jbanks2/rvi_v2x_board/Hardware/Make Files/V1.2 Ordered/Build Learnings.txt

f-4.7uf 25 are 2012 not 0805 as on board
f-PDI header is SMT not TH
f-USB/SER header is SMT not TH
f-25v 100uf in 12B filter is al elct not Tant as built
f-wrong led resistor values.
f-r65 replaced by diode-D4
f-R70, R73 replaced by 24k
f-R71 replaced by 10k
f-SW2 mouser part wrong
f-board to board connector needs updating, replace with FPC/FFC
f-NVM_RST needs a pullup res-R8
f-R37 in canbus power needs a smaller R value-circuit updated,r37 removed
f-ALL 2n7002 transistors are footprinted upsidedown
