jbanks2/rvi_v2x_board/Hardware/Research/XRP6124 Calculator.xlsx

xrp6124 Calculator
 | 5V nom |  | high |  | low
Vin | 12 | V | 14.5 | V | 9 | V
Vout | 5 | V | 5 | V | 5 | V
D | 0.4166666667 | % | 0.3448275862 | % | 0.5555555556 | %
Iout | 1.25 | A | 1.25 | A | 1.25 | A
ΔIL | 0.375 | A | 0.375 | A | 0.375 | A
Vfb | 0.8 | V | 0.8 | V | 0.8 | V
Ton | 5e-07 | S | 5e-07 | S | 5e-07 | S
fs | 833333.3333 | Hz | 689655.1724 | Hz | 1111111.111 | Hz
Vout Ripple | 0.00783 | V | 0.006971447368 | V | 0.010276875 | V
Icin | 0.6162583107 | A | 0.5941400324 | A | 0.6211299937 | A
Cin | 3.038194444e-06 | F | 2.824019025e-06 | F | 3.086419753e-06 | F | 3.086419753e-06 | F | 3.3uF
R2 | 2000 | Ω | 2000 | Ω | 2000 | Ω | 2000 | Ω | 2kΩ
R1 | 10500 | Ω | 10500 | Ω | 10500 | Ω | 10500 | Ω | 10.5kΩ
CFF | 1.818913635e-10 | F | 2.197853976e-10 | F | 1.364185227e-10 | F | 2.197853976e-10 | F | 220pf
L | 9.333333333e-06 | H | 1.266666667e-05 | H | 5.333333333e-06 | H | 5.333333333e-06 | H | 5.4uH
Cout | 7.183908046e-06 | F | 9.749589491e-06 | F | 4.105090312e-06 | F | 9.749589491e-06 | F | 10uF
 | 4.1V nom |  | high |  | low
Vin | 12 | V | 14.5 | V | 9 | V
Vout | 4.1 | V | 4.1 | V | 4.1 | V
D | 0.3416666667 | % | 0.3416666667 | % | 0.3416666667 | %
Iout | 1.5 | A | 1.5 | A | 1.5 | A
ΔIL | 0.45 | A | 0.45 | A | 0.45 | A
Vfb | 0.8 | V | 0.8 | V | 0.8 | V
Ton | 5e-07 | S | 5e-07 | S | 5e-07 | S
fs | 683333.3333 | Hz | 565517.2414 | Hz | 911111.1111 | Hz
Vout Ripple | 0.005689139241 | V | 0.005221882212 | V | 0.006879214286 | V
Icin | 0.7114026638 | A | 0.7114026638 | A | 0.7114026638 | A
Cin | 4.114583333e-06 | F | 3.709869203e-06 | F | 4.537037037e-06 | F | 4.537037037e-06 | F | 4.7uF
R2 | 2000 | Ω | 2000 | Ω | 2000 | Ω | 2000 | Ω | 2kΩ
R1 | 8250 | Ω | 8250 | Ω | 8250 | Ω | 8250 | Ω | 8.25kΩ
CFF | 2.823147549e-10 | F | 3.411303289e-10 | F | 2.117360662e-10 | F | 3.411303289e-10 | F | 330pF
L | 8.777777778e-06 | H | 1.155555556e-05 | H | 5.444444444e-06 | H | 5.444444444e-06 | H | 5.4uH
Cout | 1.446916127e-05 | F | 1.904800978e-05 | F | 8.974543068e-06 | F | 1.904800978e-05 | F | 2x10uF
 | 3.3V nom |  | high |  | low
Vin | 12 | V | 14.5 | V | 9 | V
Vout | 3.3 | V | 3.3 | V | 3.3 | V
D | 0.275 | % | 0.275 | % | 0.275 | %
Iout | 1 | A | 1 | A | 1 | A
ΔIL | 0.3 | A | 0.3 | A | 0.3 | A
Vfb | 0.8 | V | 0.8 | V | 0.8 | V
Ton | 5e-07 | S | 5e-07 | S | 5e-07 | S
fs | 550000 | Hz | 455172.4138 | Hz | 733333.3333 | Hz
Vout Ripple | 0.004158 | V | 0.003902765625 | V | 0.004759815789 | V
Icin | 0.4465142775 | A | 0.4465142775 | A | 0.4465142775 | A
Cin | 3.020833333e-06 | F | 2.663495838e-06 | F | 3.518518519e-06 | F | 3.518518519e-06 | F | 2uF
R2 | 2000 | Ω | 2000 | Ω | 2000 | Ω | 2000 | Ω | 2kΩ
R1 | 6250 | Ω | 6250 | Ω | 6250 | Ω | 6250 | Ω | 6.25kΩ
CFF | 4.629961981e-10 | F | 5.594537394e-10 | F | 3.472471486e-10 | F | 5.594537394e-10 | F | 560pf
L | 1.45e-05 | H | 1.866666667e-05 | H | 9.5e-06 | H | 9.5e-06 | H | 19uH
Cout | 1.639774367e-05 | F | 2.110973898e-05 | F | 1.07433493e-05 | F | 2.110973898e-05 | F | 10uF
