jbanks2/rvi_v2x_board/Hardware/Research/Cable, J1962M to DB9F, Type D, 6ft - J1962M to ... - Cables - OBD2Cables.com_files/143301_pinout.gif

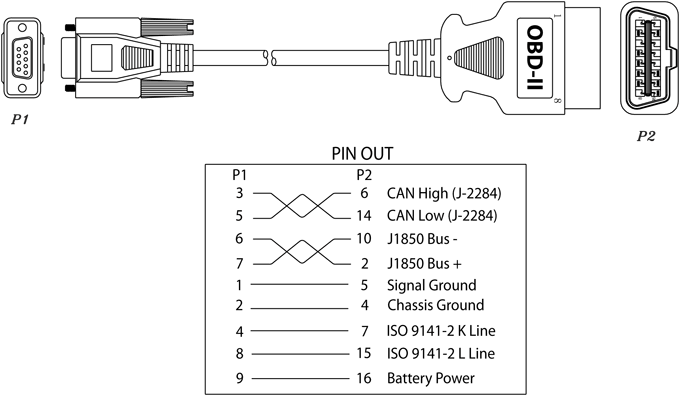
Hardware/Research/Cable, J1962M to DB9F, Type D, 6ft - J1962M to ... - Cables - OBD2Cables.com_files/143301_pinout.gif
