jbanks2/rvi_v2x_board/Hardware/Research/ModemCrossdb9.gif

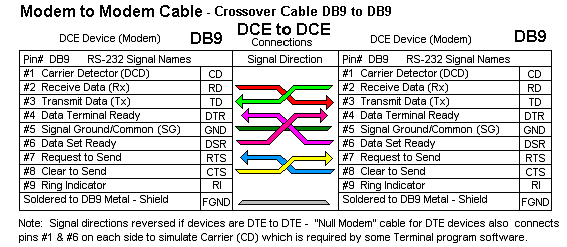
Hardware/Research/ModemCrossdb9.gif
