jbanks2/rvi_v2x_board/Hardware/Project Shares/V1/V1 BOM.xlsx

Name | Value | Description | Mouser PN | Alt PN | Source | C48 | 0
R1 | 0 | 0 ohm resistor | CRCW06030000Z0EA |  | CRCW06030000Z0EA (https://www2.mouser.com/Search/ProductDetail.aspx) | C50 | 0
C48 | 0 | 0 ohm resistor | CRCW06030000Z0EA |  | CRCW06030000Z0EA (https://www2.mouser.com/Search/ProductDetail.aspx) | R1 | 0
C50 | 0 | 0 ohm resistor | CRCW06030000Z0EA |  | CRCW06030000Z0EA (https://www2.mouser.com/Search/ProductDetail.aspx) | C42 | 0.1F
C42 | 0.1F | 0.1F Supercap | FG0H104ZF |  | FG0H104ZF (https://www2.mouser.com/Search/ProductDetail.aspx) | R45 | 100
R45 | 100 | 100 ohm | CRCW0603100RFKEA |  | CRCW0603100RFKEA (https://www2.mouser.com/Search/ProductDetail.aspx) | R46 | 100
R46 | 100 | 100 ohm | CRCW0603100RFKEA |  | CRCW0603100RFKEA (https://www2.mouser.com/Search/ProductDetail.aspx) | R29 | 100K
R29 | 100K | 100k 0603 | 667-ERJ-3EKF1003V |  | ERJ-3EKF1003V (https://www2.mouser.com/Search/ProductDetail.aspx) | C28 | 100N
C1 | 100n | 100N x7r 0603 | VJ0603Y104KXXCW1BC | 1 | VJ0603Y104KXXCW1BC (http://www2.mouser.com/ProductDetail/Vishay-Vitramon/VJ0603Y104KXXCW1BC/) | C32 | 100N
C17 | 100N | 100N x7r 0603 | VJ0603Y104KXXCW1BC | 2 | VJ0603Y104KXXCW1BC (http://www2.mouser.com/ProductDetail/Vishay-Vitramon/VJ0603Y104KXXCW1BC/) | C30 | 100N
C19 | 100N | 100N x7r 0603 | VJ0603Y104KXXCW1BC | 3 | VJ0603Y104KXXCW1BC | C36 | 100N
C20 | 100N | 100N x7r 0603 | VJ0603Y104KXXCW1BC | 4 | VJ0603Y104KXXCW1BC | C33 | 100N
C21 | 100N | 100N x7r 0603 | VJ0603Y104KXXCW1BC | 5 | VJ0603Y104KXXCW1BC | C37 | 100N
C24 | 100N | 100N x7r 0603 | VJ0603Y104KXXCW1BC | 6 | VJ0603Y104KXXCW1BC | C34 | 100N
C28 | 100n | 100N x7r 0603 | VJ0603Y104KXXCW1BC | 7 | VJ0603Y104KXXCW1BC | C38 | 100N
C30 | 100n | 100N x7r 0603 | VJ0603Y104KXXCW1BC | 8 | VJ0603Y104KXXCW1BC | C39 | 100N
C32 | 100n | 100N x7r 0603 | VJ0603Y104KXXCW1BC | 9 | VJ0603Y104KXXCW1BC | C35 | 100N
C33 | 100n | 100N x7r 0603 | VJ0603Y104KXXCW1BC | 10 | VJ0603Y104KXXCW1BC | C40 | 100N
C34 | 100n | 100N x7r 0603 | VJ0603Y104KXXCW1BC | 11 | VJ0603Y104KXXCW1BC | C51 | 100N
C35 | 100n | 100N x7r 0603 | VJ0603Y104KXXCW1BC | 12 | VJ0603Y104KXXCW1BC | C19 | 100N
C36 | 100n | 100N x7r 0603 | VJ0603Y104KXXCW1BC | 13 | VJ0603Y104KXXCW1BC | C21 | 100N
C37 | 100n | 100N x7r 0603 | VJ0603Y104KXXCW1BC | 14 | VJ0603Y104KXXCW1BC | C24 | 100N
C38 | 100n | 100N x7r 0603 | VJ0603Y104KXXCW1BC | 15 | VJ0603Y104KXXCW1BC | C20 | 100N
C39 | 100n | 100N x7r 0603 | VJ0603Y104KXXCW1BC | 16 | VJ0603Y104KXXCW1BC | C17 | 100N
C40 | 100n | 100N x7r 0603 | VJ0603Y104KXXCW1BC | 17 | VJ0603Y104KXXCW1BC | C1 | 100N
C51 | 100N | 100N x7r 0603 | VJ0603Y104KXXCW1BC | 18 | VJ0603Y104KXXCW1BC | C4 | 100U
C4 | 100U | 25V tantilum | 80-T491X107K025AT |  | 80-T491X107K025AT (https://www2.mouser.com/Search/ProductDetail.aspx) | R60 | 10K
R12 | 10k | 10k 0603 | CRCW060310K0FKEA | 1 | CRCW060310K0FKEA (https://www2.mouser.com/Search/ProductDetail.aspx) | R61 | 10K
R13 | 10K | 10k 0603 | CRCW060310K0FKEA | 2 | CRCW060310K0FKEA (https://www2.mouser.com/Search/ProductDetail.aspx) | R59 | 10K
R14 | 10K | 10k 0603 | CRCW060310K0FKEA | 3 | CRCW060310K0FKEA (https://www2.mouser.com/Search/ProductDetail.aspx) | R57 | 10K
R15 | 10K | 10k 0603 | CRCW060310K0FKEA | 4 | CRCW060310K0FKEA (https://www2.mouser.com/Search/ProductDetail.aspx) | R70 | 10K
R16 | 10K | 10k 0603 | CRCW060310K0FKEA | 5 | CRCW060310K0FKEA (https://www2.mouser.com/Search/ProductDetail.aspx) | R71 | 10K
R19 | 10K | 10k 0603 | CRCW060310K0FKEA | 6 | CRCW060310K0FKEA (https://www2.mouser.com/Search/ProductDetail.aspx) | R16 | 10K
R21 | 10K | 10k 0603 | CRCW060310K0FKEA | 7 | CRCW060310K0FKEA (https://www2.mouser.com/Search/ProductDetail.aspx) | R43 | 10K
R23 | 10K | 10k 0603 | CRCW060310K0FKEA | 8 | CRCW060310K0FKEA (https://www2.mouser.com/Search/ProductDetail.aspx) | R49 | 10K
R25 | 10K | 10k 0603 | CRCW060310K0FKEA | 9 | CRCW060310K0FKEA (https://www2.mouser.com/Search/ProductDetail.aspx) | R50 | 10K
R27 | 10K | 10k 0603 | CRCW060310K0FKEA | 10 | CRCW060310K0FKEA (https://www2.mouser.com/Search/ProductDetail.aspx) | R44 | 10K
R30 | 10K | 10k 0603 | CRCW060310K0FKEA | 11 | CRCW060310K0FKEA (https://www2.mouser.com/Search/ProductDetail.aspx) | R14 | 10K
R31 | 10K | 10k 0603 | CRCW060310K0FKEA | 12 | CRCW060310K0FKEA (https://www2.mouser.com/Search/ProductDetail.aspx) | R15 | 10K
R32 | 10K | 10k 0603 | CRCW060310K0FKEA | 13 | CRCW060310K0FKEA (https://www2.mouser.com/Search/ProductDetail.aspx) | R13 | 10K
R33 | 10K | 10k 0603 | CRCW060310K0FKEA | 14 | CRCW060310K0FKEA (https://www2.mouser.com/Search/ProductDetail.aspx) | R25 | 10K
R34 | 10K | 10k 0603 | CRCW060310K0FKEA | 15 | CRCW060310K0FKEA (https://www2.mouser.com/Search/ProductDetail.aspx) | R21 | 10K
R40 | 10K | 10k 0603 | CRCW060310K0FKEA | 16 | CRCW060310K0FKEA (https://www2.mouser.com/Search/ProductDetail.aspx) | R34 | 10K
R43 | 10K | 10k 0603 | CRCW060310K0FKEA | 17 | CRCW060310K0FKEA (https://www2.mouser.com/Search/ProductDetail.aspx) | R23 | 10K
R44 | 10k | 10k 0603 | CRCW060310K0FKEA | 18 | CRCW060310K0FKEA (https://www2.mouser.com/Search/ProductDetail.aspx) | R27 | 10K
R49 | 10K | 10k 0603 | CRCW060310K0FKEA | 19 | CRCW060310K0FKEA (https://www2.mouser.com/Search/ProductDetail.aspx) | R33 | 10K
R50 | 10K | 10k 0603 | CRCW060310K0FKEA | 20 | CRCW060310K0FKEA (https://www2.mouser.com/Search/ProductDetail.aspx) | R32 | 10K
R57 | 10K | 10k 0603 | CRCW060310K0FKEA | 21 | CRCW060310K0FKEA (https://www2.mouser.com/Search/ProductDetail.aspx) | R31 | 10K
R59 | 10k | 10k 0603 | CRCW060310K0FKEA | 22 | CRCW060310K0FKEA (https://www2.mouser.com/Search/ProductDetail.aspx) | R40 | 10K
R60 | 10K | 10k 0603 | CRCW060310K0FKEA | 23 | CRCW060310K0FKEA (https://www2.mouser.com/Search/ProductDetail.aspx) | R30 | 10K
R61 | 10K | 10k 0603 | CRCW060310K0FKEA | 24 | CRCW060310K0FKEA (https://www2.mouser.com/Search/ProductDetail.aspx) | R12 | 10K
R70 | 10K | 10k 0603 | CRCW060310K0FKEA | 25 | CRCW060310K0FKEA (https://www2.mouser.com/Search/ProductDetail.aspx) | R19 | 10K
R71 | 10K | 10k 0603 | CRCW060310K0FKEA | 26 | CRCW060310K0FKEA (https://www2.mouser.com/Search/ProductDetail.aspx) | C44 | 10N
C3 | 10N | 10n 0603 | VJ0603Y103KXACW1BC |  | VJ0603Y103KXACW1BC (https://www2.mouser.com/Search/ProductDetail.aspx) | C12 | 10N
C44 | 10n | 10n 0603 | VJ0603Y103KXACW1BC |  | VJ0603Y103KXACW1BC (https://www2.mouser.com/Search/ProductDetail.aspx) | C3 | 10N
C12 | 10n | 10n 0603 | VJ0603Y103KXACW1BC |  | VJ0603Y103KXACW1BC (https://www2.mouser.com/Search/ProductDetail.aspx)
R54 | 12K | 12k 0603 | CRCW060312K0FKEA |  | CRCW060312K0FKEA (https://www2.mouser.com/Search/ProductDetail.aspx) | R54 | 12K
X1 | 12M | 12MHz Xtal | ABLS7M2-12.000MHZ-D-2Y-T |  | ABLS7M2-12.000MHZ-D-2Y-T (https://www2.mouser.com/Search/ProductDetail.aspx) | X1 | 12M
X2 | 12M | 12MHz Xtal | ABLS7M2-12.000MHZ-D-2Y-T |  | ABLS7M2-12.000MHZ-D-2Y-T (https://www2.mouser.com/Search/ProductDetail.aspx) | X2 | 12M
C41 | 18p | 18pF 0603 | VJ0603A180JXACW1BC |  | VJ0603A180JXACW1BC (https://www2.mouser.com/Search/ProductDetail.aspx) | C54 | 18P
C53 | 18p | 18pF 0603 | VJ0603A180JXACW1BC |  | VJ0603A180JXACW1BC (https://www2.mouser.com/Search/ProductDetail.aspx) | C55 | 18P
C54 | 18p | 18pF 0603 | VJ0603A180JXACW1BC |  | VJ0603A180JXACW1BC | C41 | 18P
C55 | 18p | 18pF 0603 | VJ0603A180JXACW1BC |  | VJ0603A180JXACW1BC | C53 | 18P
F2 | 1A | 750mA Poly Fuse | 0ZCH0075FF2G |  | 0ZCH0075FF2G (https://www2.mouser.com/Search/ProductDetail.aspx) | F2 | 1A
R28 | 1K | 1K 0603 | CRCW06031K00FKEA | 1 | CRCW06031K00FKEA (https://www2.mouser.com/Search/ProductDetail.aspx) | R56 | 1K
R39 | 1k | 1K 0603 | CRCW06031K00FKEA | 2 | CRCW06031K00FKEA (https://www2.mouser.com/Search/ProductDetail.aspx) | R28 | 1K
R41 | 1k | 1K 0603 | CRCW06031K00FKEA | 3 | CRCW06031K00FKEA (https://www2.mouser.com/Search/ProductDetail.aspx) | R41 | 1K
R51 | 1K | 1K 0603 | CRCW06031K00FKEA | 4 | CRCW06031K00FKEA (https://www2.mouser.com/Search/ProductDetail.aspx) | R51 | 1K
R56 | 1K | 1K 0603 | CRCW06031K00FKEA | 5 | CRCW06031K00FKEA (https://www2.mouser.com/Search/ProductDetail.aspx) | R39 | 1K
R6 | 1K | 1K 0603 | CRCW06031K00FKEA | 6 | CRCW06031K00FKEA (https://www2.mouser.com/Search/ProductDetail.aspx) | R6 | 1K
R5 | 1k7 | 1.69K 0603 | CRCW06031K69FKEA |  | CRCW06031K69FKEA (https://www2.mouser.com/Search/ProductDetail.aspx) | R5 | 1K7
C15 | 1u | 1uf 0603 x5r | GRM188R61E105KA12D | 1 | GRM188R61E105KA12D (https://www2.mouser.com/Search/ProductDetail.aspx) | C23 | 1U
C16 | 1u | 1uf 0603 x5r | GRM188R61E105KA12D | 2 | GRM188R61E105KA12D (https://www2.mouser.com/Search/ProductDetail.aspx) | C22 | 1U
C22 | 1u | 1uf 0603 x5r | GRM188R61E105KA12D | 3 | GRM188R61E105KA12D (https://www2.mouser.com/Search/ProductDetail.aspx) | C25 | 1U
C23 | 1u | 1uf 0603 x5r | GRM188R61E105KA12D | 4 | GRM188R61E105KA12D (https://www2.mouser.com/Search/ProductDetail.aspx) | C9 | 1U
C25 | 1U | 1uf 0603 x5r | GRM188R61E105KA12D | 5 | GRM188R61E105KA12D (https://www2.mouser.com/Search/ProductDetail.aspx) | C15 | 1U
C6 | 1U | 1uf 0603 x5r | GRM188R61E105KA12D | 6 | GRM188R61E105KA12D (https://www2.mouser.com/Search/ProductDetail.aspx) | C6 | 1U
C8 | 1U | 1uf 0603 x5r | GRM188R61E105KA12D | 7 | GRM188R61E105KA12D (https://www2.mouser.com/Search/ProductDetail.aspx) | C8 | 1U
C9 | 1U | 1uf 0603 x5r | GRM188R61E105KA12D | 8 | GRM188R61E105KA12D (https://www2.mouser.com/Search/ProductDetail.aspx) | R69 | 2.2K
R63 | 22 | 22.1 ohm, 0603 | 71-CRCW0603-22.1-E3 |  | 71-CRCW0603-22.1-E3 (http://www2.mouser.com/ProductDetail/Vishay-Dale/CRCW060322R1FKEA/) | R64 | 22
R64 | 22 | 22.1 ohm, 0603 | 71-CRCW0603-22.1-E3 |  | 71-CRCW0603-22.1-E3 (http://www2.mouser.com/ProductDetail/Vishay-Dale/CRCW060322R1FKEA/) | R65 | 22
R65 | 22 | 22.1 ohm, 0603 | 71-CRCW0603-22.1-E3 |  | 71-CRCW0603-22.1-E3 (http://www2.mouser.com/ProductDetail/Vishay-Dale/CRCW060322R1FKEA/) | FB5 | 220
FB1 | 220 | FB 220 ohm, 0805 | 81-BLM21P221SG | 1 | 81-BLM21P221SG (https://www2.mouser.com/Search/ProductDetail.aspx) | FB6 | 220
FB2 | 220 | FB 220 ohm, 0805 | 81-BLM21P221SG | 2 | 81-BLM21P221SG (https://www2.mouser.com/Search/ProductDetail.aspx) | FB4 | 220
FB3 | 220 | FB 220 ohm, 0805 | 81-BLM21P221SG | 3 | 81-BLM21P221SG (https://www2.mouser.com/Search/ProductDetail.aspx) | FB2 | 220
FB4 | 220 | FB 220 ohm, 0804 | 81-BLM21P221SG | 4 | 81-BLM21P221SG (https://www2.mouser.com/Search/ProductDetail.aspx) | FB3 | 220
FB5 | 220 | FB 220 ohm, 0805 | 81-BLM21P221SG | 5 | 81-BLM21P221SG (https://www2.mouser.com/Search/ProductDetail.aspx) | R4 | 220
FB6 | 220 | FB 220 ohm, 0805 | 81-BLM21P221SG | 6 | 81-BLM21P221SG (https://www2.mouser.com/Search/ProductDetail.aspx) | FB1 | 220
R4 | 220 | 220 0603 | CRCW0603220RFKEA |  | CRCW0603220RFKEA (https://www2.mouser.com/Search/ProductDetail.aspx) | C5 | 220U
C5 | 220u | 16V SMT Elect | 647-UCD1C221MCL1GS |  | 647-UCD1C221MCL1GS (https://www2.mouser.com/Search/ProductDetail.aspx) | C11 | 220U
C11 | 220u | 16V SMT Elect | 647-UCD1C221MCL1GS |  | 647-UCD1C221MCL1GS (https://www2.mouser.com/Search/ProductDetail.aspx) | C10 | 220U
C10 | 220u | 16V SMT Elect | 647-UCD1C221MCL1GS |  | 647-UCD1C221MCL1GS (https://www2.mouser.com/Search/ProductDetail.aspx) | C14 | 220U
C14 | 220u | 16V SMT Elect | 647-UCD1C221MCL1GS |  | 647-UCD1C221MCL1GS (https://www2.mouser.com/Search/ProductDetail.aspx) | R62 | 22K
R62 | 22K | 22k 0603 | CRCW060322K0FKEA |  | CRCW060322K0FKEA (https://www2.mouser.com/Search/ProductDetail.aspx) | R18 | 240
R18 | 240 | 240 0603 | CRCW0603240RFKEB |  | CRCW0603240RFKEB (https://www2.mouser.com/Search/ProductDetail.aspx) | F1 | 2A
F1 | 2A | 2A poly fuse | 0ZCG0260FF2C |  | 0ZCG0260FF2C (https://www2.mouser.com/Search/ProductDetail.aspx) | R20 | 2K
R20 | 2K | 2k 0603 | CRCW06032K00FKEA |  | CRCW06032K00FKEA (https://www2.mouser.com/Search/ProductDetail.aspx) | R68 | 2K2
R69 | 2K2 | 2.2k 0603 | CRCW06032K20FKEA | 1 | CRCW06032K20FKEA (https://www2.mouser.com/Search/ProductDetail.aspx)
R26 | 2K2 | 2.2k 0603 | CRCW06032K20FKEA | 2 | CRCW06032K20FKEA (https://www2.mouser.com/Search/ProductDetail.aspx) | R26 | 2K2
R35 | 2K2 | 2.2k 0603 | CRCW06032K20FKEA | 3 | CRCW06032K20FKEA (https://www2.mouser.com/Search/ProductDetail.aspx) | R37 | 2K2
R36 | 2K2 | 2.2k 0603 | CRCW06032K20FKEA | 4 | CRCW06032K20FKEA (https://www2.mouser.com/Search/ProductDetail.aspx) | R36 | 2K2
R37 | 2K2 | 2.2k 0603 | CRCW06032K20FKEA | 5 | CRCW06032K20FKEA (https://www2.mouser.com/Search/ProductDetail.aspx) | R35 | 2K2
R68 | 2K2 | 2.2k 0603 | CRCW06032K20FKEA | 6 | CRCW06032K20FKEA (https://www2.mouser.com/Search/ProductDetail.aspx) | Q12 | 2N3904
Q10 | 2N3904 | NPN | MMBT3904 | 1 | 512-MMBT3904 (https://www2.mouser.com/Search/ProductDetail.aspx?R=MMBT3904virtualkey51210000virtualkey512-MMBT3904) | Q13 | 2N3904
Q11 | 2N3904 | NPN | MMBT3904 | 2 | 512-MMBT3904 (https://www2.mouser.com/Search/ProductDetail.aspx?R=MMBT3904virtualkey51210000virtualkey512-MMBT3904) | Q10 | 2N3904
Q12 | 2N3904 | NPN | MMBT3904 | 3 | 512-MMBT3904 | Q11 | 2N3904
Q13 | 2N3904 | NPN | MMBT3904 | 4 | 512-MMBT3904 | Q8 | 2N3904
Q4 | 2N3904 | NPN | MMBT3904 | 5 | 512-MMBT3904 | Q4 | 2N3904
Q8 | 2N3904 | NPN | MMBT3904 | 6 | 512-MMBT3904 | C13 | 2N7
C13 | 2n7 | 2.7N 0603 | 06033C272JAT2A |  | 06033C272JAT2A (https://www2.mouser.com/Search/ProductDetail.aspx) | Q2 | 2N7002
Q2 | 2N7002 | N-MOS | 2N7002 |  | 2N7002ET1G (https://www2.mouser.com/Search/ProductDetail.aspx) | Q9 | 2N7002
Q9 | 2N7002 | N-MOS | 2N7002 |  | 2N7002ET1G (https://www2.mouser.com/Search/ProductDetail.aspx) | R66 | 330
C49 | 47p | 47p 0603 | VJ0603A470JXXPW1BC |  | VJ0603A470JXXPW1BC (https://www2.mouser.com/Search/ProductDetail.aspx) | R67 | 330
C47 | 47P | 47p 0603 | VJ0603A470JXXPW1BC |  | VJ0603A470JXXPW1BC (https://www2.mouser.com/Search/ProductDetail.aspx)
R10 | 330 | 330 0603 | CRCW0603330RFKEA | 1 | CRCW0603330RFKEA (https://www2.mouser.com/Search/ProductDetail.aspx) | R10 | 330
R11 | 330 | 330 0603 | CRCW0603330RFKEA | 2 | CRCW0603330RFKEA (https://www2.mouser.com/Search/ProductDetail.aspx) | R8 | 330
R66 | 330 | 330 0603 | CRCW0603330RFKEA | 3 | CRCW0603330RFKEA (https://www2.mouser.com/Search/ProductDetail.aspx) | R11 | 330
R67 | 330 | 330 0603 | CRCW0603330RFKEA | 4 | CRCW0603330RFKEA (https://www2.mouser.com/Search/ProductDetail.aspx) | R9 | 330
R8 | 330 | 330 0603 | CRCW0603330RFKEA | 5 | CRCW0603330RFKEA (https://www2.mouser.com/Search/ProductDetail.aspx) | C52 | 330P
R9 | 330 | 330 0603 | CRCW0603330RFKEA | 6 | CRCW0603330RFKEA (https://www2.mouser.com/Search/ProductDetail.aspx) | C43 | 330P
C52 | 330P | 330p 0603 | VJ0603A331FXXCW1BC |  | VJ0603A331FXXCW1BC (https://www2.mouser.com/Search/ProductDetail.aspx) | C7 | 33U
C43 | 330P | 330p 0603 | VJ0603A331FXXCW1BC |  | VJ0603A331FXXCW1BC (https://www2.mouser.com/Search/ProductDetail.aspx) | R22 | 374
C7 | 33u | 33uF MLCC 6.3v | 810-C3225X5R0J336M11 |  | 810-C3225X5R0J336M11 (https://www2.mouser.com/Search/ProductDetail.aspx) | Q3 | 3906
R22 | 374 | 374 0603 | CRCW0603374RFKEA |  | CRCW0603374RFKEA (https://www2.mouser.com/Search/ProductDetail.aspx) | D8 | 4148
D8 | 4148 | 2N4148 | TS4148RY | 1 | TS4148RY (https://www2.mouser.com/Search/ProductDetail.aspx) | D9 | 4148
D7 | 4148 | 2N4148 | TS4148RY | 2 | TS4148RY (https://www2.mouser.com/Search/ProductDetail.aspx) | D13 | 4148
D9 | 4148 | 2N4148 | TS4148RY | 3 | TS4148RY (https://www2.mouser.com/Search/ProductDetail.aspx) | D12 | 4148
D13 | 4148 | 2N4148 | TS4148RY | 4 | TS4148RY (https://www2.mouser.com/Search/ProductDetail.aspx) | P8 | 47553-1001
D12 | 4148 | 2N4148 | TS4148RY | 5 | TS4148RY (https://www2.mouser.com/Search/ProductDetail.aspx) | L3 | 47N
L3 | 47N | 47n 0603 | VJ0603Y473JXXCW1BC |  | VJ0603Y473JXXCW1BC (https://www2.mouser.com/Search/ProductDetail.aspx) | R55 | 4K7
L1 | 47N | 47n 0603 | VJ0603Y473JXXCW1BC |  | VJ0603Y473JXXCW1BC (https://www2.mouser.com/Search/ProductDetail.aspx) | R72 | 4K7
R47 | 4K7 | 4.7k 0603 | CRCW06034K70FKEA | 1 | CRCW06034K70FKEA (https://www2.mouser.com/Search/ProductDetail.aspx) | R47 | 4K7
R55 | 4K7 | 4.7k 0604 | CRCW06034K70FKEA | 2 | CRCW06034K70FKEA (https://www2.mouser.com/Search/ProductDetail.aspx) | C29 | 4U7
R72 | 4K7 | 4.7k 0605 | CRCW06034K70FKEA | 3 | CRCW06034K70FKEA (https://www2.mouser.com/Search/ProductDetail.aspx) | C31 | 4U7
C2 | 4U7 | 4.7uf 0805 | 08053D475KAT2A | 1 | 08053D475KAT2A (http://www2.mouser.com/ProductDetail/AVX/08053D475KAT2A/?qs=sGAEpiMZZMs0AnBnWHyRQPVeiAejnQnjfhIZ0wFCHlY%3d) | C18 | 4U7
C18 | 4U7 | 4.7uf 0805 | 08053D475KAT2A | 2 | 08053D475KAT2A (http://www2.mouser.com/ProductDetail/AVX/08053D475KAT2A/?qs=sGAEpiMZZMs0AnBnWHyRQPVeiAejnQnjfhIZ0wFCHlY%3d) | C56 | 4U7
C29 | 4u7 | 4.7uf 0805 | 08053D475KAT2A | 3 | 08053D475KAT2A (http://www2.mouser.com/ProductDetail/AVX/08053D475KAT2A/?qs=sGAEpiMZZMs0AnBnWHyRQPVeiAejnQnjfhIZ0wFCHlY%3d) | C2 | 4U7
C31 | 4u7 | 4.7uf 0805 | 08053D475KAT2A | 4 | 08053D475KAT2A (http://www2.mouser.com/ProductDetail/AVX/08053D475KAT2A/?qs=sGAEpiMZZMs0AnBnWHyRQPVeiAejnQnjfhIZ0wFCHlY%3d) | C47 | 50P
 |  |  |  |  |  | C49 | 50P
R42 | 510 | 510ohm 1210 | 603-RC1210FR-07510RL |  | 603-RC1210FR-07510RL (https://www2.mouser.com/Search/ProductDetail.aspx) | R48 | 510
R48 | 510 | 510ohm 1210 | 603-RC1210FR-07510RL |  | 603-RC1210FR-07510RL (https://www2.mouser.com/Search/ProductDetail.aspx) | C26 | 560P
C26 | 560P | 560p 0603 | VJ0603Y561KXACW1BC |  | VJ0603Y561KXACW1BC (https://www2.mouser.com/Search/ProductDetail.aspx) | C27 | 560P
C27 | 560P | 560p 0603 | VJ0603Y561KXACW1BC |  | VJ0603Y561KXACW1BC (https://www2.mouser.com/Search/ProductDetail.aspx) | R7 | 62K
R7 | 62k | 62k 0603 | CRCW060362K0FKEA |  | CRCW060362K0FKEA (https://www2.mouser.com/Search/ProductDetail.aspx) | R17 | 866
R17 | 866 | 866 0603 | ERJ-3EKF8660V |  | ERJ-3EKF8660V (https://www2.mouser.com/Search/ProductDetail.aspx) | R24 | 8K
R24 | 8K | 8.06k 06036 | ERJ-3EKF8061V |  | ERJ-3EKF8061V (https://www2.mouser.com/Search/ProductDetail.aspx) | U14 | 93C46
U14 | 93C46 | 64x16 EEPROM | 93C46BT |  | 93C46BT/SN (https://www2.mouser.com/Search/ProductDetail.aspx) | U1 | ADXL345
U1 | ADXL345 | 16g Accel | ADXL345BCCZ-RL7 |  | ADXL345BCCZ-RL7 (https://www2.mouser.com/Search/ProductDetail.aspx) | D10 | BLUE
D4 | BLUE | 0805 Bl LED | 150080BS75000 | 1 | 150080BS75000 (https://www2.mouser.com/Search/ProductDetail.aspx) | D4 | BLUE
D6 | BLUE | 0805 Bl LED | 150080BS75000 | 2 | 150080BS75000 (https://www2.mouser.com/Search/ProductDetail.aspx) | D6 | BLUE
D10 | BLUE | 0805 Bl LED | 150080BS75000 | 3 | 150080BS75000 (https://www2.mouser.com/Search/ProductDetail.aspx) | P9 | Board Mount 1
P9 | Board Mount 1 | --- |  |  |  | P11 | Board Mount 2
P11 | Board Mount 2 | --- |  |  |  | P13 | Board Mount 3
P13 | Board Mount 3 | --- |  |  |  | P15 | Board Mount 4
P15 | Board Mount 4 | --- |  |  |  | Q6 | BSS84
Q1 | BSS84 | P-MOS | BSS84 | 1 | BSS84,215 (https://www2.mouser.com/Search/ProductDetail.aspx) | Q1 | BSS84
Q5 | BSS84 | P-MOS | BSS85 | 2 | BSS84,216 (https://www2.mouser.com/Search/ProductDetail.aspx) | JP1 | CAN_EN_SRC
Q6 | BSS84 | P-MOS | BSS86 | 3 | BSS84,217 (https://www2.mouser.com/Search/ProductDetail.aspx) | D1 | DB2441700L
Q7 | BSS84 | P-MOS | BSS87 | 4 | BSS84,218 (https://www2.mouser.com/Search/ProductDetail.aspx) | J1 | DB9
JP1 | CAN_EN_SRC | 3-p jumper header | 778757 |  | 22-28-4032 (https://www2.mouser.com/Search/ProductDetail.aspx) | P20 | DB-9 to OBD2
J1 | DB9 | DB-9-M | D09P33E4GV00LF |  | D09P33E4GV00LF (https://www2.mouser.com/Search/ProductDetail.aspx) | R3 | DNS
R2 | DNS | --- |  |  |  | L5 | dns
R3 | DNS | --- |  |  |  | L6 | dns
R52 | DNS | --- |  |  |  | L7 | dns
R53 | DNS | --- |  |  |  | L8 | dns
L5 | dns | --- |  |  |  | L4 | dns
L6 | dns | --- |  |  |  | C45 | dns
L7 | dns | --- |  |  |  | L2 | dns
L8 | dns | --- |  |  |  | C46 | dns
L4 | dns | --- |  |  |  | R73 | dns
C45 | dns | --- |  |  |  | R2 | DNS
L2 | dns | --- |  |  |  | U5 | ESDAxxSC6
C46 | dns | --- |  |  |  | U6 | ESDAxxSC6
R73 | dns | --- |  |  |  | P12 | Ficudial1
U5 | ESDAxxSC6 | 4-ch ESD Array | 511-ESDA19SC6 |  | 511-ESDA19SC6 (https://www2.mouser.com/Search/ProductDetail.aspx) | P14 | Ficudial2
U6 | ESDAxxSC6 | 4-ch ESD Array | 511-ESDA19SC6 |  | 511-ESDA19SC6 (https://www2.mouser.com/Search/ProductDetail.aspx) | P16 | Ficudial3
P12 | Ficudial1 | PCB alignment Mark |  |  |  | P18 | Ficudial4
P14 | Ficudial2 | PCB alignment Mark |  |  |  | W1 | FME<->SMA
P16 | Ficudial3 | PCB alignment Mark |  |  |  | U12 | FT4232H
P18 | Ficudial4 | PCB alignment Mark |  |  |  | W2 | GPS+GSM Antenna
P8 | 47553-1001 | SIM Slot | 47553-1001 |  | 47553-1001 (https://www2.mouser.com/Search/ProductDetail.aspx) | U9 | LM317
U12 | FT4232H | USB Uart | FT4232HL-REEL |  | FT4232HL-REEL (https://www2.mouser.com/Search/ProductDetail.aspx) | U8 | LM339
U9 | LM317 | Linnear Reg Adj | LM317MSTT3G |  | LM317MSTT3G (https://www2.mouser.com/Search/ProductDetail.aspx) | P4 | NVM_RST
U8 | LM339 | OpenC Comparator | LM339DT |  | LM339DT (https://www2.mouser.com/Search/ProductDetail.aspx?R=LM339DTvirtualkey51120000virtualkey511-LM339DT) | U2 | OKI-78SR-5
U11 | MCP2551 | Canbus TCVR | 579-MCP2551-I/SN |  | 579-MCP2551-I/SN (https://www2.mouser.com/Search/ProductDetail.aspx) | P3 | Open Source
Q3 | 3906 | PNP | MMBT3906-7-F |  | MMBT3906-7-F (https://www2.mouser.com/Search/ProductDetail.aspx) | P2 | PG_TP
P4 | NVM_RST | 2-pin jumper | 22-28-5023 |  | 22-28-5023 (https://www2.mouser.com/Search/ProductDetail.aspx) | U3 | PNVX002
U2 | OKI-78SR-5 | 5V 1.5A | OKI-78SR-5/1.5-W36H-C |  | OKI-78SR-5/1.5-W36H-C (https://www2.mouser.com/Search/ProductDetail.aspx) | SW1 | PWR_SW
P3 | Open Source | --- |  |  |  | D11 | RED
P2 | PG_TP | --- |  |  |  | D3 | RED
U3 | PNVX002 | Adj V @ 2A | PNVX002A0X3-SRZ |  | PNVX002A0X3-SRZ (https://www2.mouser.com/Search/ProductDetail.aspx) | D5 | RED
SW1 | PWR_SW | 10A rocker SW | 1552.4606 |  | 1552.4606 (https://www2.mouser.com/Search/ProductDetail.aspx) | D2 | SD15C
D11 | RED | 0805 RED LED | LS R976-NR-1 |  | LS R976-NR-1 (https://www2.mouser.com/Search/ProductDetail.aspx) | U16 | SIM5320
D3 | RED | 0805 RED LED | LS R976-NR-1 |  | LS R976-NR-1 (https://www2.mouser.com/Search/ProductDetail.aspx) | P6 | SMA
D5 | RED | 0805 RED LED | LS R976-NR-1 |  | LS R976-NR-1 (https://www2.mouser.com/Search/ProductDetail.aspx) | P7 | SMA
D1 | DB2441700L | 40V 5A | DB2441700L |  | DB2441700L (https://www2.mouser.com/Search/ProductDetail.aspx) | U15 | SMF05
U16 | SIM5320 | GSM+GPS | SIM5230E | Not Mouser | Aliexpress (http://www.aliexpress.com/item/SIMCOM-SIM5320-SIM5320A-3G-GSM-HSDPA-WCDM-GSM-GPRS-EDGE-module/987537423.html) | U17 | SMF05
P6 | SMA | SMA-RA | 142-0701-801 |  | 142-0701-801 (https://www2.mouser.com/Search/ProductDetail.aspx) | U7 | STN1110
P7 | SMA | SMA-RA | 142-0701-801 |  | 142-0701-801 (https://www2.mouser.com/Search/ProductDetail.aspx) | SW2 | SW_PUSH_SMALL
U15 | SMF05 | 5ch TVS array | 863-SMF05CT1G |  | 863-SMF05CT1G (https://www2.mouser.com/Search/ProductDetail.aspx) | SW3 | SW_PUSH_SMALL
U17 | SMF05 | 5ch TVS array | 863-SMF05CT1G |  | 863-SMF05CT1G (https://www2.mouser.com/Search/ProductDetail.aspx) | SW4 | SW_PUSH_SMALL
D2 | SD15C | 15V TVS | SD15C-01FTG |  | SD15C-01FTG (https://www2.mouser.com/Search/ProductDetail.aspx) | SW5 | SW_PUSH_SMALL
U7 | STN1110 |  |  | Not Mouser | STN1110 Multiprotocol OBD II to UART Interpreter (https://www.scantool.net/stn1110.html) | U4 | TLV70033DDC
SW2 | SW_PUSH_SMALL | Tact SW Small | 506-FSMSM |  | 506-FSMSM (https://www2.mouser.com/Search/ProductDetail.aspx?R=FSMSMvirtualkey50660000virtualkey506-FSMSM) | P1 | USB_A
SW3 | SW_PUSH_SMALL | Tact SW Small | 506-FSMSM |  | 506-FSMSM (https://www2.mouser.com/Search/ProductDetail.aspx?R=FSMSMvirtualkey50660000virtualkey506-FSMSM) | P5 | USB_u
SW4 | SW_PUSH_SMALL | Tact SW Small | 506-FSMSM |  | 506-FSMSM (https://www2.mouser.com/Search/ProductDetail.aspx?R=FSMSMvirtualkey50660000virtualkey506-FSMSM)
SW5 | SW_PUSH_SMALL | Tact SW Small | 506-FSMSM |  | 506-FSMSM (https://www2.mouser.com/Search/ProductDetail.aspx?R=FSMSMvirtualkey50660000virtualkey506-FSMSM)
U4 | TLV70033DDC | 3.3V LDO | TLV73333PDBVT |  | TLV73333PDBVT (https://www2.mouser.com/Search/ProductDetail.aspx)
P1 | USB_A | USB-A | 6364372-2 |  | 6364372-2 (https://www2.mouser.com/Search/ProductDetail.aspx)
P5 | USB_u | USB-micro B | 649-10118193-0001LF |  | 649-10118193-0001LF (https://www2.mouser.com/Search/ProductDetail.aspx)
W1 | FME<->SMA | RF adapter | 523-192113 |  | 523-192113 (https://www2.mouser.com/Search/ProductDetail.aspx?R=192113virtualkey52310000virtualkey523-192113)
W2 | GSM+GPS | Antennas | APAMPS-105 |  | APAMPS-105 (https://www2.mouser.com/Search/ProductDetail.aspx)
P20 | DB9toOBD2 |  |  | Not Mouser | OBD2 16Pin to DB9 Serial Port Adapter Cable--Connecting Your Diagnostic Interface… (http://www.amazon.com/Adapter-Cable-Connecting-Diagnostic-Interface-Compliant/dp/B007UKTW8E)
