jbanks2/rvi_v2x_board/Hardware/Make Files/Active/Amazon Order.JPG

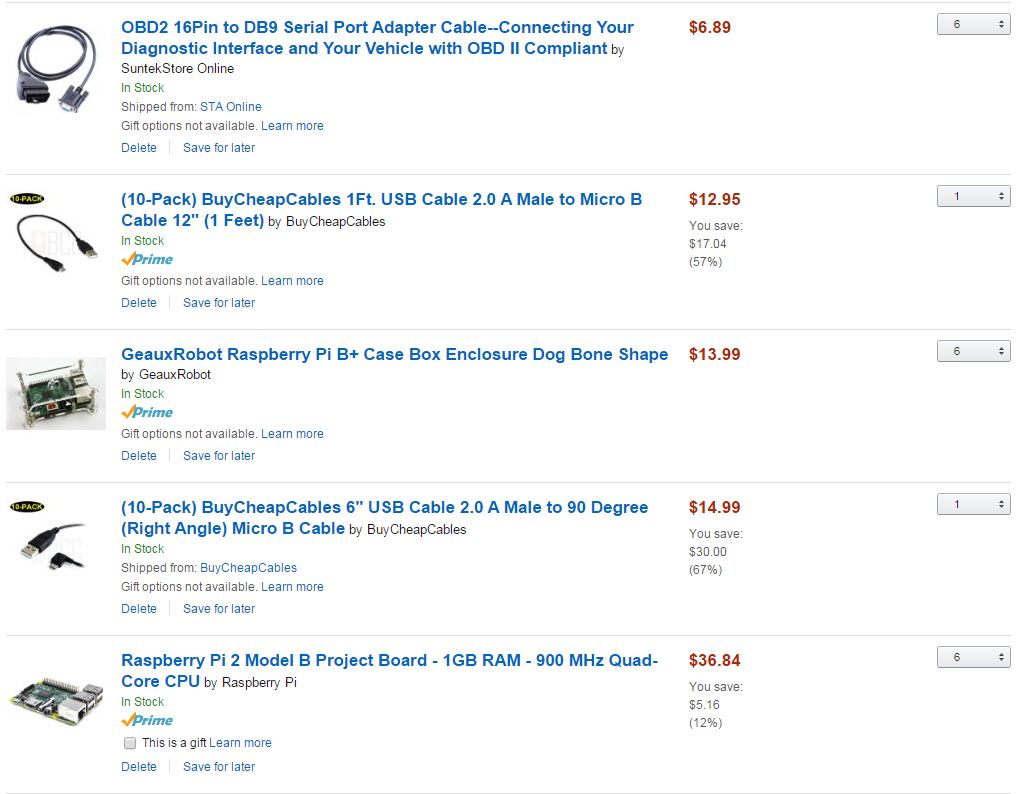
Hardware/Make Files/Active/Amazon Order.JPG
