jbanks2/rvi_v2x_board/Hardware/Make Files/Active/V2X_ISO1.jpg

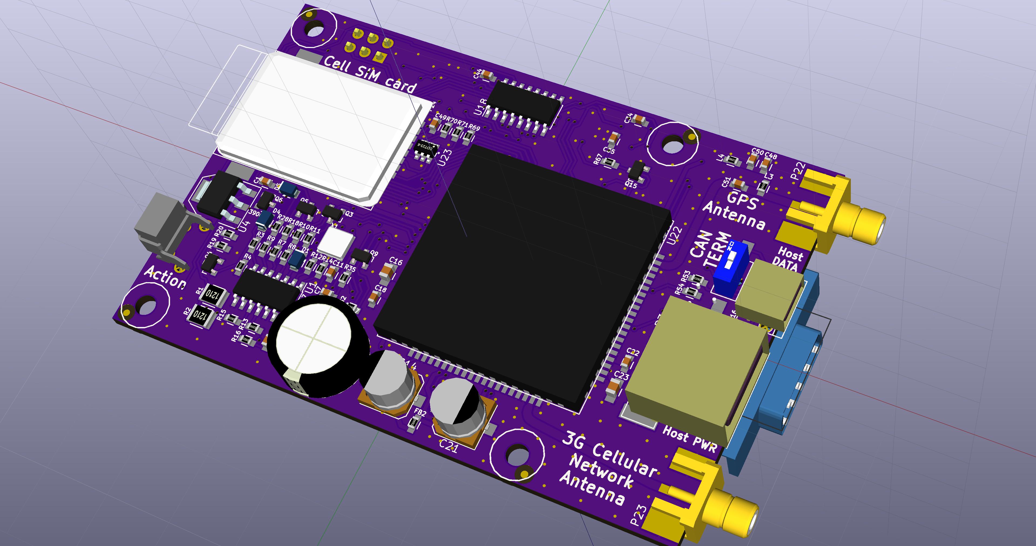
Hardware/Make Files/Active/V2X_ISO1.jpg
