jbanks2/rvi_v2x_board/Hardware/Project Shares/V1.2/V2X V1.2 Archetecture.pdf

## Cloud server

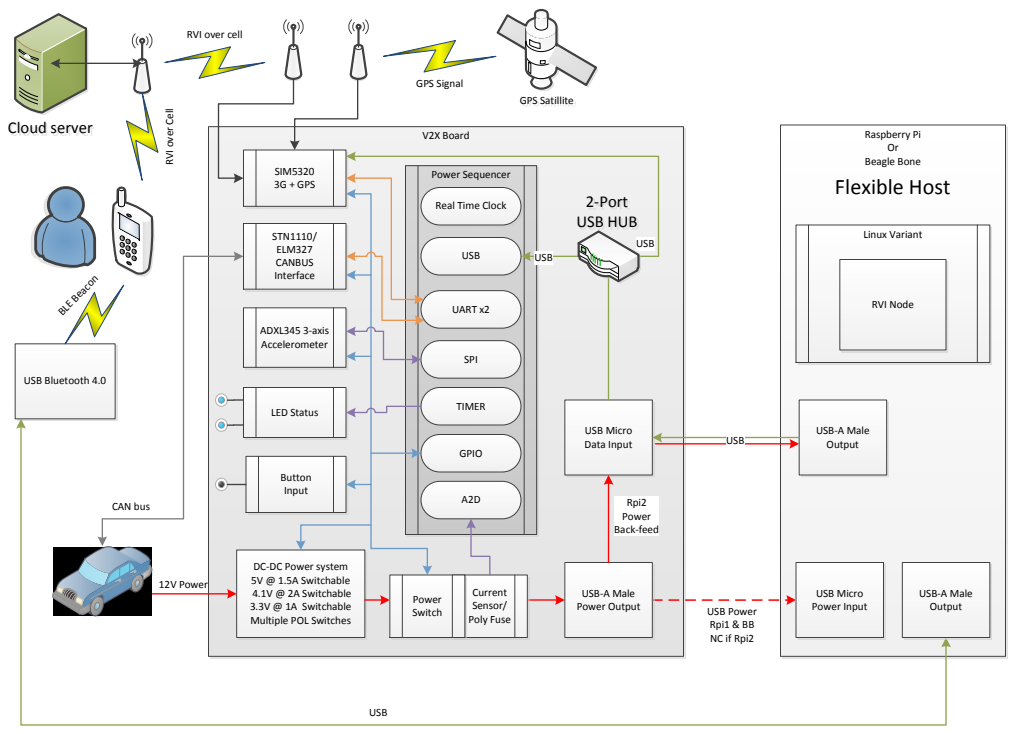
[picture p16: page 1]
V2X Board; Power Sequencer SIM5320 3G + GPS; GPS Signal; GPS Satillite; Raspberry Pi Or Beagle Bone; ADXL345 3-axis Accelerometer; USB Bluetooth 4.0; BLE Beacon; Linux Variant; RVI Node; Flexible Host; USB; 12V Power; CAN bus; USB Power Rpi1 & BB NC if Rpi2; USB Micro Power Input; USB-A Male Output; USB-A Male Power Output; USB Micro Data Input; 2-Port USB HUB; STN1110/ ELM327 CANBUS Interface; Current Sensor/ Poly Fuse; Rpi2 Power Back-feed; UART x2; SPI; Button Input; GPIO; Power Switch

RVI over cell

RVI over Cell

Real Time Clock

TIMER LED Status

DC-DC Power system
5V @ 1.5A Switchable
4.1V @ 2A Switchable
3.3V @ 1A Switchable
Multiple POL Switches
