jbanks2/rvi_v2x_board/Hardware/Project Shares/V1/V2X Archetecture.pdf

## Cloud server

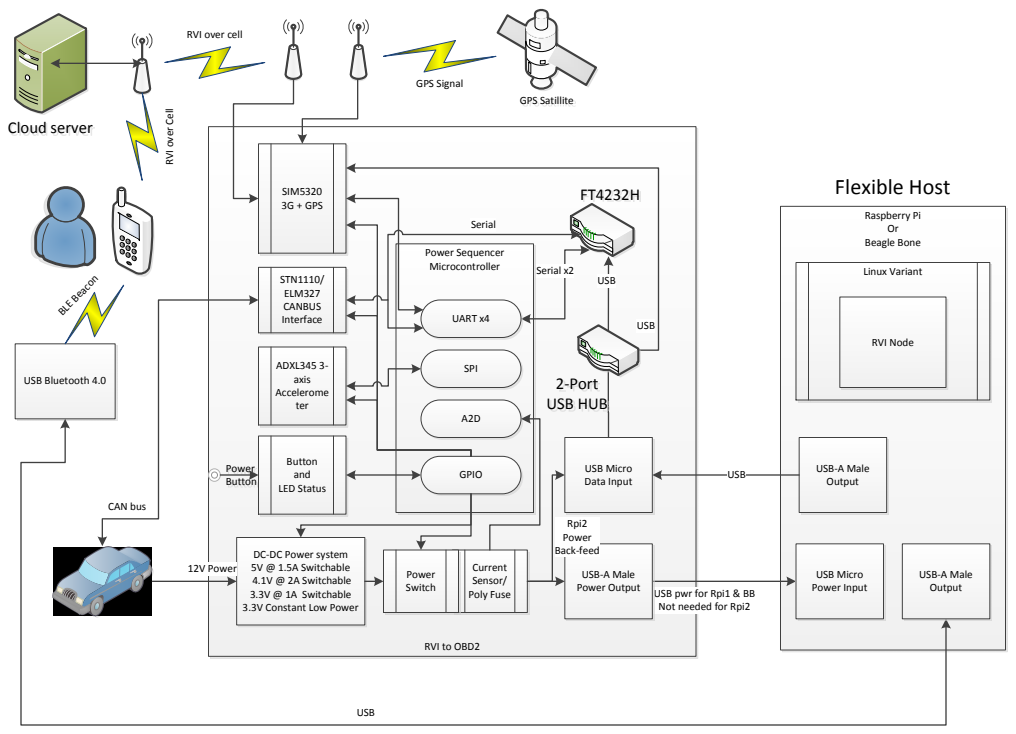
[picture p17: page 1]
RVI to OBD2; SIM5320 3G + GPS; GPS Signal; GPS Satillite; Raspberry Pi Or Beagle Bone; ADXL345 3- axis Accelerome ter; USB Bluetooth 4.0; BLE Beacon; Linux Variant; RVI Node; Flexible Host; Power Sequencer Microcontroller; USB; 12V Power; CAN bus; USB Micro Power Input; USB-A Male Output; USB-A Male Power Output; USB Micro Data Input; 2-Port USB HUB; STN1110/ ELM327 CANBUS Interface; Serial; Serial x2; Current Sensor/ Poly Fuse; Rpi2 Power Back-feed; UART x4; SPI; Button and LED Status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

RVI over cell

RVI over Cell

DC-DC Power system
5V @ 1.5A Switchable
4.1V @ 2A Switchable
3.3V @ 1A Switchable
3.3V Constant Low Power

USB pwr for Rpi1 & BB
Not needed for Rpi2
