jbanks2/rvi_v2x_board/Hardware/Project Shares/V1.2/V2X V1.2 Schematic 110315.pdf

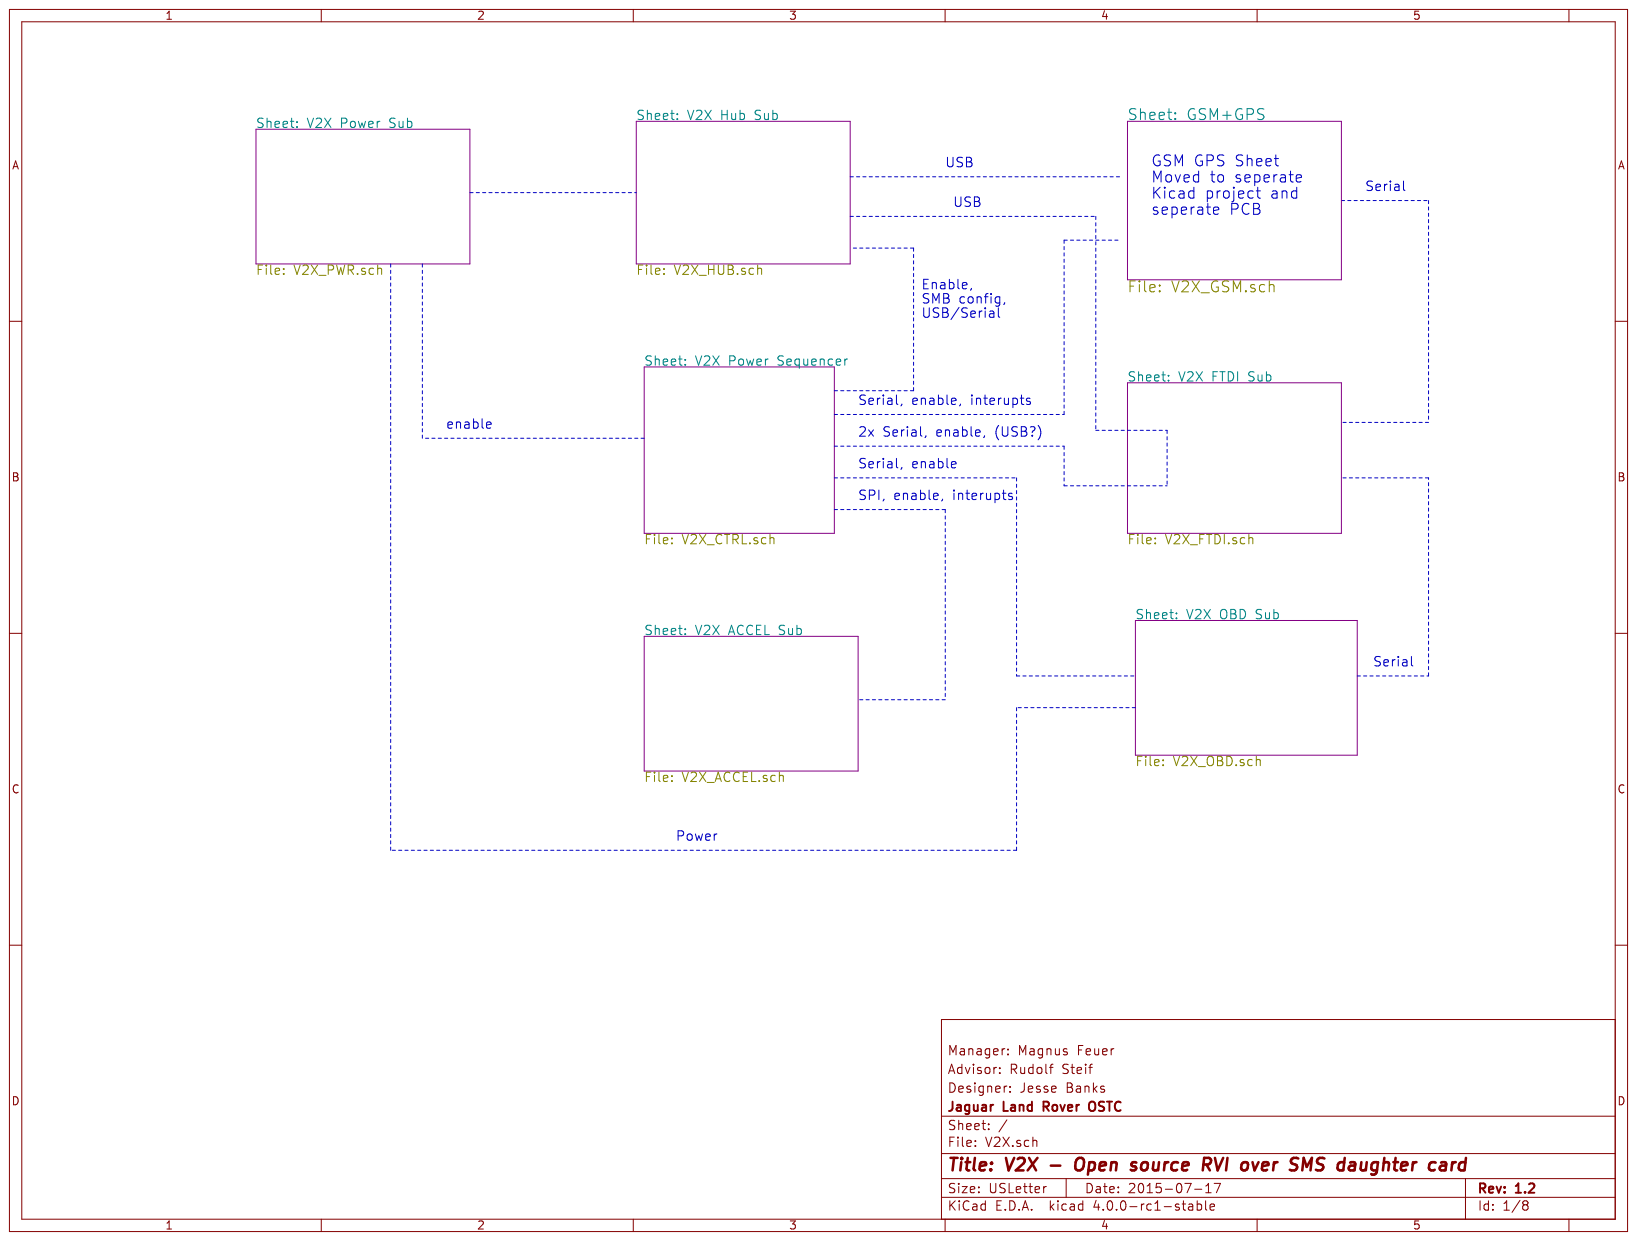
[picture p18: page 1]

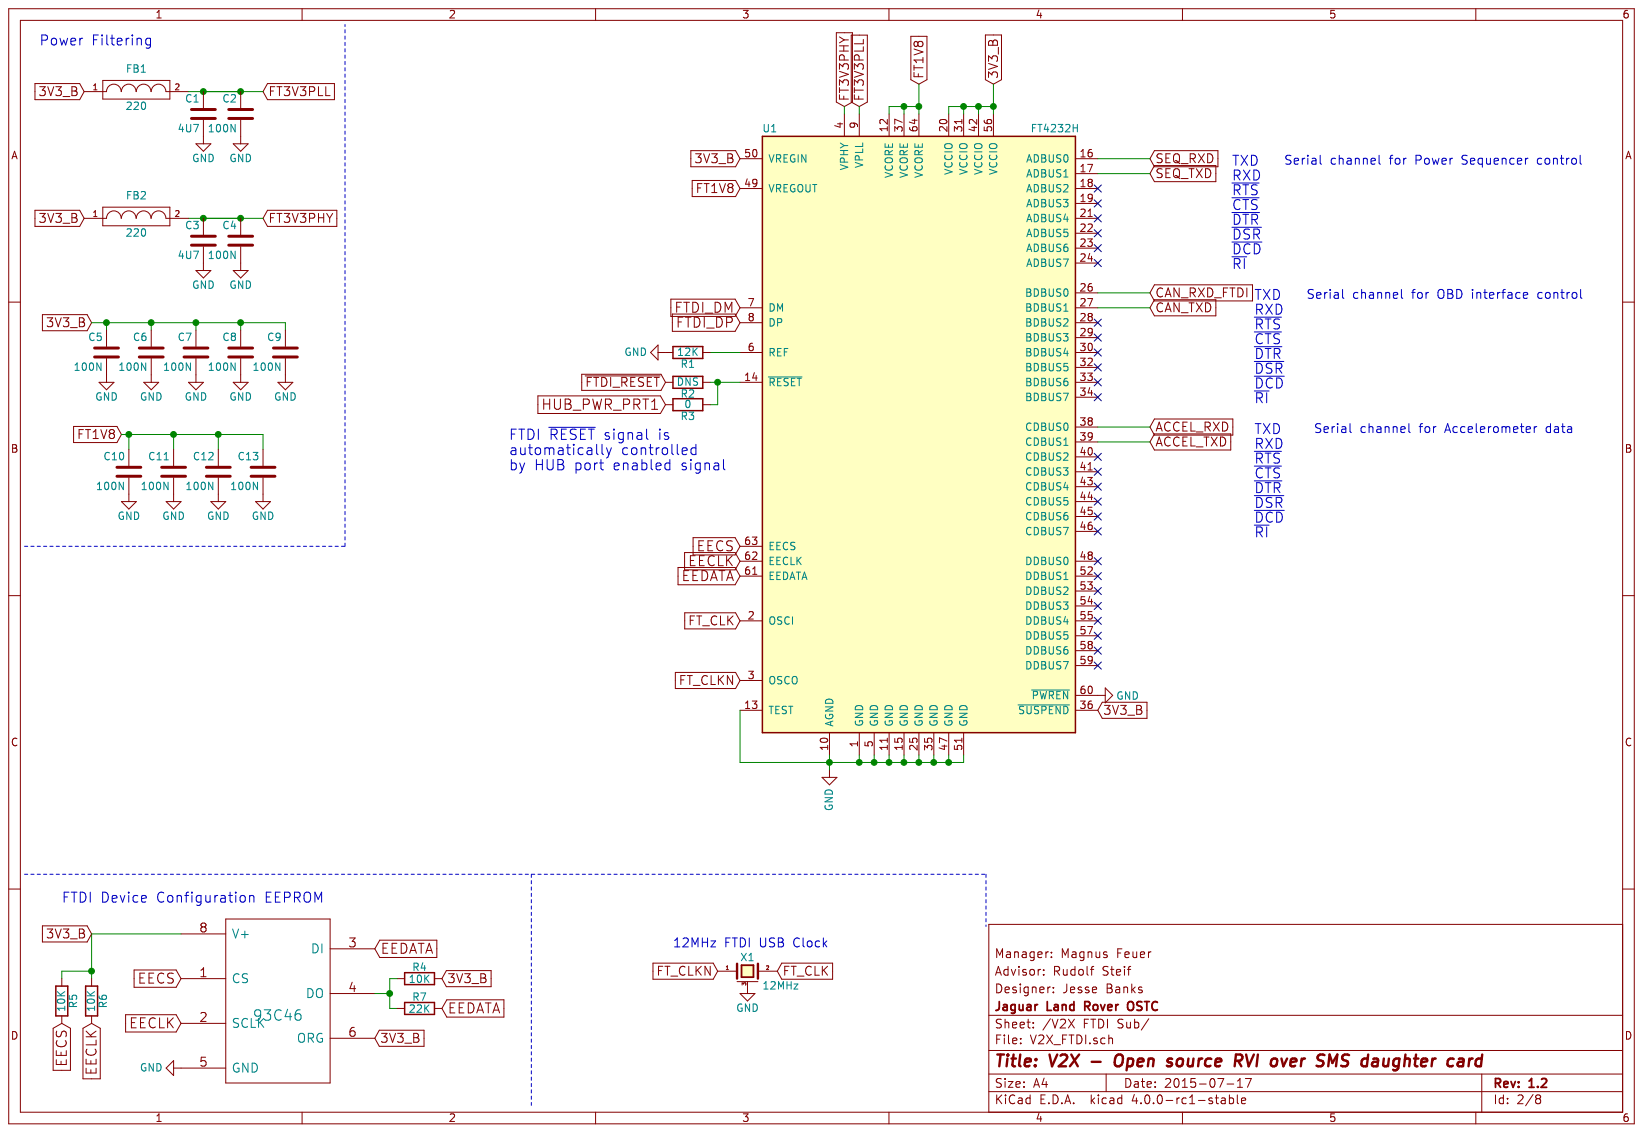
[picture p19: page 2]

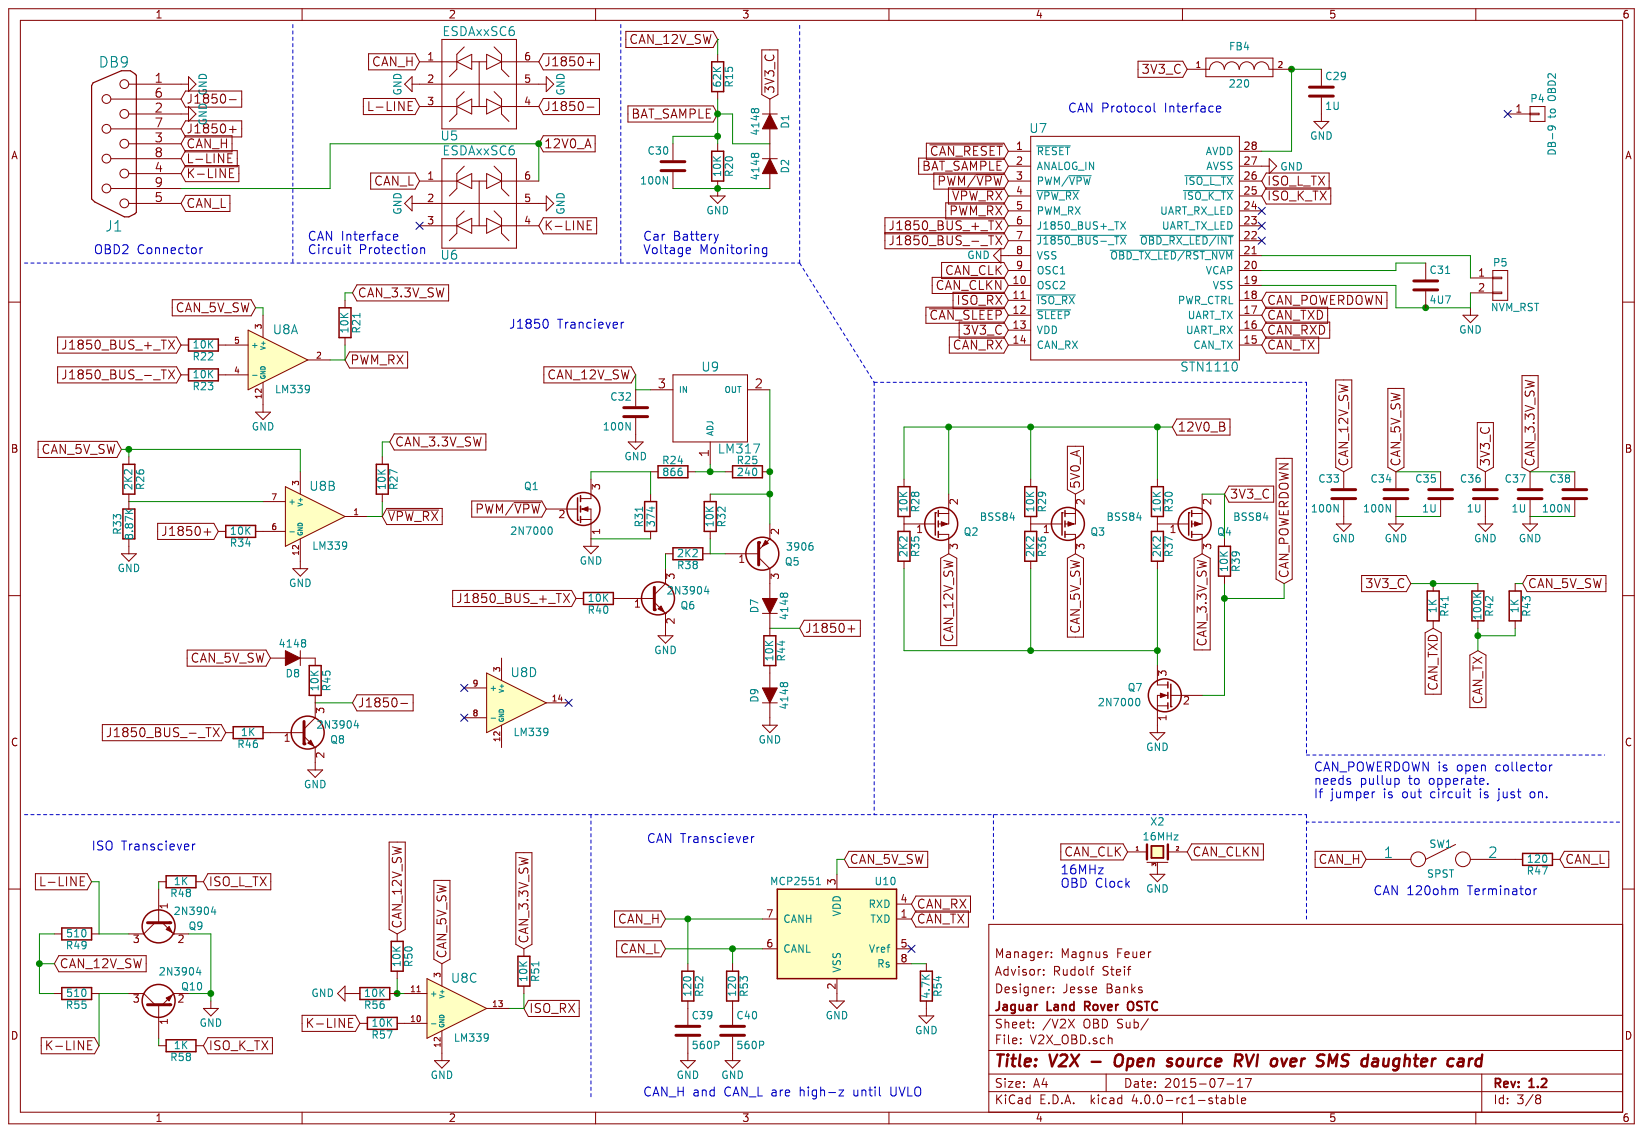
[picture p20: page 3]

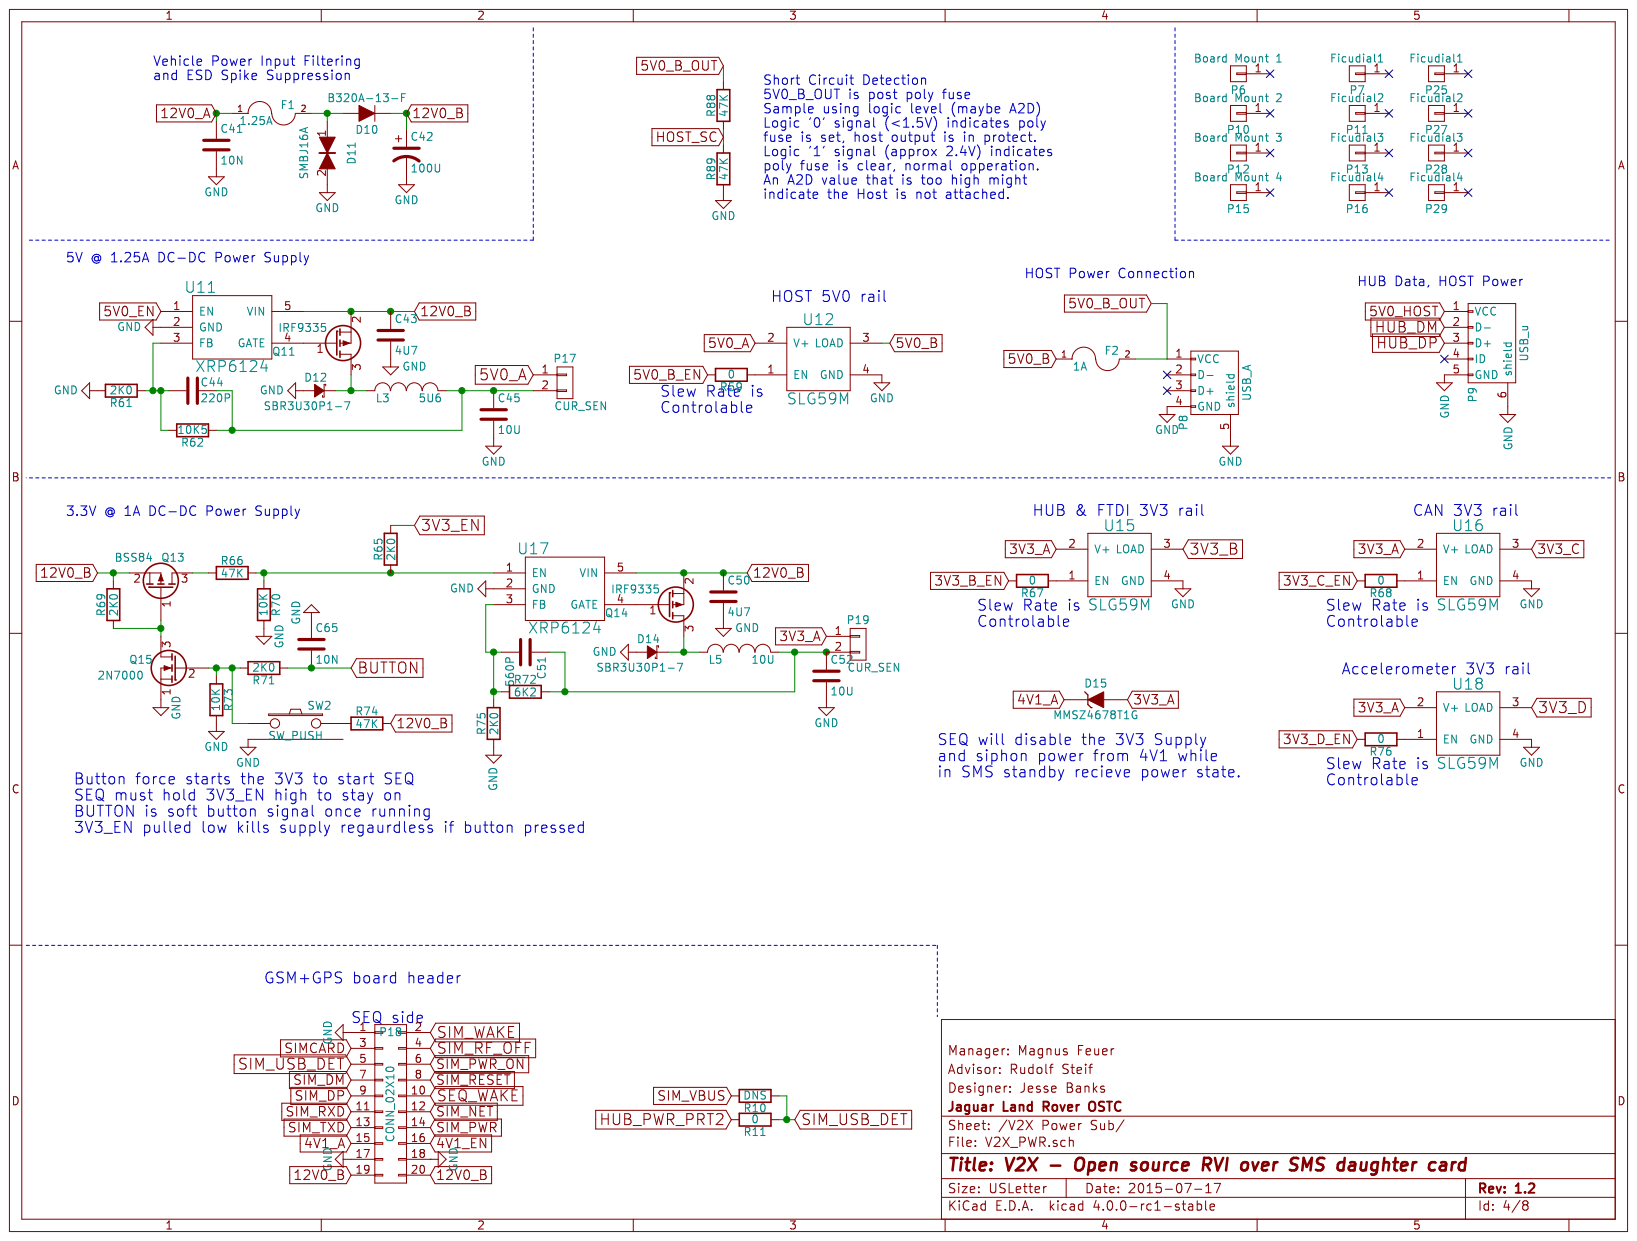
[picture p21: page 4]

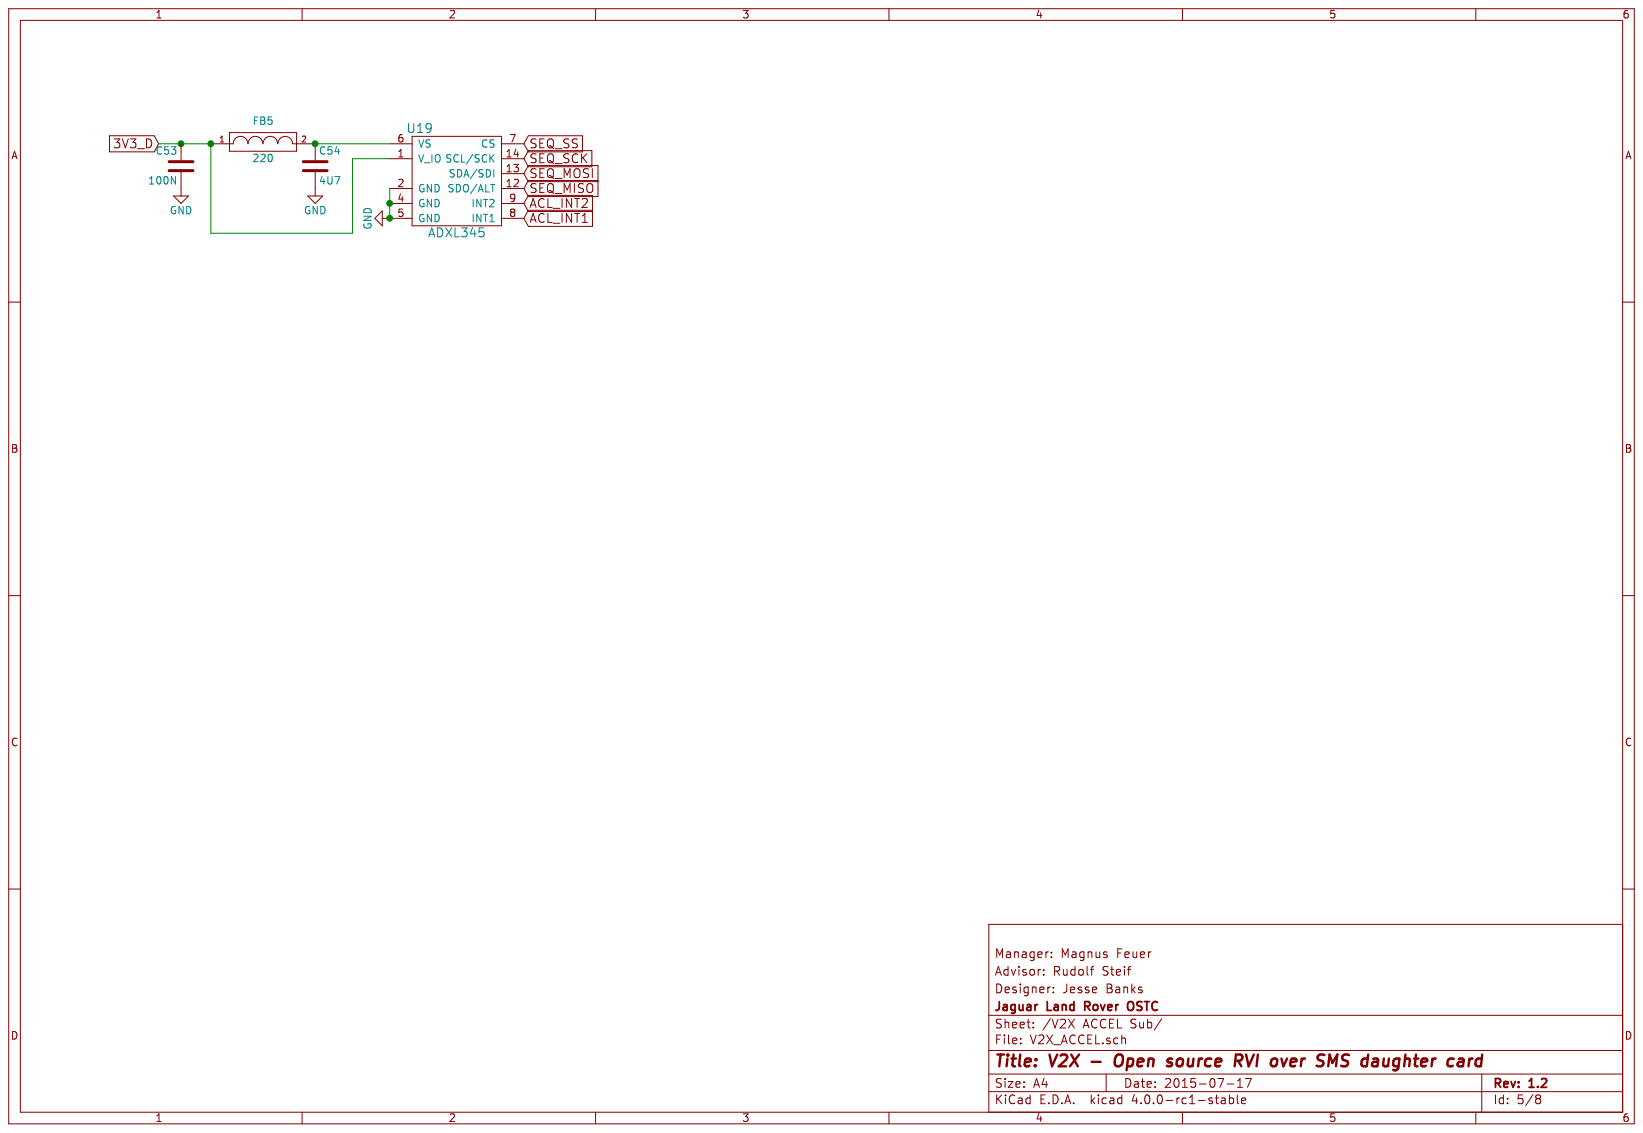
[picture p22: page 5]

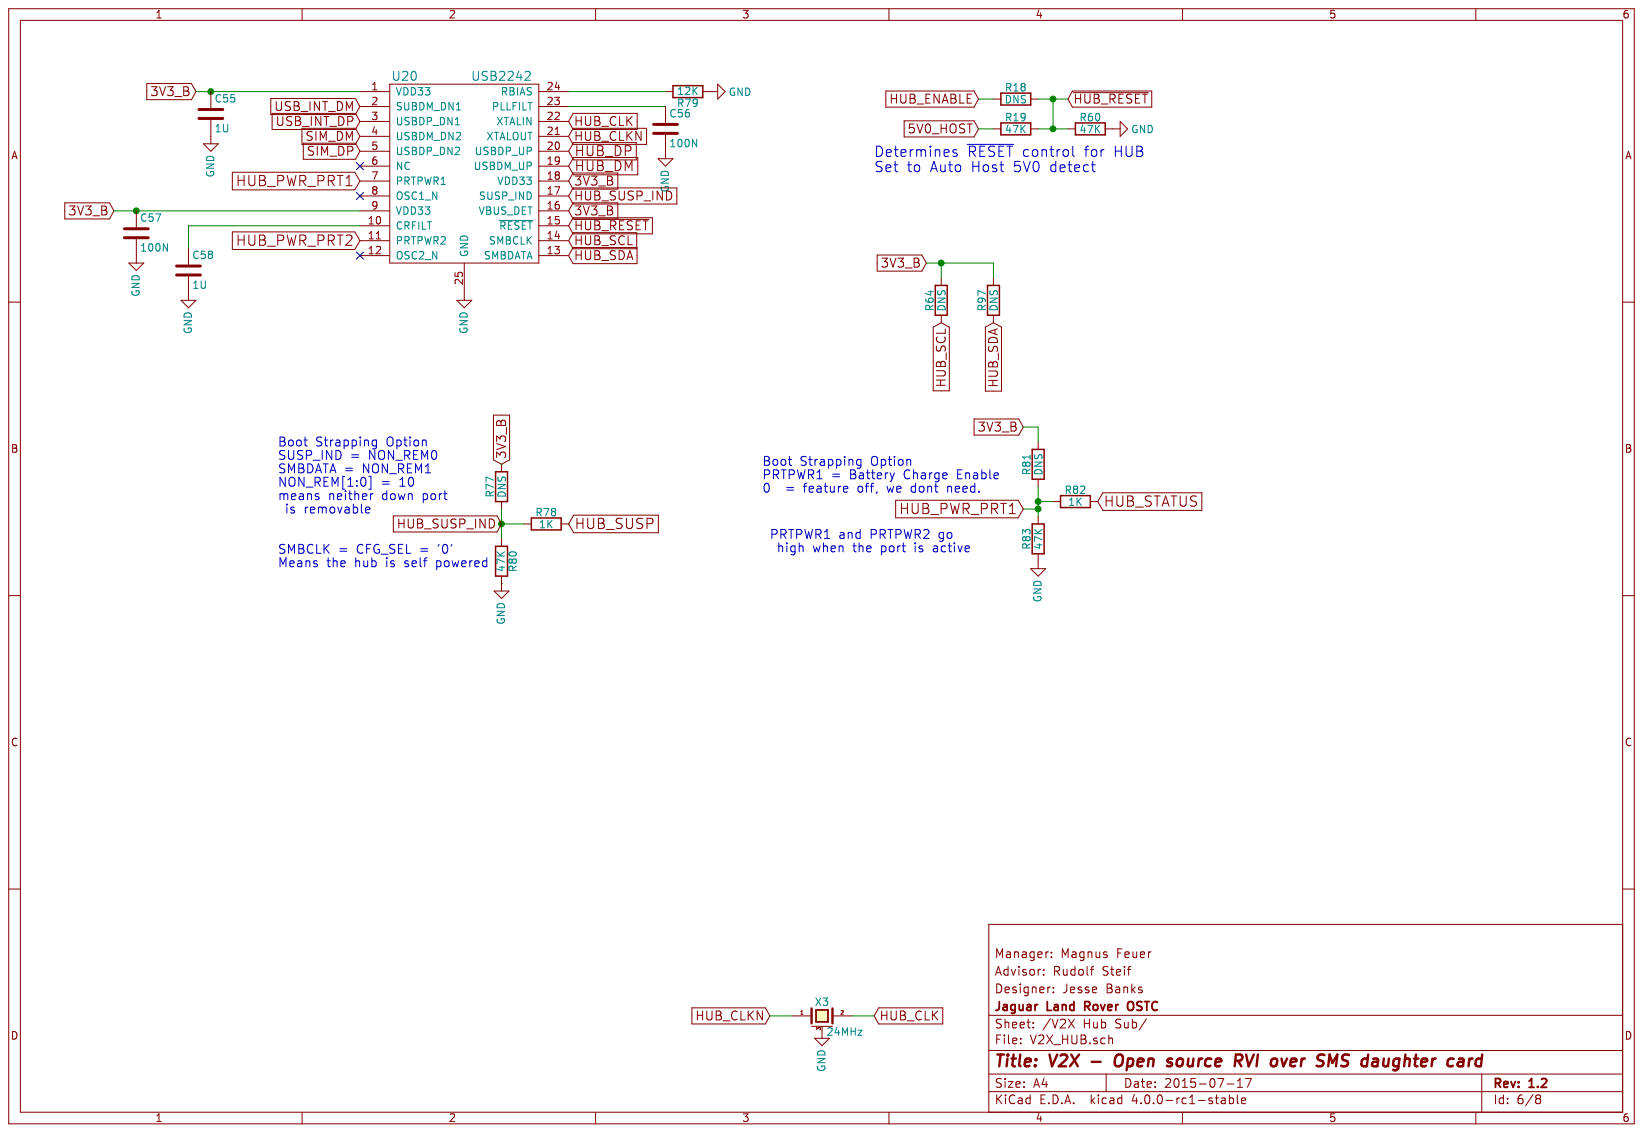
[picture p23: page 6]

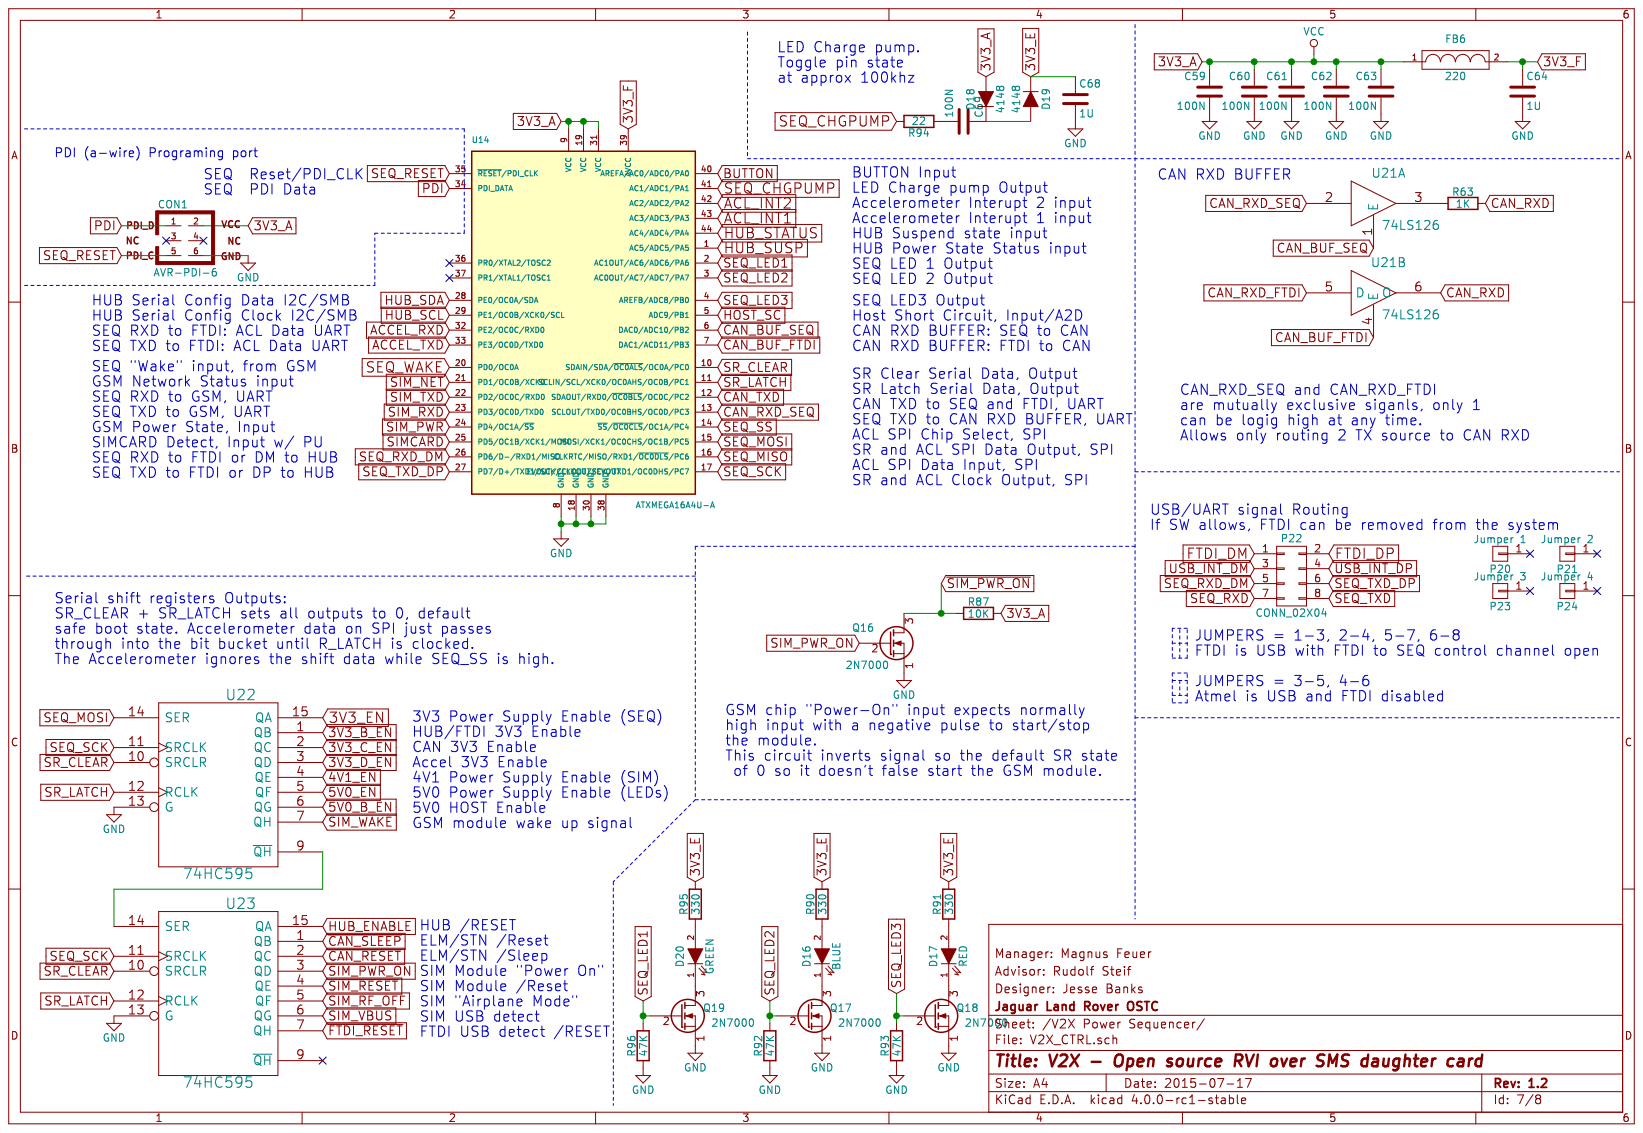
[picture p24: page 7]

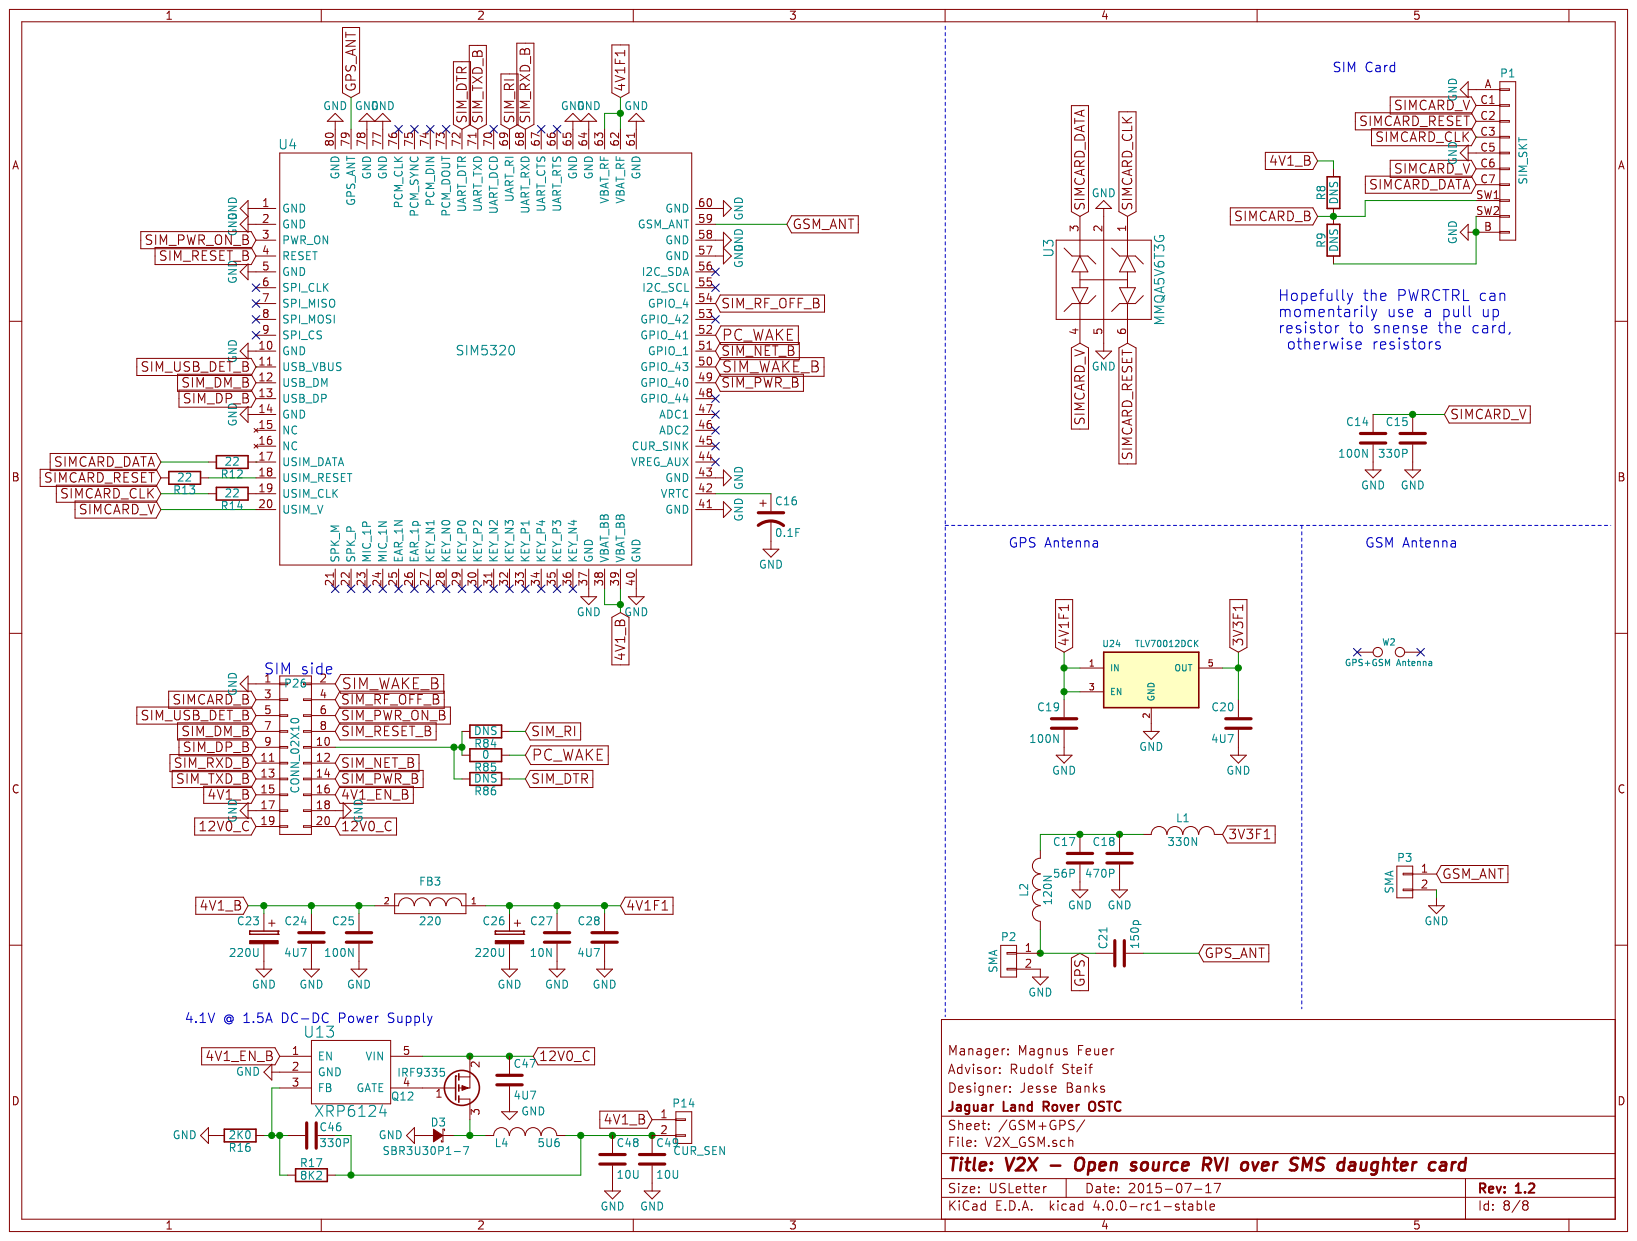
[picture p25: page 8]
