jbanks2/rvi_v2x_board/Hardware/Project Shares/V1.2/V2X V1.2 Shcematic 102115.pdf

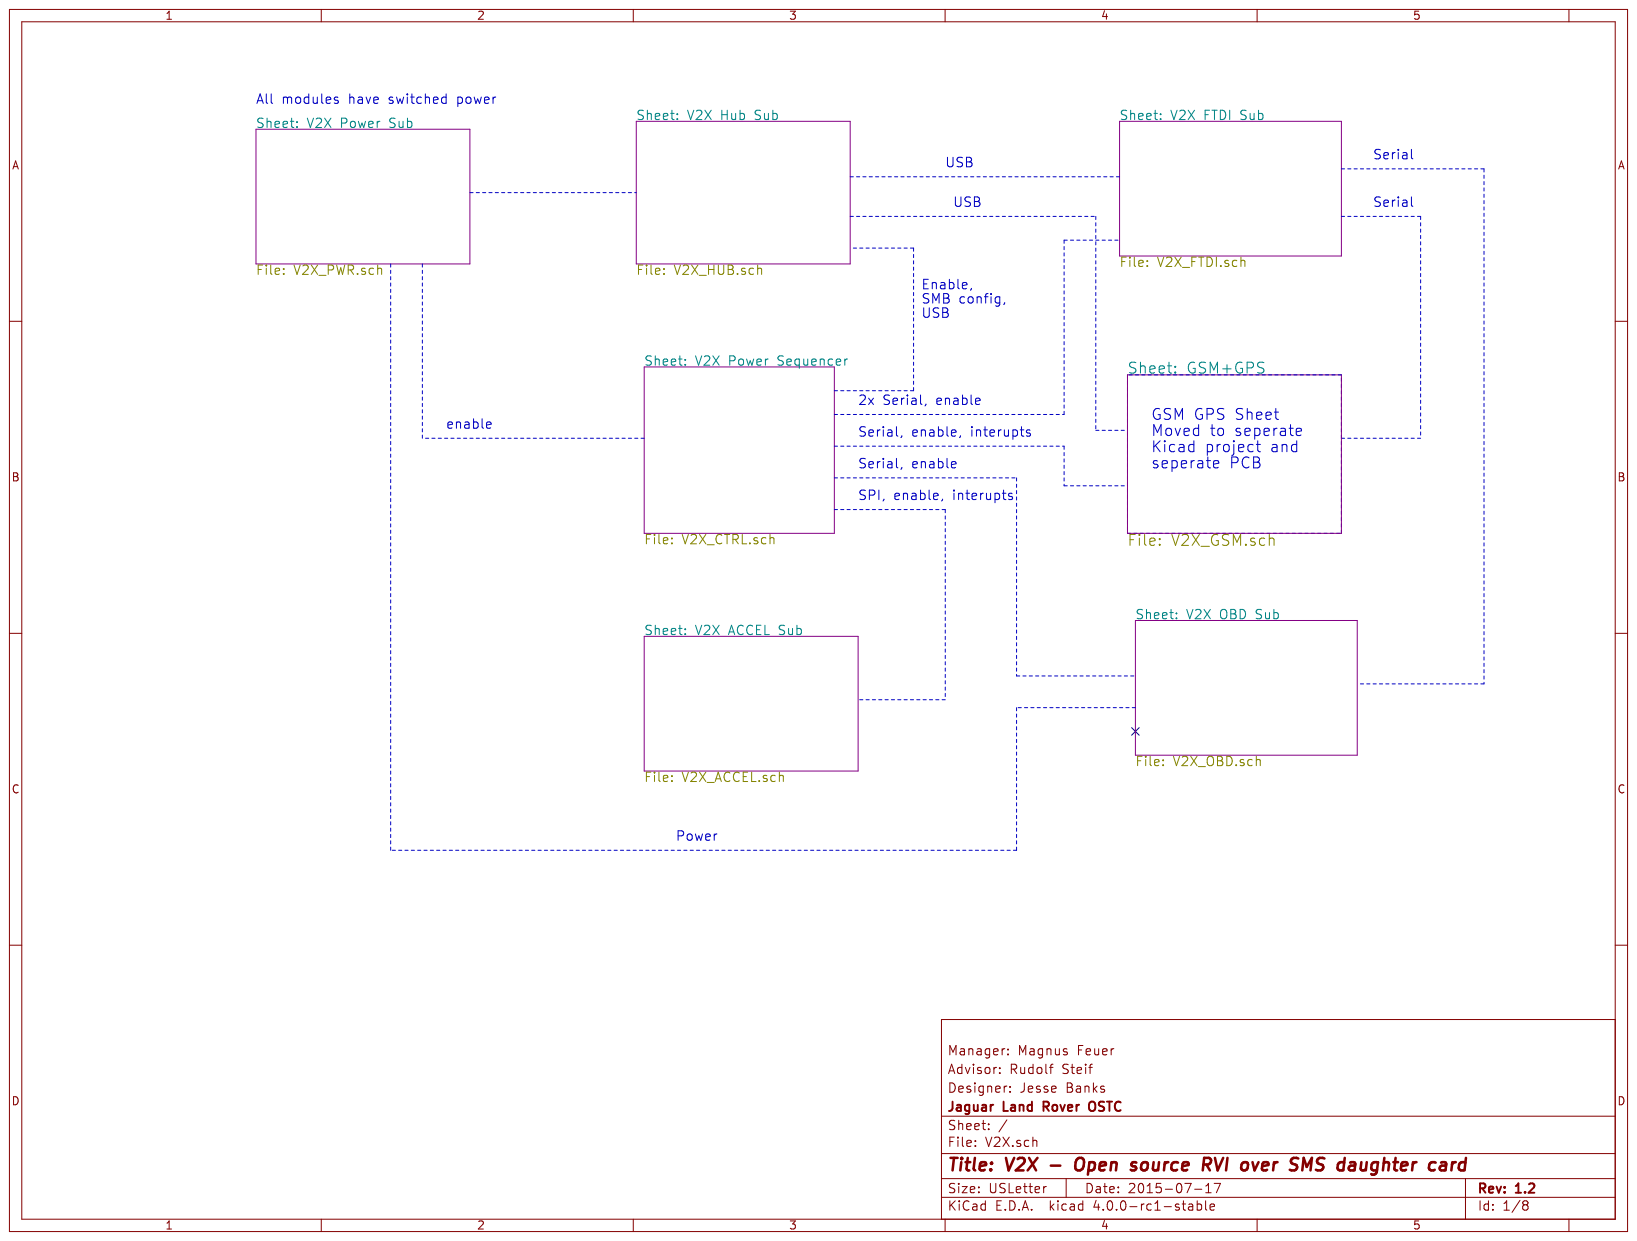
[picture p26: page 1]

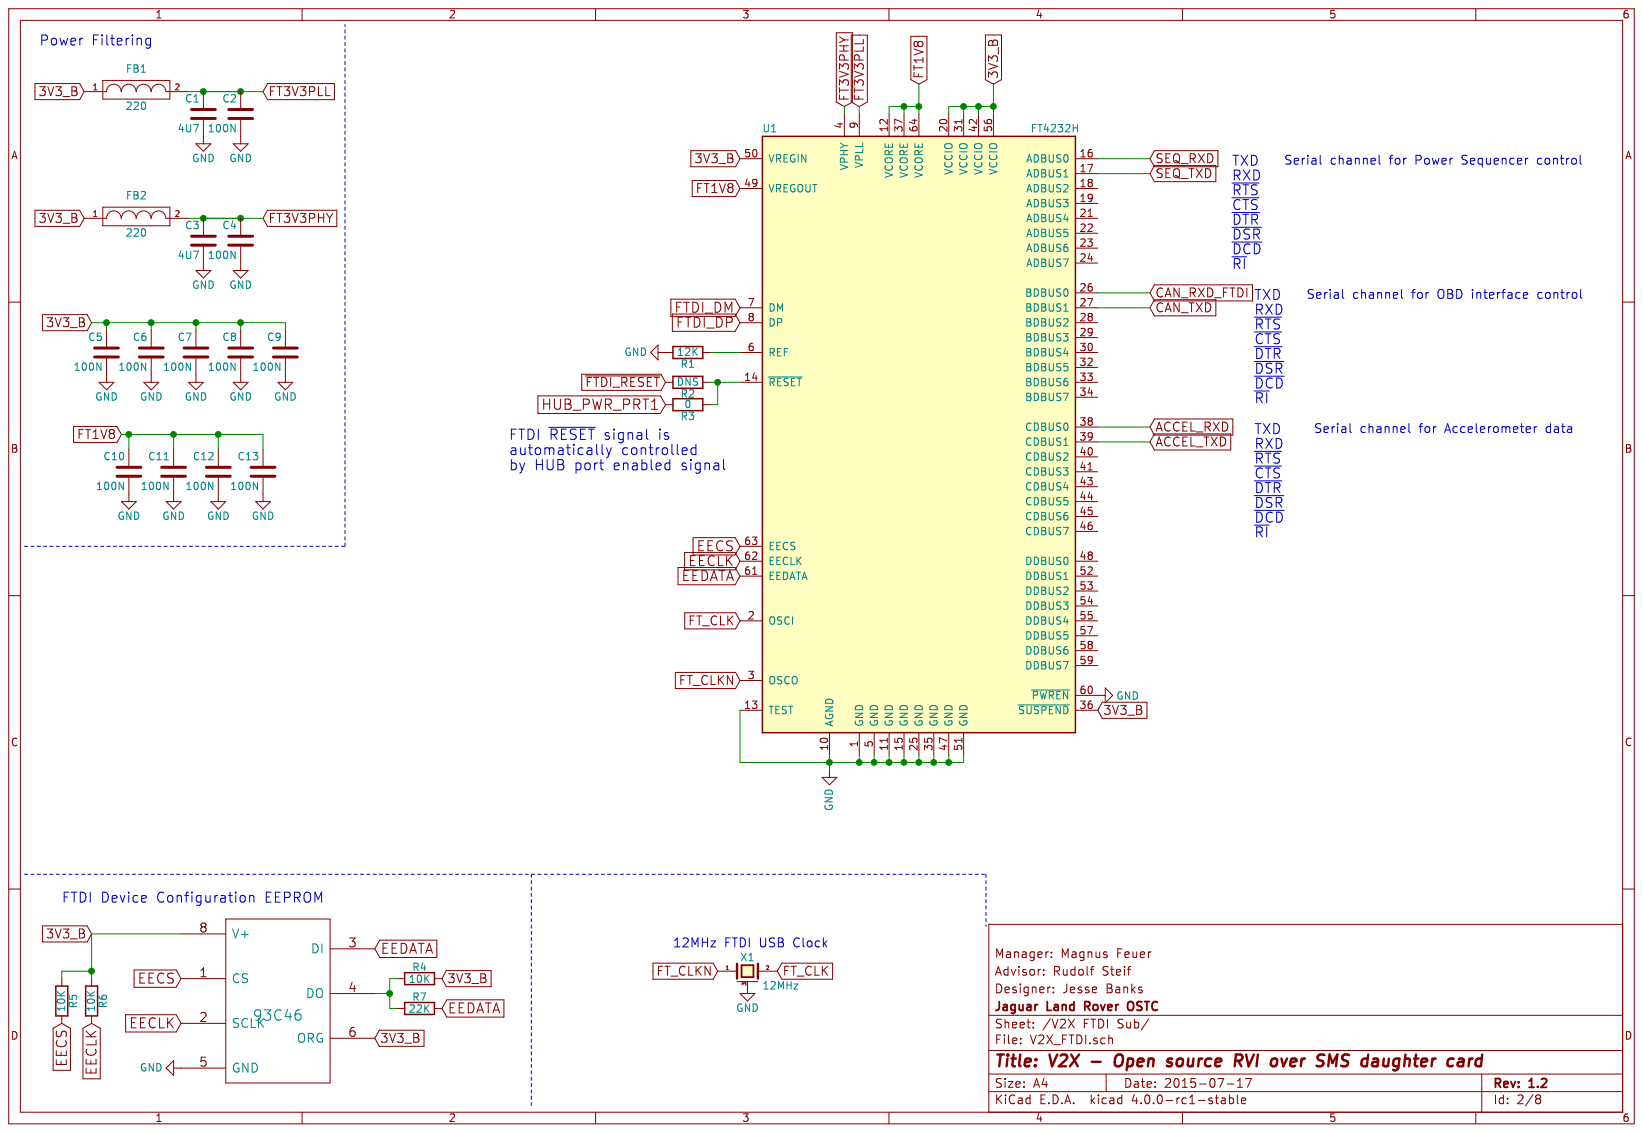
[picture p27: page 2]

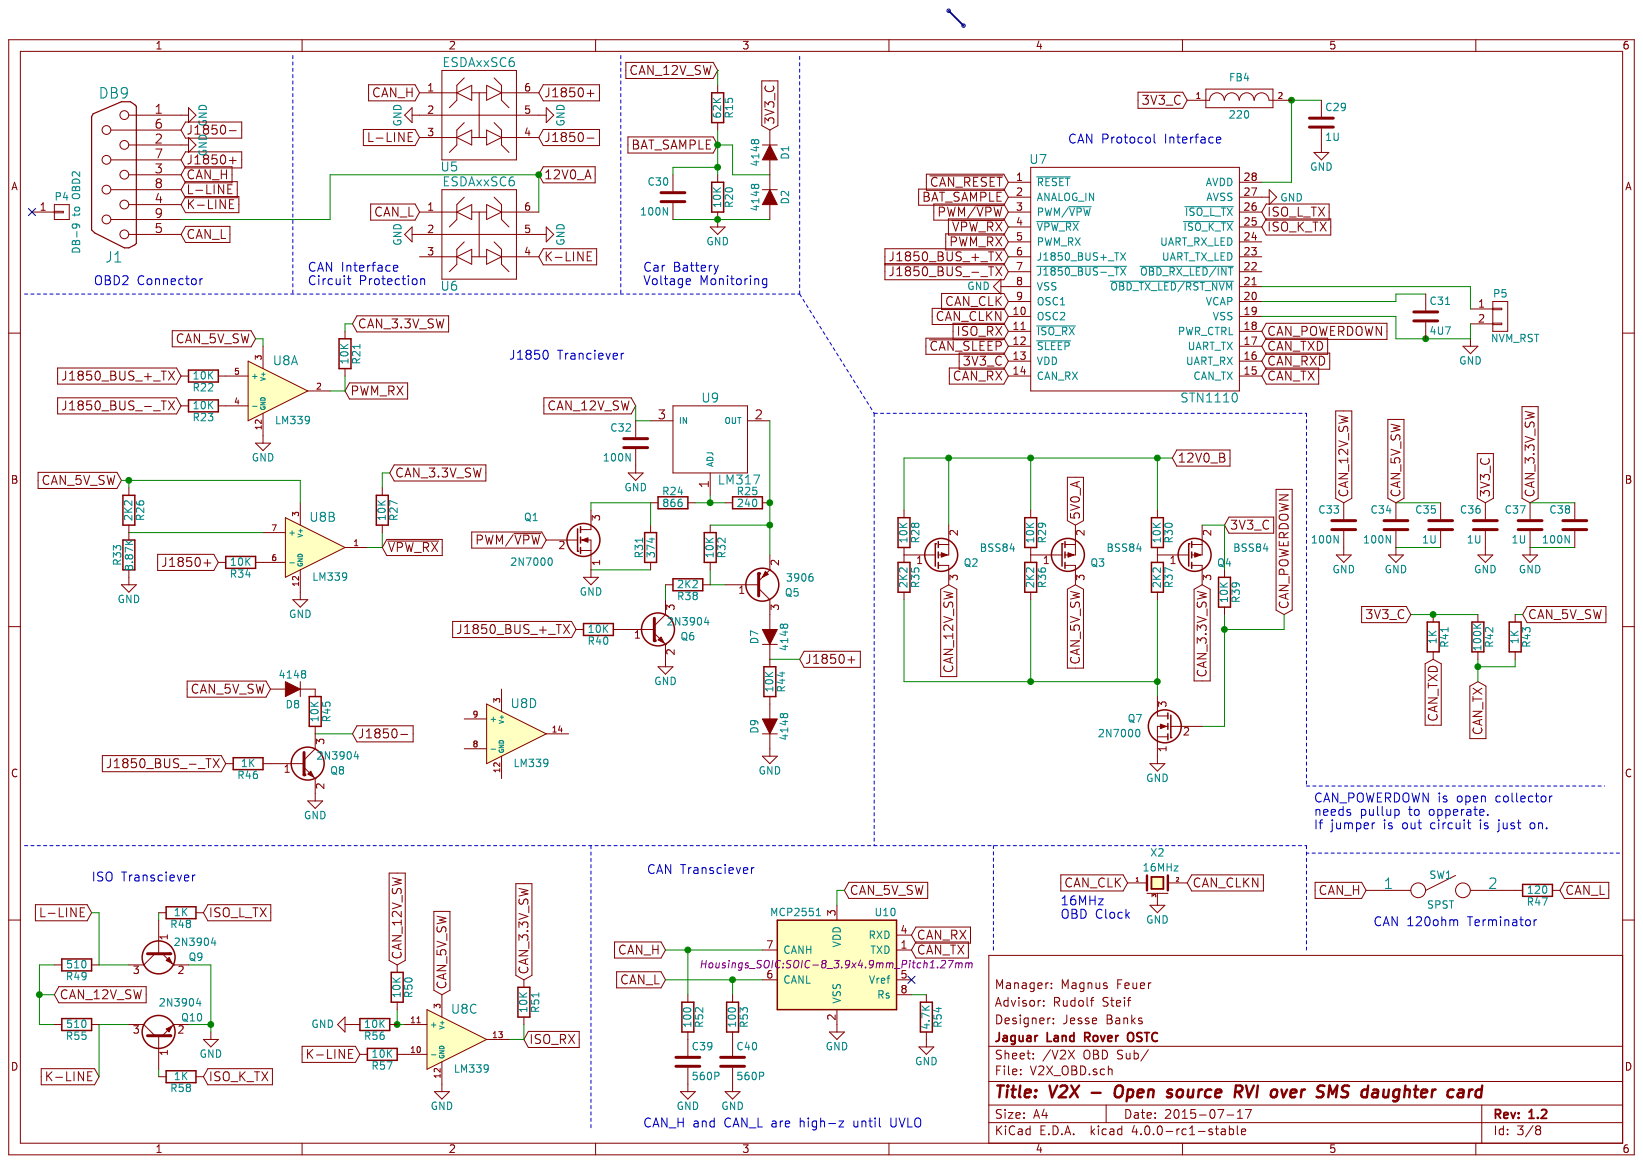
[picture p28: page 3]

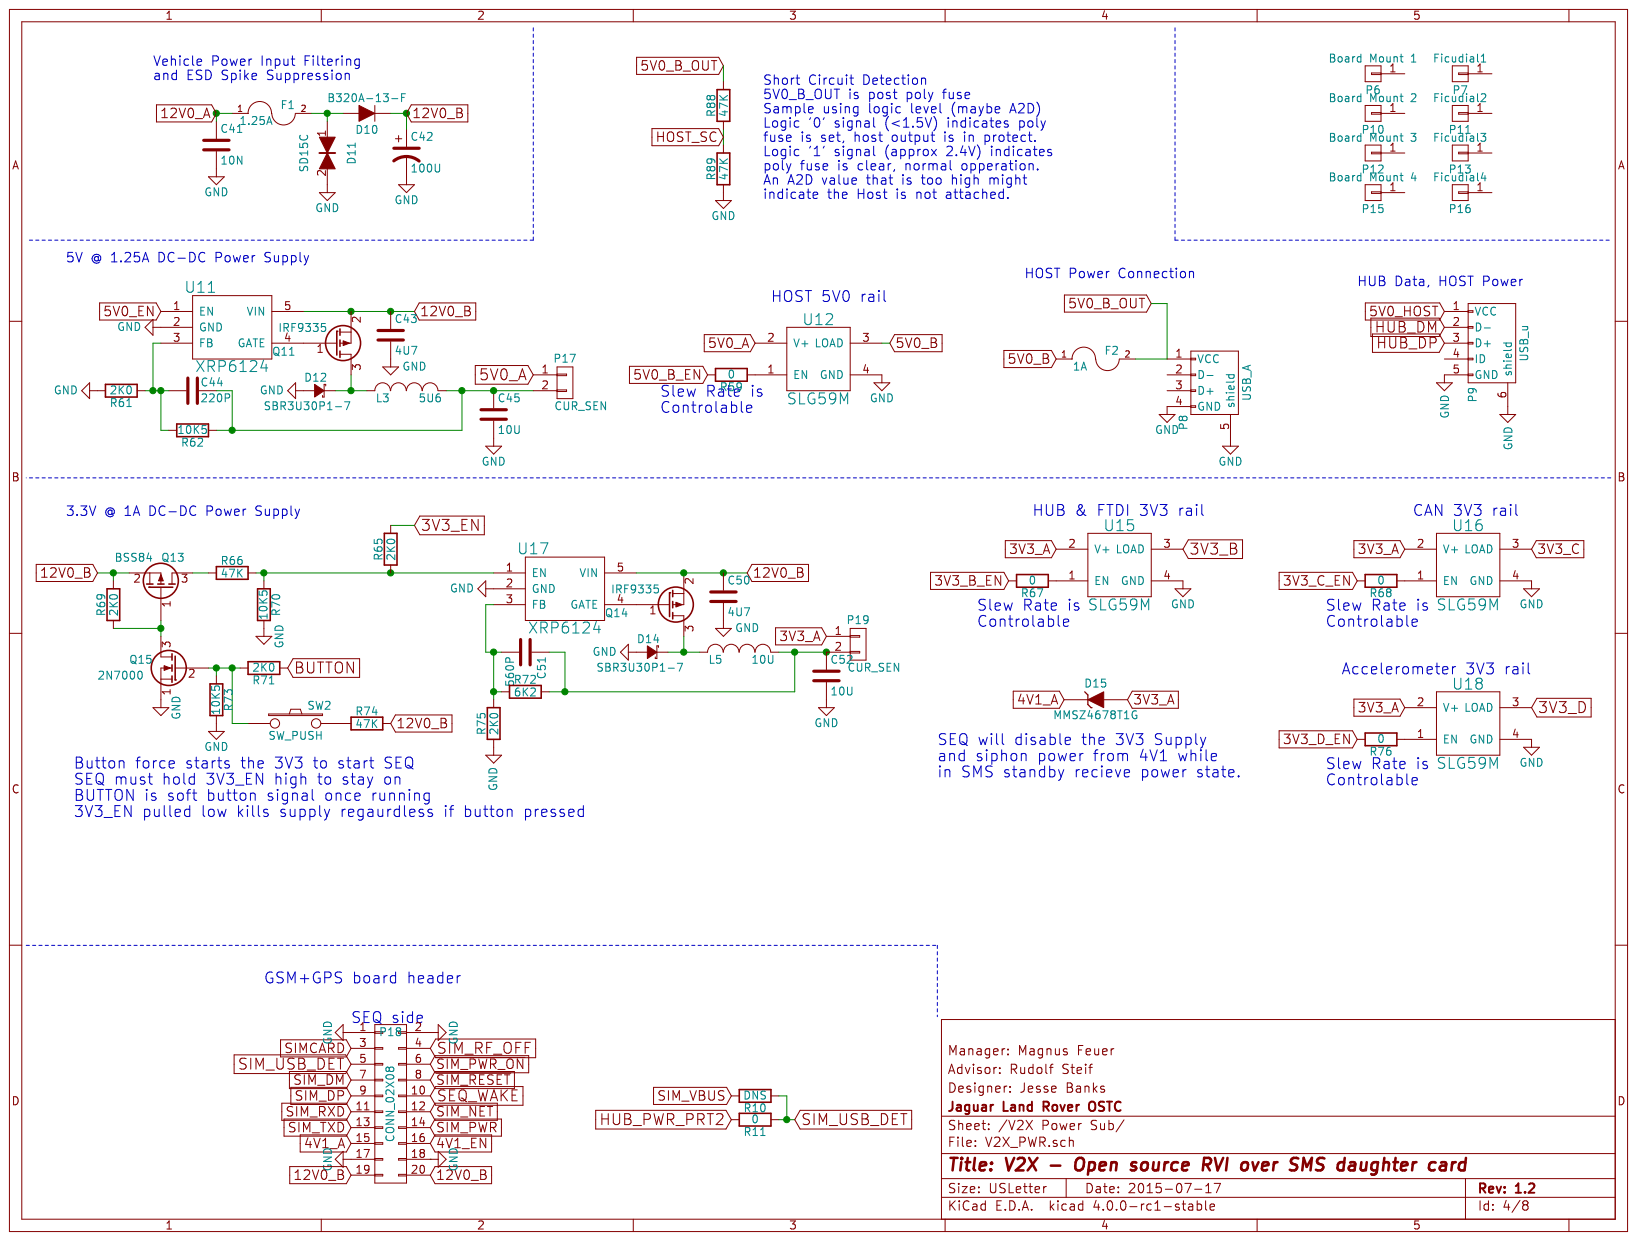
[picture p29: page 4]


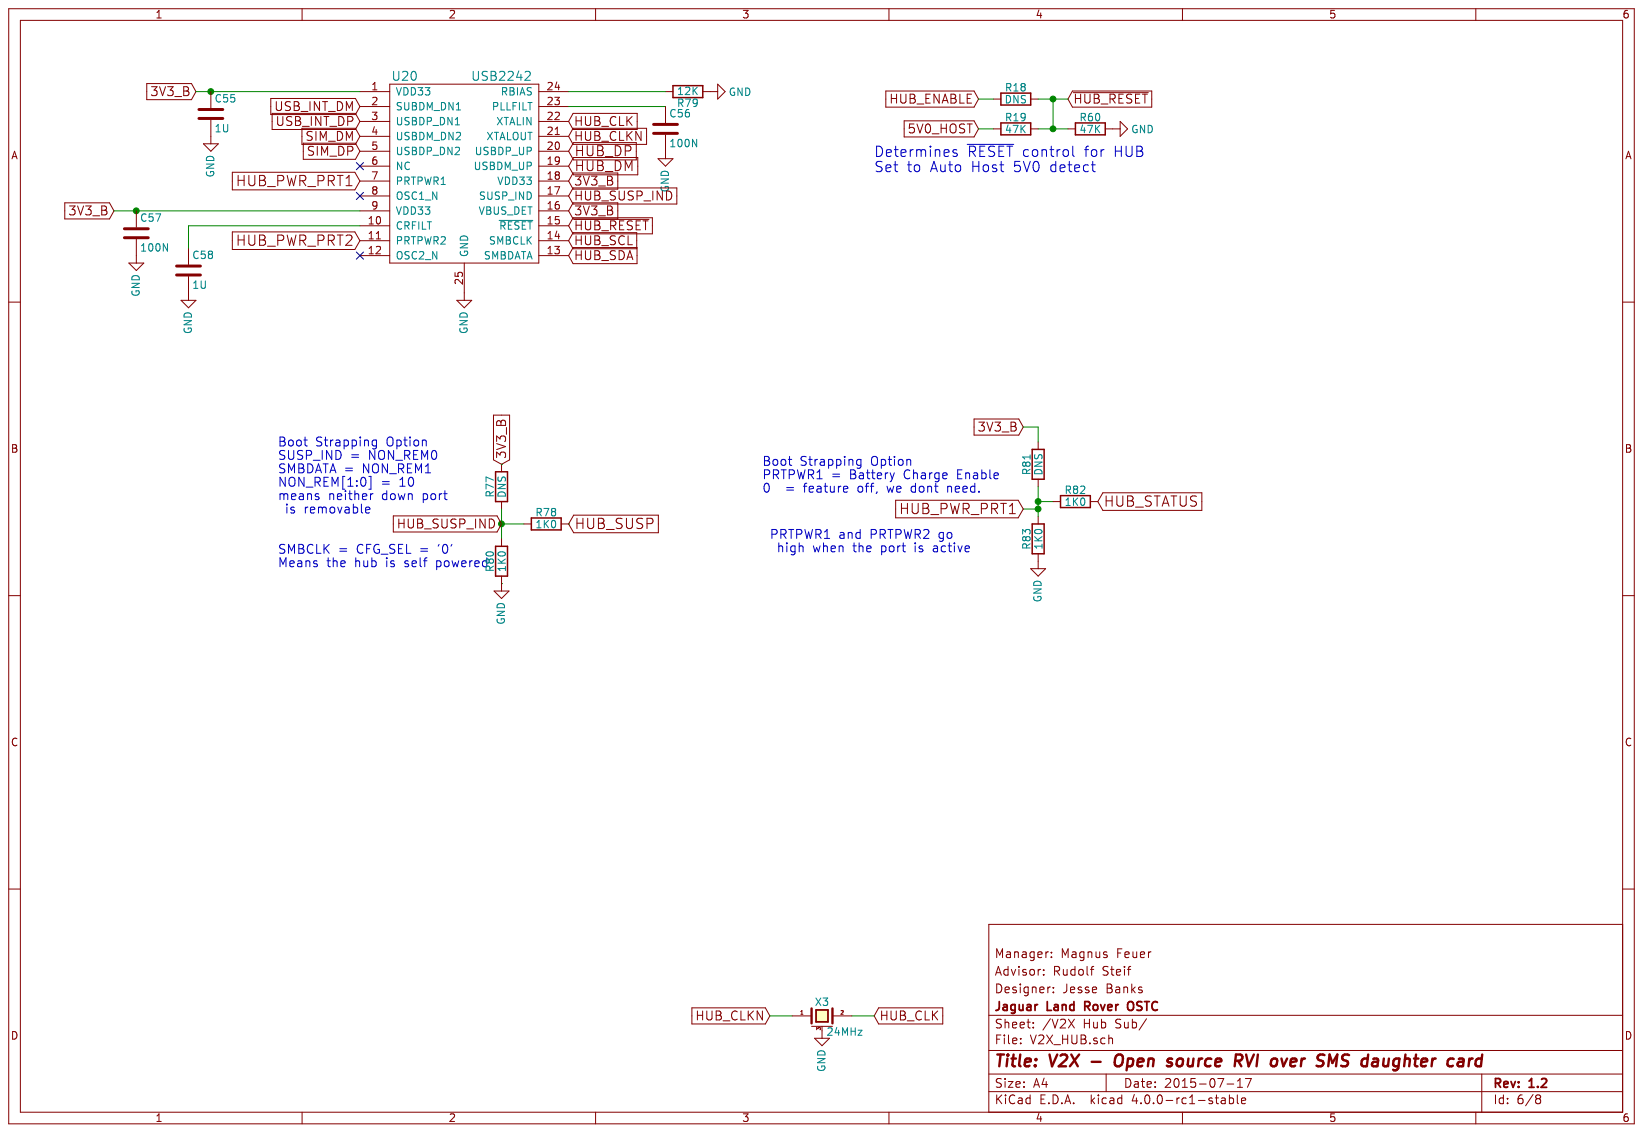
[picture p30: page 6]

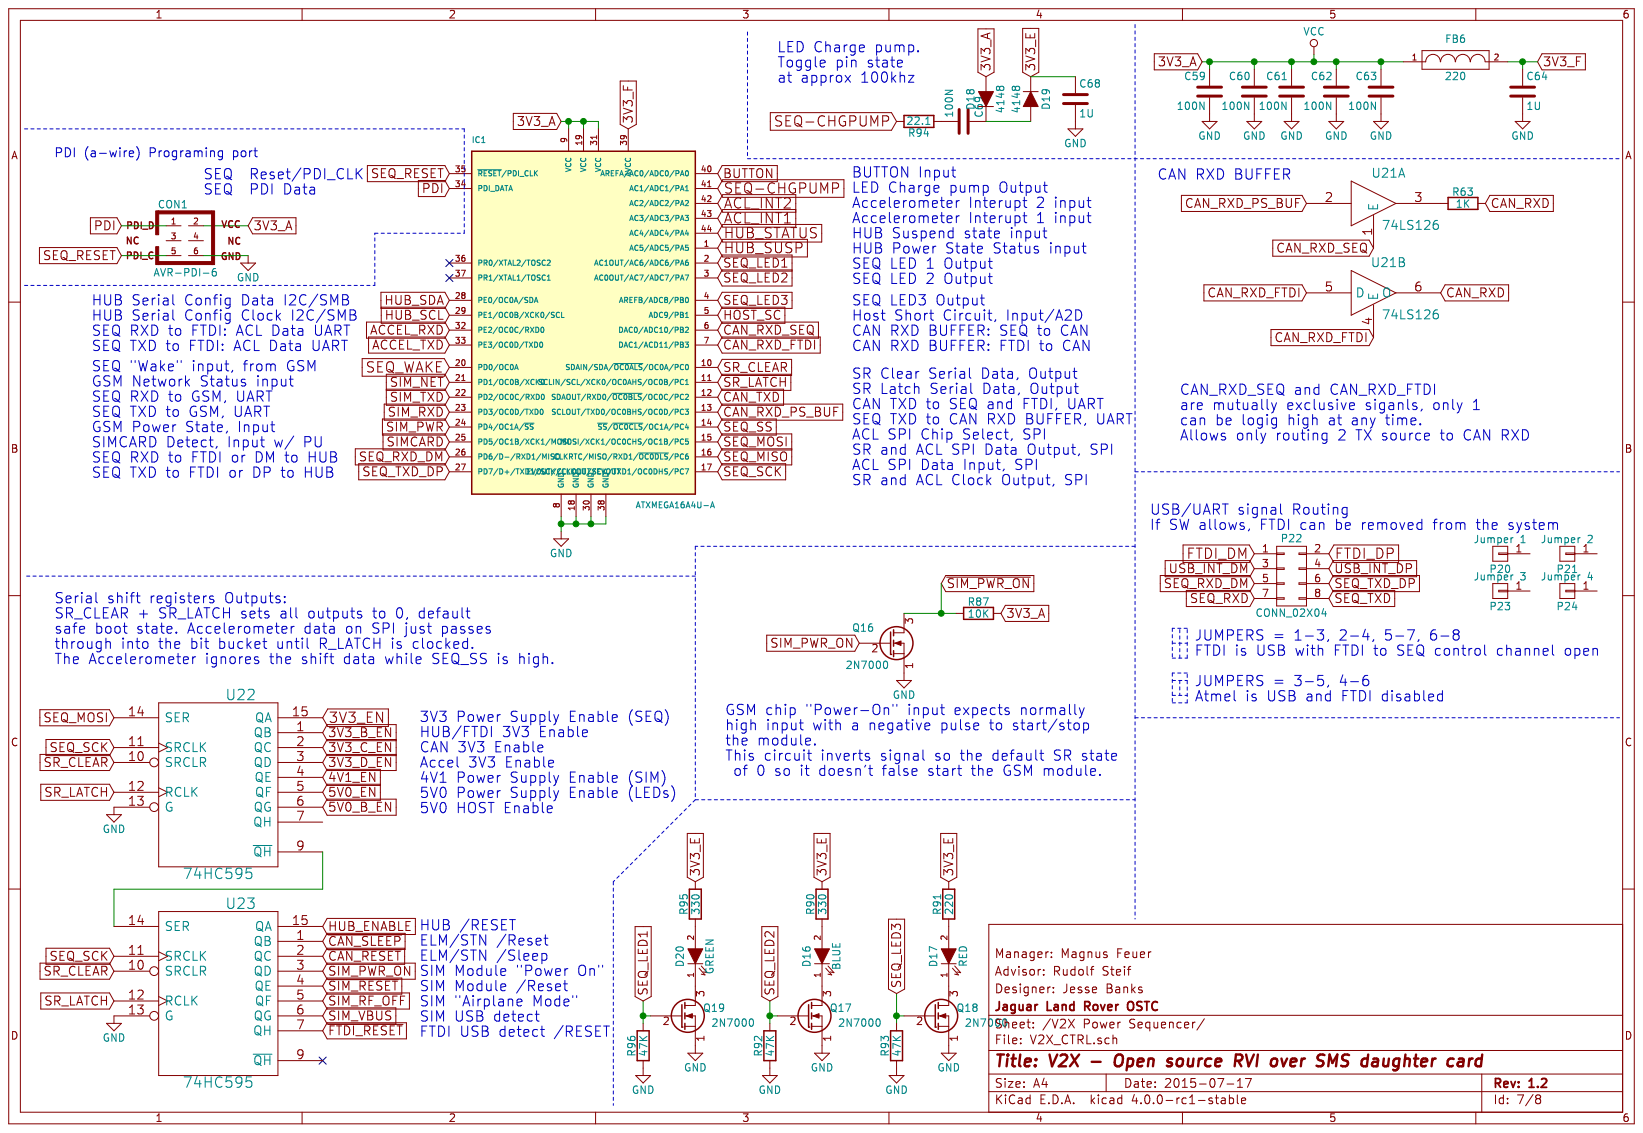
[picture p31: page 7]

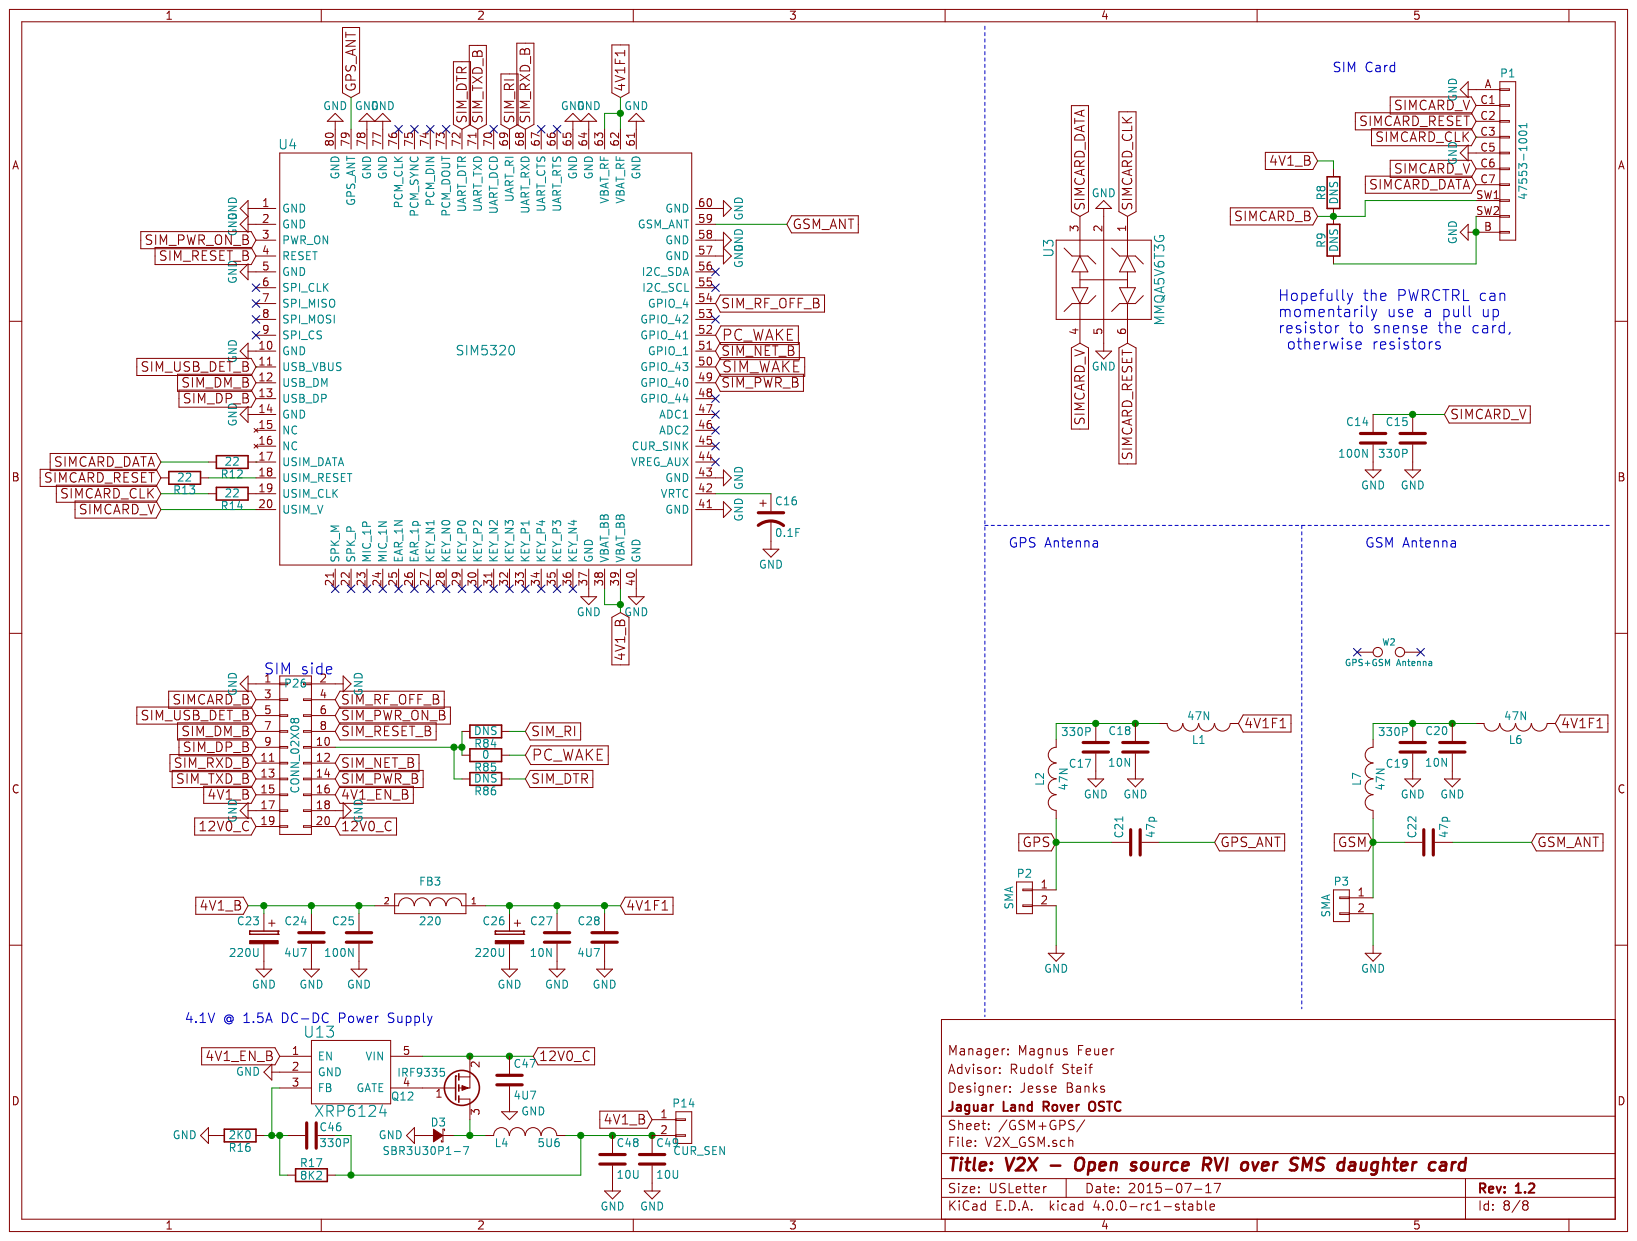
[picture p32: page 8]
