jbanks2/rvi_v2x_board/Hardware/Project Shares/V1.2/V2X V1.2 Shcematic 100815.pdf

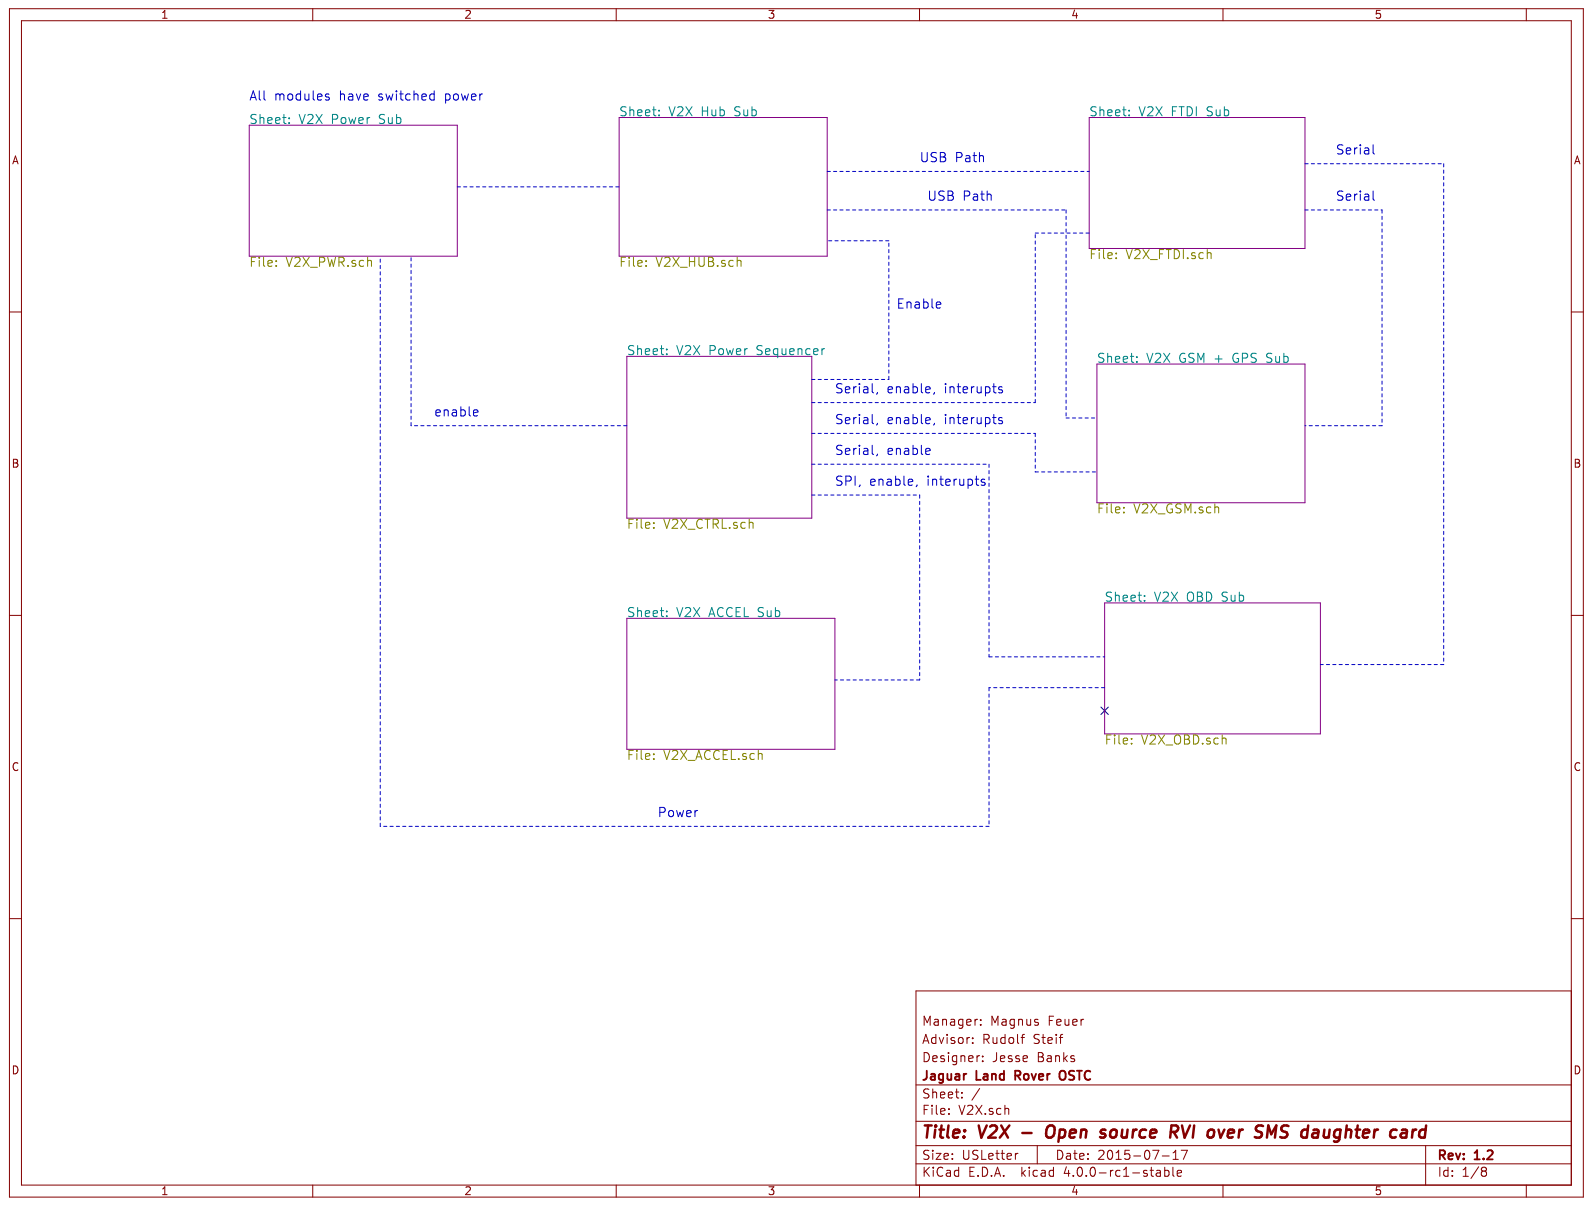
[picture p41: page 1]

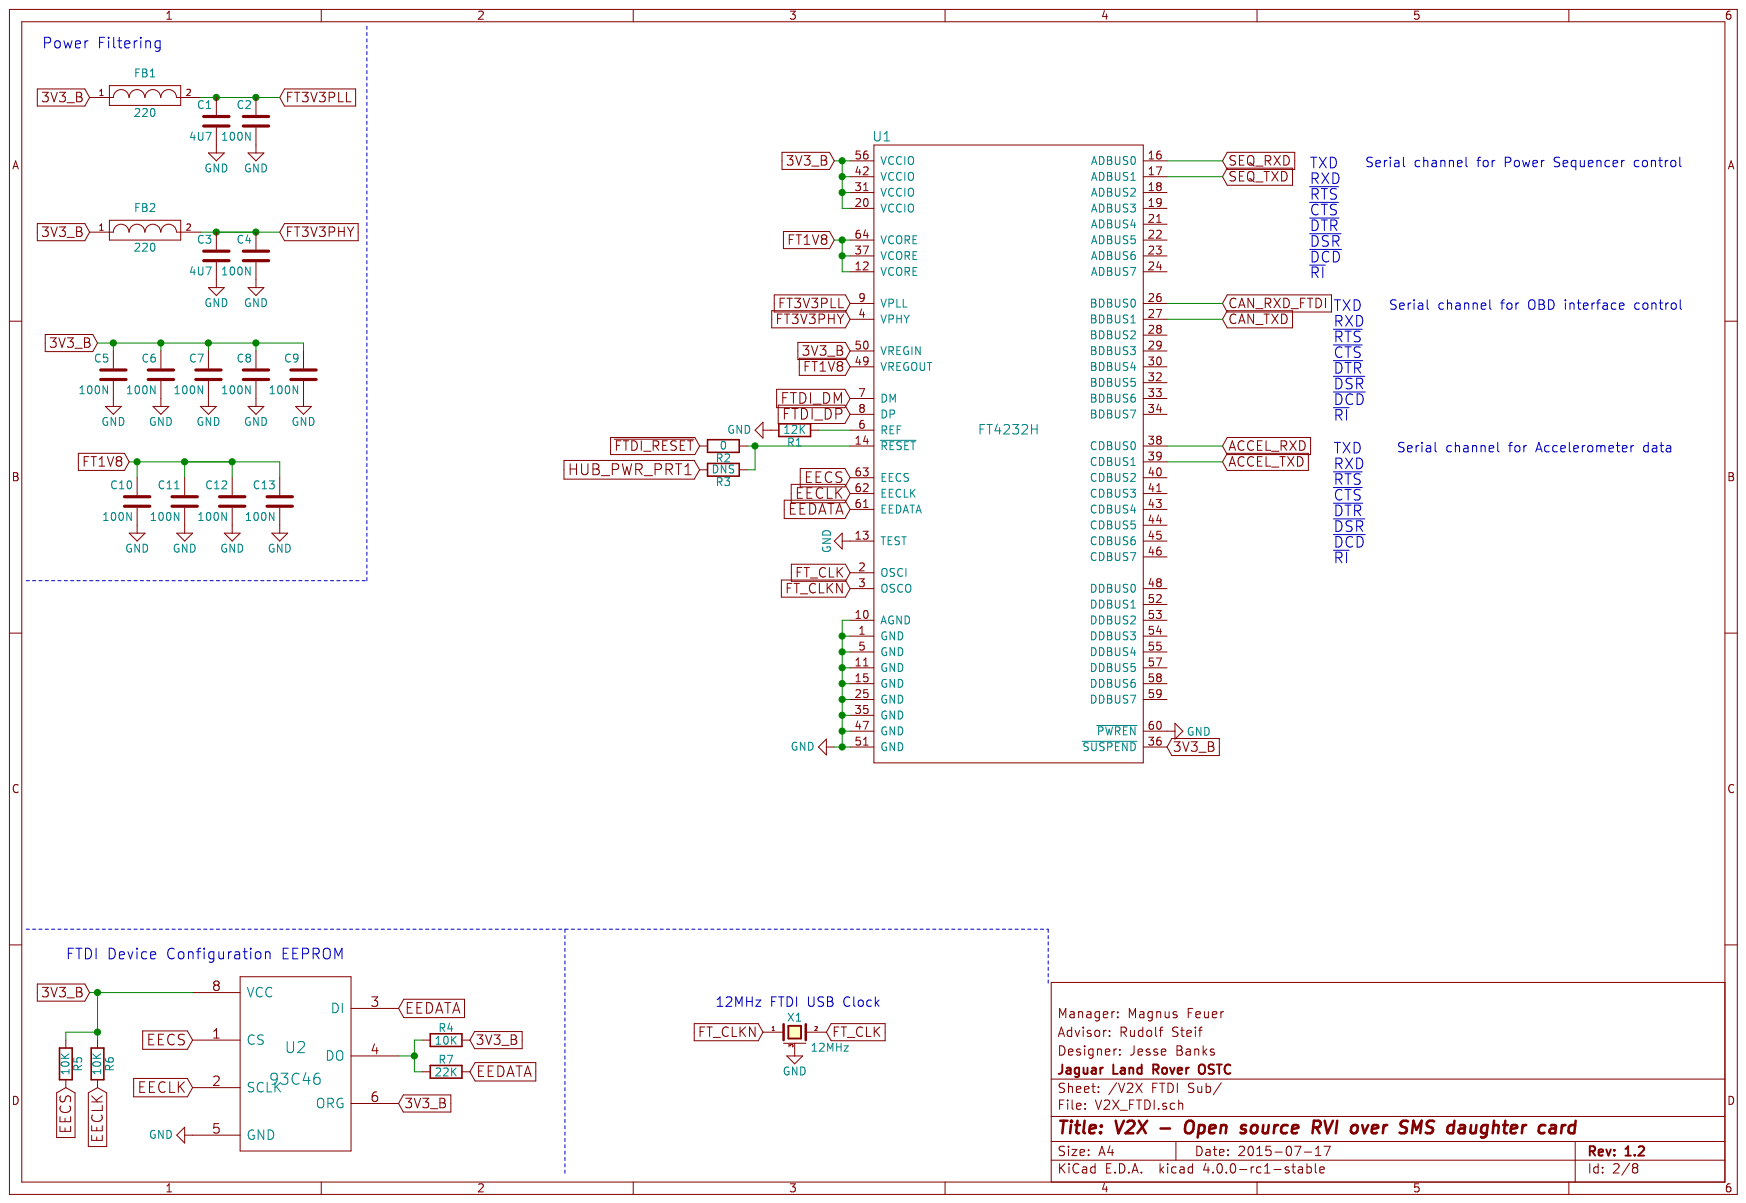
[picture p42: page 2]

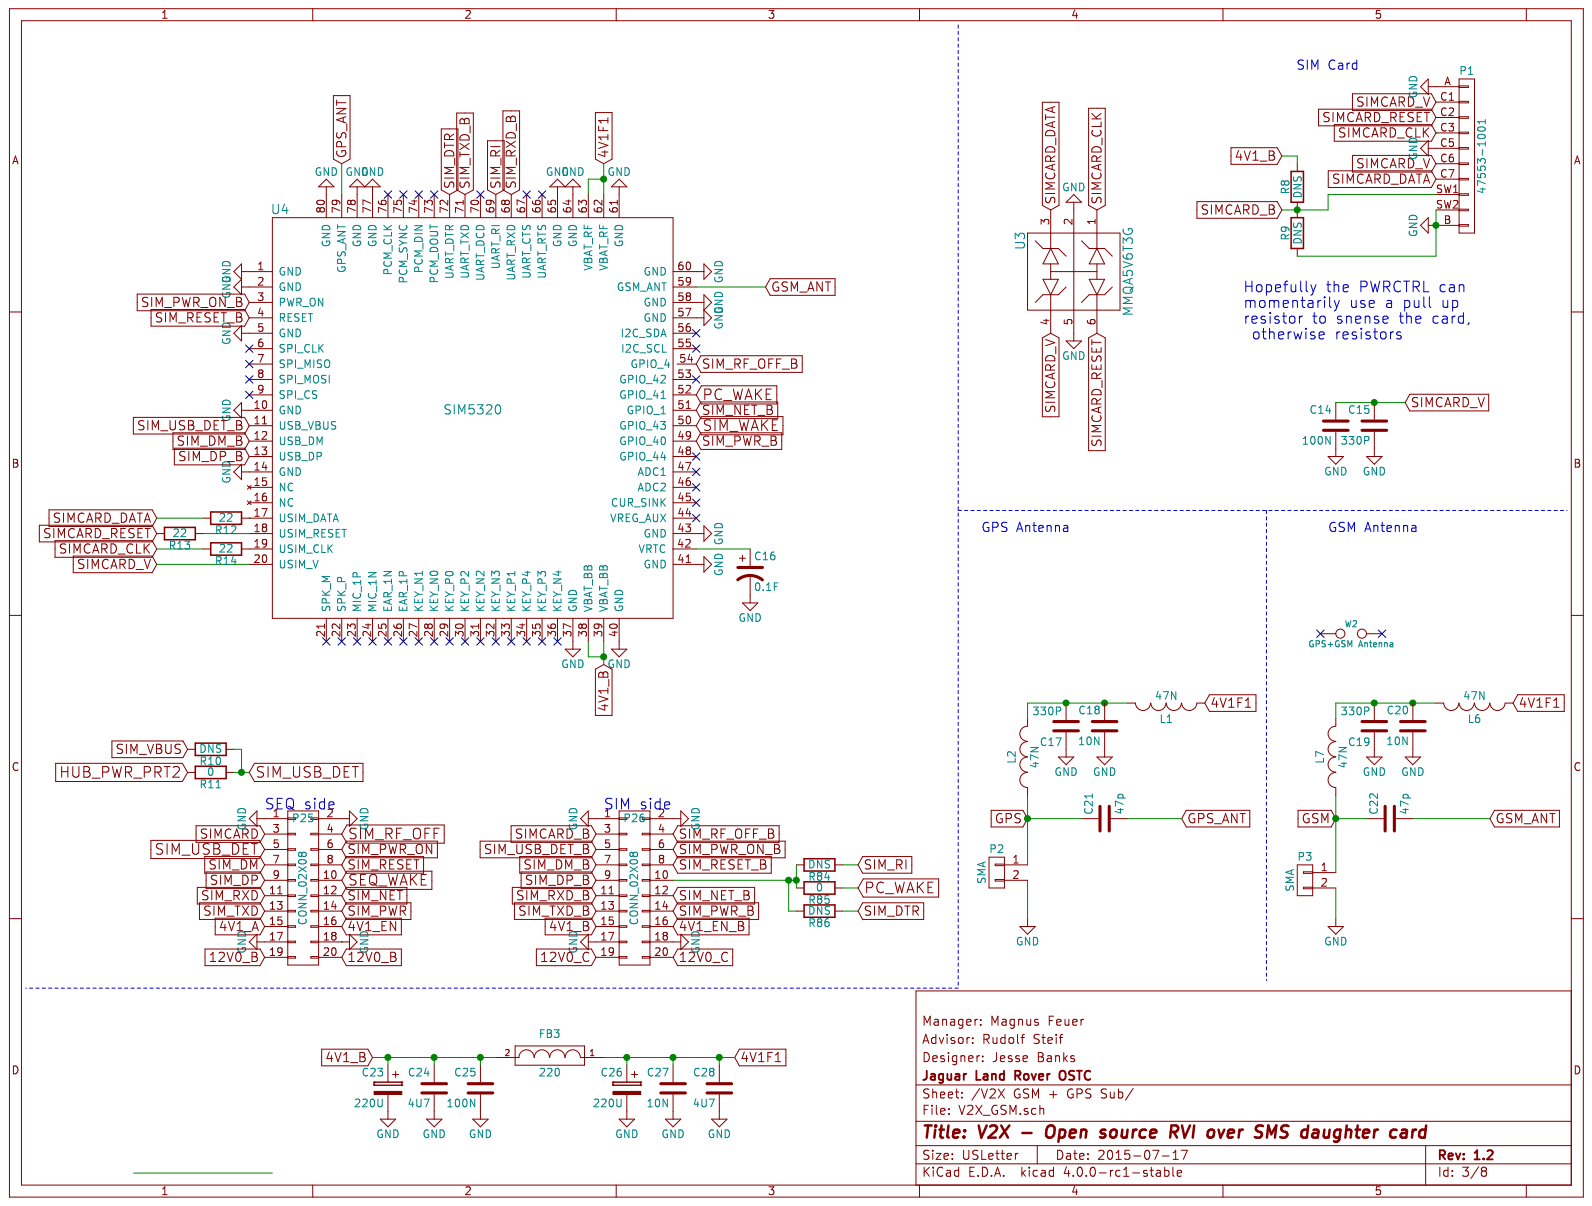
[picture p43: page 3]

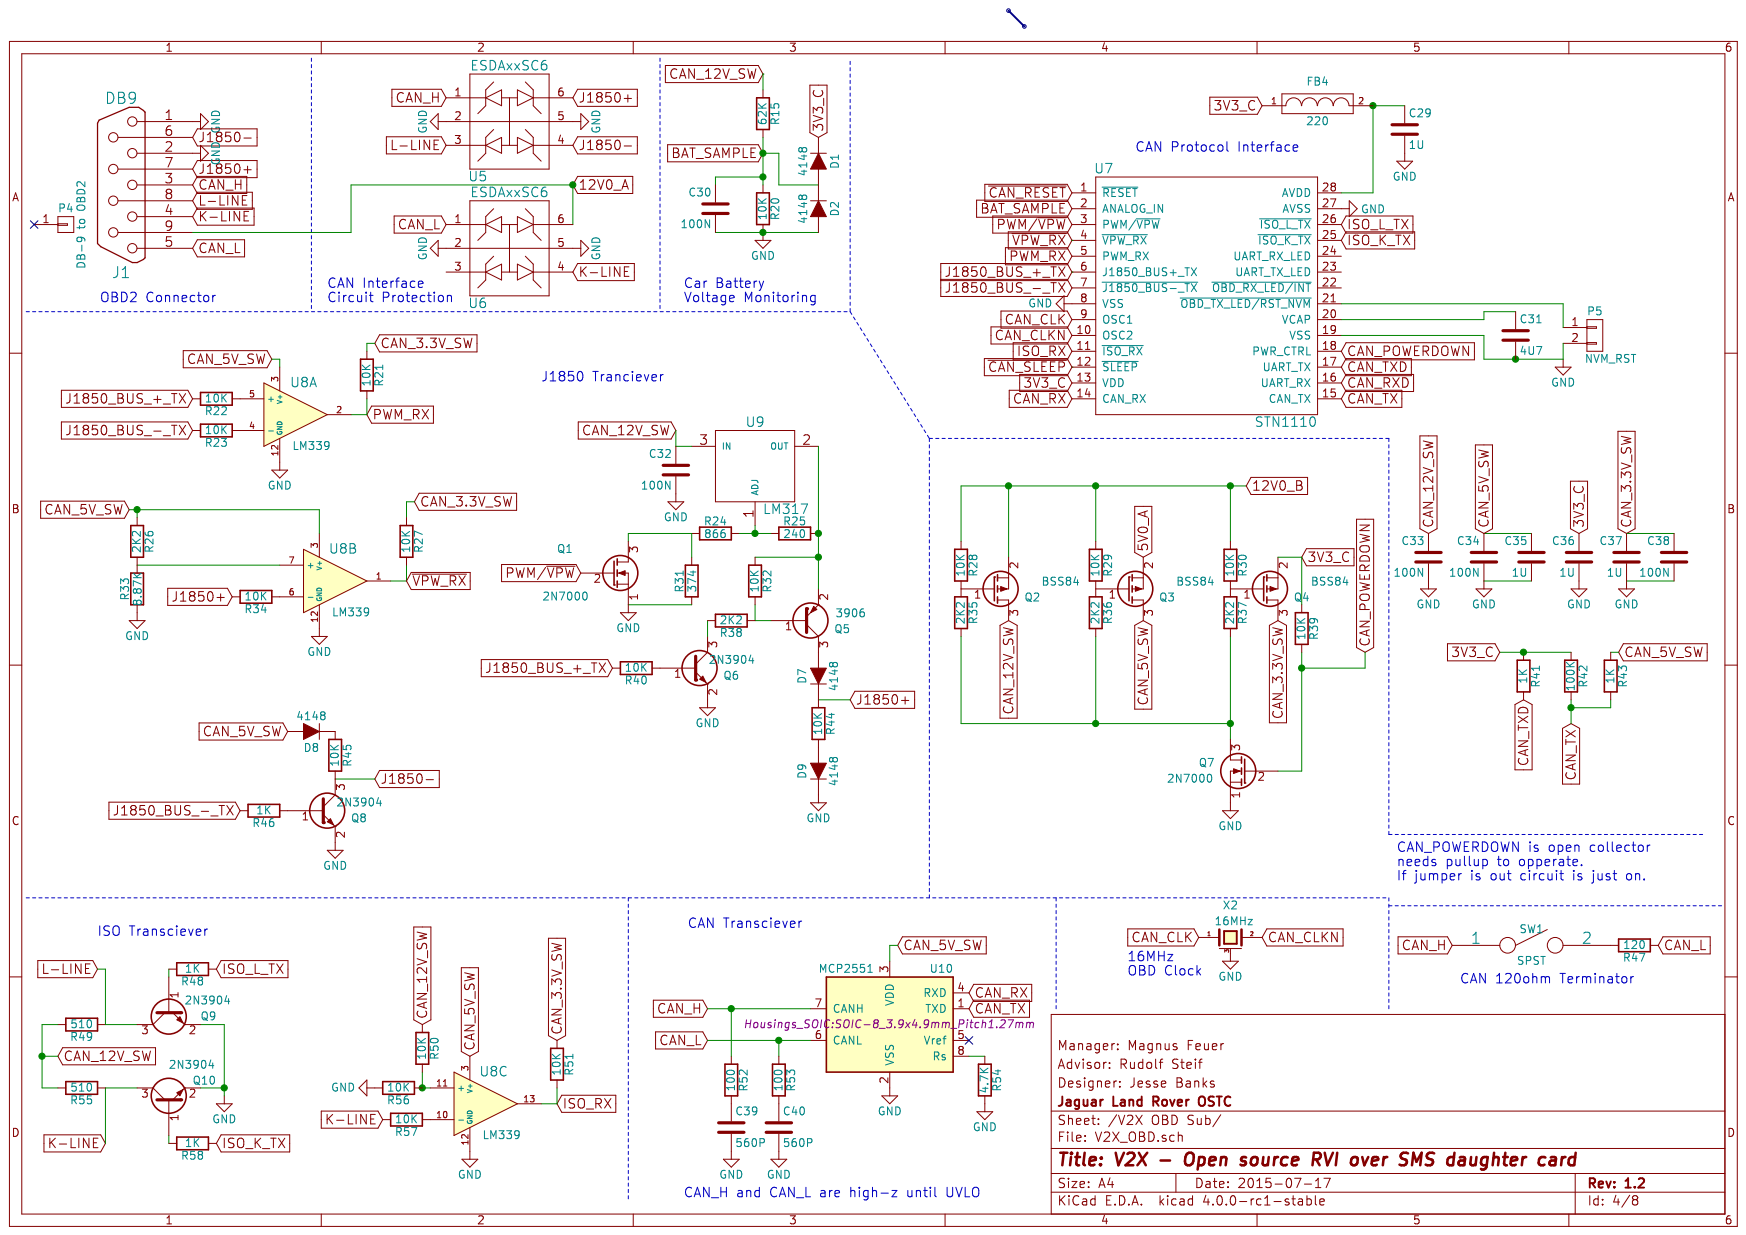
[picture p44: page 4]

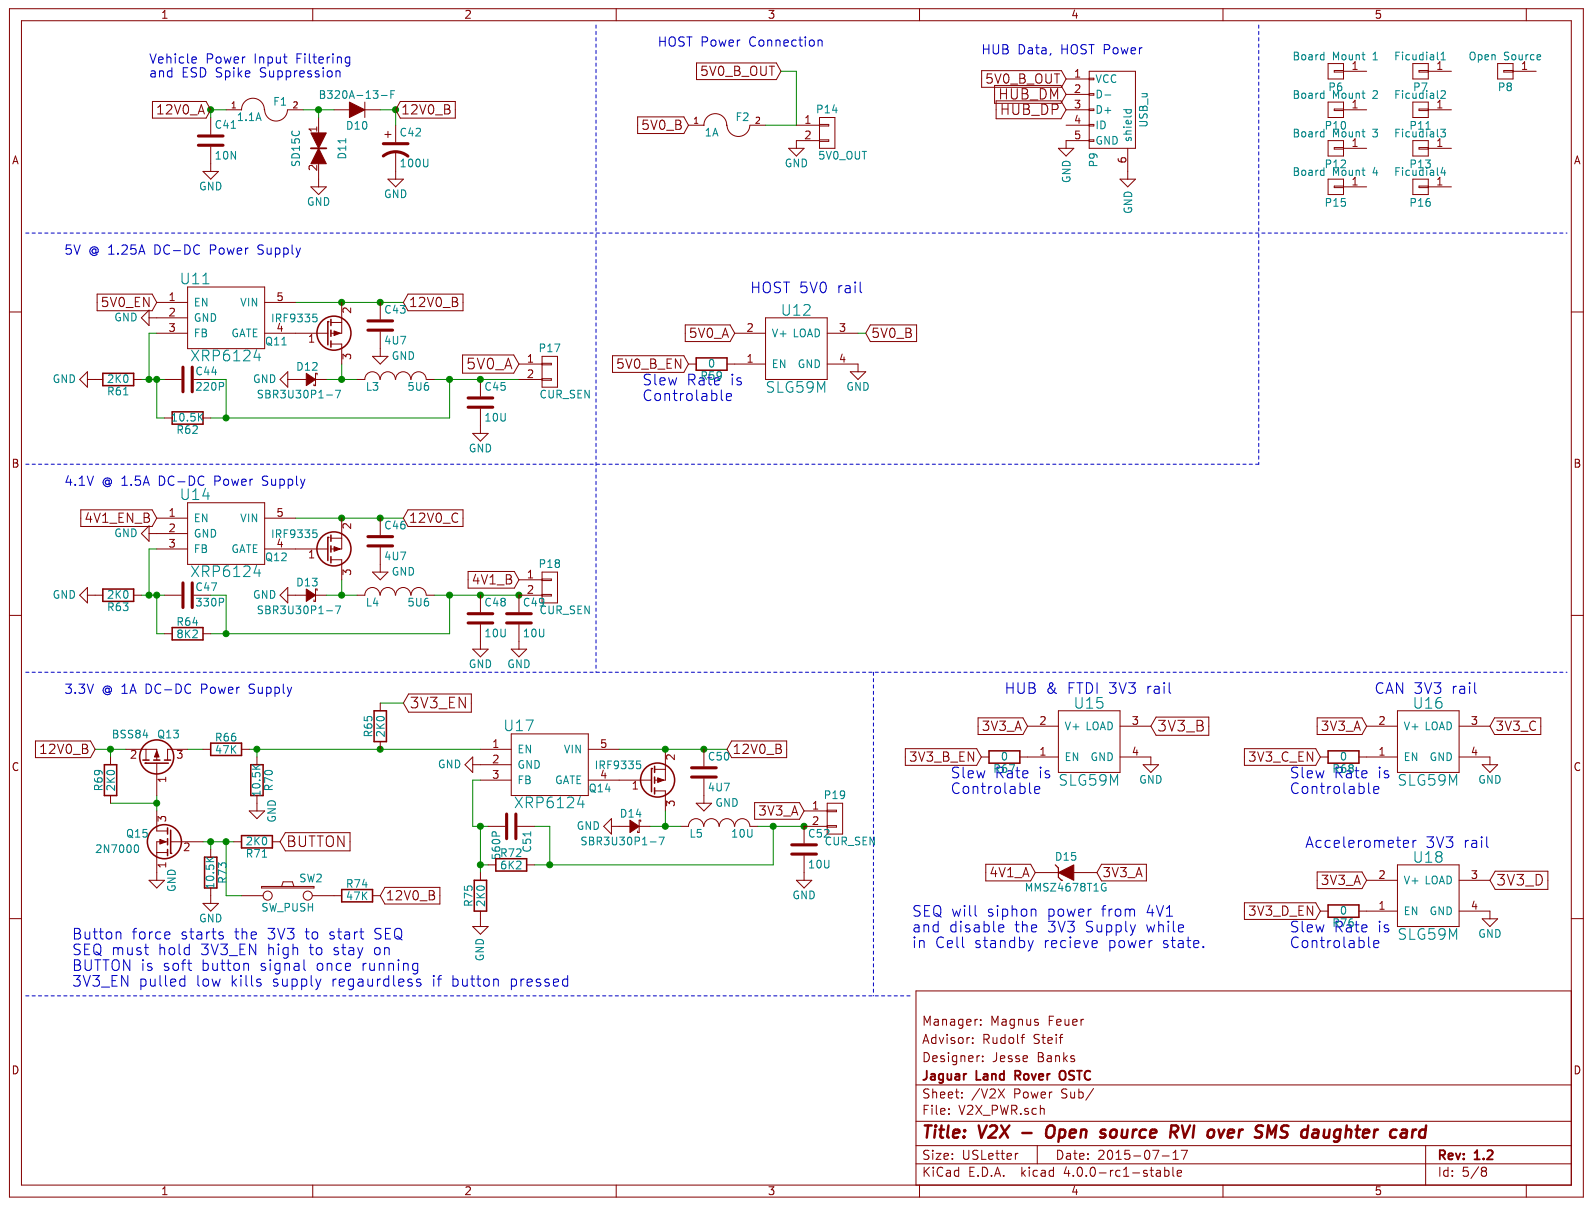
[picture p45: page 5]

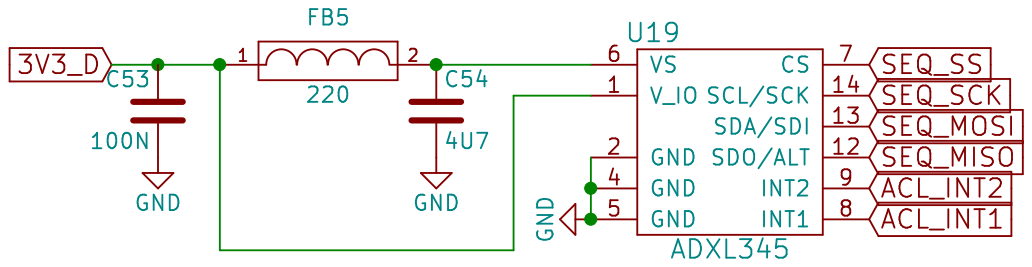
[picture p46: page 6]

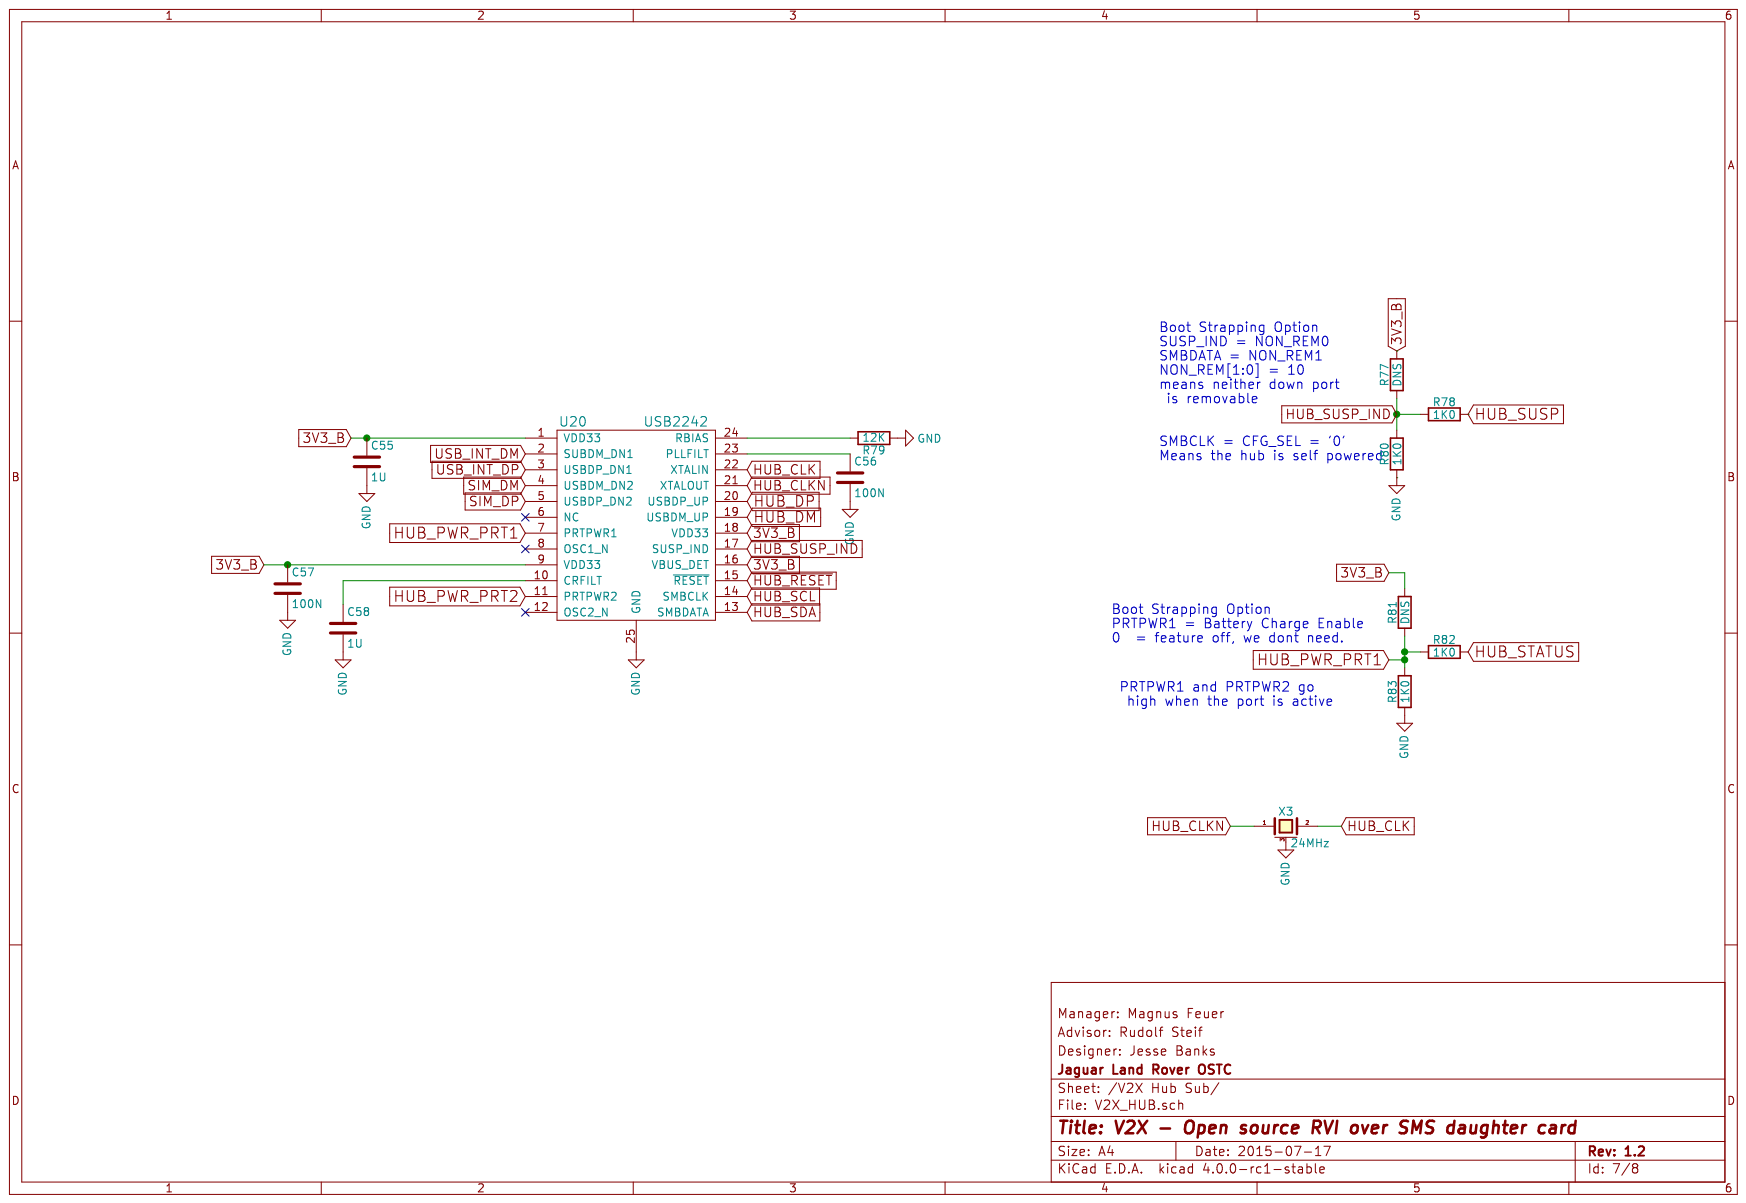
[picture p47: page 7]

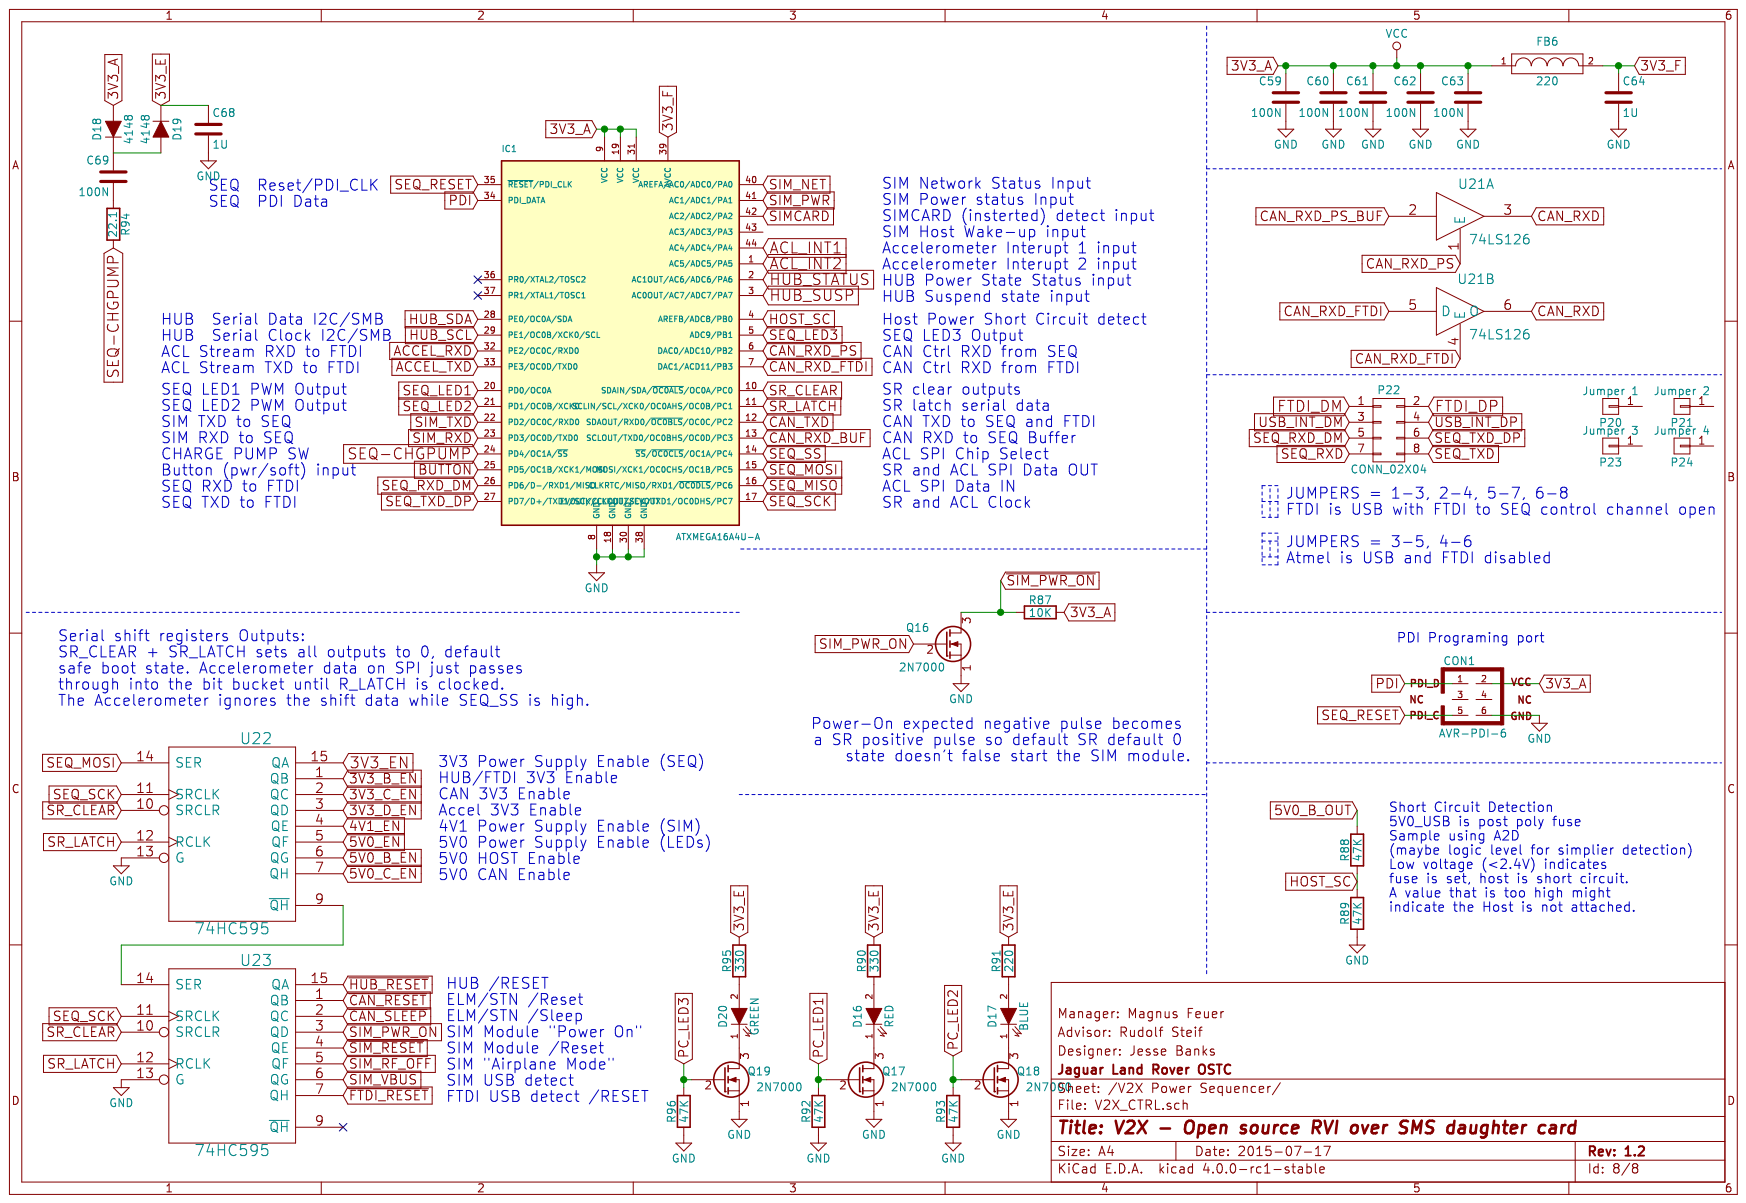
[picture p48: page 8]
