jbanks2/rvi_v2x_board/Hardware/Project Shares/V1.2/V2X V1.2 Schematic 092915.pdf

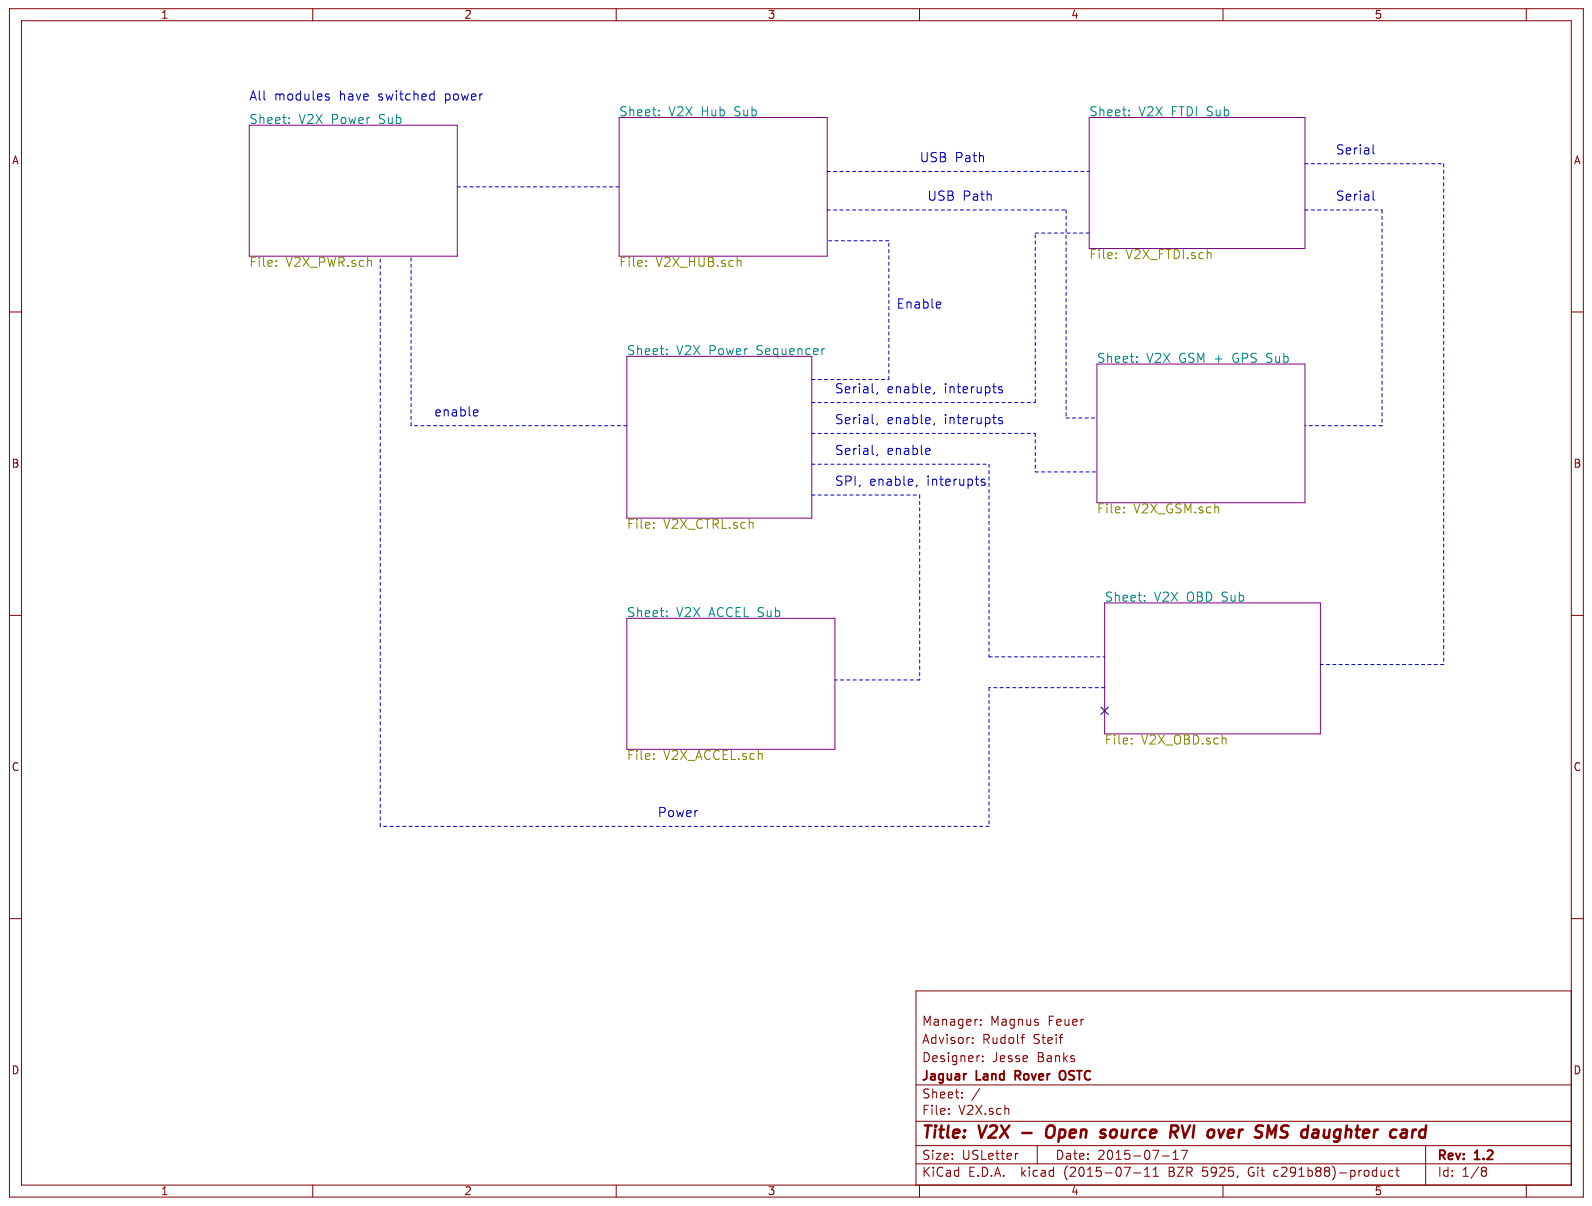
[picture p49: page 1]

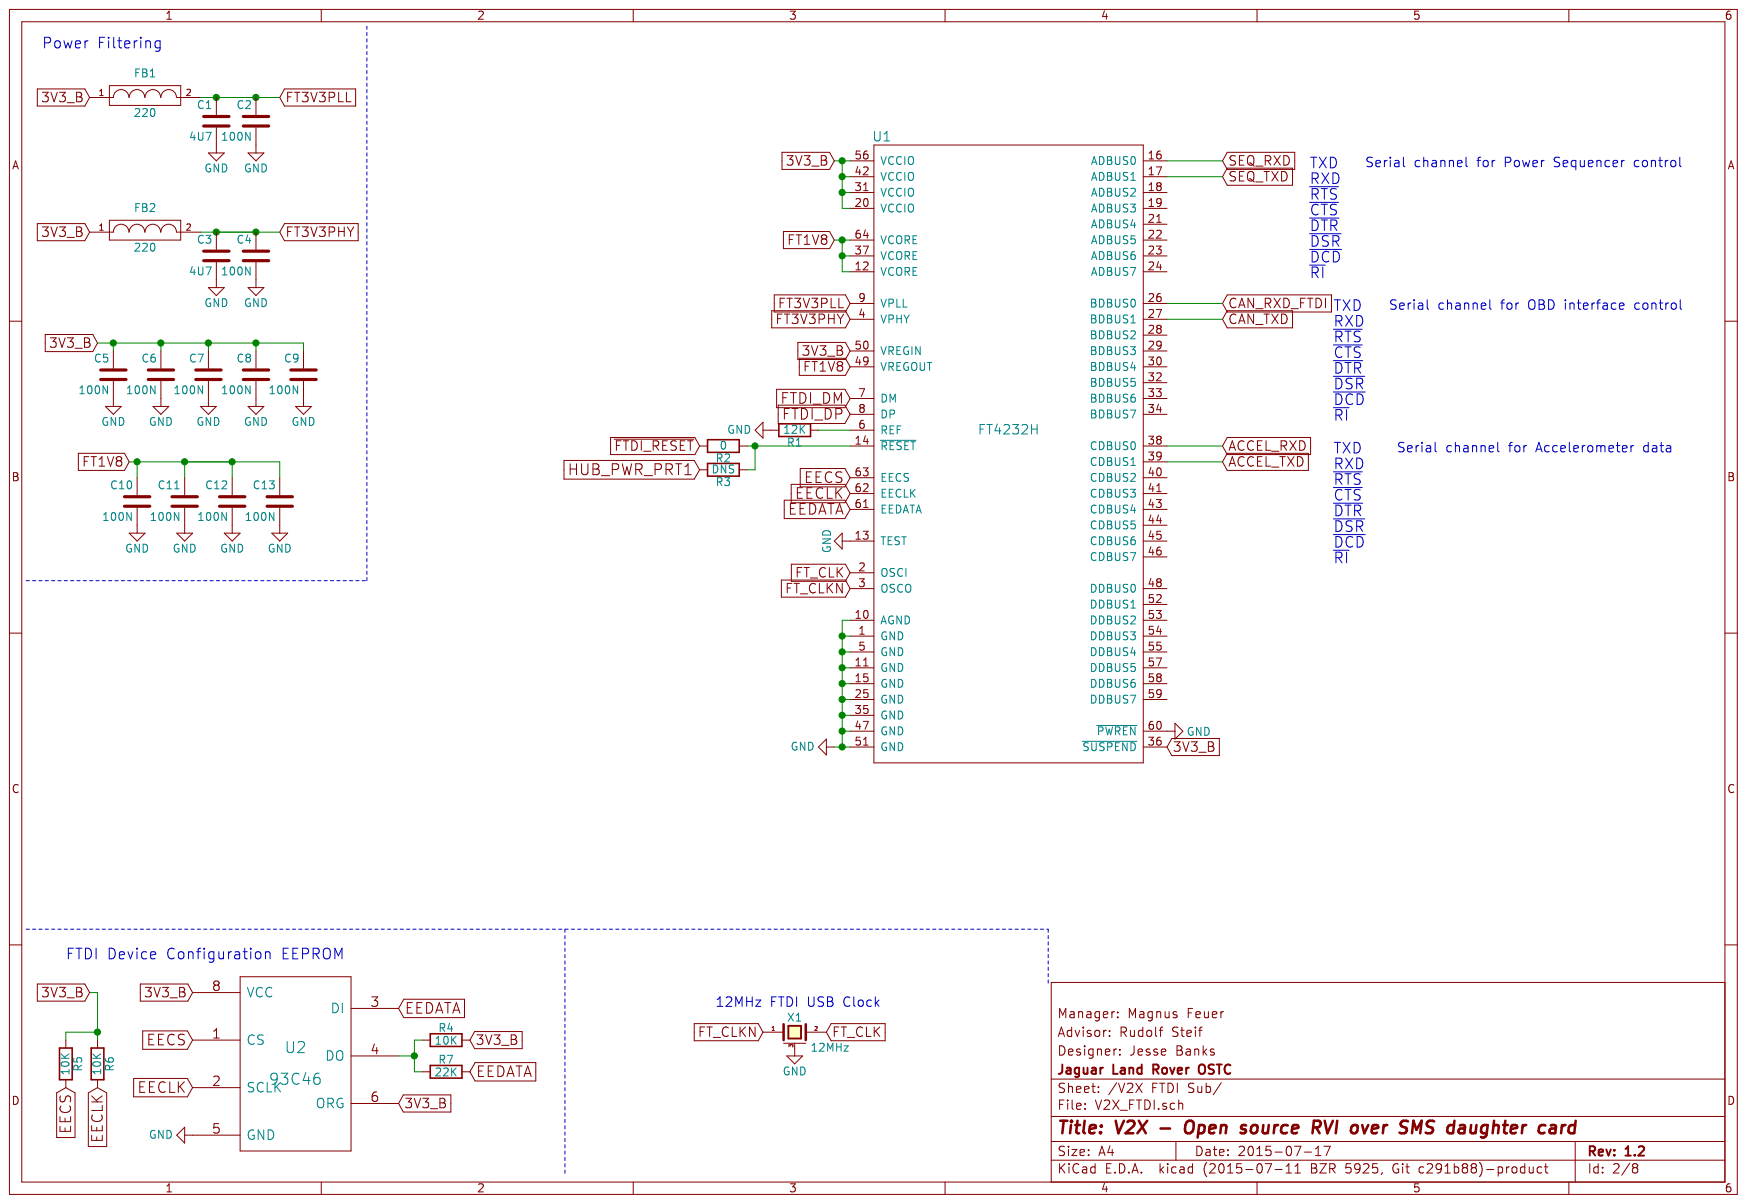
[picture p50: page 2]

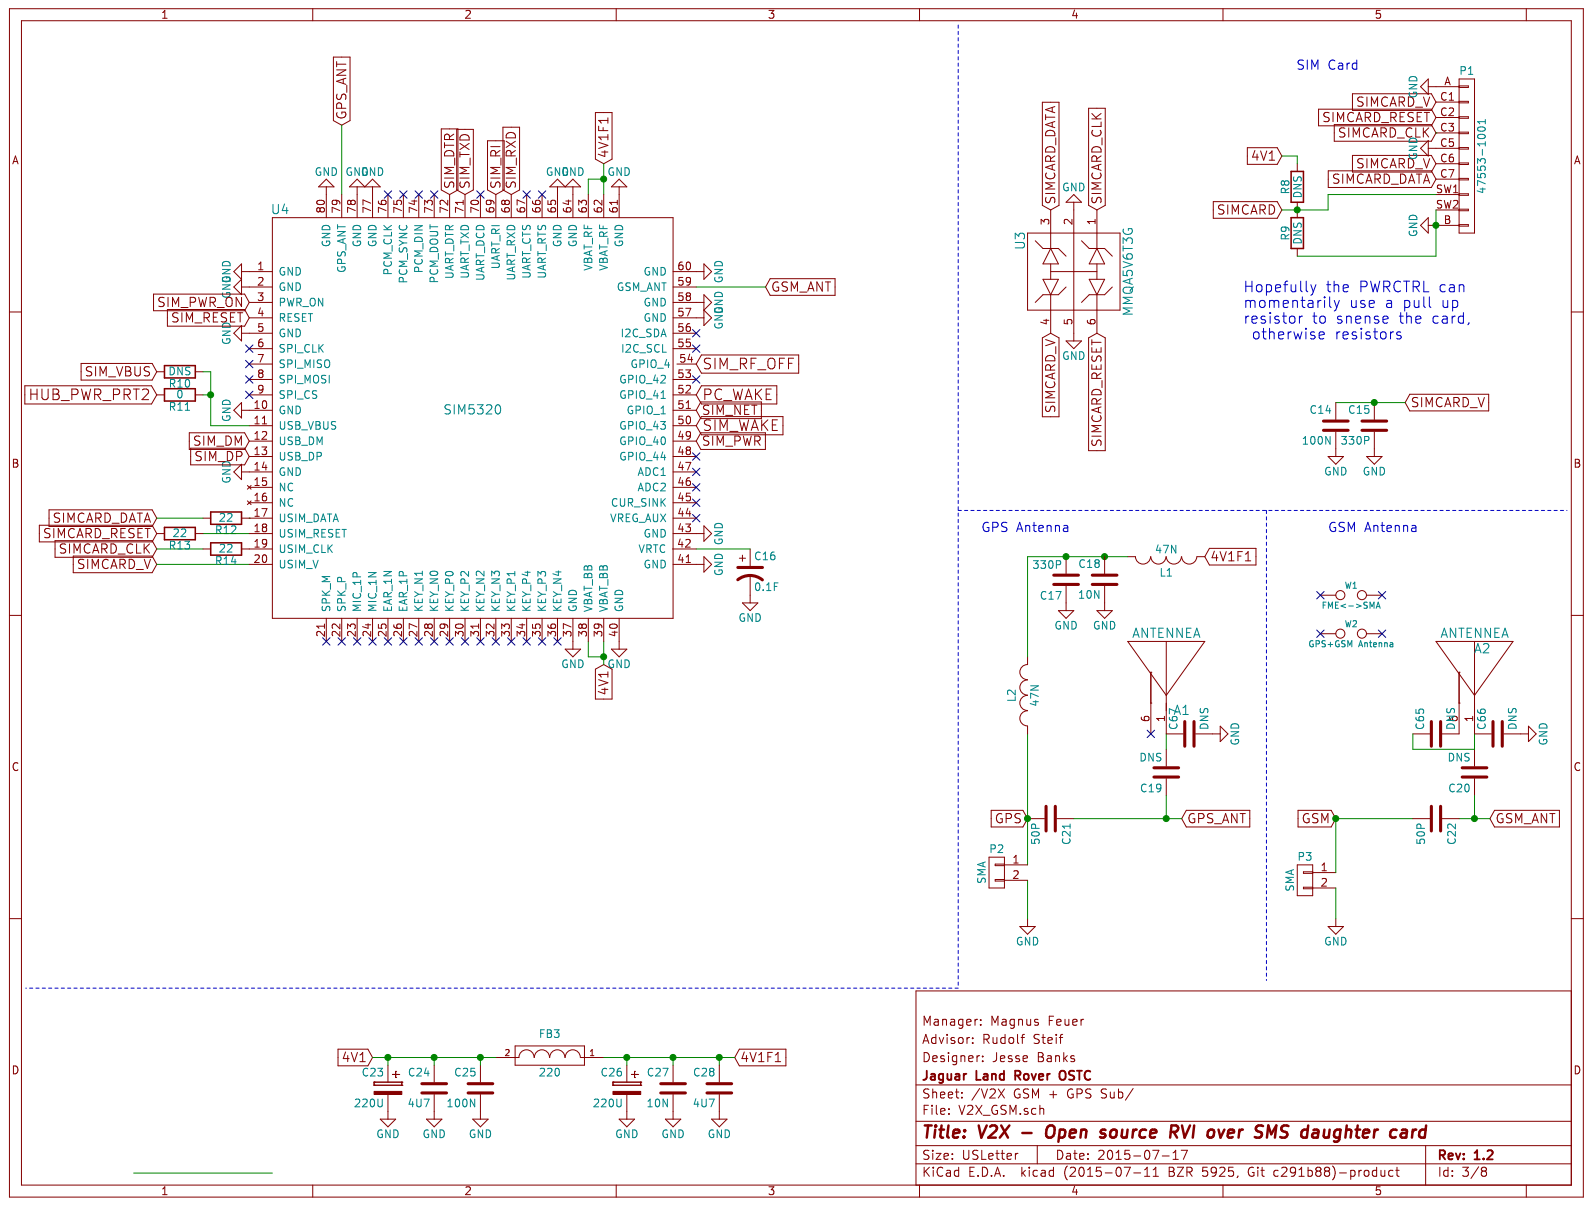
[picture p51: page 3]

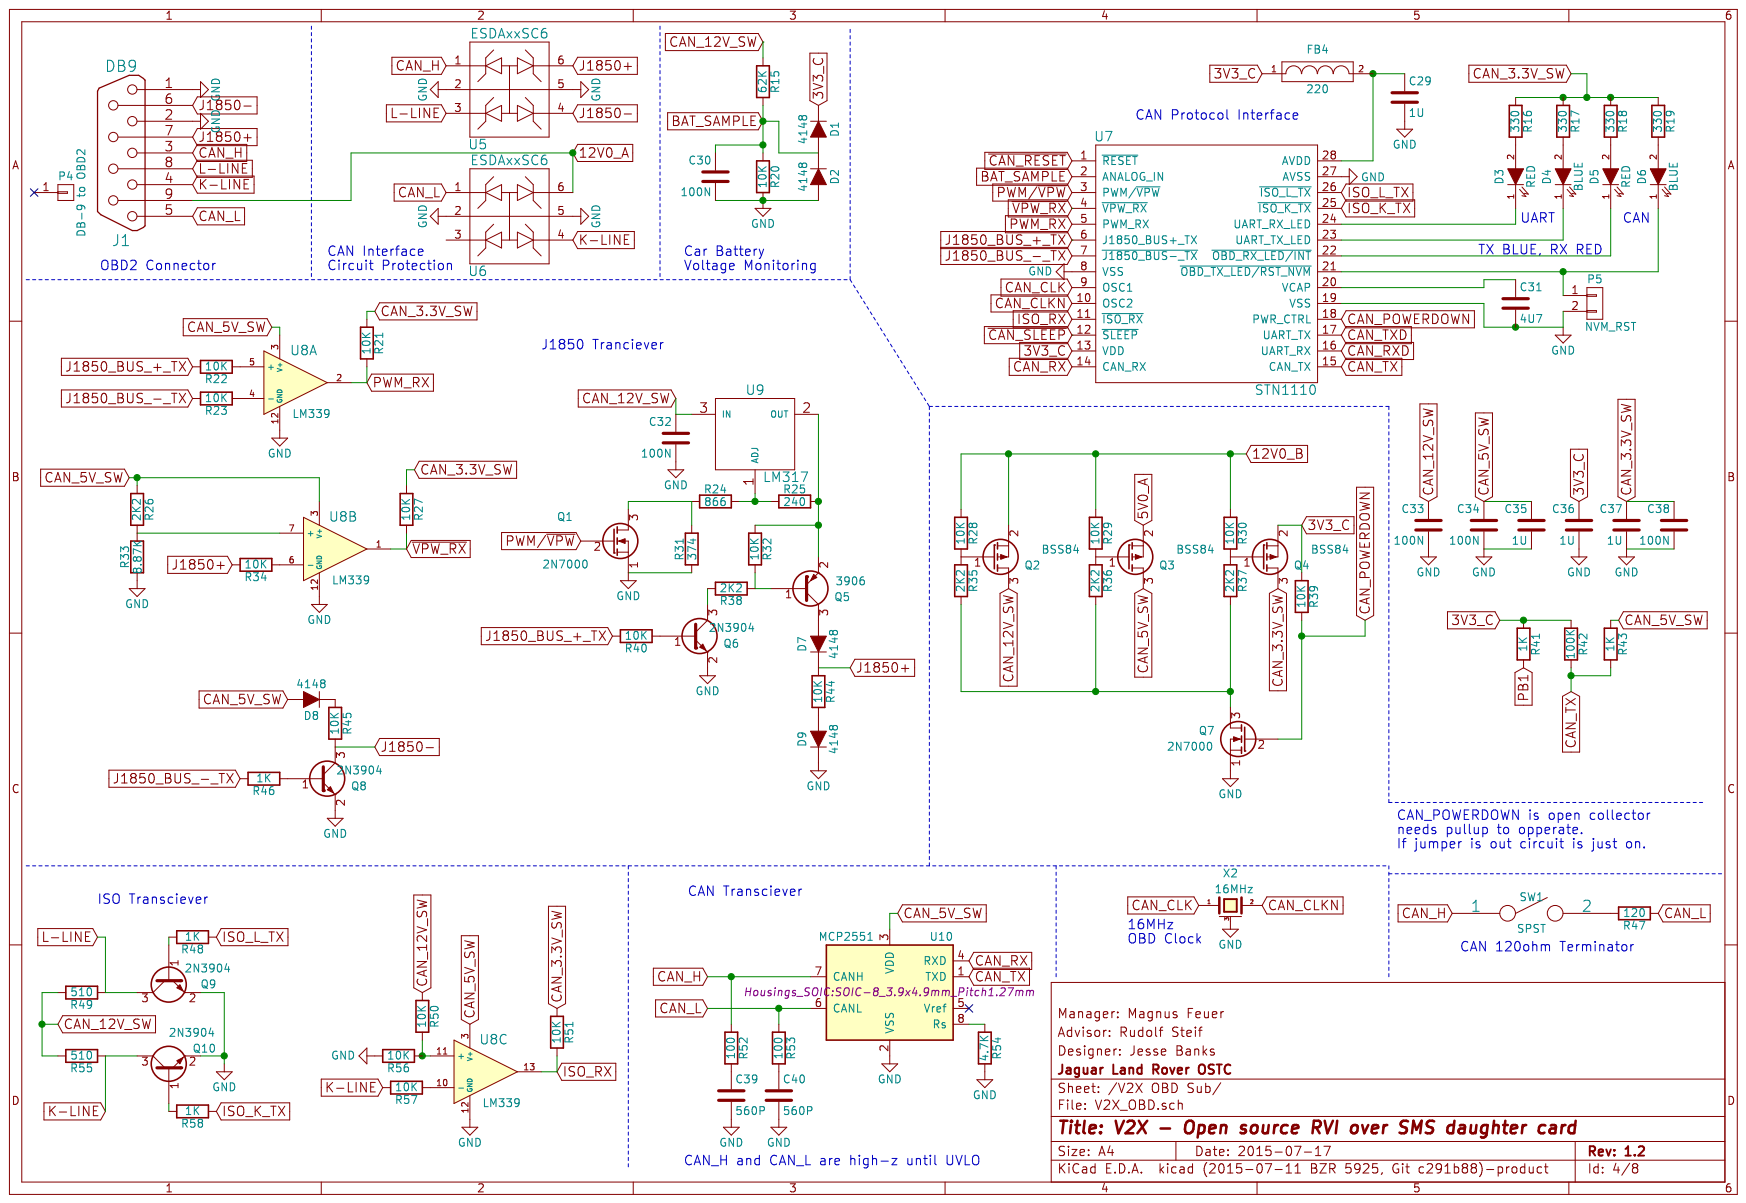
[picture p52: page 4]

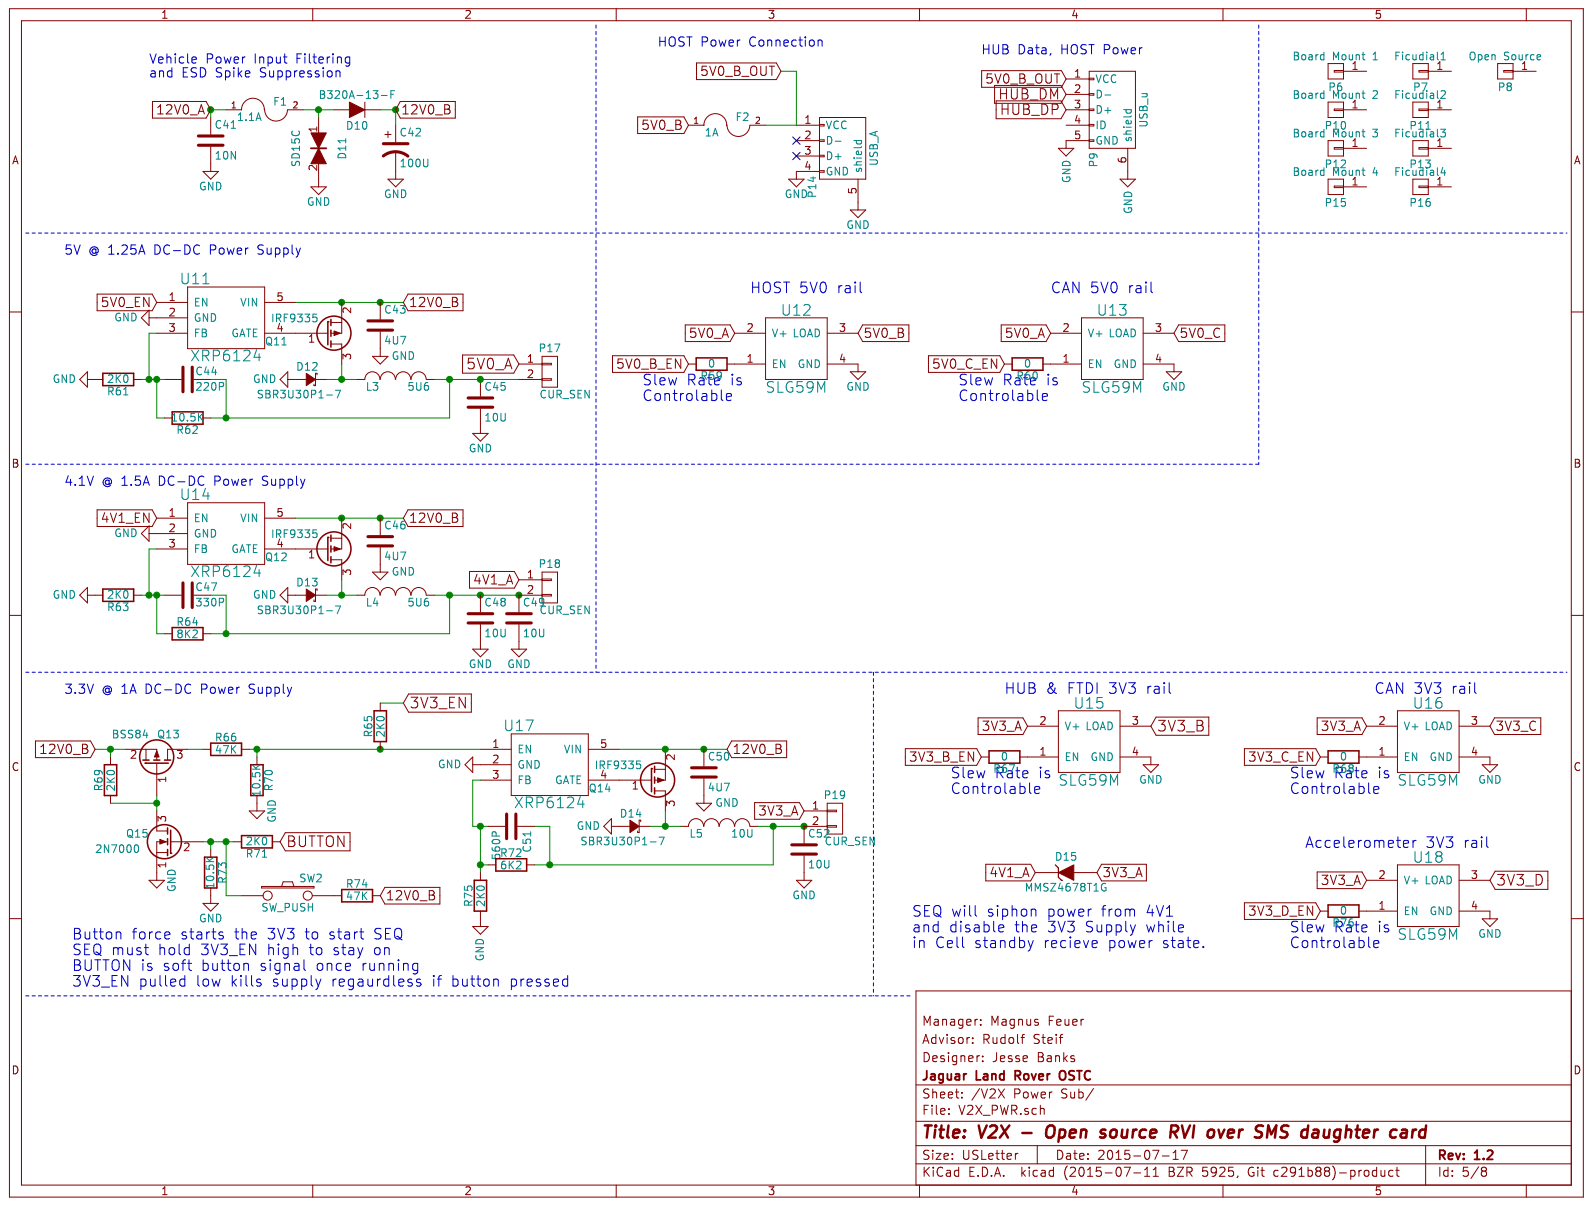
[picture p53: page 5]


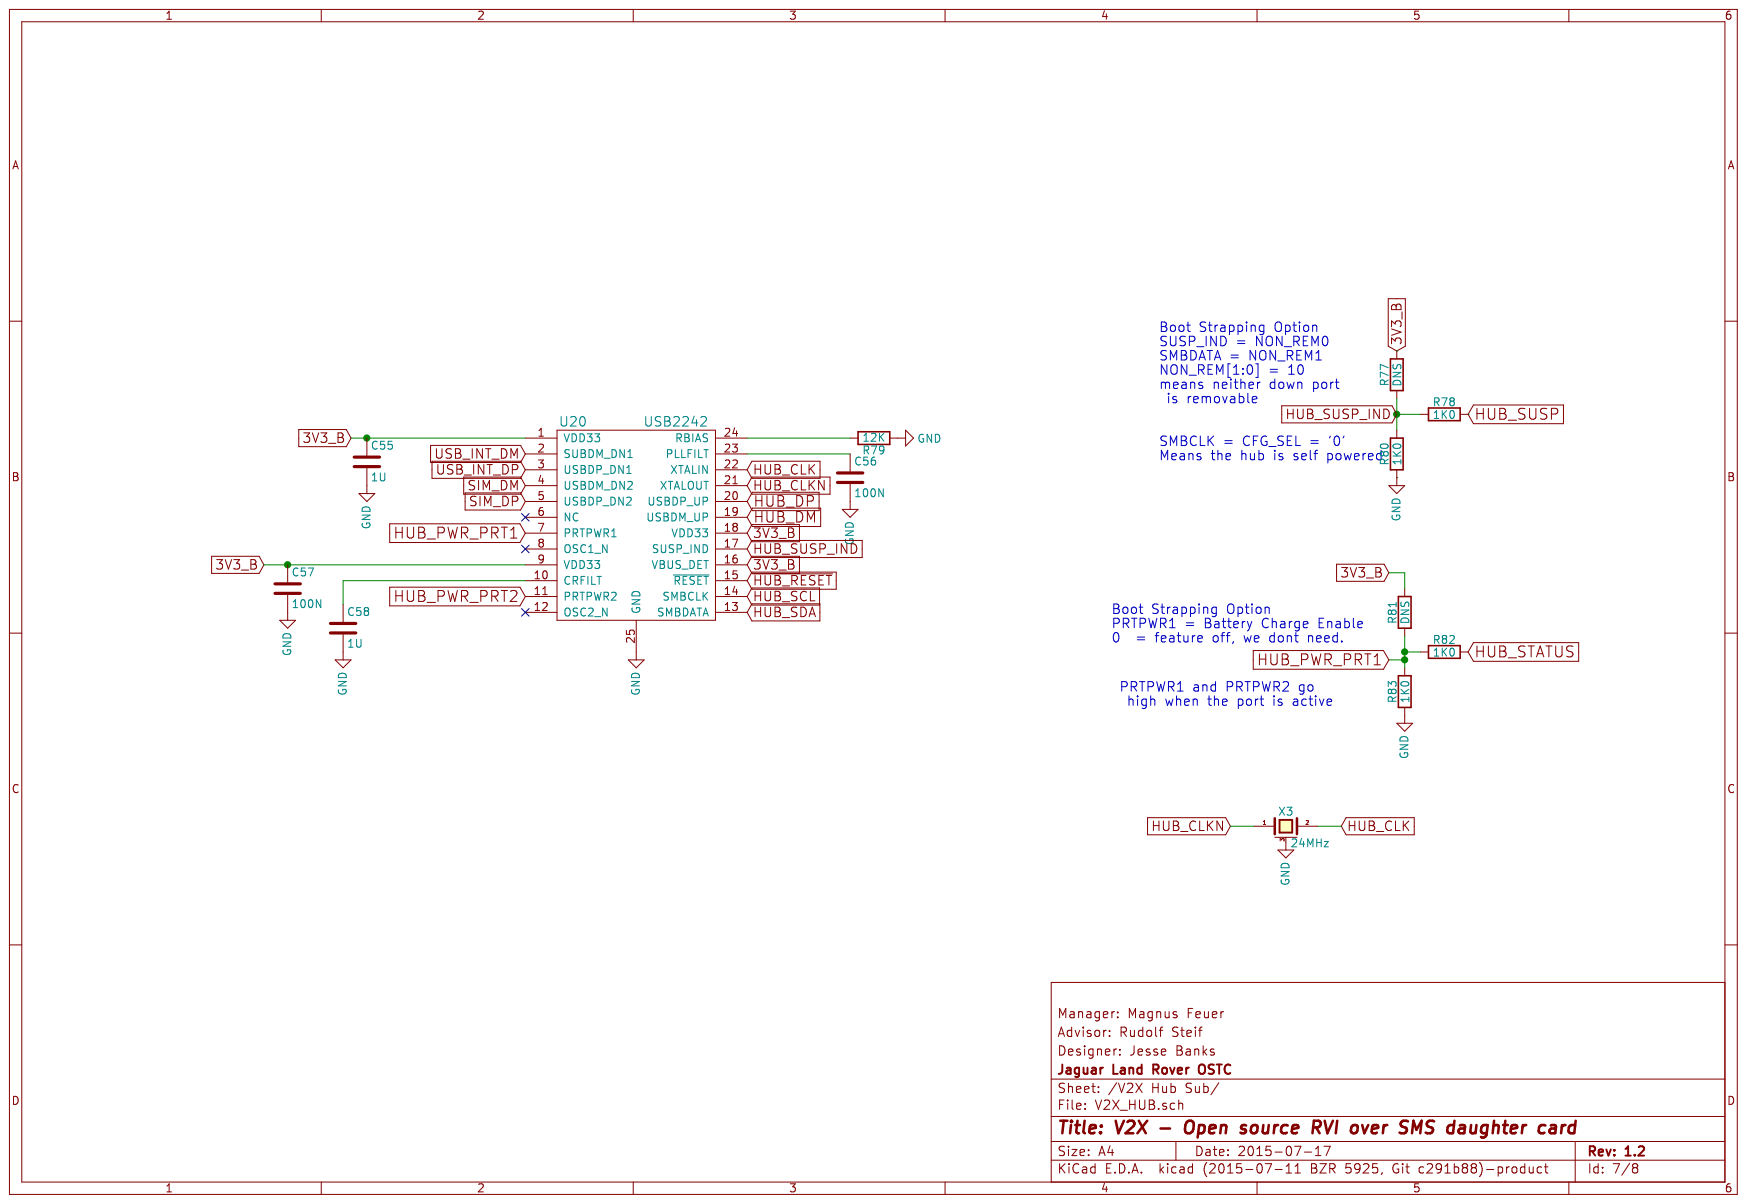
[picture p54: page 7]

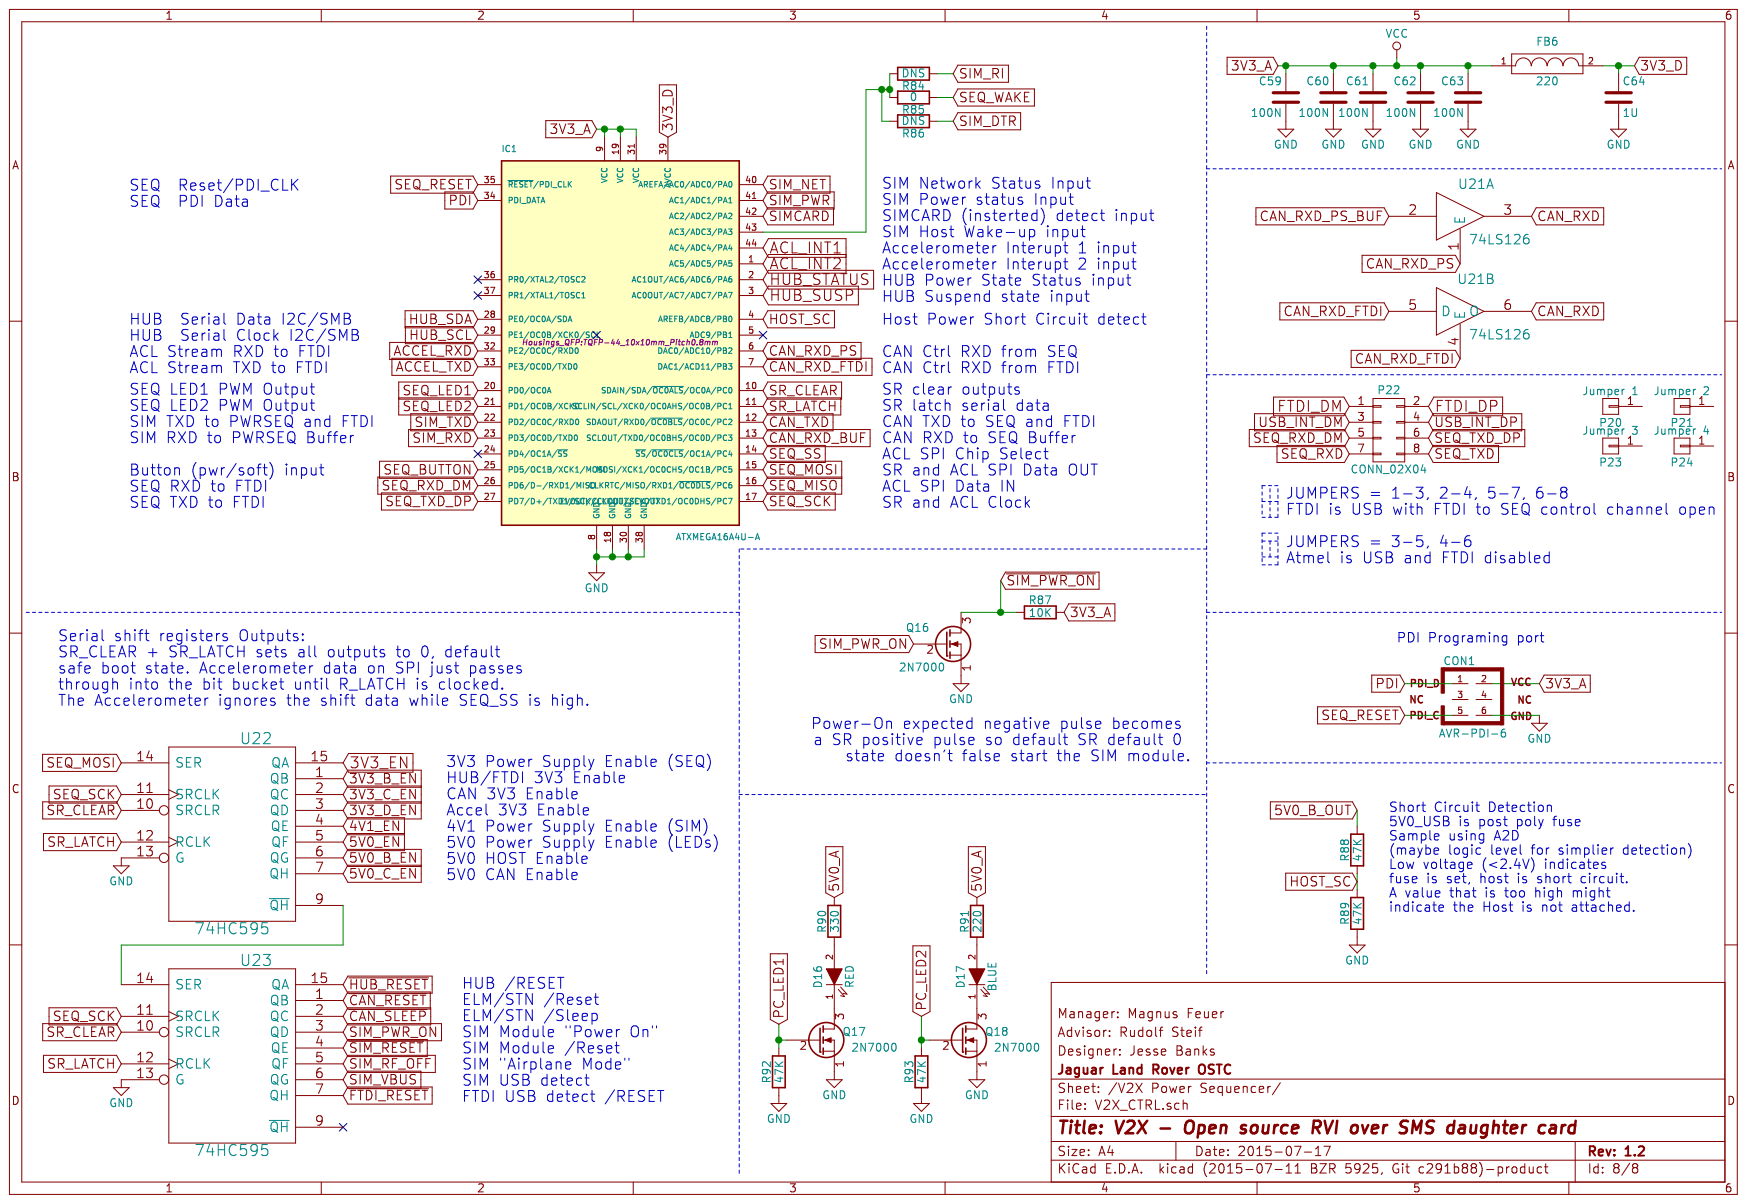
[picture p55: page 8]
