jbanks2/rvi_v2x_board/Hardware/Make Files/V1.3 Unfinished/GSM/V2X_GSM.kicad_pcb

## KiCad design Hardware/Make Files/V1.3 Unfinished/GSM/V2X_GSM.kicad_pcb (2015-12-23)

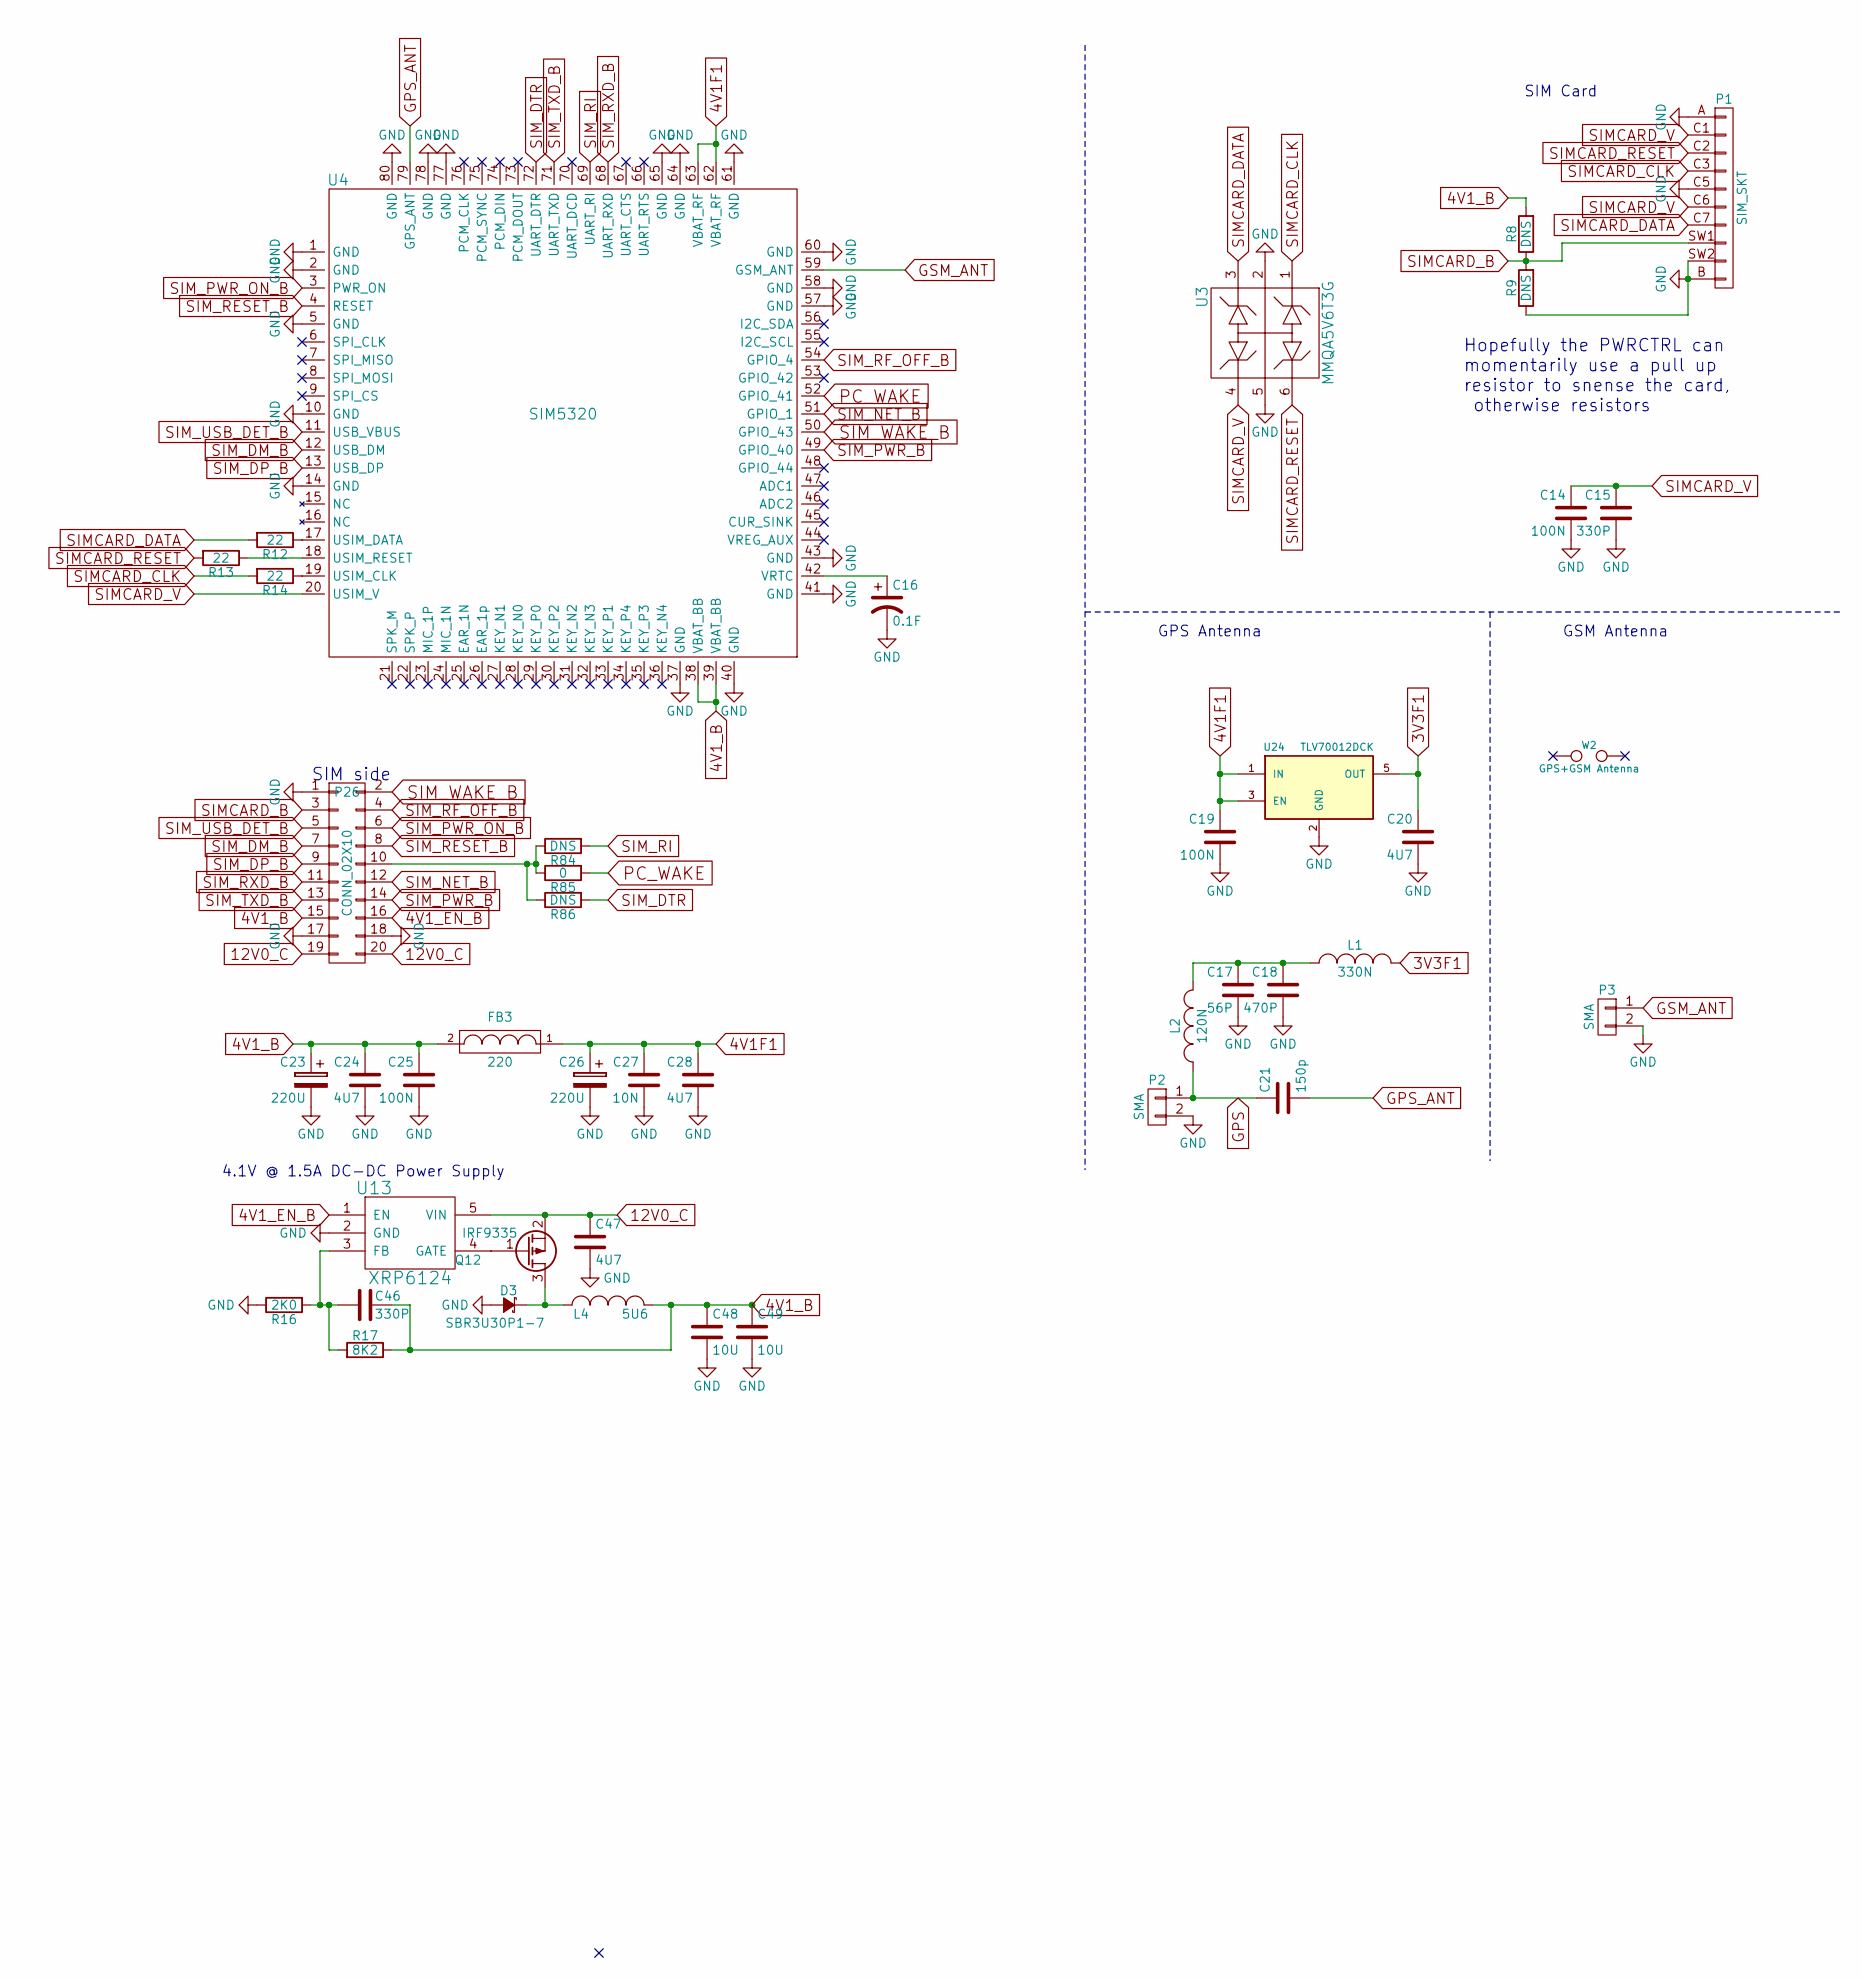
[picture p64: schematic V2X_GSM.sch, V2X - Open source RVI over SMS daughter card]

Parts:
C14, C19, C25: 100N; C_0603_SM
C15, C46: 330P; C_0603_SM
C16: 0.1F; C_Radial_D12.5_L25_P5; Mouser PN 504-KR-5R5C104-R
C17: 56P; C_0603_SM
C18: 470P; C_0603_SM
C20, C24, C28, C47: 4U7; C_0805_SM
C21: 150p; C_0603_SM
C23, C26: 220U; c_elec_6.3x5.8
C27: 10N; C_0603_SM
C48, C49: 10U; C_1206_SM
D3: SBR3U30P1-7; SOD-123
FB3: 220; R_0603_sm
L1: 330N; C_0603_SM
L2: 120N; C_0603_SM
L4: 5U6; 4.5x4.5mm_Ind
P1: SIM_SKT; 47553-1001
P2, P3: SMA; SMA-RA_142-0701-801
P26: CONN_02X10; FFC-1MMx20
Q12: IRF9335; SOIC-8_MOS
R8, R9, R84, R86: DNS; R_0603_sm
R12, R13, R14: 22; R_0603_sm
R16: 2K0; R_0603_sm
R17: 8K2; R_0603_sm
R85: 0; R_0603_sm
U3: MMQA5V6T3G; SOT-23-6
U4: SIM5320
U13: XRP6124; SOT-23-5
U24: TLV70012DCK; SOT-23-5
W2: GPS+GSM Antenna

Connections:
3V3F1: C20.1, L1.1, U24.5 (OUT)
4V1F1: C19.1, C26.1, C27.1, C28.1, FB3.1, U4.62 (VBAT_RF), U4.63 (VBAT_RF), U24.1 (IN), U24.3 (EN)
4V1_B: C23.1, C24.1, C25.1, C46.1, C48.1, C49.1, FB3.2, L4.2, P26.15, R8.2, R17.1, U4.38 (VBAT_BB), U4.39 (VBAT_BB)
4V1_EN_B: P26.16, U13.1 (EN)
12V0_C: C47.1, P26.19, P26.20, Q12.2 (S), U13.5 (VIN)
GND: C14.2, C15.2, C16.2, C17.2, C18.2, C19.2, C20.2, C23.2, C24.2, C25.2, C26.2, C27.2, C28.2, C47.2, C48.2, C49.2, D3.2 (A), P1.A, P1.B, P1.C5, P1.SW2, P2.2, P3.2, P26.1, P26.17, P26.18, R9.1, R16.1, U3.2 (K), U3.5 (K2), U4.1 (GND), U4.2 (GND), U4.5 (GND), U4.10 (GND), U4.14 (GND), U4.37 (GND), U4.40 (GND), U4.41 (GND), U4.43 (GND), U4.57 (GND), U4.58 (GND), U4.60 (GND), U4.61 (GND), U4.64 (GND), U4.65 (GND), U4.77 (GND), U4.78 (GND), U4.80 (GND), U13.2 (GND), U24.2 (GND)
GPS: C21.1, L2.1, P2.1
GPS_ANT: C21.2, U4.79 (GPS_ANT)
GSM_ANT: P3.1, U4.59 (GSM_ANT)
unnamed: C16.1, U4.42 (VRTC)
unnamed: C17.1, C18.1, L1.2, L2.2
unnamed: C46.2, R16.2, R17.2, U13.3 (FB)
unnamed: D3.1 (K), L4.1, Q12.3 (D)
unnamed: P26.10, R84.1, R85.1, R86.1
unnamed: Q12.1 (G), U13.4 (GATE)
unnamed: R12.1, U4.17 (USIM_DATA)
unnamed: R13.1, U4.18 (USIM_RESET)
unnamed: R14.1, U4.19 (USIM_CLK)
PC_WAKE: R85.2, U4.52 (GPIO_41)
SIMCARD_B: P1.SW1, P26.3, R8.1, R9.2
SIMCARD_CLK: P1.C3, R14.2, U3.1 (A1)
SIMCARD_DATA: P1.C7, R12.2, U3.3 (A2)
SIMCARD_RESET: P1.C2, R13.2, U3.6 (A4)
SIMCARD_V: C14.1, C15.1, P1.C1, P1.C6, U3.4 (A4), U4.20 (USIM_V)
SIM_DM_B: P26.7, U4.12 (USB_DM)
SIM_DP_B: P26.9, U4.13 (USB_DP)
SIM_DTR: R86.2, U4.72 (UART_DTR)
SIM_NET_B: P26.12, U4.51 (GPIO_1)
SIM_PWR_B: P26.14, U4.49 (GPIO_40)
SIM_PWR_ON_B: P26.6, U4.3 (PWR_ON)
SIM_RESET_B: P26.8, U4.4 (RESET)
SIM_RF_OFF_B: P26.4, U4.54 (GPIO_4)
SIM_RI: R84.2, U4.69 (UART_RI)
SIM_RXD_B: P26.11, U4.68 (UART_RXD)
SIM_TXD_B: P26.13, U4.71 (UART_TXD)
SIM_USB_DET_B: P26.5, U4.11 (USB_VBUS)
SIM_WAKE_B: P26.2, U4.50 (GPIO_43)

Notes on the sheet:
SIM Card
GPS Antenna
GSM Antenna
Hopefully the PWRCTRL can momentarily use a pull up resistor to snense the card, otherwise resistors
SIM side
4.1V @ 1.5A DC-DC Power Supply

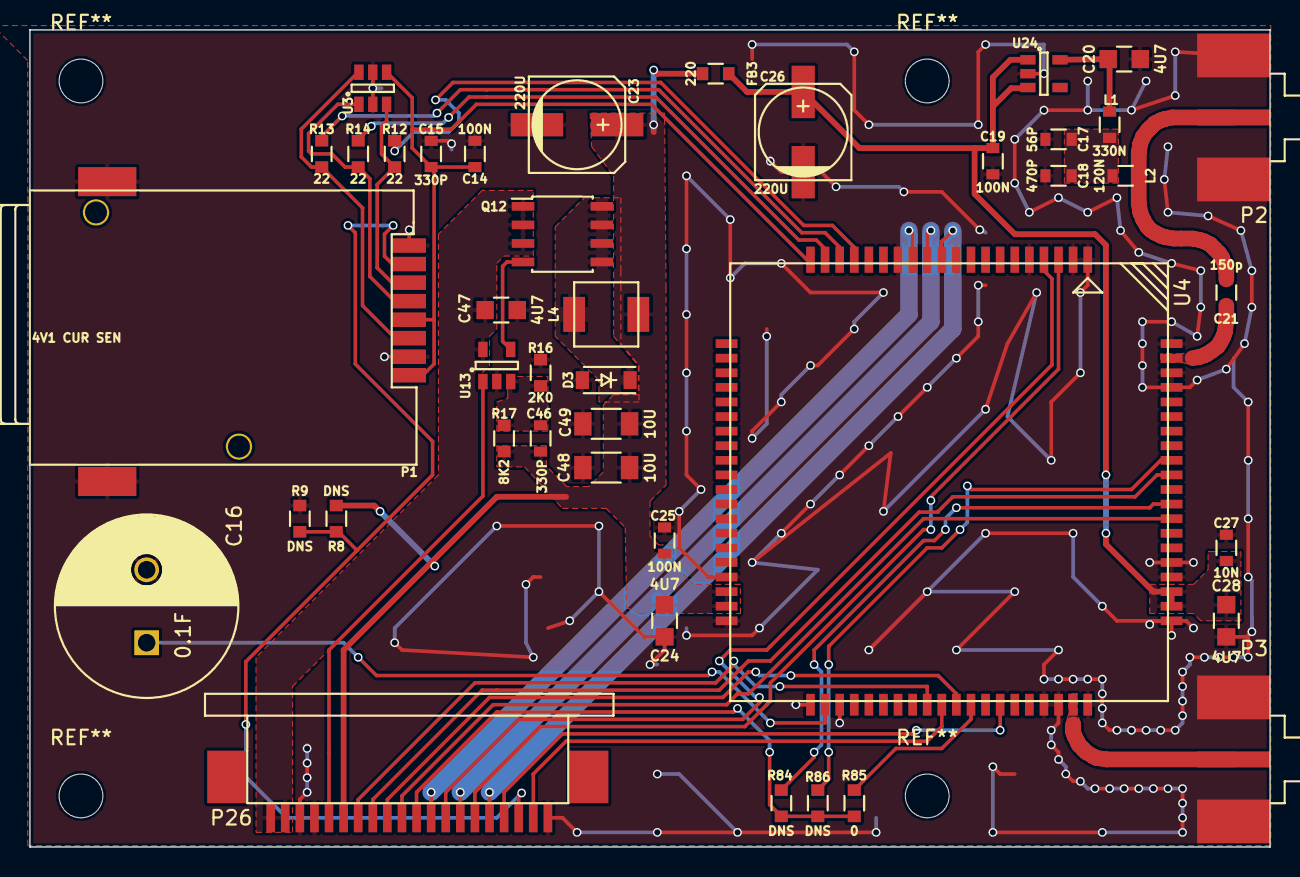
[picture p65: board V2X_GSM.kicad_pcb from above]

Board: 2 copper layers, 85.0 x 56.0 mm, 42 parts (0 on the bottom side), 37 nets.
