jbanks2/rvi_v2x_board/Hardware/Make Files/V2 Ready for Order/V2X.kicad_pcb

## KiCad design Hardware/Make Files/V2 Ready for Order/V2X.kicad_pcb (2016-01-29)

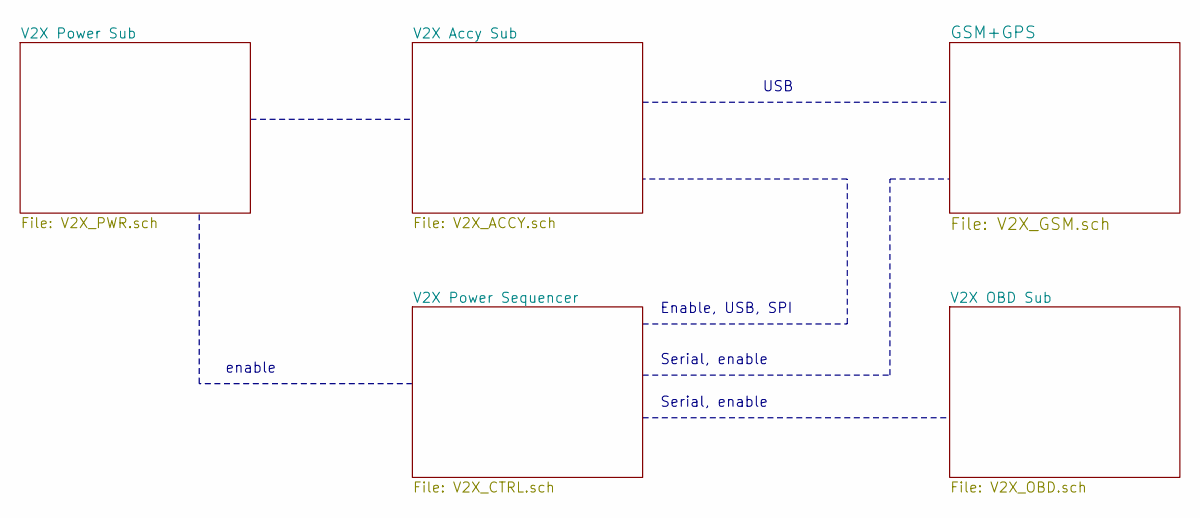
[picture p66: schematic V2X.sch, V2X - Open source RVI over SMS daughter card]

Notes on the sheet:
Enable, USB, SPI
USB
Serial, enable
enable

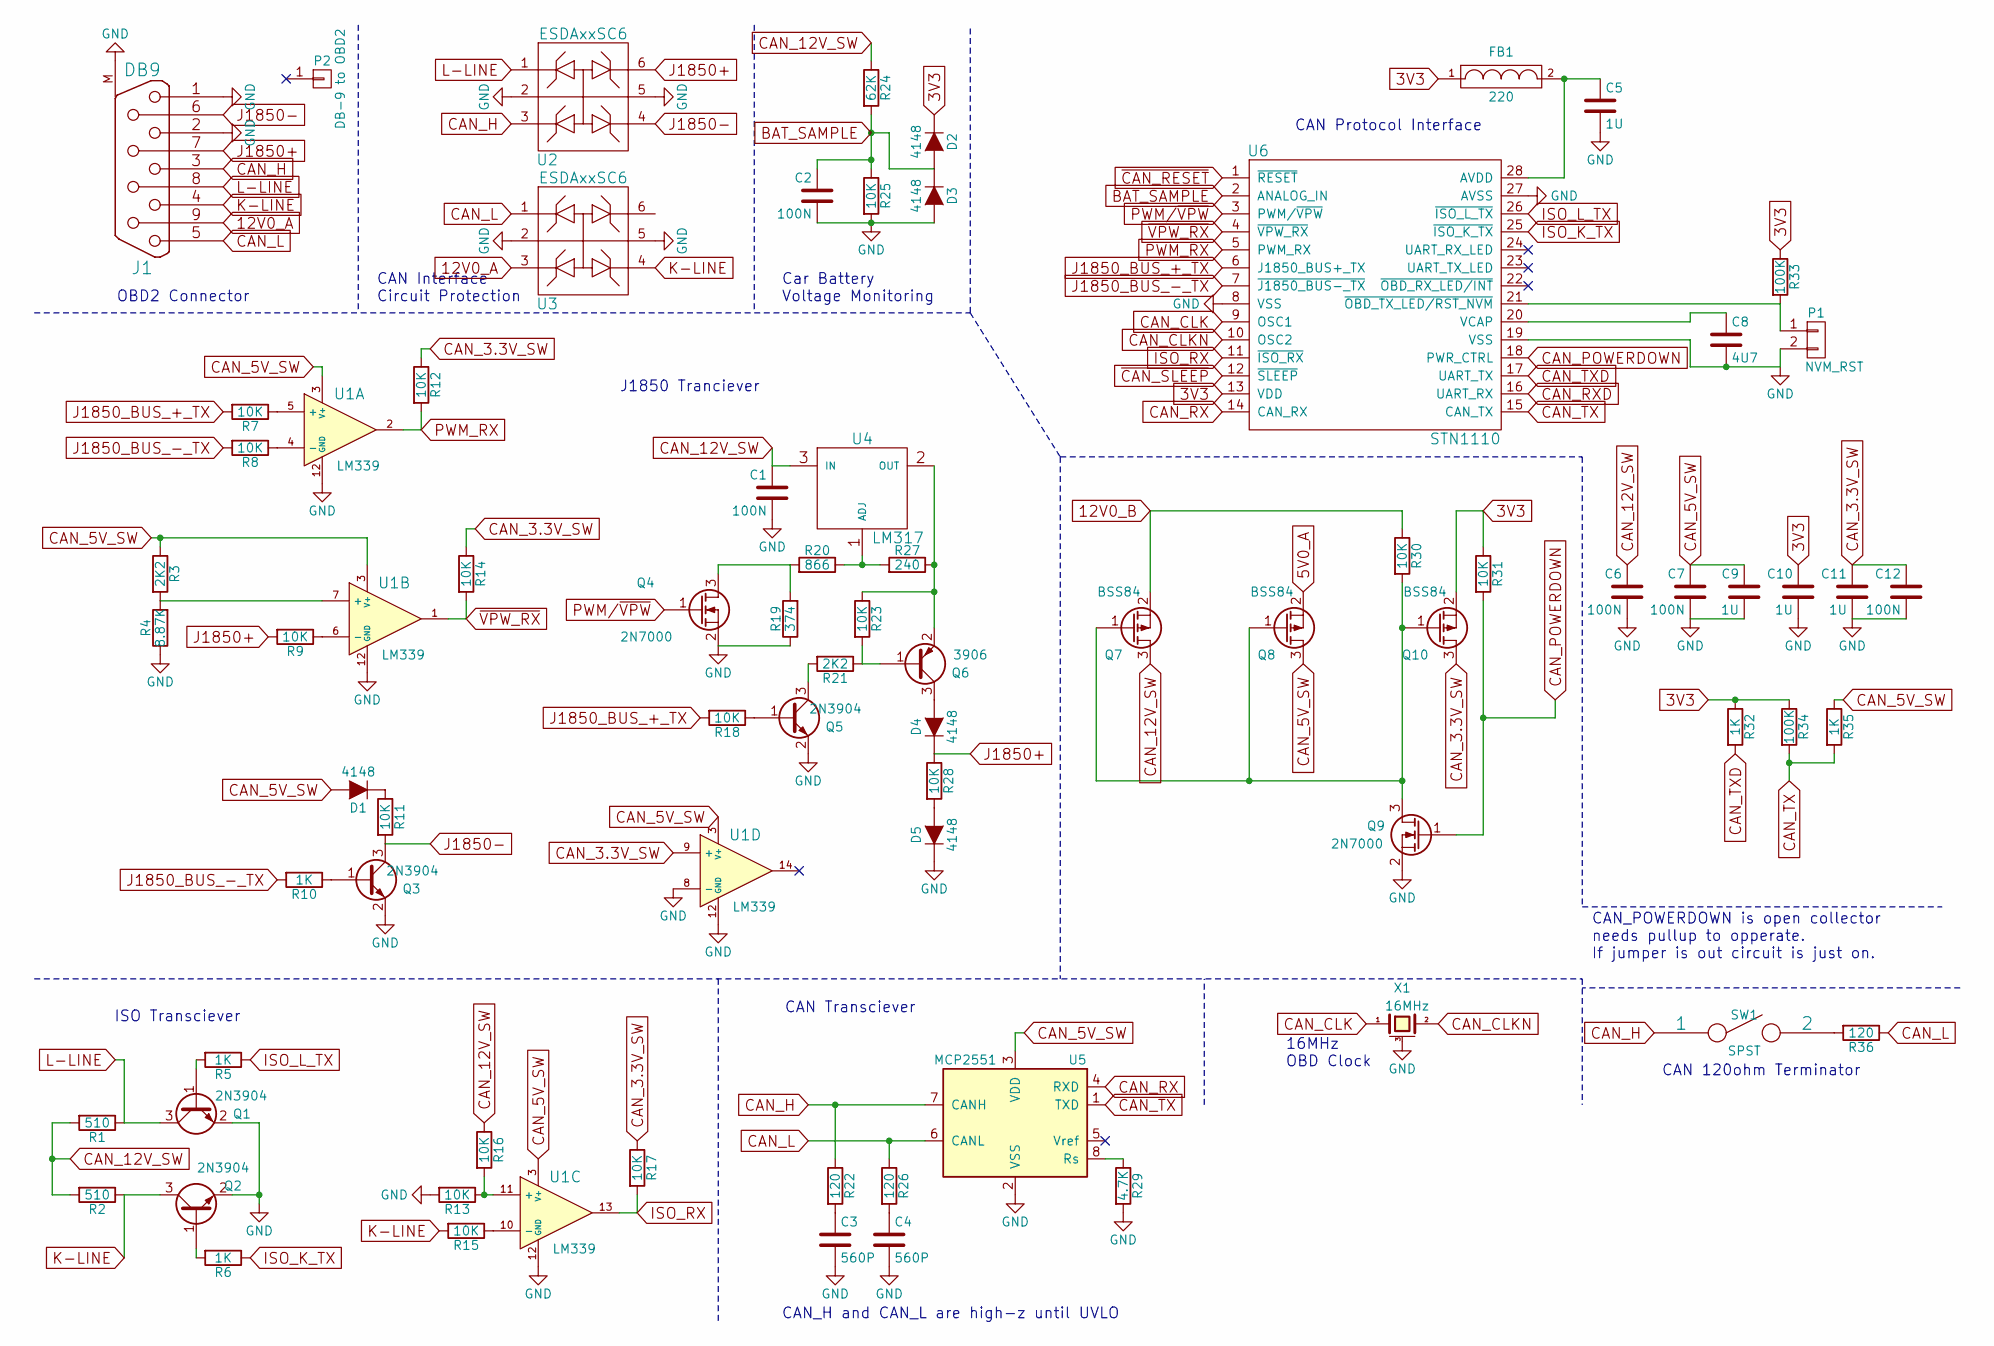
[picture p67: schematic V2X_OBD.sch, V2X - Open source RVI over SMS daughter card]

Parts:
C1, C2, C6, C7, C12: 100N; C_0603_SM
C3, C4: 560P; C_0603_SM
C5, C9, C10, C11: 1U; C_0603_SM
C8: 4U7; C_0805_SM
D1, D2, D3, D4, D5: 4148; Diode_0805_12_SM
FB1: 220; R_0603_sm
J1: DB9; DB-9_SMT
P1: NVM_RST; R_0603_sm
P2: DB-9 to OBD2
Q1, Q2, Q3, Q5: 2N3904; SOT_23_123
Q4, Q9: 2N7000; SOT_23_123
Q6: 3906; SOT_23_123
Q7, Q8, Q10: BSS84; SOT_23_123
R1, R2: 510; R_1210_SM
R3, R21: 2K2; R_0603_sm
R4: 8.87K; R_0603_sm
R5, R6, R10, R32, R35: 1K; R_0603_sm
R7, R8, R9, R11, R12, R13, R14, R15, R16, R17, R18, R23, R25, R28, R30, R31: 10K; R_0603_sm
R19: 374; R_0603_sm
R20: 866; R_0603_sm
R22, R26, R36: 120; R_0603_sm
R24: 62K; R_0603_sm
R27: 240; R_0603_sm
R29: 4.7K; R_0603_sm
R33, R34: 100K; R_0603_sm
SW1: SPST; SW_SPST_FSMSM_SM
U1: LM339; SOIC-14_3.9x8.7mm_Pitch1.27mm
U2, U3: ESDAxxSC6; SOT-23-6
U4: LM317; SOT-223
U5: MCP2551; SOIC-8_3.9x4.9mm_Pitch1.27mm
U6: STN1110; SOIC-28_7.5x17.9mm_Pitch1.27mm
X1: 16MHz; AWSCR

Connections:
3V3: C10.1, D2.1 (K), FB1.1, Q10.2 (S), R31.1, R32.1, R33.1, R34.1, U6.13 (VDD); also elsewhere on the board
5V0_A: Q8.2 (S); also elsewhere on the board
12V0_A: J1.9, U3.3 (A2); also elsewhere on the board
12V0_B: Q7.2 (S), R30.1; also elsewhere on the board
BAT_SAMPLE: C2.1, D2.2 (A), D3.1 (K), R24.2, R25.1, U6.2 (ANALOG_IN)
CAN_3.3V_SW: C11.1, C12.1, Q10.3 (D), R12.1, R14.1, R17.1, U1.9 (+)
CAN_5V_SW: C7.1, C9.1, D1.2 (A), Q8.3 (D), R3.1, R35.1, U1.3 (V+), U5.3 (VDD)
CAN_12V_SW: C1.1, C6.1, Q7.3 (D), R1.2, R2.2, R16.1, R24.1, U4.3 (IN)
CAN_CLK: U6.9 (OSC1), X1.1
CAN_CLKN: U6.10 (OSC2), X1.2
CAN_H: J1.3, R22.1, SW1.1, U2.3 (A2), U5.7 (CANH)
CAN_L: J1.5, R26.1, R36.1, U3.1 (A1), U5.6 (CANL)
CAN_POWERDOWN: Q9.1 (G), R31.2, U6.18 (PWR_CTRL)
CAN_RX: U5.4 (RXD), U6.14 (CAN_RX)
CAN_RXD: U6.16 (UART_RX); also elsewhere on the board
CAN_TX: R34.2, R35.2, U5.1 (TXD), U6.15 (CAN_TX)
CAN_TXD: R32.2, U6.17 (UART_TX); also elsewhere on the board
GND: C1.2, C2.2, C3.2, C4.2, C5.2, C6.2, C7.2, C8.2, C9.2, C10.2, C11.2, C12.2, D3.2 (A), D5.1 (K), J1.1, J1.2, J1.M (Sh), P1.2, Q1.2 (E), Q2.2 (E), Q3.2 (E), Q4.2 (S), Q5.2 (E), Q9.2 (S), R4.1, R13.2, R19.1, R25.2, R29.2, U1.8 (-), U1.12 (GND), U2.2 (K), U2.5 (K2), U3.2 (K), U3.5 (K2), U5.2 (VSS), U6.8 (VSS), U6.19 (VSS), U6.27 (AVSS), X1.3 (case); also elsewhere on the board
ISO_K_TX: R6.1, U6.25 (~ISO_K_TX)
ISO_L_TX: R5.1, U6.26 (~ISO_L_TX)
ISO_RX: R17.2, U1.13, U6.11 (~ISO_RX)
J1850+: D4.1 (K), J1.7, R9.2, R28.1, U2.6 (A4)
J1850-: J1.6, Q3.3 (C), R11.2, U2.4 (A4)
J1850_BUS_+_TX: R7.2, R18.2, U6.6 (J1850_BUS+_TX)
J1850_BUS_-_TX: R8.2, R10.2, U6.7 (~J1850_BUS-_TX)
K-LINE: J1.4, Q2.3 (C), R2.1, R15.2, U3.4 (A4)
L-LINE: J1.8, Q1.3 (C), R1.1, U2.1 (A1)
unnamed: C3.1, R22.2
unnamed: C4.1, R26.2
unnamed: C5.1, FB1.2, U6.28 (AVDD)
unnamed: C8.1, U6.20 (VCAP)
unnamed: D1.1 (K), R11.1
unnamed: D4.2 (A), Q6.3 (C)
unnamed: D5.2 (A), R28.2
unnamed: P1.1, R33.2, U6.21 (~OBD_TX_LED/RST_NVM)
unnamed: Q1.1 (B), R5.2
unnamed: Q2.1 (B), R6.2
unnamed: Q3.1 (B), R10.1
unnamed: Q4.3 (D), R19.2, R20.2
unnamed: Q5.1 (B), R18.1
unnamed: Q5.3 (C), R21.2
unnamed: Q6.1 (B), R21.1, R23.2
unnamed: Q6.2 (E), R23.1, R27.1, U4.2 (OUT)
unnamed: Q7.1 (G), Q8.1 (G), Q9.3 (D), Q10.1 (G), R30.2
unnamed: R3.2, R4.2, U1.7 (+)
unnamed: R7.1, U1.5 (+)
unnamed: R8.1, U1.4 (-)
unnamed: R9.1, U1.6 (-)
unnamed: R13.1, R16.2, U1.11 (+)
unnamed: R15.1, U1.10 (-)
unnamed: R20.1, R27.2, U4.1 (ADJ)
unnamed: R29.1, U5.8 (Rs)
unnamed: R36.2, SW1.2
PWM/~VPW: Q4.1 (G), U6.3 (PWM/~VPW)
PWM_RX: R12.2, U1.2, U6.5 (PWM_RX)
~CAN_RESET: U6.1 (~RESET); also elsewhere on the board
~CAN_SLEEP: U6.12 (~SLEEP); also elsewhere on the board
~VPW_RX: R14.2, U1.1, U6.4 (~VPW_RX)

Notes on the sheet:
OBD2 Connector
CAN Transciever
ISO Transciever
CAN_H and CAN_L are high-z until UVLO
CAN Protocol Interface
J1850 Tranciever
CAN Interface Circuit Protection
Car Battery Voltage Monitoring
16MHz OBD Clock
CAN_POWERDOWN is open collector needs pullup to opperate. If jumper is out circuit is just on.
CAN 120ohm Terminator

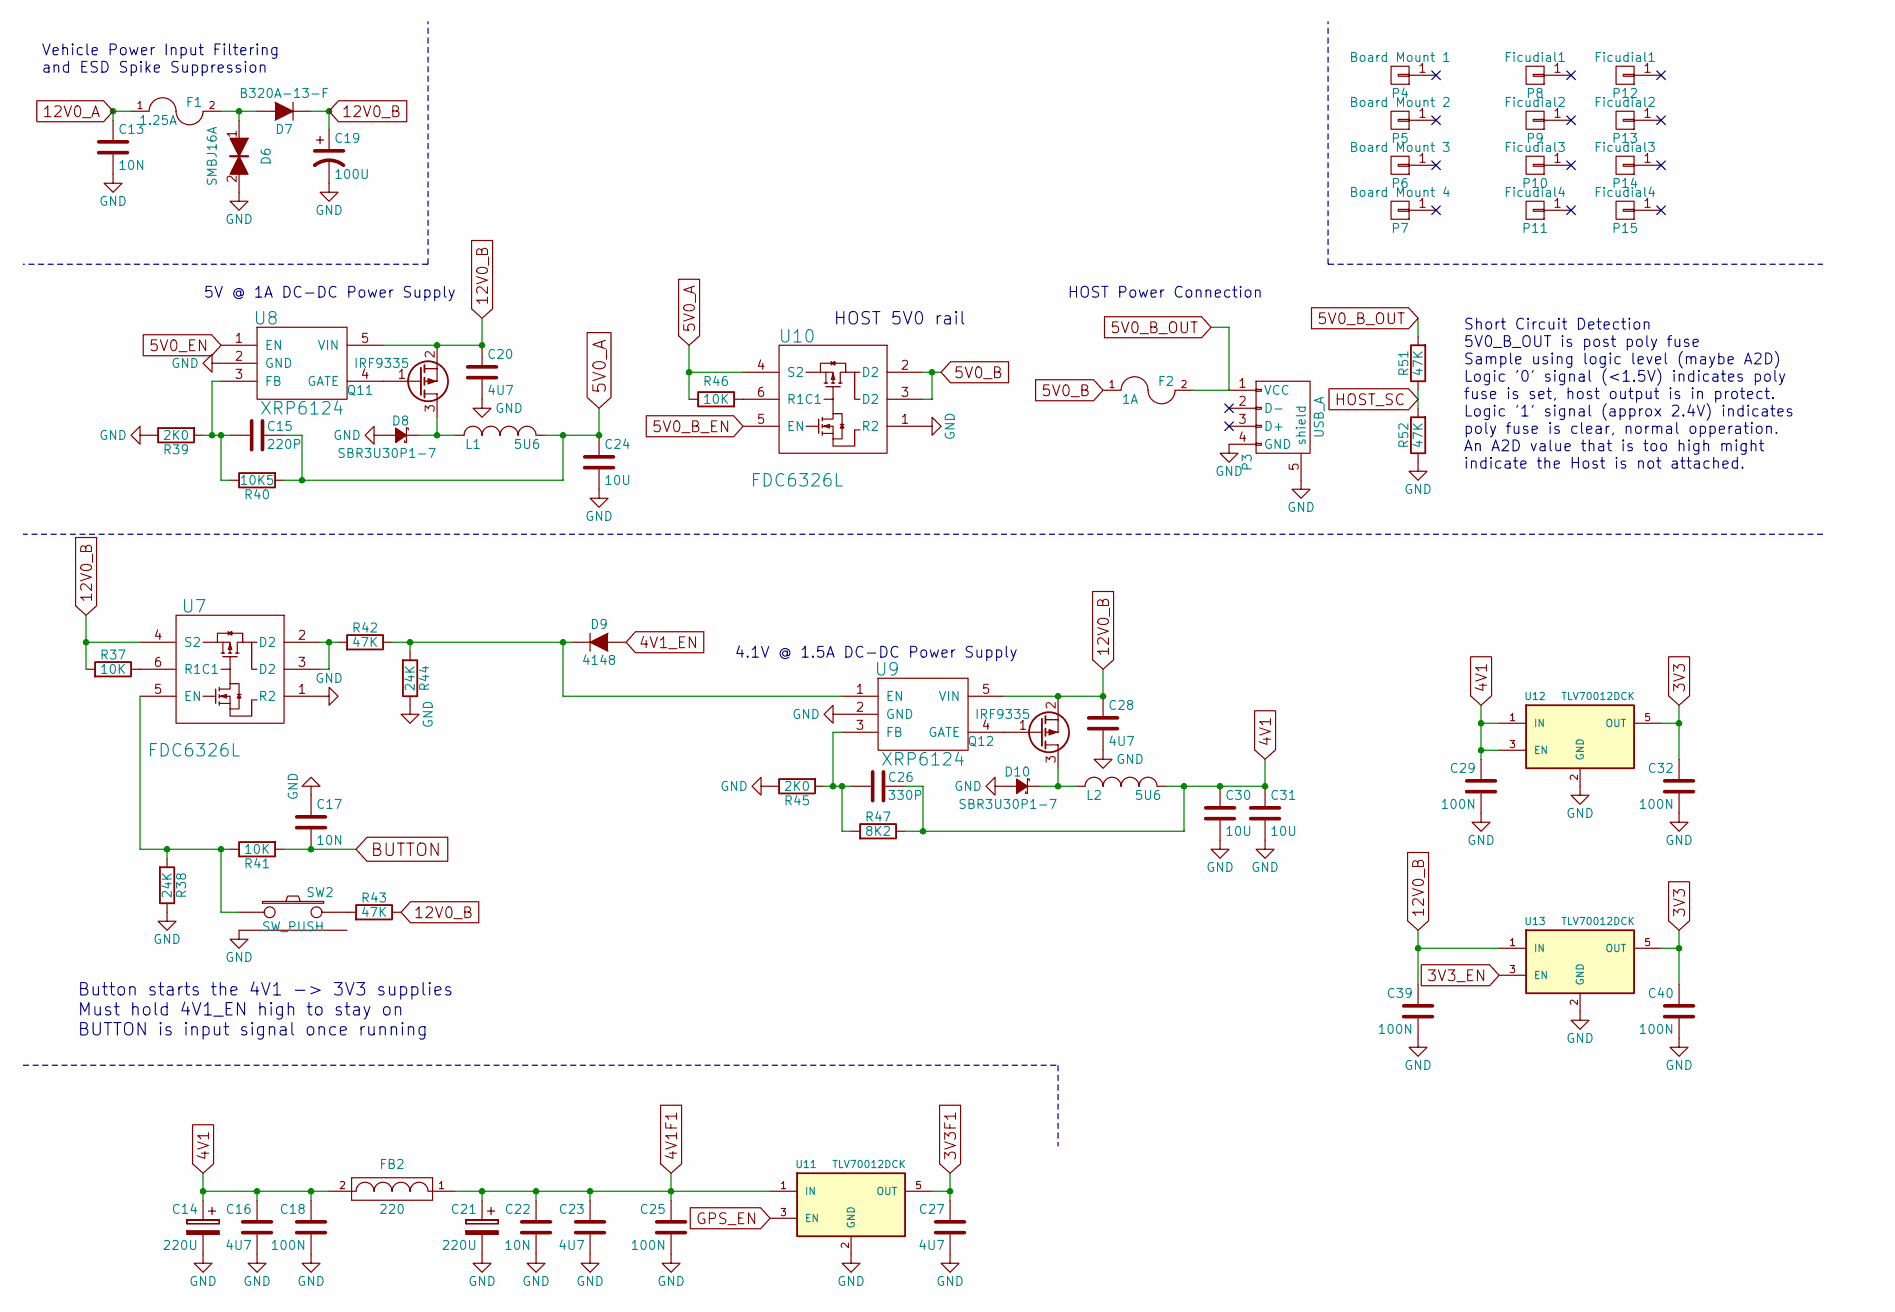
[picture p68: schematic V2X_PWR.sch, V2X - Open source RVI over SMS daughter card]

Parts:
C13, C17, C22: 10N; C_0603_SM
C14, C21: 220U; c_elec_6.3x5.8
C15: 220P; C_0603_SM
C16, C23, C27: 4U7; C_0805_SM
C18, C25, C29, C32, C39, C40: 100N; C_0603_SM
C19: 100U; c_elec_6.3x5.8
C20, C28: 4U7; C_1206_SM
C24, C30, C31: 10U; C_1206_SM
C26: 330P; C_0603_SM
D6: SMBJ16A; SMB_Standard
D7: B320A-13-F; SMA_Standard
D8, D10: SBR3U30P1-7; SOD-123
D9: 4148; Diode_0805_12_SM
F1: 1.25A; R_1812
F2: 1A; R_1812
FB2: 220; R_0603_sm
L1, L2: 5U6; L_4.5x4.5
P3: USB_A; USB-A-SMT
P4: Board Mount 1; MountingHole_3mm
P5: Board Mount 2; MountingHole_3mm
P6: Board Mount 3; MountingHole_3mm
P7: Board Mount 4; MountingHole_3mm
P8: Ficudial1; Fiducial_1mm_Dia_2.54mm_Outer_CopperTop
P9: Ficudial2; Fiducial_1mm_Dia_2.54mm_Outer_CopperTop
P10: Ficudial3; Fiducial_1mm_Dia_2.54mm_Outer_CopperTop
P11: Ficudial4; Fiducial_1mm_Dia_2.54mm_Outer_CopperTop
P12: Ficudial1; Fiducial_1mm_Dia_2.54mm_Outer_CopperBottom
P13: Ficudial2; Fiducial_1mm_Dia_2.54mm_Outer_CopperBottom
P14: Ficudial3; Fiducial_1mm_Dia_2.54mm_Outer_CopperBottom
P15: Ficudial4; Fiducial_1mm_Dia_2.54mm_Outer_CopperBottom
Q11, Q12: IRF9335; SOIC-8_MOS
R37, R41, R46: 10K; R_0603_sm
R38, R44: 24K; R_0603_sm
R39, R45: 2K0; R_0603_sm
R40: 10K5; R_0603_sm
R42, R43, R51, R52: 47K; R_0603_sm
R47: 8K2; R_0603_sm
SW2: SW_PUSH; PTS645VK58-2-LFS
U7, U10: FDC6326L; SOT-23-6
U8, U9: XRP6124; SOT-23-5
U11, U12, U13: TLV70012DCK; SOT-23-5

Connections:
3V3: C32.1, C40.1, U12.5 (OUT), U13.5 (OUT); also elsewhere on the board
3V3F1: C27.1, U11.5 (OUT); also elsewhere on the board
3V3_EN: U13.3 (EN); also elsewhere on the board
4V1: C14.1, C16.1, C18.1, C26.1, C29.1, C30.1, C31.1, FB2.2, L2.2, R47.1, U12.1 (IN), U12.3 (EN); also elsewhere on the board
4V1F1: C21.1, C22.1, C23.1, C25.1, FB2.1, U11.1 (IN); also elsewhere on the board
4V1_EN: D9.2 (A); also elsewhere on the board
5V0_A: C15.1, C24.1, L1.2, R40.2, R46.1, U10.4 (S2); also elsewhere on the board
5V0_B: F2.1, U10.2 (D2), U10.3 (D2)
5V0_B_EN: U10.5 (EN); also elsewhere on the board
5V0_B_OUT: F2.2, P3.1 (VCC), R51.2
5V0_EN: U8.1 (EN); also elsewhere on the board
12V0_A: C13.1, F1.1; also elsewhere on the board
12V0_B: C19.1, C20.1, C28.1, C39.1, D7.1 (K), Q11.2 (S), Q12.2 (S), R37.2, R43.1, U7.4 (S2), U8.5 (VIN), U9.5 (VIN), U13.1 (IN); also elsewhere on the board
BUTTON: C17.2, R41.2; also elsewhere on the board
GND: C13.2, C14.2, C16.2, C17.1, C18.2, C19.2, C20.2, C21.2, C22.2, C23.2, C24.2, C25.2, C27.2, C28.2, C29.2, C30.2, C31.2, C32.2, C39.2, C40.2, D6.2, D8.2 (A), D10.2 (A), P3.4 (GND), P3.5 (shield), R38.1, R39.1, R44.1, R45.1, R52.1, SW2.S (SHIELD), U7.1 (R2), U8.2 (GND), U9.2 (GND), U10.1 (R2), U11.2 (GND), U12.2 (GND), U13.2 (GND); also elsewhere on the board
GPS_EN: U11.3 (EN); also elsewhere on the board
HOST_SC: R51.1, R52.2; also elsewhere on the board
unnamed: C15.2, R39.2, R40.1, U8.3 (FB)
unnamed: C26.2, R45.2, R47.2, U9.3 (FB)
unnamed: D6.1, D7.2 (A), F1.2
unnamed: D8.1 (K), L1.1, Q11.3 (D)
unnamed: D9.1 (K), R42.1, R44.2, U9.1 (EN)
unnamed: D10.1 (K), L2.1, Q12.3 (D)
unnamed: Q11.1 (G), U8.4 (GATE)
unnamed: Q12.1 (G), U9.4 (GATE)
unnamed: R37.1, U7.6 (R1C1)
unnamed: R38.2, R41.1, SW2.1, U7.5 (EN)
unnamed: R42.2, U7.2 (D2), U7.3 (D2)
unnamed: R43.2, SW2.2
unnamed: R46.2, U10.6 (R1C1)

Notes on the sheet:
Vehicle Power Input Filtering and ESD Spike Suppression
5V @ 1A DC-DC Power Supply
HOST Power Connection
Button starts the 4V1 -> 3V3 supplies Must hold 4V1_EN high to stay on BUTTON is input signal once running
HOST 5V0 rail
Short Circuit Detection 5V0_B_OUT is post poly fuse Sample using logic level (maybe A2D) Logic '0' signal (<1.5V) indicates poly fuse is set, host output is in protect. Logic '1' signal (approx 2.4V) indicates poly fuse is clear, normal opperation. An A2D value that is too high might indicate the H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
4.1V @ 1.5A DC-DC Power Supply

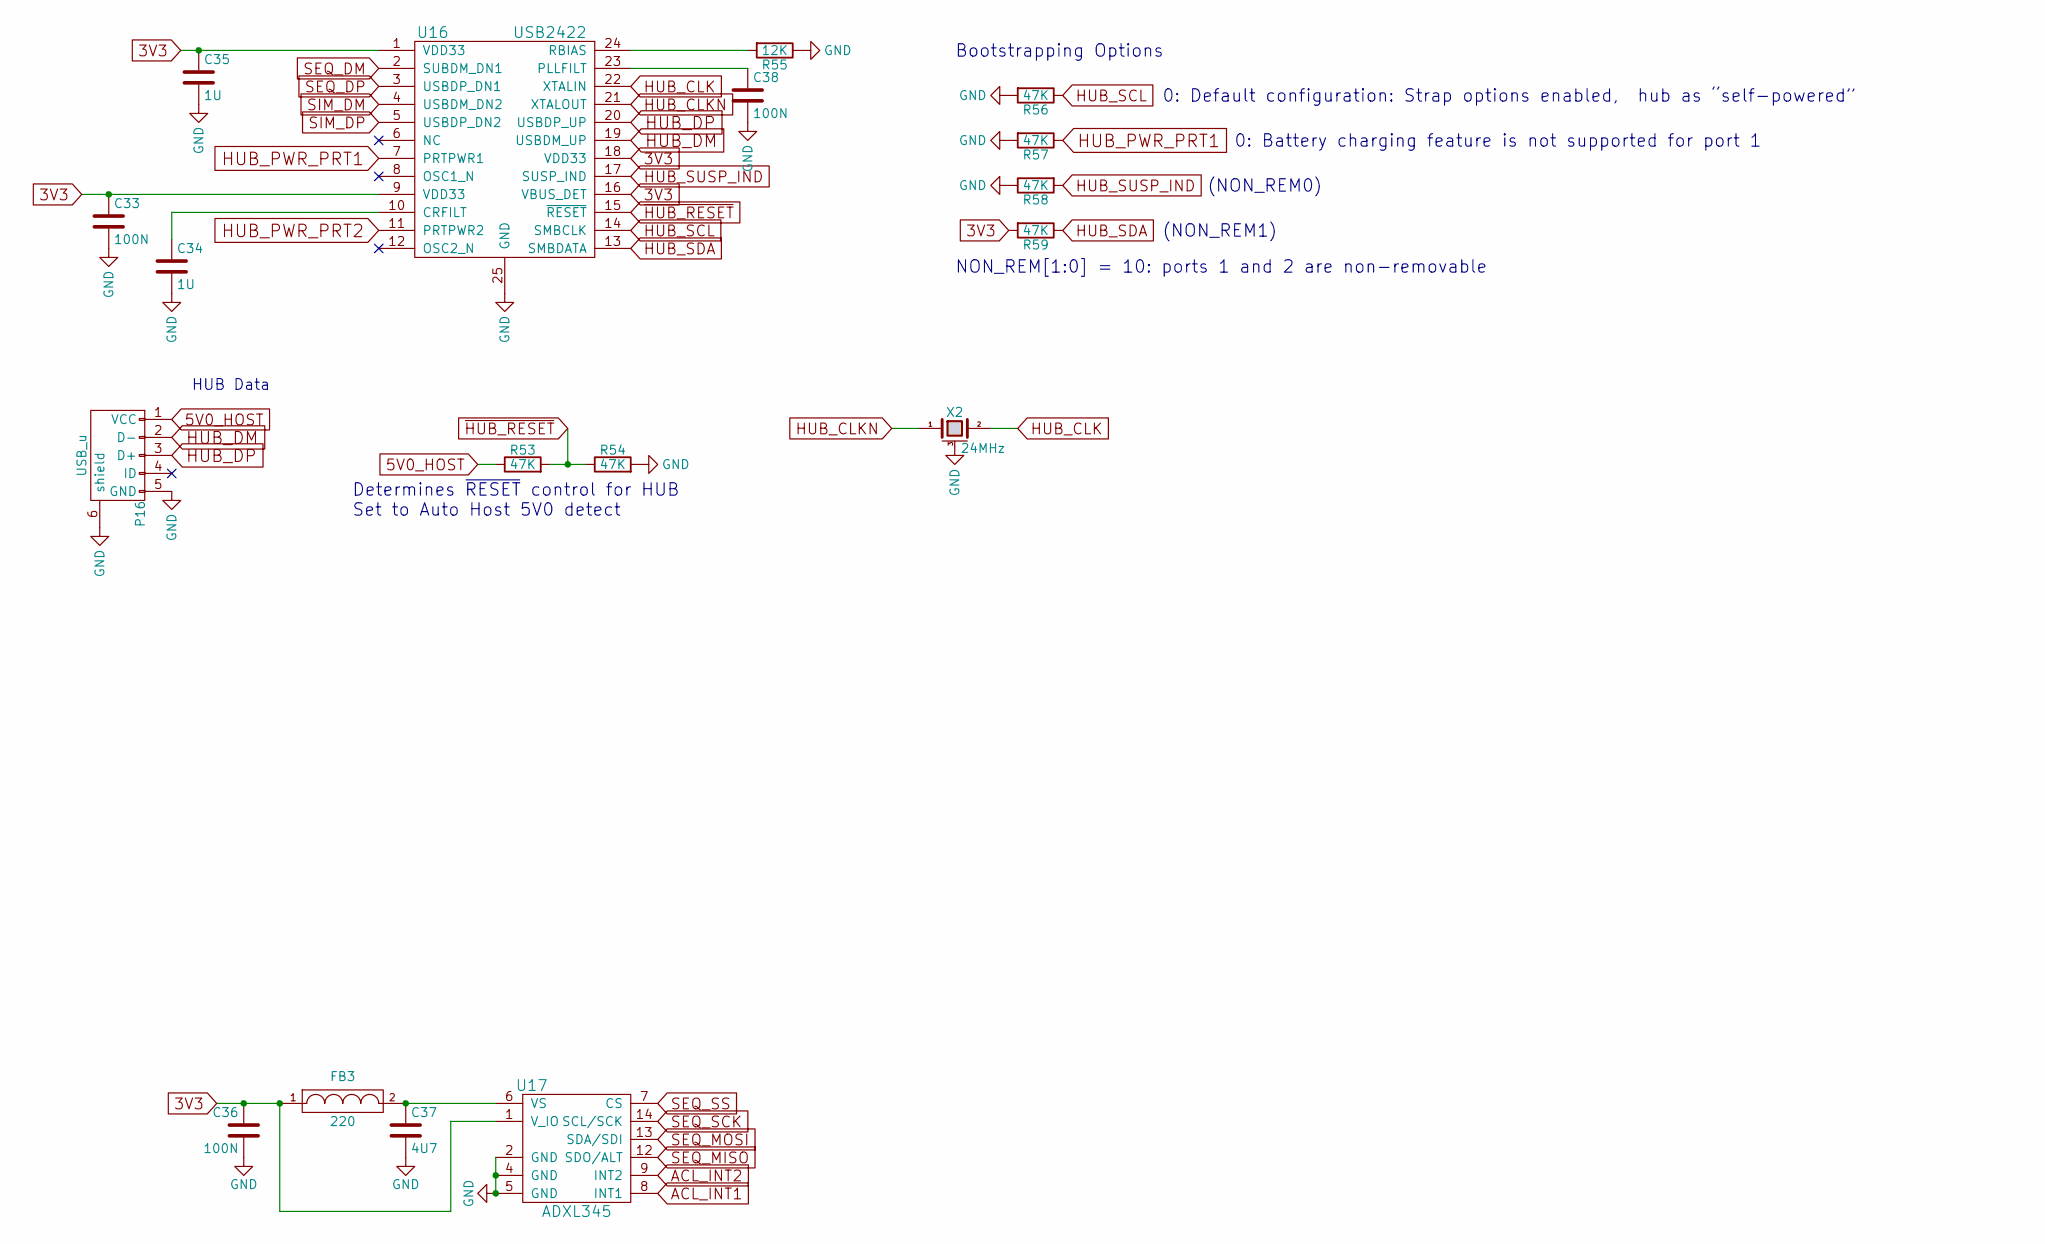
[picture p69: schematic V2X_ACCY.sch, V2X - Open source RVI over SMS daughter card]

Parts:
C33, C36, C38: 100N; C_0603_SM
C34, C35: 1U; C_0603_SM
C37: 4U7; C_0805_SM
FB3: 220; R_0603_sm
P16: USB_u; USB_Micro-B-DX4R005JJ2R1800
R53, R54, R56, R57, R58, R59: 47K; R_0603_sm
R55: 12K; R_0603_sm
U16: USB2422; QFN-24-1EP_4x4mm_Pitch0.5mm
U17: ADXL345; LGA-14_5x3mm
X2: 24MHz; AWSCR

Connections:
3V3: C33.1, C35.1, C36.1, FB3.1, R59.2, U16.1 (VDD33), U16.9 (VDD33), U16.16 (VBUS_DET), U16.18 (VDD33), U17.1 (V_IO); also elsewhere on the board
5V0_HOST: P16.1 (VCC), R53.1
ACL_INT1: U17.8 (INT1); also elsewhere on the board
ACL_INT2: U17.9 (INT2); also elsewhere on the board
GND: C33.2, C34.2, C35.2, C36.2, C37.2, C38.2, P16.5 (GND), P16.6 (shield), R54.2, R55.1, R56.2, R57.2, R58.1, U16.25 (GND), U17.2 (GND), U17.4 (GND), U17.5 (GND), X2.3 (case); also elsewhere on the board
HUB_CLK: U16.22 (XTALIN), X2.2
HUB_CLKN: U16.21 (XTALOUT), X2.1
HUB_DM: P16.2 (D-), U16.19 (USBDM_UP)
HUB_DP: P16.3 (D+), U16.20 (USBDP_UP)
HUB_PWR_PRT1: R57.1, U16.7 (PRTPWR1); also elsewhere on the board
HUB_PWR_PRT2: U16.11 (PRTPWR2); also elsewhere on the board
HUB_SCL: R56.1, U16.14 (SMBCLK)
HUB_SDA: R59.1, U16.13 (SMBDATA)
HUB_SUSP_IND: R58.2, U16.17 (SUSP_IND)
unnamed: C34.1, U16.10 (CRFILT)
unnamed: C37.1, FB3.2, U17.6 (VS)
unnamed: C38.1, U16.23 (PLLFILT)
unnamed: R55.2, U16.24 (RBIAS)
SEQ_DM: U16.2 (SUBDM_DN1); also elsewhere on the board
SEQ_DP: U16.3 (USBDP_DN1); also elsewhere on the board
SEQ_MISO: U17.12 (SDO/ALT); also elsewhere on the board
SEQ_MOSI: U17.13 (SDA/SDI); also elsewhere on the board
SEQ_SCK: U17.14 (SCL/SCK); also elsewhere on the board
SEQ_SS: U17.7 (CS); also elsewhere on the board
SIM_DM: U16.4 (USBDM_DN2); also elsewhere on the board
SIM_DP: U16.5 (USBDP_DN2); also elsewhere on the board
~HUB_RESET: R53.2, R54.1, U16.15 (~RESET)

Notes on the sheet:
Determines ~RESET~ control for HUB Set to Auto Host 5V0 detect
HUB Data
Bootstrapping Options
0: Default configuration: Strap options enabled, hub as “self-powered”
(NON_REM0)
(NON_REM1)
NON_REM[1:0] = 10: ports 1 and 2 are non-removable
0: Battery charging feature is not supported for port 1
