jbanks2/rvi_v2x_board/Hardware/Make Files/V2 Ready for Order/V2X.kicad_pcb

## KiCad design Hardware/Make Files/V2 Ready for Order/V2X.kicad_pcb (continued)

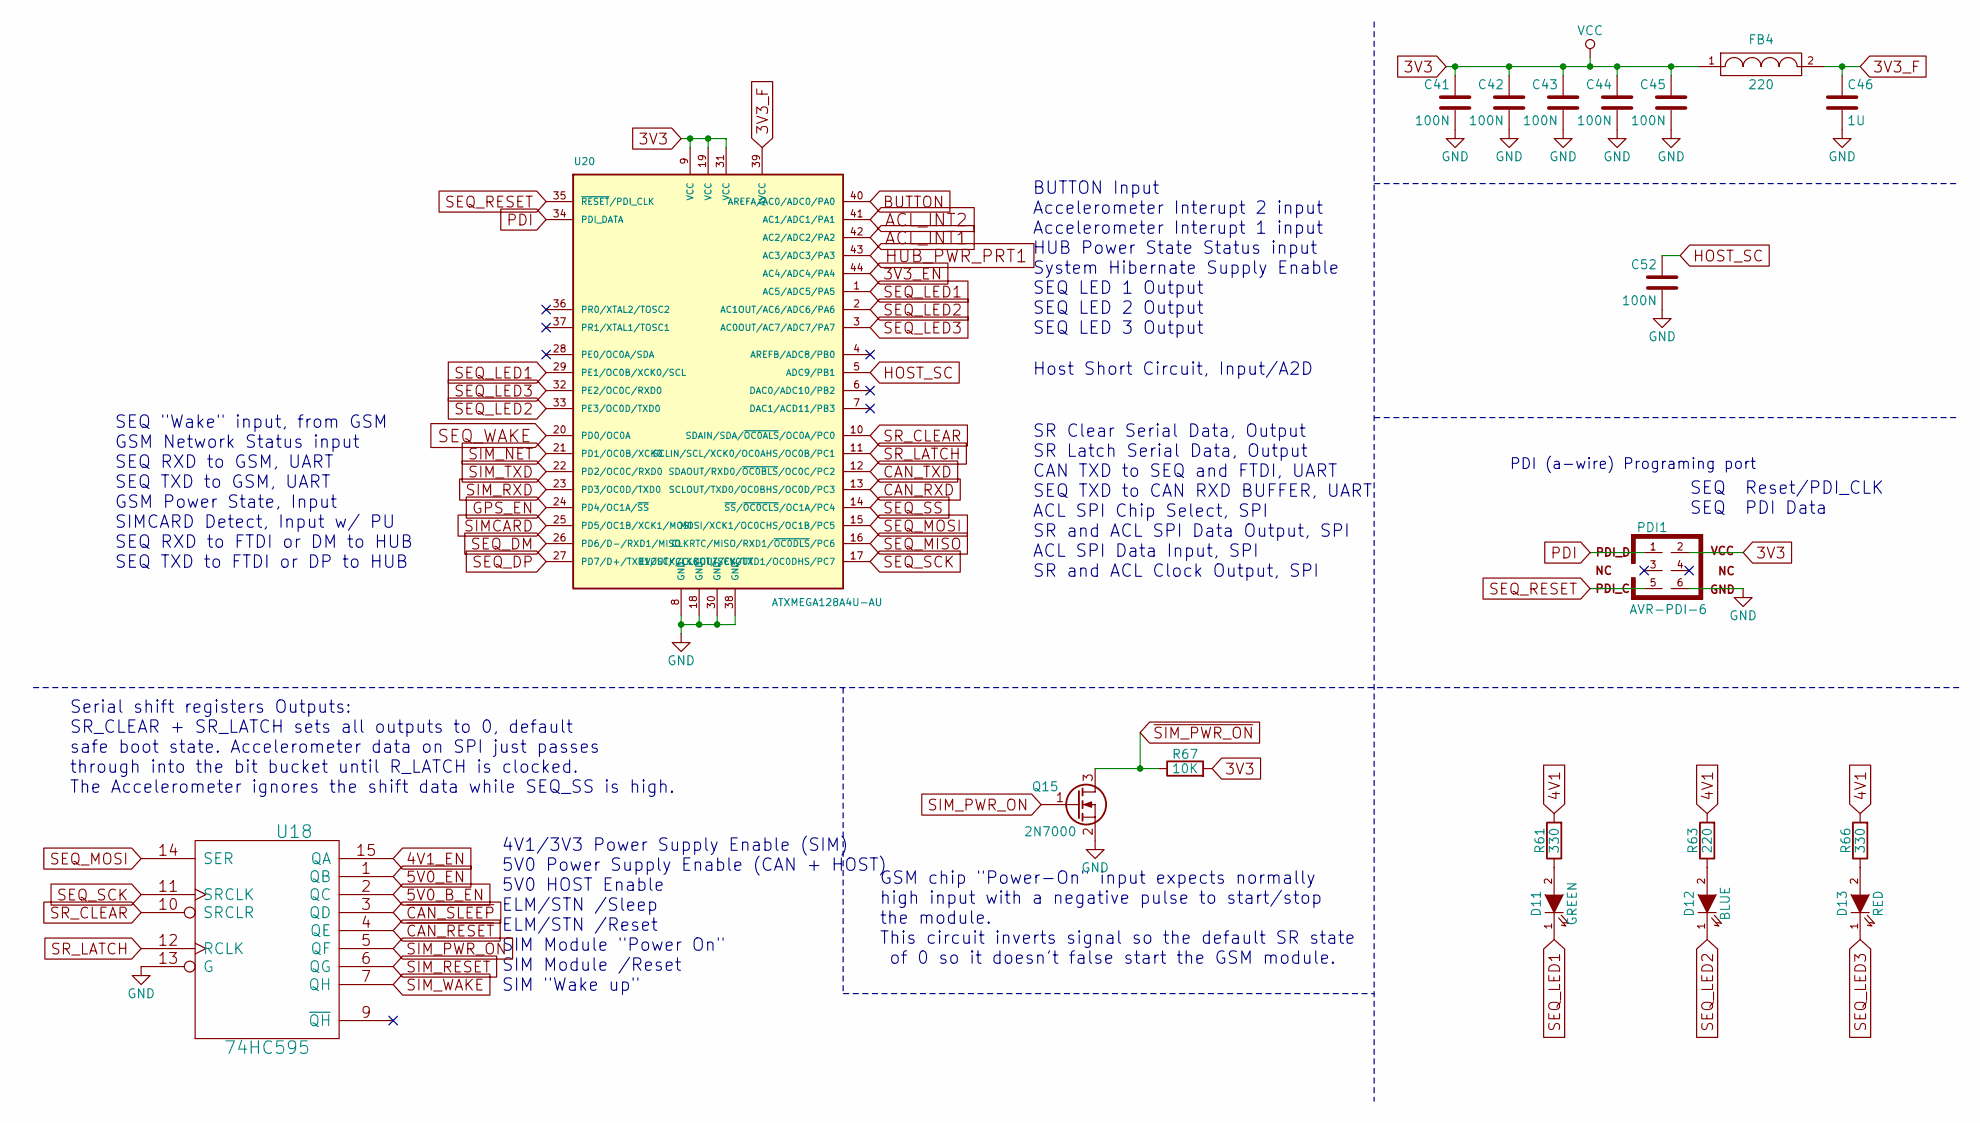
[picture p70: schematic V2X_CTRL.sch, V2X - Open source RVI over SMS daughter card]

Parts:
C41, C42, C43, C44, C45, C52: 100N; C_0603_SM
C46: 1U; C_0603_SM
D11: GREEN; 0805_LED
D12: BLUE; 0805_LED
D13: RED; 0805_LED
FB4: 220; R_0603_sm
PDI1: AVR-PDI-6; Pin_Header_Straight_2x03
Q15: 2N7000; SOT_23_123
R61, R66: 330; R_0603_sm
R63: 220; R_0603_sm
R67: 10K; R_0603_sm
U18: 74HC595; SOIC-16_3.9x9.9mm_Pitch1.27mm
U20: ATXMEGA128A4U-AU; TQFP-44_10x10mm_Pitch0.8mm

Connections:
3V3: C41.1, C42.1, C43.1, C44.1, C45.1, FB4.1, PDI1.2, R67.2, U18.16 (VCC), U20.9 (VCC), U20.19 (VCC), U20.31 (VCC); also elsewhere on the board
3V3_EN: U20.44 (AC4/ADC4/PA4); also elsewhere on the board
3V3_F: C46.1, FB4.2, U20.39 (AVCC)
4V1: R61.2, R63.2, R66.2; also elsewhere on the board
4V1_EN: U18.15 (QA); also elsewhere on the board
5V0_B_EN: U18.2 (QC); also elsewhere on the board
5V0_EN: U18.1 (QB); also elsewhere on the board
ACL_INT1: U20.42 (AC2/ADC2/PA2); also elsewhere on the board
ACL_INT2: U20.41 (AC1/ADC1/PA1); also elsewhere on the board
BUTTON: U20.40 (AREFA/AC0/ADC0/PA0); also elsewhere on the board
CAN_RXD: U20.13 (SCLOUT/TXD0/OC0BHS/OC0D/PC3); also elsewhere on the board
CAN_TXD: U20.12 (SDAOUT/RXD0/~OC0BLS~/OC0C/PC2); also elsewhere on the board
GND: C41.2, C42.2, C43.2, C44.2, C45.2, C46.2, C52.2, PDI1.6, Q15.2 (S), U18.8 (GND), U18.13 (G), U20.8 (GND), U20.18 (GND), U20.30 (GND), U20.38 (GND); also elsewhere on the board
GPS_EN: U20.24 (PD4/OC1A/~SS~); also elsewhere on the board
HOST_SC: C52.1, U20.5 (ADC9/PB1); also elsewhere on the board
HUB_PWR_PRT1: U20.43 (AC3/ADC3/PA3); also elsewhere on the board
unnamed: D11.2 (A), R61.1
unnamed: D12.2 (A), R63.1
unnamed: D13.2 (A), R66.1
PDI: PDI1.1, U20.34 (PDI_DATA)
SEQ_DM: U20.26 (PD6/D-/RXD1/MISO); also elsewhere on the board
SEQ_DP: U20.27 (PD7/D+/TXD1/SCK/CLKOUT/EVOUT); also elsewhere on the board
SEQ_LED1: D11.1 (K), U20.1 (AC5/ADC5/PA5), U20.29 (PE1/OC0B/XCK0/SCL)
SEQ_LED2: D12.1 (K), U20.2 (AC1OUT/AC6/ADC6/PA6), U20.33 (PE3/OC0D/TXD0)
SEQ_LED3: D13.1 (K), U20.3 (AC0OUT/AC7/ADC7/PA7), U20.32 (PE2/OC0C/RXD0)
SEQ_MISO: U20.16 (CLKRTC/MISO/RXD1/~OC0DLS~/PC6); also elsewhere on the board
SEQ_MOSI: U18.14 (SER), U20.15 (MOSI/XCK1/OC0CHS/OC1B/PC5); also elsewhere on the board
SEQ_RESET: PDI1.5, U20.35 (~RESET~/PDI_CLK)
SEQ_SCK: U18.11 (SRCLK), U20.17 (EVOUT/CLKOUT/SCK/TXD1/OC0DHS/PC7); also elsewhere on the board
SEQ_SS: U20.14 (~SS~/~OC0CLS~/OC1A/PC4); also elsewhere on the board
SEQ_WAKE: U20.20 (PD0/OC0A); also elsewhere on the board
SIMCARD: U20.25 (PD5/OC1B/XCK1/MOSI); also elsewhere on the board
SIM_NET: U20.21 (PD1/OC0B/XCK0); also elsewhere on the board
SIM_PWR_ON: Q15.1 (G), U18.5 (QF)
SIM_RESET: U18.6 (QG); also elsewhere on the board
SIM_RXD: U20.23 (PD3/OC0D/TXD0); also elsewhere on the board
SIM_TXD: U20.22 (PD2/OC0C/RXD0); also elsewhere on the board
SIM_WAKE: U18.7 (QH); also elsewhere on the board
SR_CLEAR: U18.10 (SRCLR), U20.10 (SDAIN/SDA/~OC0ALS~/OC0A/PC0)
SR_LATCH: U18.12 (RCLK), U20.11 (SCLIN/SCL/XCK0/OC0AHS/OC0B/PC1)
~CAN_RESET: U18.4 (QE); also elsewhere on the board
~CAN_SLEEP: U18.3 (QD); also elsewhere on the board
~SIM_PWR_ON: Q15.3 (D), R67.1; also elsewhere on the board

Notes on the sheet:
SR Clear Serial Data, Output SR Latch Serial Data, Output CAN TXD to SEQ and FTDI, UART SEQ TXD to CAN RXD BUFFER, UART ACL SPI Chip Select, SPI SR and ACL SPI Data Output, SPI ACL SPI Data Input, SPI SR and ACL Clock Output, SPI
PDI (a-wire) Programing port
4V1/3V3 Power Supply Enable (SIM) 5V0 Power Supply Enable (CAN + HOST) 5V0 HOST Enable ELM/STN /Sleep ELM/STN /Reset SIM Module "Power On" SIM Module /Reset SIM "Wake up"
SEQ Reset/PDI_CLK SEQ PDI Data
Host Short Circuit, Input/A2D
Serial shift registers Outputs: SR_CLEAR + SR_LATCH sets all outputs to 0, default safe boot state. Accelerometer data on SPI just passes through into the bit bucket until R_LATCH is clocked. The Accelerometer ignores the shift data while SEQ_SS is high.
GSM chip "Power-On" input expects normally high input with a negative pulse to start/stop the module. This circuit inverts signal so the default SR state of 0 so it doesn't false start the GSM module.
SEQ "Wake" input, from GSM GSM Network Status input SEQ RXD to GSM, UART SEQ TXD to GSM, UART GSM Power State, Input SIMCARD Detect, Input w/ PU SEQ RXD to FTDI or DM to HUB SEQ TXD to FTDI or DP to HUB
BUTTON Input Accelerometer Interupt 2 input Accelerometer Interupt 1 input HUB Power State Status input System Hibernate Supply Enable SEQ LED 1 Output SEQ LED 2 Output SEQ LED 3 Output

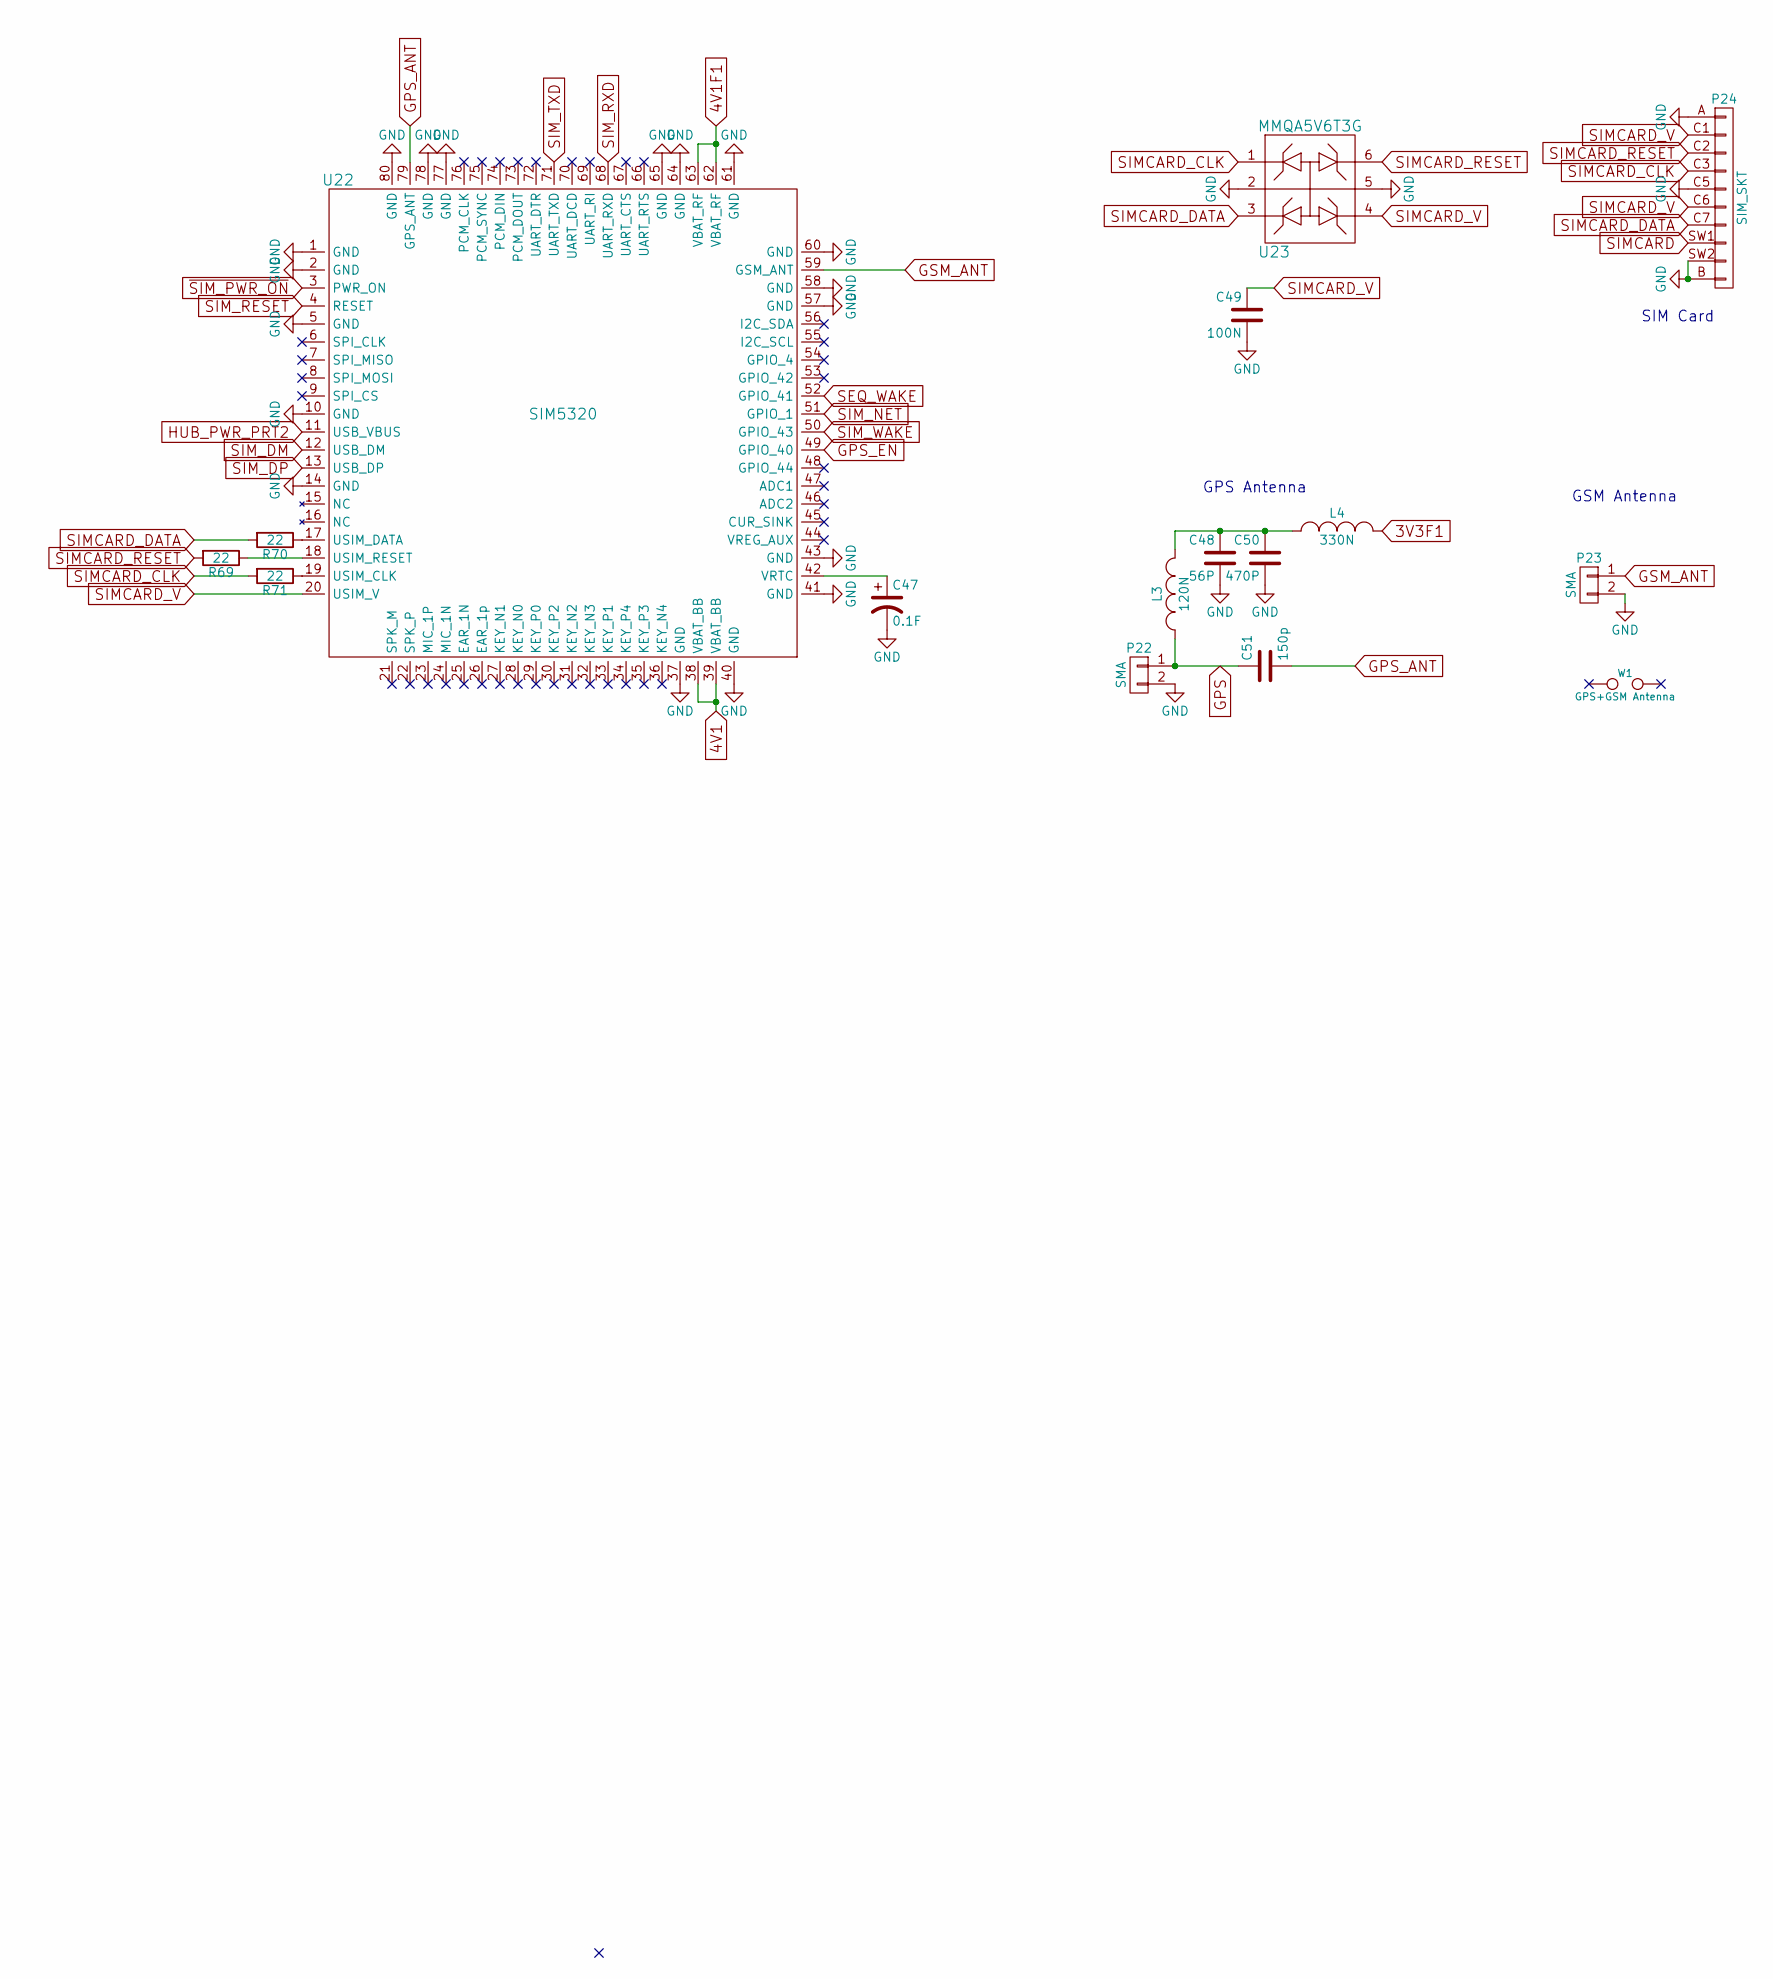
[picture p71: schematic V2X_GSM.sch, V2X - Open source RVI over SMS daughter card]

Parts:
C47: 0.1F; C_Radial_D12.5_L25_P5; Mouser PN 504-KR-5R5C104-R
C48: 56P; C_0603_SM
C49: 100N; C_0603_SM
C50: 470P; C_0603_SM
C51: 150p; C_0603_SM
L3: 120N; L_0603_SM
L4: 330N; L_0603_SM
P22, P23: SMA; SMA-RA_142-0701-801
P24: SIM_SKT; 47553-1001
R69, R70, R71: 22; R_0603_sm
U22: SIM5320
U23: MMQA5V6T3G; SOT-23-6
W1: GPS+GSM Antenna

Connections:
3V3F1: L4.1; also elsewhere on the board
4V1: U22.38 (VBAT_BB), U22.39 (VBAT_BB); also elsewhere on the board
4V1F1: U22.62 (VBAT_RF), U22.63 (VBAT_RF); also elsewhere on the board
GND: C47.2, C48.2, C49.2, C50.2, P22.2, P23.2, P24.A, P24.B, P24.C5, P24.SW2, U22.1 (GND), U22.2 (GND), U22.5 (GND), U22.10 (GND), U22.14 (GND), U22.37 (GND), U22.40 (GND), U22.41 (GND), U22.43 (GND), U22.57 (GND), U22.58 (GND), U22.60 (GND), U22.61 (GND), U22.64 (GND), U22.65 (GND), U22.77 (GND), U22.78 (GND), U22.80 (GND), U23.2 (K), U23.5 (K2); also elsewhere on the board
GPS: C51.1, L3.1, P22.1
GPS_ANT: C51.2, U22.79 (GPS_ANT)
GPS_EN: U22.49 (GPIO_40); also elsewhere on the board
GSM_ANT: P23.1, U22.59 (GSM_ANT)
HUB_PWR_PRT2: U22.11 (USB_VBUS); also elsewhere on the board
unnamed: C47.1, U22.42 (VRTC)
unnamed: C48.1, C50.1, L3.2, L4.2
unnamed: R69.1, U22.18 (USIM_RESET)
unnamed: R70.1, U22.17 (USIM_DATA)
unnamed: R71.1, U22.19 (USIM_CLK)
SEQ_WAKE: U22.52 (GPIO_41); also elsewhere on the board
SIMCARD: P24.SW1; also elsewhere on the board
SIMCARD_CLK: P24.C3, R71.2, U23.1 (A1)
SIMCARD_DATA: P24.C7, R70.2, U23.3 (A2)
SIMCARD_RESET: P24.C2, R69.2, U23.6 (A4)
SIMCARD_V: C49.1, P24.C1, P24.C6, U22.20 (USIM_V), U23.4 (A4)
SIM_DM: U22.12 (USB_DM); also elsewhere on the board
SIM_DP: U22.13 (USB_DP); also elsewhere on the board
SIM_NET: U22.51 (GPIO_1); also elsewhere on the board
SIM_RESET: U22.4 (RESET); also elsewhere on the board
SIM_RXD: U22.68 (UART_RXD); also elsewhere on the board
SIM_TXD: U22.71 (UART_TXD); also elsewhere on the board
SIM_WAKE: U22.50 (GPIO_43); also elsewhere on the board
~SIM_PWR_ON: U22.3 (PWR_ON); also elsewhere on the board

Notes on the sheet:
SIM Card
GPS Antenna
GSM Antenna

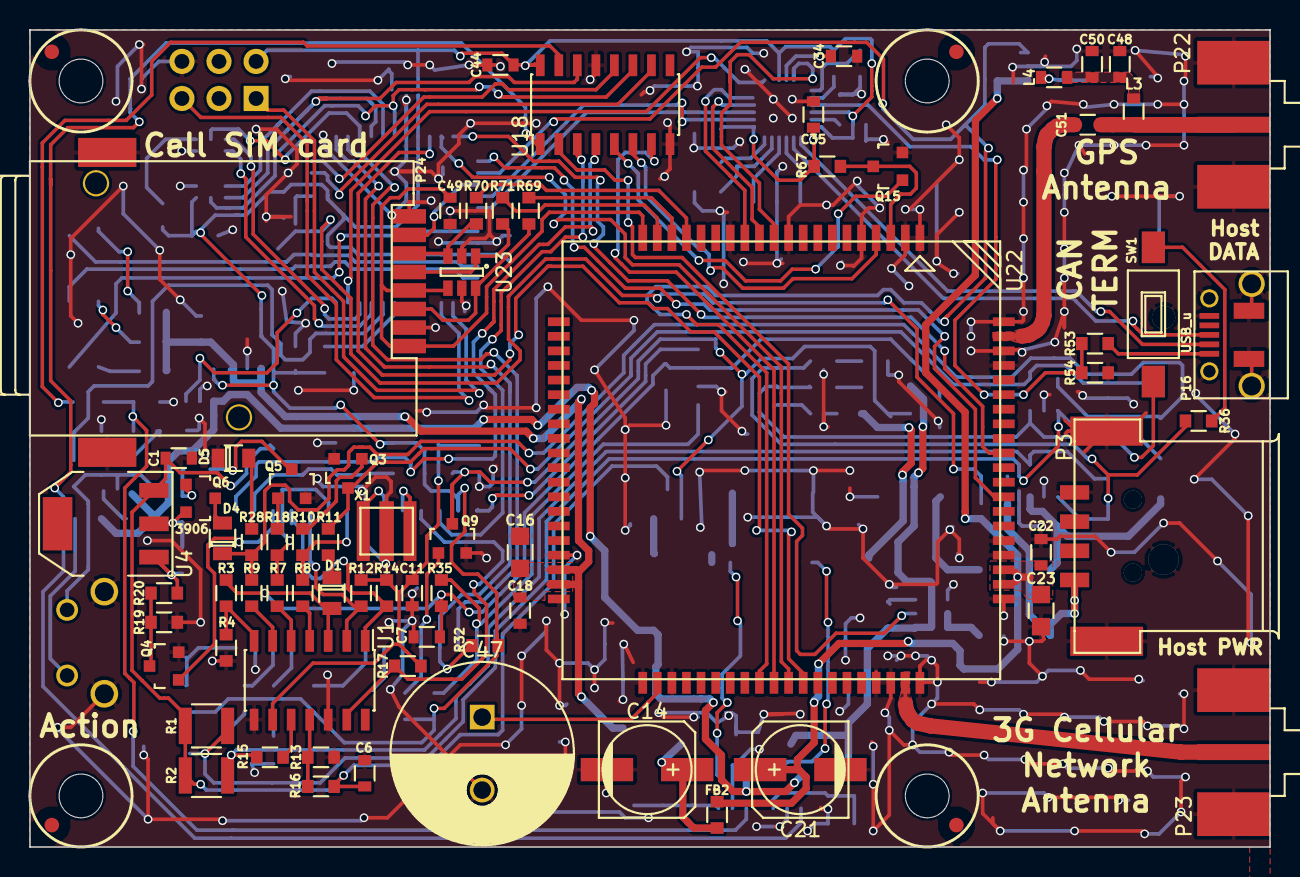
[picture p72: board Hardware/Make Files/V2 Ready for Order/V2X.kicad_pcb from above]

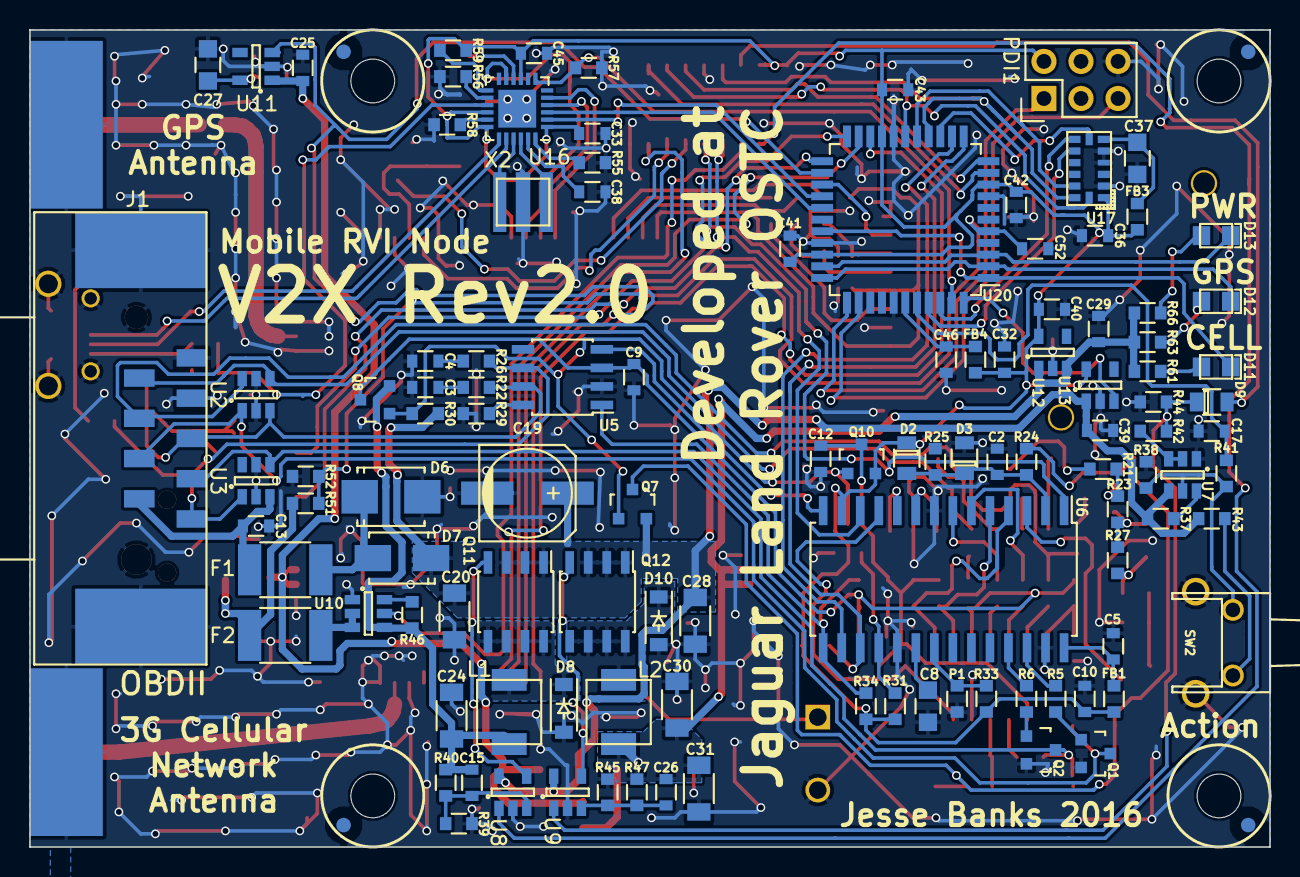
[picture p73: board Hardware/Make Files/V2 Ready for Order/V2X.kicad_pcb from below]

Board: 2 copper layers, 85.0 x 56.0 mm, 194 parts (112 on the bottom side), 140 nets.
