jbanks2/rvi_v2x_board/Hardware/Make Files/V1.3 Unfinished/V2X.kicad_pcb

## KiCad design Hardware/Make Files/V1.3 Unfinished/V2X.kicad_pcb (2015-11-03)

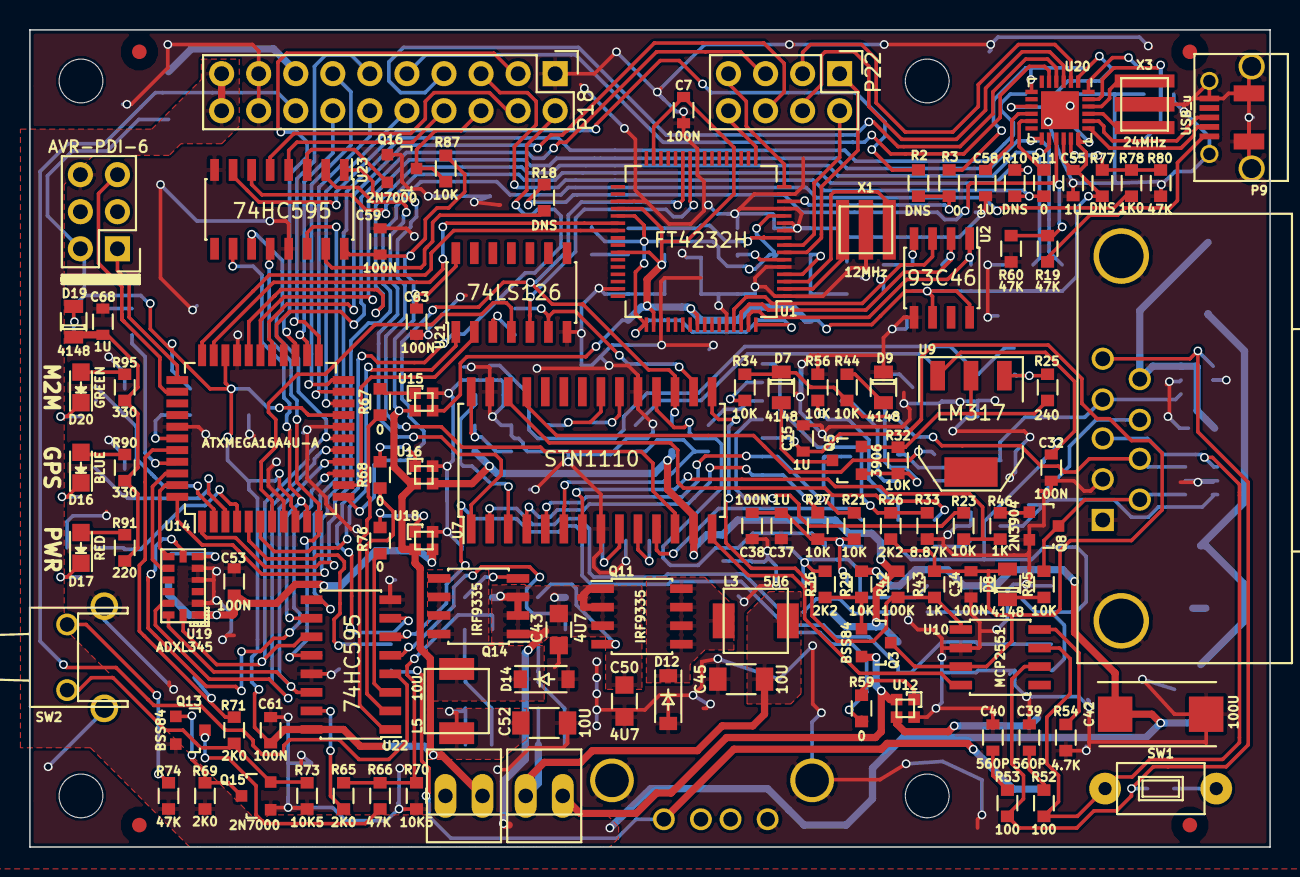
[picture p74: board Hardware/Make Files/V1.3 Unfinished/V2X.kicad_pcb from above]

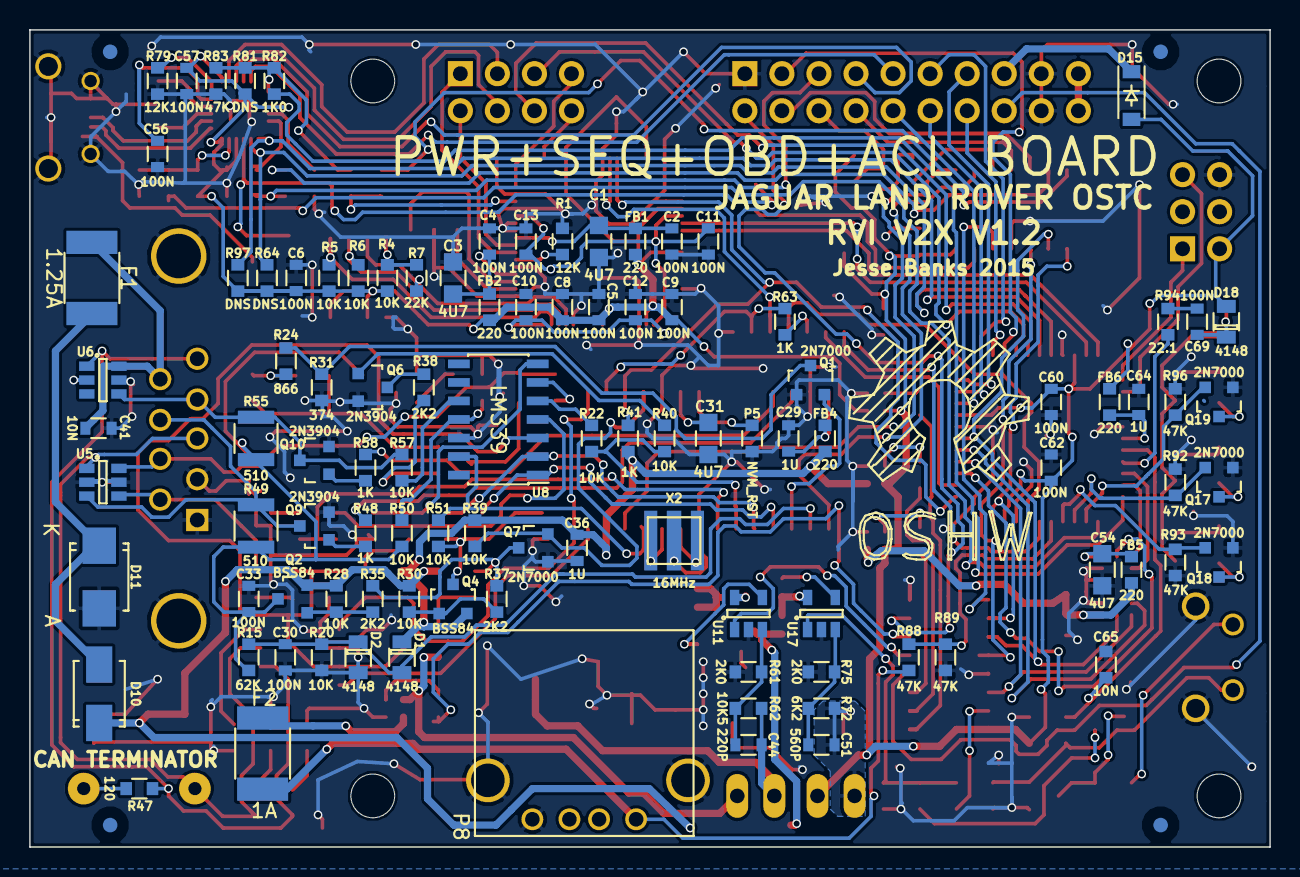
[picture p75: board Hardware/Make Files/V1.3 Unfinished/V2X.kicad_pcb from below]

Board: 2 copper layers, 85.0 x 56.0 mm, 223 parts (106 on the bottom side), 179 nets.

Parts:
C1, C3, C31, C43, C50, C54: 4U7; C_0805_SM
C2, C4, C5, C6, C7, C8, C9, C10, C11, C12, C13, C30, C32, C33, C34, C38, C53, C56, C57, C59, C60, C61, C62, C63, C69: 100N; C_0603_SM
C29, C35, C36, C37, C55, C58, C64, C68: 1U; C_0603_SM
C39, C40, C51: 560P; C_0603_SM
C41: 10N; C_0603_SM
C42: 100U; TantalC_SizeD_EIA-7343_Reflow
C44: 220P; C_0603_SM
C45, C52: 10U; C_1206_SM
C65: 10N; R_0603_sm
CON1: AVR-PDI-6; Pin_Header_Straight_2x03
D1, D2, D7, D8, D9, D18, D19: 4148; Diode_0805_12_SM
D10: B320A-13-F; SMA_Standard
D11: SMBJ16A; SMB_Standard
D12, D14: SBR3U30P1-7; SOD-123
D15: MMSZ4678T1G; SOD-123
D16: BLUE; LED-0805-SM
D17: RED; LED-0805-SM
D20: GREEN; LED-0805-SM
F1: 1.25A; R_1812
F2: 1A; R_1812
FB1, FB2, FB4, FB5, FB6: 220; R_0603_sm
J1: DB9; D09P13B4PA00LF
L3: 5U6; 4.5x4.5mm_Ind
L5: 10U; 4.5x4.5mm_Ind
P5: NVM_RST; R_0603_sm
P6: Board Mount 1; MountingHole_3mm
P7: Ficudial1; Fiducial_1mm_Dia_2.54mm_Outer_CopperTop
P8: USB_A
P9: USB_u; USB_Micro-B-DX4R005JJ2R1800
P10: Board Mount 2; MountingHole_3mm
P11: Ficudial2; Fiducial_1mm_Dia_2.54mm_Outer_CopperTop
P12: Board Mount 3; MountingHole_3mm
P13: Ficudial3; Fiducial_1mm_Dia_2.54mm_Outer_CopperTop
P15: Board Mount 4; MountingHole_3mm
P16: Ficudial4; Fiducial_1mm_Dia_2.54mm_Outer_CopperTop
P17, P19: CUR_SEN; PINHEAD1-2
P18: CONN_02X08; Pin_Header_Straight_2x10
P20: Jumper 1; Fiducial_1mm_Dia_2.54mm_Outer_CopperTop
P21: Jumper 2; Fiducial_1mm_Dia_2.54mm_Outer_CopperTop
P22: CONN_02X04; Pin_Header_Straight_2x04
P23: Jumper 3; Fiducial_1mm_Dia_2.54mm_Outer_CopperTop
P24: Jumper 4; Fiducial_1mm_Dia_2.54mm_Outer_CopperTop
Q1, Q7, Q15, Q16, Q17, Q18, Q19: 2N7000; SOT_23_123
Q2, Q3, Q4, Q13: BSS84; SOT_23_123
Q5: 3906; SOT_23_123
Q6, Q8, Q9, Q10: 2N3904; SOT_23_123
Q11, Q14: IRF9335; SOIC-8_MOS
R1, R79: 12K; R_0603_sm
R2, R10, R18, R64, R77, R81, R97: DNS; R_0603_sm
R3, R11, R59, R67, R68, R76: 0; R_0603_sm
R4, R5, R6, R20, R21, R22, R23, R27, R28, R29, R30, R32, R34, R39, R40, R44, R45, R50, R51, R56, R57, R87: 10K; R_0603_sm
R7: 22K; R_0603_sm
R15: 62K; R_0603_sm
R19, R60, R66, R74, R80, R83, R88, R89, R92, R93, R96: 47K; R_0603_sm
R24: 866; R_0603_sm
R25: 240; R_0603_sm
R26, R35, R36, R37, R38: 2K2; R_0603_sm
R31: 374; R_0603_sm
R33: 8.87K; R_0603_sm
R41, R43, R46, R48, R58, R63: 1K; R_0603_sm
R42: 100K; R_0603_sm
R47: 120; R_0603_sm
R49, R55: 510; R_1210_SM
R52, R53: 100; R_0603_sm
R54: 4.7K; R_0603_sm
R61, R65, R69, R71, R75: 2K0; R_0603_sm
R62, R70, R73: 10K5; R_0603_sm
R72: 6K2; R_0603_sm
R78, R82: 1K0; R_0603_sm
R90, R95: 330; R_0603_sm
R91: 220; R_0603_sm
R94: 22.1; R_0603_sm
SW1: SPST; SW_SPST_A6TN_TH
SW2: SW_PUSH; PTS645VK58-2-LFS
U1: FT4232H; LQFP-64_10x10mm_Pitch0.5mm
U2: 93C46; SOIC-8_3.9x4.9mm_Pitch1.27mm
U5, U6: ESDAxxSC6; SOT-23-6
U7: STN1110; SOIC-28_7.5x17.9mm_Pitch1.27mm
U8: LM339; SOIC-14_3.9x8.7mm_Pitch1.27mm
U9: LM317; SOT-223
U10: MCP2551; SOIC-8_3.9x4.9mm_Pitch1.27mm
U11, U17: XRP6124; SOT-23-5
U12, U15, U16, U18: SLG59M; STDFN-4
U14: ATXMEGA16A4U-A; TQFP-44_10x10mm_Pitch0.8mm
U19: ADXL345; LGA-14_5x3mm
U20: USB2242; QFN-24-1EP_4x4mm_Pitch0.5mm
U21: 74LS126; SOIC-14_3.9x8.7mm_Pitch1.27mm
U22, U23: 74HC595; SOIC-16_3.9x9.9mm_Pitch1.27mm
X1: 12MHz; AWSCR
X2: 16MHz; AWSCR
X3: 24MHz; AWSCR

Connections:
3V3_A: C59.1, C60.1, C61.1, C62.1, C63.1, CON1.2, D15.2, D18.2, FB6.1, P19.1, R87.2, U14.9, U14.19, U14.31, U15.2, U16.2, U18.2, U21.14, U22.16, U23.16
3V3_B: C5.1, C6.1, C7.1, C8.1, C9.1, C55.1, C57.1, FB1.1, FB2.1, R4.2, R5.1, R6.1, R64.2, R77.2, R81.2, R97.2, U1.20, U1.31, U1.36, U1.42, U1.50, U1.56, U2.6, U2.8, U15.3, U20.1, U20.9, U20.16, U20.18
3V3_B_EN: R67.1, U22.1
3V3_C: C36.1, D1.1, FB4.1, Q4.2, R39.1, R41.1, R42.1, U7.13, U16.3
3V3_C_EN: R68.1, U22.2
3V3_D: C53.1, FB5.1, U18.3, U19.1
3V3_D_EN: R76.1, U22.3
3V3_E: C68.1, D19.1, R90.2, R91.2, R95.2
3V3_EN: R65.1, U22.15
3V3_F: C64.1, FB6.2, U14.39
4V1_A: D15.1, P18.15
4V1_EN: P18.16, U22.4
5V0_A: P17.1, Q3.2, U12.2
5V0_B: F2.1, U12.3
5V0_B_EN: R59.1, U22.6
5V0_B_OUT: F2.2, P8.1, R88.2
5V0_EN: U11.1, U22.5
5V0_HOST: P9.1, R19.1
12V0_A: C41.1, F1.1, J1.9, U6.6
12V0_B: C42.1, C43.1, C50.1, D10.1, P18.19, P18.20, Q2.2, Q11.2, Q13.2, Q14.2, R28.1, R29.1, R30.1, R69.1, R74.1, U11.5, U17.5
ACCEL_RXD: U1.38, U14.32
ACCEL_TXD: U1.39, U14.33
ACL_INT1: U14.43, U19.8
ACL_INT2: U14.42, U19.9
BAT_SAMPLE: C30.1, D1.2, D2.1, R15.2, R20.1, U7.2
BUTTON: C65.2, R71.2, U14.40
CAN_3.3V_SW: C37.1, C38.1, Q4.3, R21.1, R27.1, R51.1
CAN_5V_SW: C34.1, C35.1, D8.2, Q3.3, R26.1, R43.1, U8.3, U10.3
CAN_12V_SW: C32.1, C33.1, Q2.3, R15.1, R49.2, R50.1, R55.2, U9.3
CAN_BUF_FTDI: U14.7, U21.4
CAN_BUF_SEQ: U14.6, U21.1
CAN_CLK: U7.9, X2.1
CAN_CLKN: U7.10, X2.2
CAN_H: J1.3, R52.1, SW1.1, U5.1, U10.7
CAN_L: J1.5, R47.1, R53.1, U6.1, U10.6
CAN_POWERDOWN: Q7.2, R39.2, U7.18
CAN_RX: U7.14, U10.4
CAN_RXD: R63.2, U7.16, U21.6
CAN_RXD_FTDI: U1.26, U21.5
CAN_RXD_SEQ: U14.13, U21.2
CAN_TX: R42.2, R43.2, U7.15, U10.1
CAN_TXD: R41.2, U1.27, U7.17, U14.12
EECLK: R6.2, U1.62, U2.2
EECS: R5.2, U1.63, U2.1
EEDATA: R7.2, U1.61, U2.3
FT1V8: C10.1, C11.1, C12.1, C13.1, U1.12, U1.37, U1.49, U1.64
FT3V3PHY: C3.1, C4.1, FB2.2, U1.4
FT3V3PLL: C1.1, C2.1, FB1.2, U1.9
FTDI_DM: P22.1, U1.7
FTDI_DP: P22.2, U1.8
FT_CLK: U1.2, X1.2
FT_CLKN: U1.3, X1.1
GND: C1.2, C2.2, C3.2, C4.2, C5.2, C6.2, C7.2, C8.2, C9.2, C10.2, C11.2, C12.2, C13.2, C29.2, C30.2, C31.2, C32.2, C33.2, C34.2, C35.2, C36.2, C37.2, C38.2, C39.2, C40.2, C41.2, C42.2, C43.2, C45.2, C50.2, C52.2, C53.2, C54.2, C55.2, C56.2, C57.2, C58.2, C59.2, C60.2, C61.2, C62.2, C63.2, C64.2, C65.1, C68.2, CON1.6, D2.2, D9.1, D11.2, D12.2, D14.2, J1.1, J1.2, P5.2, P8.4, P8.5, P9.5, P9.6, P18.1, P18.17, P18.18, Q1.1, Q6.2, Q7.1, Q8.2, Q9.2, Q10.2, Q15.1, Q16.1, Q17.1, Q18.1, Q19.1, R1.2, R20.2, R31.1, R33.1, R54.2, R56.2, R60.2, R61.1, R70.1, R73.1, R75.2, R79.1, R80.2, R83.1, R89.1, R92.1, R93.1, R96.1, SW2.S, U1.1, U1.5, U1.10, U1.11, U1.13, U1.15, U1.25, U1.35, U1.47, U1.51, U1.60, U2.5, U5.2, U5.5, U6.2, U6.5, U7.8, U7.19, U7.27, U8.12, U10.2, U11.2, U12.4, U14.8, U14.18, U14.30, U14.38, U15.4, U16.4, U17.2, U18.4, U19.2, U19.4, U19.5, U20.25, U21.7, U22.8, U22.13, U23.8, U23.13, X1.3, X2.3, X3.3
HOST_SC: R88.1, R89.2, U14.5
HUB_CLK: U20.22, X3.2
HUB_CLKN: U20.21, X3.1
HUB_DM: P9.2, U20.19
HUB_DP: P9.3, U20.20
HUB_ENABLE: R18.1, U23.15
HUB_PWR_PRT1: R3.1, R81.1, R82.1, R83.2, U20.7
HUB_PWR_PRT2: R11.2, U20.11
HUB_SCL: R64.1, U14.29, U20.14
HUB_SDA: R97.1, U14.28, U20.13
HUB_STATUS: R82.2, U14.44
HUB_SUSP: R78.2, U14.1
HUB_SUSP_IND: R77.1, R78.1, R80.1, U20.17
ISO_K_TX: R58.1, U7.25
ISO_L_TX: R48.1, U7.26
ISO_RX: R51.2, U7.11, U8.13
J1850+: D7.1, J1.7, R34.2, R44.1, U5.6
J1850-: J1.6, Q8.3, R45.2, U5.4
J1850_BUS_+_TX: R22.2, R40.2, U7.6
J1850_BUS_-_TX: R23.2, R46.2, U7.7
K-LINE: J1.4, Q10.3, R55.1, R57.2, U6.4
L-LINE: J1.8, Q9.3, R49.1, U5.3
unnamed: C29.1, FB4.2, U7.28
unnamed: C31.1, U7.20
unnamed: C39.1, R52.2
unnamed: C40.1, R53.2
unnamed: C44.1, C45.1, L3.2, P17.2, R62.2
unnamed: C44.2, R61.2, R62.1, U11.3
unnamed: C51.1, C52.1, L5.2, P19.2, R72.1
unnamed: C51.2, R72.2, R75.1, U17.3
unnamed: C54.1, FB5.2, U19.6
unnamed: C56.1, U20.23
unnamed: C58.1, U20.10
unnamed: C69.1, D18.1, D19.2
unnamed: C69.2, R94.1
unnamed: D7.2, Q5.3
unnamed: D8.1, R45.1
unnamed: D9.2, R44.2
unnamed: D10.2, D11.1, F1.2
unnamed: D12.1, L3.1, Q11.3
unnamed: D14.1, L5.1, Q14.3
unnamed: D16.1, Q17.3
unnamed: D16.2, R90.1
unnamed: D17.1, Q18.3
unnamed: D17.2, R91.1
unnamed: D20.1, Q19.3
unnamed: D20.2, R95.1
unnamed: P5.1, U7.21
unnamed: Q1.3, R24.2, R31.2
unnamed: Q2.1, R28.2, R35.1
unnamed: Q3.1, R29.2, R36.1
unnamed: Q4.1, R30.2, R37.1
unnamed: Q5.1, R32.2, R38.1
unnamed: Q5.2, R25.1, R32.1, U9.2
unnamed: Q6.1, R40.1
unnamed: Q6.3, R38.2
unnamed: Q7.3, R35.2, R36.2, R37.2
unnamed: Q8.1, R46.1
unnamed: Q9.1, R48.2
unnamed: Q10.1, R58.2
unnamed: Q11.1, U11.4
unnamed: Q13.1, Q15.3, R69.2
unnamed: Q13.3, R66.2
unnamed: Q14.1, U17.4
unnamed: Q15.2, R71.1, R73.2, SW2.1
unnamed: R1.1, U1.6
unnamed: R2.1, R3.2, U1.14
unnamed: R4.1, R7.1, U2.4
unnamed: R22.1, U8.5
unnamed: R23.1, U8.4
unnamed: R24.1, R25.2, U9.1
unnamed: R26.2, R33.2, U8.7
unnamed: R34.1, U8.6
unnamed: R47.2, SW1.2
unnamed: R50.2, R56.1, U8.11
unnamed: R54.1, U10.8
unnamed: R57.1, U8.10
unnamed: R59.2, U12.1
unnamed: R63.1, U21.3
unnamed: R65.2, R66.1, R70.2, U17.1
unnamed: R67.2, U15.1
unnamed: R68.2, U16.1
unnamed: R74.2, SW2.2
unnamed: R76.2, U18.1
unnamed: R79.2, U20.24
unnamed: U22.9, U23.14
PDI: CON1.1, U14.34
PWM/~VPW: Q1.2, U7.3
PWM_RX: R21.2, U7.5, U8.2
SEQ_CHGPUMP: R94.2, U14.41
SEQ_LED1: Q19.2, R96.2, U14.2
SEQ_LED2: Q17.2, R92.2, U14.3
SEQ_LED3: Q18.2, R93.2, U14.4
SEQ_MISO: U14.16, U19.12
SEQ_MOSI: U14.15, U19.13, U22.14
SEQ_RESET: CON1.5, U14.35
SEQ_RXD: P22.7, U1.16
SEQ_RXD_DM: P22.5, U14.26
SEQ_SCK: U14.17, U19.14, U22.11, U23.11
SEQ_SS: U14.14, U19.7
SEQ_TXD: P22.8, U1.17
SEQ_TXD_DP: P22.6, U14.27
SEQ_WAKE: P18.10, U14.20
SIMCARD: P18.3, U14.25
SIM_DM: P18.7, U20.4
SIM_DP: P18.9, U20.5
SIM_NET: P18.12, U14.21
SIM_PWR: P18.14, U14.24
SIM_PWR_ON: Q16.2, U23.3
SIM_RF_OFF: P18.4, U23.5
SIM_RXD: P18.11, U14.23
SIM_TXD: P18.13, U14.22
SIM_USB_DET: P18.5, R10.1, R11.1
SIM_VBUS: R10.2, U23.6
SIM_WAKE: P18.2, U22.7
SR_CLEAR: U14.10, U22.10, U23.10
SR_LATCH: U14.11, U22.12, U23.12
USB_INT_DM: P22.3, U20.2
USB_INT_DP: P22.4, U20.3
~CAN_RESET: U7.1, U23.2
~CAN_SLEEP: U7.12, U23.1
~FTDI_RESET: R2.2, U23.7
~HUB_RESET: R18.2, R19.2, R60.1, U20.15
~SIM_PWR_ON: P18.6, Q16.3, R87.1
~SIM_RESET: P18.8, U23.4
~VPW_RX: R27.2, U7.4, U8.1
