jbanks2/rvi_v2x_board/Hardware/Make Files/V1.0 Ordered/OBD2_SMS.kicad_pcb

## KiCad design Hardware/Make Files/V1.0 Ordered/OBD2_SMS.kicad_pcb (2015-09-03, an earlier design)

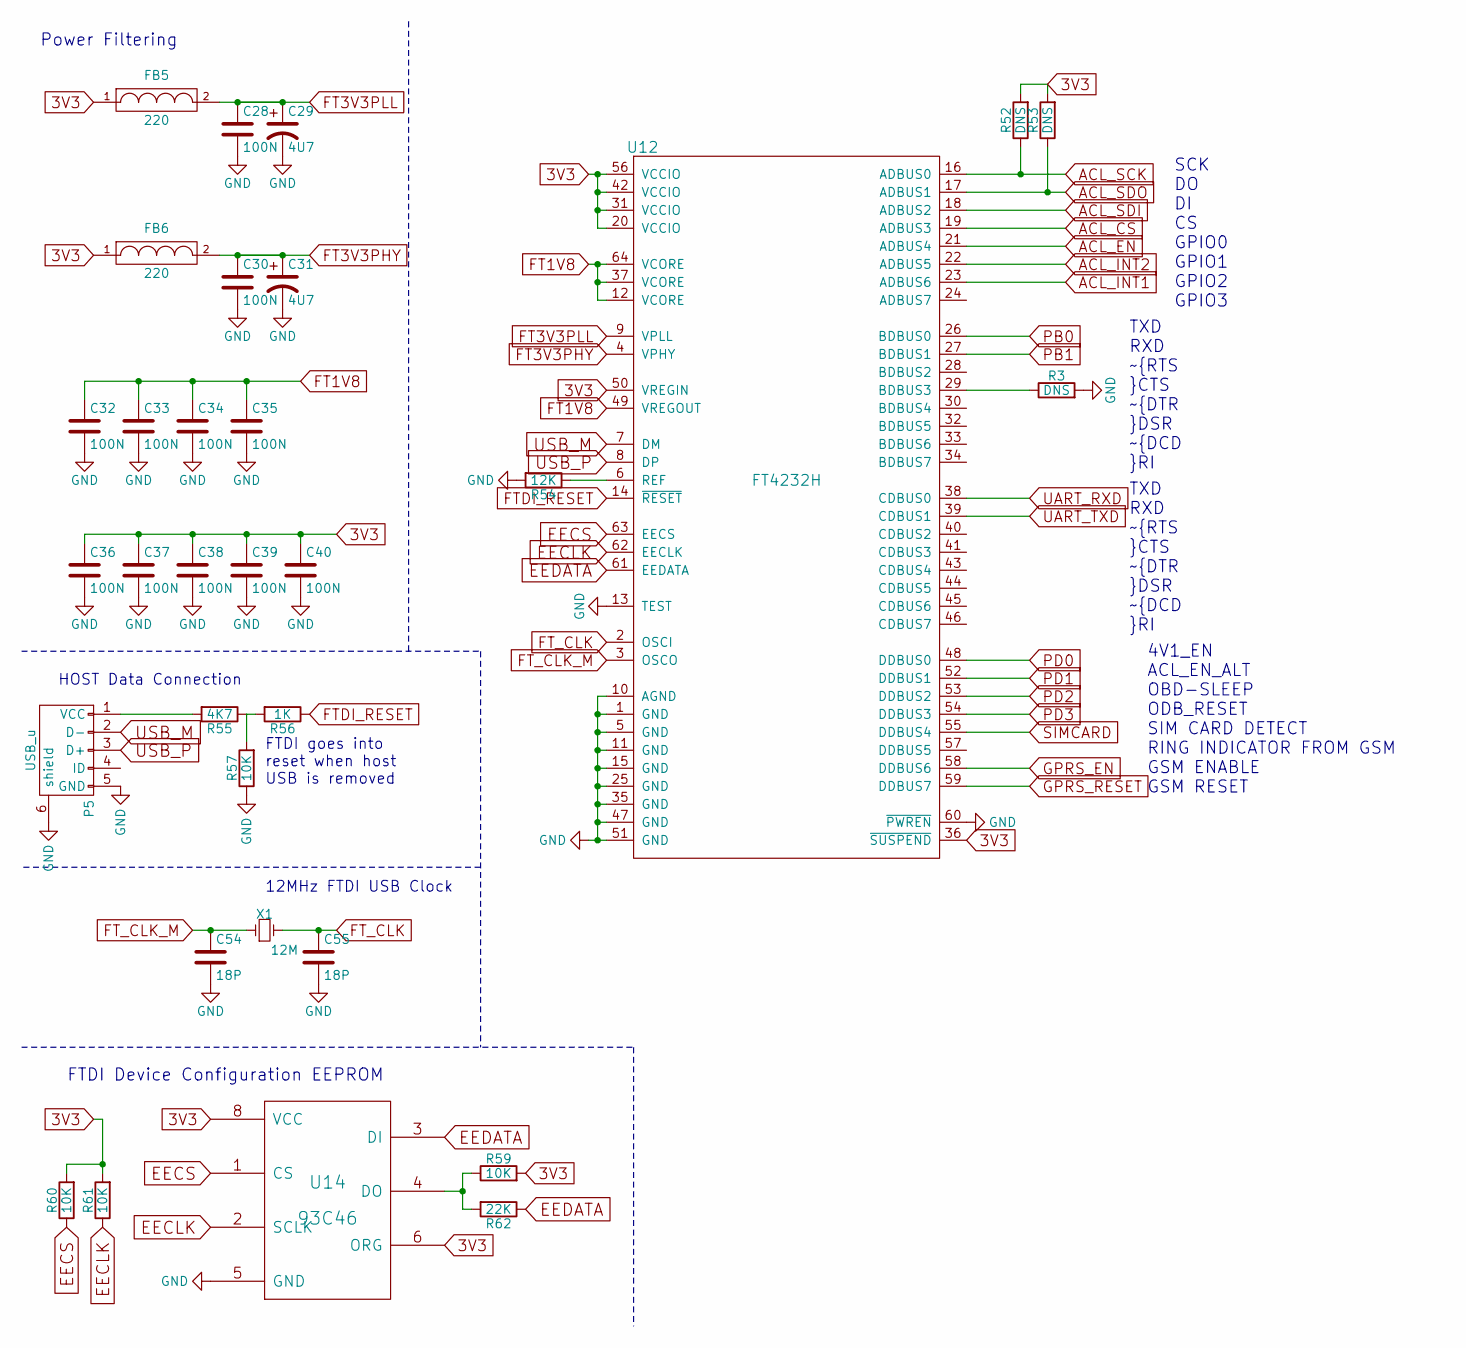
[picture p76: schematic OBD2_SMS_FTDI.sch, OBD2-SMS - Open source RVI over SMS daughter card]

Parts:
C28, C30, C32, C33, C34, C35, C36, C37, C38, C39, C40: 100N; C_0603
C29, C31: 4U7; C_0805
C54, C55: 18P; C_0603
FB5, FB6: 220; C_0805
P5: USB_u; USB_Micro-B
R3, R52, R53: DNS; R_0603
R54: 12K; R_0603
R55: 4K7; R_0603
R56: 1K; R_0603
R57, R59, R60, R61: 10K; R_0603
R62: 22K; R_0603
U12: FT4232H; LQFP-64_10x10mm_Pitch0.5mm
U14: 93C46; SOIC-8_3.9x4.9mm_Pitch1.27mm
X1: 12M; ABLS7M

Connections:
3V3: C36.1, C37.1, C38.1, C39.1, C40.1, FB5.1, FB6.1, R52.2, R53.2, R59.2, R60.2, R61.2, U12.20 (VCCIO), U12.31 (VCCIO), U12.36 (~SUSPEND), U12.42 (VCCIO), U12.50 (VREGIN), U12.56 (VCCIO), U14.6 (ORG), U14.8 (VCC); also elsewhere on the board
ACL_CS: U12.19 (ADBUS3); also elsewhere on the board
ACL_EN: U12.21 (ADBUS4); also elsewhere on the board
ACL_INT1: U12.23 (ADBUS6); also elsewhere on the board
ACL_INT2: U12.22 (ADBUS5); also elsewhere on the board
ACL_SCK: R52.1, U12.16 (ADBUS0); also elsewhere on the board
ACL_SDI: U12.18 (ADBUS2); also elsewhere on the board
ACL_SDO: R53.1, U12.17 (ADBUS1); also elsewhere on the board
EECLK: R61.1, U12.62 (EECLK), U14.2 (SCLK)
EECS: R60.1, U12.63 (EECS), U14.1 (CS)
EEDATA: R62.1, U12.61 (EEDATA), U14.3 (DI)
FT1V8: C32.1, C33.1, C34.1, C35.1, U12.12 (VCORE), U12.37 (VCORE), U12.49 (VREGOUT), U12.64 (VCORE)
FT3V3PHY: C30.1, C31.1, FB6.2, U12.4 (VPHY)
FT3V3PLL: C28.1, C29.1, FB5.2, U12.9 (VPLL)
FTDI_RESET: R56.1, U12.14 (~RESET); also elsewhere on the board
FT_CLK: C55.1, U12.2 (OSCI), X1.2
FT_CLK_M: C54.1, U12.3 (OSCO), X1.1
GND: C28.2, C29.2, C30.2, C31.2, C32.2, C33.2, C34.2, C35.2, C36.2, C37.2, C38.2, C39.2, C40.2, C54.2, C55.2, P5.5 (GND), P5.6 (shield), R3.2, R54.2, R57.1, U12.1 (GND), U12.5 (GND), U12.10 (AGND), U12.11 (GND), U12.13 (TEST), U12.15 (GND), U12.25 (GND), U12.35 (GND), U12.47 (GND), U12.51 (GND), U12.60 (~PWREN), U14.5 (GND); also elsewhere on the board
GPRS_EN: U12.58 (DDBUS6); also elsewhere on the board
GPRS_RESET: U12.59 (DDBUS7); also elsewhere on the board
unnamed: P5.1 (VCC), R55.2
unnamed: R3.1, U12.29 (BDBUS3)
unnamed: R54.1, U12.6 (REF)
unnamed: R55.1, R56.2, R57.2
unnamed: R59.1, R62.2, U14.4 (DO)
PB0: U12.26 (BDBUS0); also elsewhere on the board
PB1: U12.27 (BDBUS1); also elsewhere on the board
PD0: U12.48 (DDBUS0); also elsewhere on the board
PD1: U12.52 (DDBUS1); also elsewhere on the board
PD2: U12.53 (DDBUS2); also elsewhere on the board
PD3: U12.54 (DDBUS3); also elsewhere on the board
SIMCARD: U12.55 (DDBUS4); also elsewhere on the board
UART_RXD: U12.38 (CDBUS0); also elsewhere on the board
UART_TXD: U12.39 (CDBUS1); also elsewhere on the board
USB_M: P5.2 (D-), U12.7 (DM)
USB_P: P5.3 (D+), U12.8 (DP)

Notes on the sheet:
TXD RXD ~RTS ~CTS ~DTR ~DSR ~DCD ~RI
SCK DO DI CS GPIO0 GPIO1 GPIO2 GPIO3
Power Filtering
FTDI Device Configuration EEPROM
HOST Data Connection
FTDI goes into reset when host USB is removed
12MHz FTDI USB Clock
4V1_EN ACL_EN_ALT OBD-SLEEP ODB_RESET SIM CARD DETECT RING INDICATOR FROM GSM GSM ENABLE GSM RESET

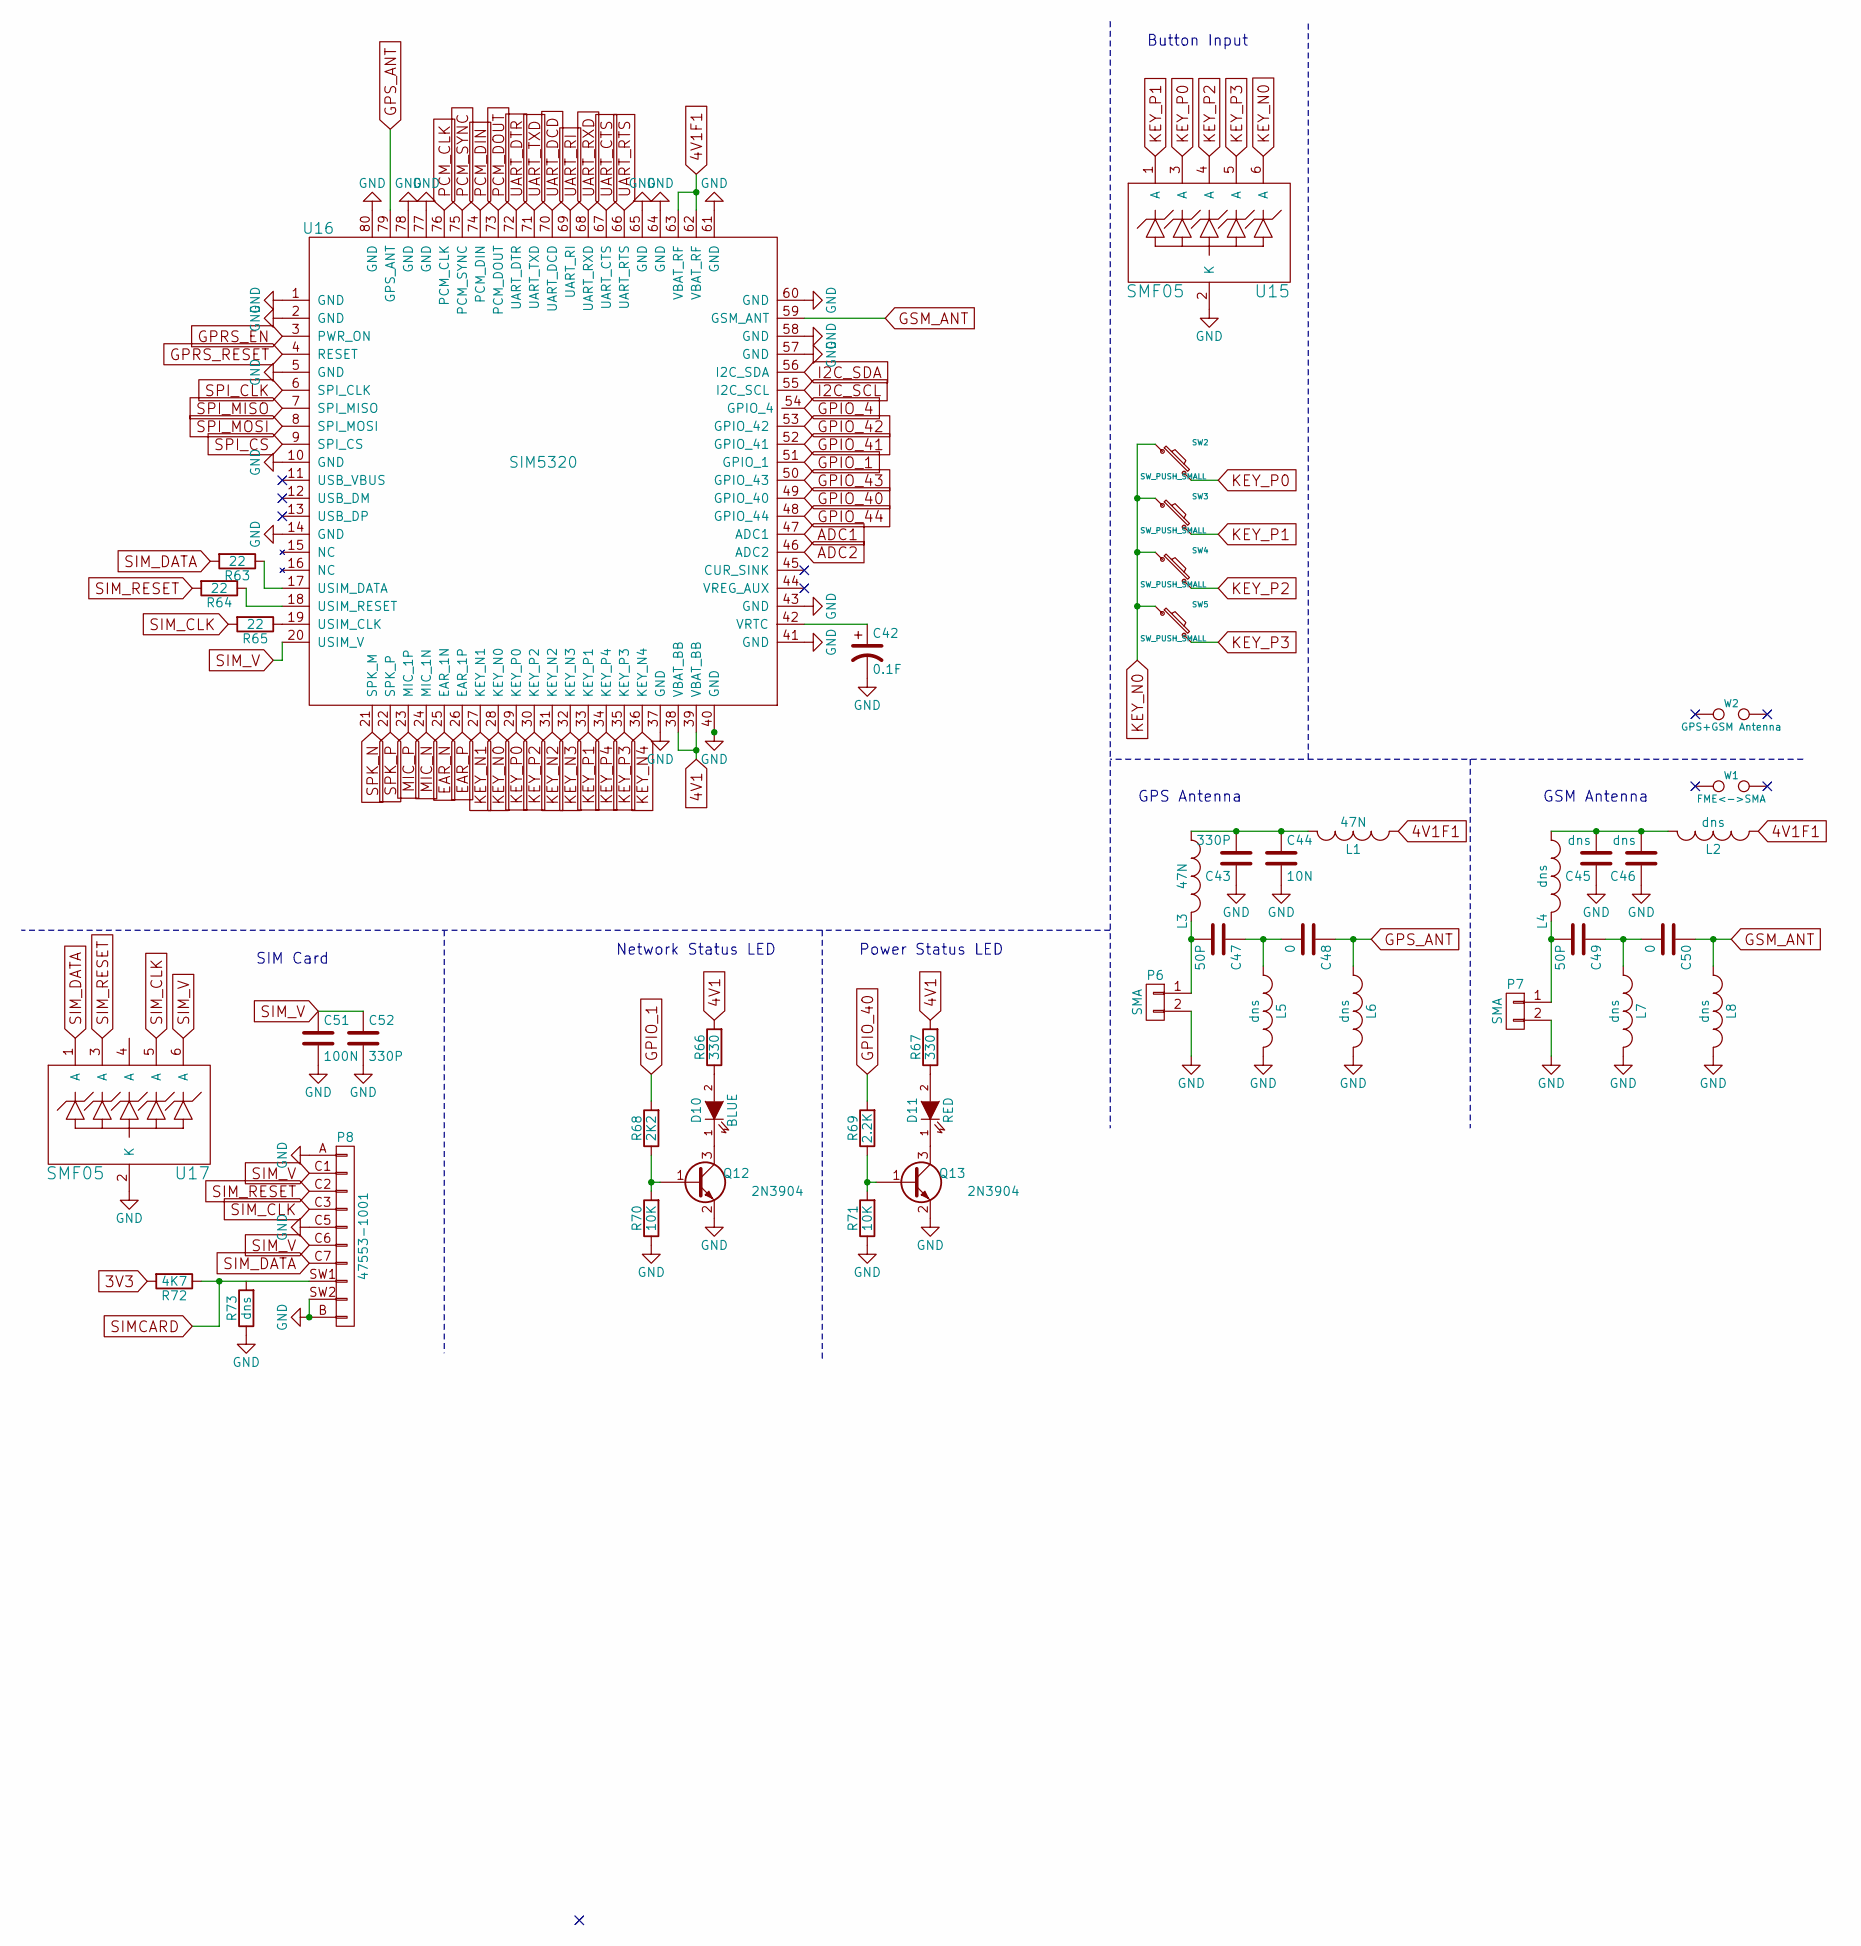
[picture p77: schematic OBD2_SMS_GPRS.sch, OBD2-SMS - Open source RVI over SMS daughter card]

Parts:
C42: 0.1F; C_Radial_D12.5_L25_P5
C43, C52: 330P; C_0603
C44: 10N; C_0603
C45, C46: dns; C_0603
C47, C49: 50P; C_0603
C48, C50: 0; C_0603
C51: 100N; C_0603
D10: BLUE; LED-0805
D11: RED; LED-0805
L1, L3: 47N; C_0805
L2, L4, L5, L6, L7, L8: dns; C_0805
P6, P7: SMA; SMA-RA_142-0701-801
P8: 47553-1001; FSM006-2610
Q12, Q13: 2N3904; SOT-23
R63, R64, R65: 22; R_0603
R66, R67: 330; R_0603
R68: 2K2; R_0603
R69: 2.2K; R_0603
R70, R71: 10K; R_0603
R72: 4K7; R_0603
R73: dns; R_0603
SW2, SW3, SW4, SW5: SW_PUSH_SMALL; SW_SPST_FSMSM
U15, U17: SMF05; SC-70-6_Handsoldering
U16: SIM5320
W1: FME<->SMA
W2: GPS+GSM Antenna

Connections:
3V3: R72.2; also elsewhere on the board
4V1: R66.2, R67.2, U16.38 (VBAT_BB), U16.39 (VBAT_BB); also elsewhere on the board
4V1F1: L1.1, L2.1, U16.62 (VBAT_RF), U16.63 (VBAT_RF); also elsewhere on the board
ADC1: U16.47 (ADC1)
ADC2: U16.46 (ADC2)
EAR_N: U16.25 (EAR_1N)
EAR_P: U16.26 (EAR_1P)
GND: C42.2, C43.1, C44.2, C45.1, C46.1, C51.2, C52.2, L5.2, L6.2, L7.2, L8.2, P6.2, P7.2, P8.A, P8.B, P8.C5, P8.SW2, Q12.2 (E), Q13.2 (E), R70.1, R71.1, R73.1, U15.2 (K), U16.1 (GND), U16.2 (GND), U16.5 (GND), U16.10 (GND), U16.14 (GND), U16.37 (GND), U16.40 (GND), U16.41 (GND), U16.43 (GND), U16.57 (GND), U16.58 (GND), U16.60 (GND), U16.61 (GND), U16.64 (GND), U16.65 (GND), U16.77 (GND), U16.78 (GND), U16.80 (GND), U17.2 (K); also elsewhere on the board
GPIO_1: R68.2, U16.51 (GPIO_1)
GPIO_4: U16.54 (GPIO_4)
GPIO_40: R69.2, U16.49 (GPIO_40)
GPIO_41: U16.52 (GPIO_41)
GPIO_42: U16.53 (GPIO_42)
GPIO_43: U16.50 (GPIO_43)
GPIO_44: U16.48 (GPIO_44)
GPRS_EN: U16.3 (PWR_ON); also elsewhere on the board
GPRS_RESET: U16.4 (RESET); also elsewhere on the board
GPS_ANT: C48.1, L6.1, U16.79 (GPS_ANT)
GSM_ANT: C50.1, L8.1, U16.59 (GSM_ANT)
I2C_SCL: U16.55 (I2C_SCL)
I2C_SDA: U16.56 (I2C_SDA)
KEY_N0: SW2.1, SW3.1, SW4.1, SW5.1, U15.6 (A), U16.28 (KEY_N0)
KEY_N1: U16.27 (KEY_N1)
KEY_N2: U16.31 (KEY_N2)
KEY_N3: U16.32 (KEY_N3)
KEY_N4: U16.36 (KEY_N4)
KEY_P0: SW2.2, U15.3 (A), U16.29 (KEY_P0)
KEY_P1: SW3.2, U15.1 (A), U16.33 (KEY_P1)
KEY_P2: SW4.2, U15.4 (A), U16.30 (KEY_P2)
KEY_P3: SW5.2, U15.5 (A), U16.35 (KEY_P3)
KEY_P4: U16.34 (KEY_P4)
MIC_N: U16.24 (MIC_1N)
MIC_P: U16.23 (MIC_1P)
unnamed: C42.1, U16.42 (VRTC)
unnamed: C43.2, C44.1, L1.2, L3.1
unnamed: C45.2, C46.2, L2.2, L4.1
unnamed: C47.1, C48.2, L5.1
unnamed: C47.2, L3.2, P6.1
unnamed: C49.1, C50.2, L7.1
unnamed: C49.2, L4.2, P7.1
unnamed: D10.1 (K), Q12.3 (C)
unnamed: D10.2 (A), R66.1
unnamed: D11.1 (K), Q13.3 (C)
unnamed: D11.2 (A), R67.1
unnamed: Q12.1 (B), R68.1, R70.2
unnamed: Q13.1 (B), R69.1, R71.2
unnamed: R63.1, U16.17 (USIM_DATA)
unnamed: R64.1, U16.18 (USIM_RESET)
unnamed: R65.1, U16.19 (USIM_CLK)
PCM_CLK: U16.76 (PCM_CLK)
PCM_DIN: U16.74 (PCM_DIN)
PCM_DOUT: U16.73 (PCM_DOUT)
PCM_SYNC: U16.75 (PCM_SYNC)
SIMCARD: P8.SW1, R72.1; also elsewhere on the board
SIM_CLK: P8.C3, R65.2, U17.5 (A)
SIM_DATA: P8.C7, R63.2, U17.1 (A)
SIM_RESET: P8.C2, R64.2, U17.3 (A)
SIM_V: C51.1, C52.1, P8.C1, P8.C6, U16.20 (USIM_V), U17.6 (A)
SPI_CLK: U16.6 (SPI_CLK)
SPI_CS: U16.9 (SPI_CS)
SPI_MISO: U16.7 (SPI_MISO)
SPI_MOSI: U16.8 (SPI_MOSI)
SPK_N: U16.21 (SPK_M)
SPK_P: U16.22 (SPK_P)
UART_CTS: U16.67 (UART_CTS)
UART_DCD: U16.70 (UART_DCD)
UART_DTR: U16.72 (UART_DTR)
UART_RI: U16.69 (UART_RI)
UART_RTS: U16.66 (UART_RTS)
UART_RXD: U16.68 (UART_RXD); also elsewhere on the board
UART_TXD: U16.71 (UART_TXD); also elsewhere on the board

Notes on the sheet:
SIM Card
Network Status LED
Button Input
Power Status LED
GPS Antenna
GSM Antenna

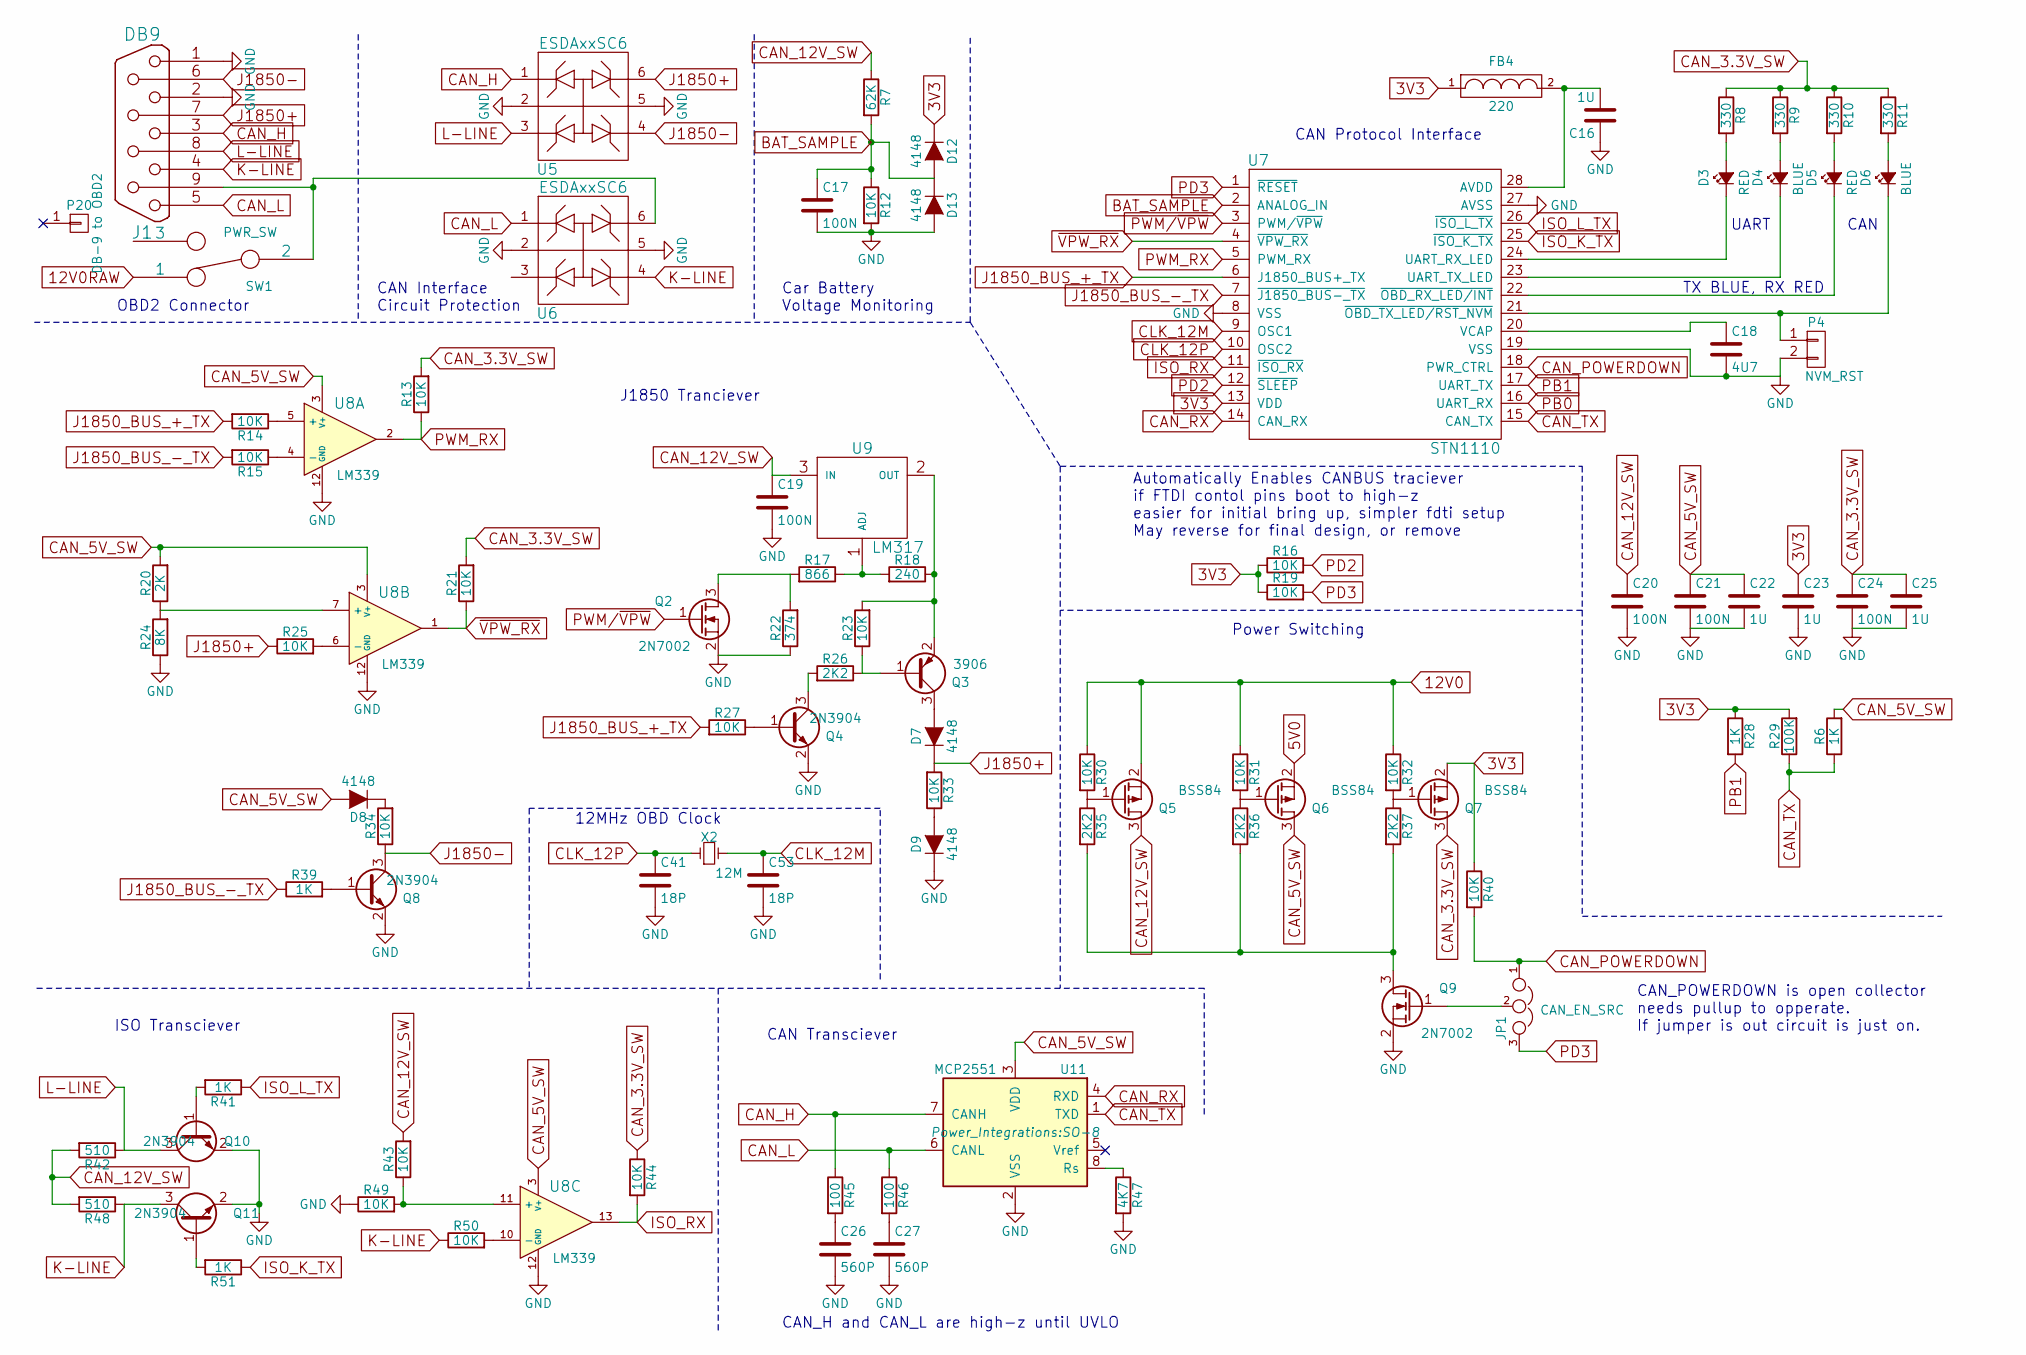
[picture p78: schematic OBD2_SMS_OBD2.sch, OBD2-SMS - Open source RVI over SMS daughter card]

Parts:
C16, C22, C23, C25: 1U; C_0603
C17, C19, C20, C21, C24: 100N; C_0603
C18: 4U7; C_0805
C26, C27: 560P; C_0603
C41, C53: 18P; C_0603
D3, D5: RED; LED-0805
D4, D6: BLUE; LED-0805
D7, D8, D9, D12, D13: 4148; Diode_0805_12
FB4: 220; C_0805
J1: DB9; DB9MC
JP1: CAN_EN_SRC; PINHEAD1-3
P4: NVM_RST; PINHEAD1-2
P20: DB-9 to OBD2
Q2, Q9: 2N7002; SOT-23
Q3: 3906; SOT-23
Q4, Q8, Q10, Q11: 2N3904; SOT-23
Q5, Q6, Q7: BSS84; SOT-23
R6, R28, R39, R41, R51: 1K; R_0603
R7: 62K; R_0603
R8, R9, R10, R11: 330; R_0603
R12, R13, R14, R15, R16, R19, R21, R23, R25, R27, R30, R31, R32, R33, R34, R40, R43, R44, R49, R50: 10K; R_0603
R17: 866; R_0603
R18: 240; R_0603
R20: 2K; R_0603
R22: 374; R_0603
R24: 8K; R_0603
R26, R35, R36, R37: 2K2; R_0603
R29: 100K; R_0603
R42, R48: 510; R_1210
R45, R46: 100; R_0603
R47: 4K7; R_0603
SW1: PWR_SW; SW-1552.4606
U5, U6: ESDAxxSC6; SOT-23-6
U7: STN1110; SOIC-28_7.5x17.9mm_Pitch1.27mm
U8: LM339; SOIC-14_3.9x8.7mm_Pitch1.27mm
U9: LM317; SOT-223
U11: MCP2551; SO-8
X2: 12M; ABLS7M

Connections:
3V3: C23.1, D12.1 (K), FB4.1, Q7.2 (S), R16.1, R19.1, R28.1, R29.2, R40.1, U7.13 (VDD); also elsewhere on the board
5V0: Q6.2 (S); also elsewhere on the board
12V0: Q5.2 (S), R30.1, R31.1, R32.1; also elsewhere on the board
12V0RAW: SW1.1; also elsewhere on the board
BAT_SAMPLE: C17.1, D12.2 (A), D13.1 (K), R7.2, R12.1, U7.2 (ANALOG_IN)
CAN_3.3V_SW: C24.1, C25.1, Q7.3 (D), R8.1, R9.1, R10.1, R11.1, R13.2, R21.2, R44.1
CAN_5V_SW: C21.1, C22.1, D8.2 (A), Q6.3 (D), R6.2, R20.2, U8.3 (V+), U11.3 (VDD)
CAN_12V_SW: C19.1, C20.1, Q5.3 (D), R7.1, R42.2, R43.2, R48.2, U9.3 (IN)
CAN_H: J1.3, R45.1, U5.1 (A1), U11.7 (CANH)
CAN_L: J1.5, R46.1, U6.1 (A1), U11.6 (CANL)
CAN_POWERDOWN: JP1.1, R40.2, U7.18 (PWR_CTRL)
CAN_RX: U7.14 (CAN_RX), U11.4 (RXD)
CAN_TX: R6.1, R29.1, U7.15 (CAN_TX), U11.1 (TXD)
CLK_12M: C53.1, U7.9 (OSC1), X2.2
CLK_12P: C41.1, U7.10 (OSC2), X2.1
GND: C16.1, C17.2, C18.2, C19.2, C20.2, C21.2, C22.2, C23.2, C24.2, C25.2, C26.2, C27.2, C41.2, C53.2, D9.1 (K), D13.2 (A), J1.1, J1.2, P4.2, Q2.2 (S), Q4.2 (E), Q8.2 (E), Q9.2 (S), Q10.2 (E), Q11.2 (E), R12.2, R22.1, R24.1, R47.2, R49.1, U5.2 (K), U5.5 (K2), U6.2 (K), U6.5 (K2), U7.8 (VSS), U7.19 (VSS), U7.27 (AVSS), U8.12 (GND), U11.2 (VSS); also elsewhere on the board
ISO_K_TX: R51.1, U7.25 (~ISO_K_TX)
ISO_L_TX: R41.1, U7.26 (~ISO_L_TX)
ISO_RX: R44.2, U7.11 (~ISO_RX), U8.13
J1850+: D7.1 (K), J1.7, R25.1, R33.2, U5.6 (A4)
J1850-: J1.6, Q8.3 (C), R34.1, U5.4 (A4)
J1850_BUS_+_TX: R14.2, R27.2, U7.6 (J1850_BUS+_TX)
J1850_BUS_-_TX: R15.2, R39.1, U7.7 (~J1850_BUS-_TX)
K-LINE: J1.4, Q11.3 (C), R48.1, R50.1, U6.4 (A4)
L-LINE: J1.8, Q10.3 (C), R42.1, U5.3 (A2)
unnamed: C16.2, FB4.2, U7.28 (AVDD)
unnamed: C18.1, U7.20 (VCAP)
unnamed: C26.1, R45.2
unnamed: C27.1, R46.2
unnamed: D3.1 (K), U7.24 (UART_RX_LED)
unnamed: D3.2 (A), R8.2
unnamed: D4.1 (K), U7.23 (UART_TX_LED)
unnamed: D4.2 (A), R9.2
unnamed: D5.1 (K), U7.22 (~OBD_RX_LED/INT)
unnamed: D5.2 (A), R10.2
unnamed: D6.1 (K), P4.1, U7.21 (~OBD_TX_LED/RST_NVM)
unnamed: D6.2 (A), R11.2
unnamed: D7.2 (A), Q3.3 (C)
unnamed: D8.1 (K), R34.2
unnamed: D9.2 (A), R33.1
unnamed: J1.9, SW1.2, U6.6 (A4)
unnamed: JP1.2, Q9.1 (G)
unnamed: Q2.3 (D), R17.2, R22.2
unnamed: Q3.1 (B), R23.1, R26.1
unnamed: Q3.2 (E), R18.1, R23.2, U9.2 (OUT)
unnamed: Q4.1 (B), R27.1
unnamed: Q4.3 (C), R26.2
unnamed: Q5.1 (G), R30.2, R35.1
unnamed: Q6.1 (G), R31.2, R36.1
unnamed: Q7.1 (G), R32.2, R37.1
unnamed: Q8.1 (B), R39.2
unnamed: Q9.3 (D), R35.2, R36.2, R37.2
unnamed: Q10.1 (B), R41.2
unnamed: Q11.1 (B), R51.2
unnamed: R14.1, U8.5 (+)
unnamed: R15.1, U8.4 (-)
unnamed: R17.1, R18.2, U9.1 (ADJ)
unnamed: R20.1, R24.2, U8.7 (+)
unnamed: R25.2, U8.6 (-)
unnamed: R43.1, R49.2, U8.11 (+)
unnamed: R47.1, U11.8 (Rs)
unnamed: R50.2, U8.10 (-)
PB0: U7.16 (UART_RX); also elsewhere on the board
PB1: R28.2, U7.17 (UART_TX); also elsewhere on the board
PD2: R16.2, U7.12 (~SLEEP); also elsewhere on the board
PD3: JP1.3, R19.2, U7.1 (~RESET); also elsewhere on the board
PWM/~VPW: Q2.1 (G), U7.3 (PWM/~VPW)
PWM_RX: R13.1, U7.5 (PWM_RX), U8.2
~VPW_RX: R21.1, U7.4 (~VPW_RX), U8.1

Notes on the sheet:
TX BLUE, RX RED
UART
CAN
OBD2 Connector
CAN Transciever
ISO Transciever
CAN_H and CAN_L are high-z until UVLO
Automatically Enables CANBUS traciever if FTDI contol pins boot to high-z easier for initial bring up, simpler fdti setup May reverse for final design, or remove
Power Switching
CAN Protocol Interface
J1850 Tranciever
CAN Interface Circuit Protection
Car Battery Voltage Monitoring
12MHz OBD Clock
CAN_POWERDOWN is open collector needs pullup to opperate. If jumper is out circuit is just on.

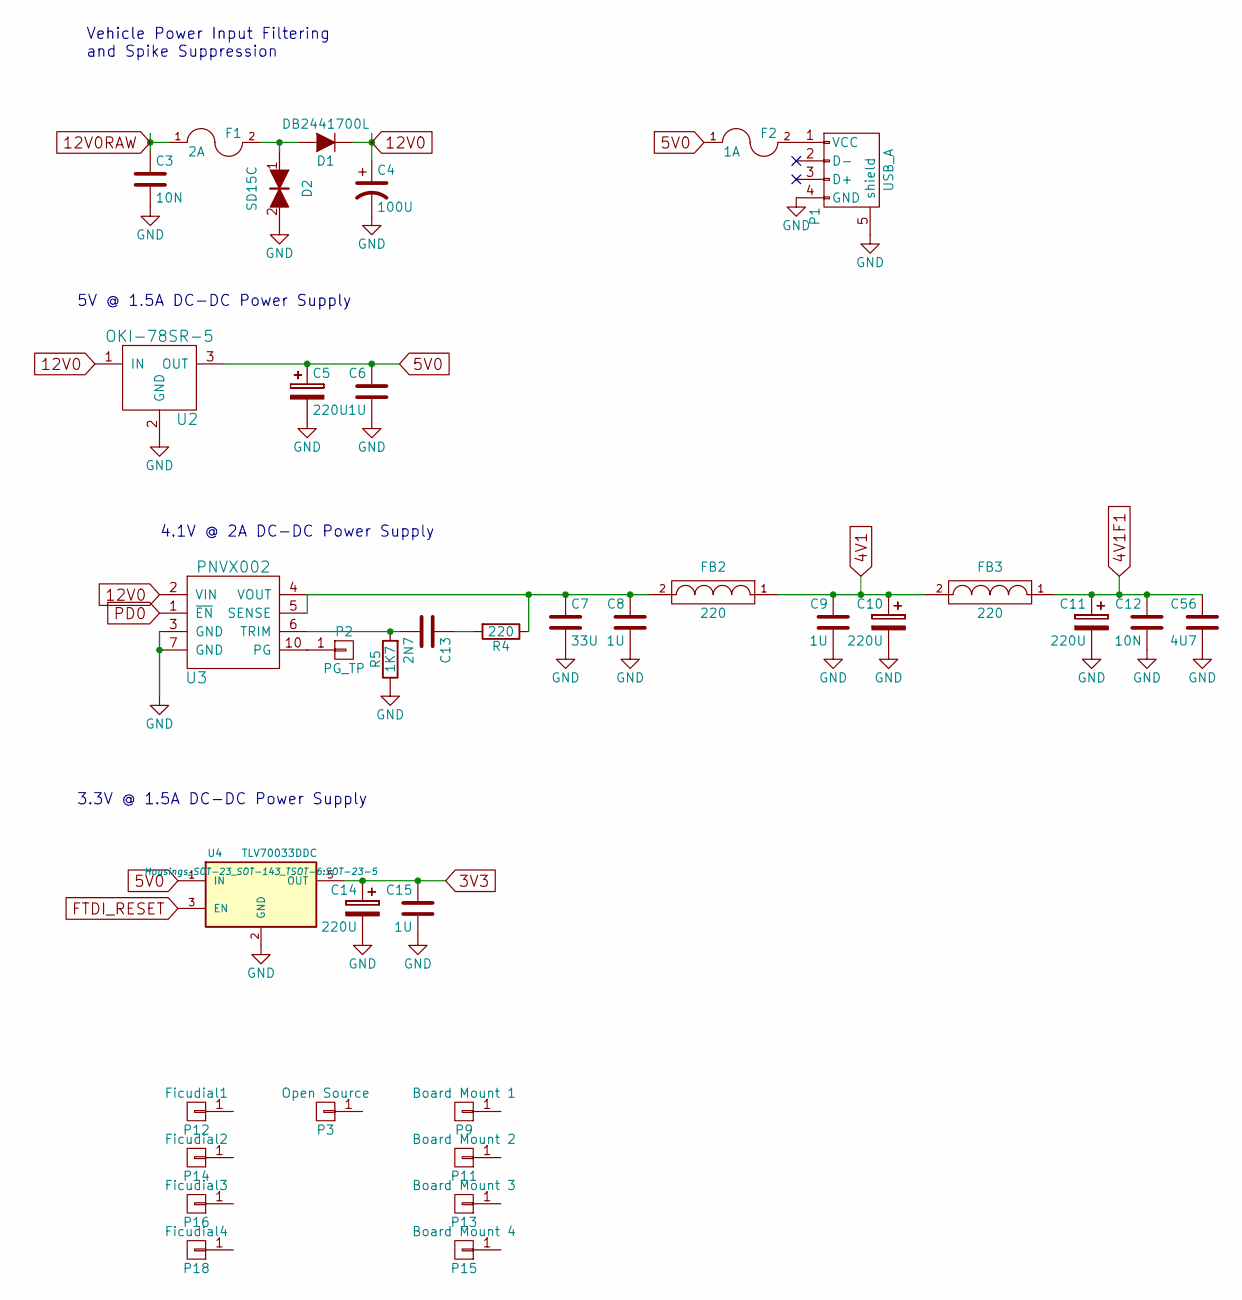
[picture p79: schematic OBD2_SMS_PWR.sch, OBD2-SMS - Open source RVI over SMS daughter card]

Parts:
C3, C12: 10N; C_0603
C4: 100U; TantalC_SizeD_EIA-7343_Reflow
C5, C10, C11, C14: 220U; c_elec_6.3x5.8
C6, C8, C9, C15: 1U; C_0603
C7: 33U; C_1210
C13: 2N7; C_0603
C56: 4U7; C_0603
D1: DB2441700L; Diode-SMC_Standard
D2: SD15C; SOD-323
F1: 2A; R_1812
F2: 1A; R_1210
FB2, FB3: 220; C_0805
P1: USB_A
P2: PG_TP; Measurement_Point_Round-SMD-Pad_Small
P3: Open Source; Symbol_OSHW-Logo_CopperTop_BIG
P9: Board Mount 1; MountingHole_3mm
P11: Board Mount 2; MountingHole_3mm
P12: Ficudial1; Fiducial_1mm_Dia_2.54mm_Outer_CopperTop
P13: Board Mount 3; MountingHole_3mm
P14: Ficudial2; Fiducial_1mm_Dia_2.54mm_Outer_CopperTop
P15: Board Mount 4; MountingHole_3mm
P16: Ficudial3; Fiducial_1mm_Dia_2.54mm_Outer_CopperTop
P18: Ficudial4; Fiducial_1mm_Dia_2.54mm_Outer_CopperTop
R4: 220; R_0603
R5: 1K7; R_0603
U2: OKI-78SR-5; TO-220_OKI-78SR
U3: PNVX002
U4: TLV70033DDC; SOT-23-5

Connections:
3V3: C14.1, C15.1, U4.5 (OUT); also elsewhere on the board
4V1: C9.1, C10.1, FB2.1, FB3.2; also elsewhere on the board
4V1F1: C11.1, C12.1, C56.1, FB3.1; also elsewhere on the board
5V0: C5.1, C6.1, F2.1, U2.3 (OUT), U4.1 (IN); also elsewhere on the board
12V0: C4.1, D1.1 (K), U2.1 (IN), U3.2 (VIN); also elsewhere on the board
12V0RAW: C3.1, F1.1; also elsewhere on the board
FTDI_RESET: U4.3 (EN); also elsewhere on the board
GND: C3.2, C4.2, C5.2, C6.2, C7.2, C8.2, C9.2, C10.2, C11.2, C12.2, C14.2, C15.2, C56.2, D2.2, P1.4 (GND), P1.5 (shield), R5.1, U2.2 (GND), U3.3 (GND), U3.7 (GND), U4.2 (GND); also elsewhere on the board
unnamed: C7.1, C8.1, FB2.2, R4.1, U3.4 (VOUT), U3.5 (SENSE)
unnamed: C13.1, R4.2
unnamed: C13.2, R5.2, U3.6 (TRIM)
unnamed: D1.2 (A), D2.1, F1.2
unnamed: F2.2, P1.1 (VCC)
unnamed: P2.1, U3.10 (PG)
PD0: U3.1 (~EN); also elsewhere on the board

Notes on the sheet:
Vehicle Power Input Filtering and Spike Suppression
5V @ 1.5A DC-DC Power Supply
3.3V @ 1.5A DC-DC Power Supply
4.1V @ 2A DC-DC Power Supply

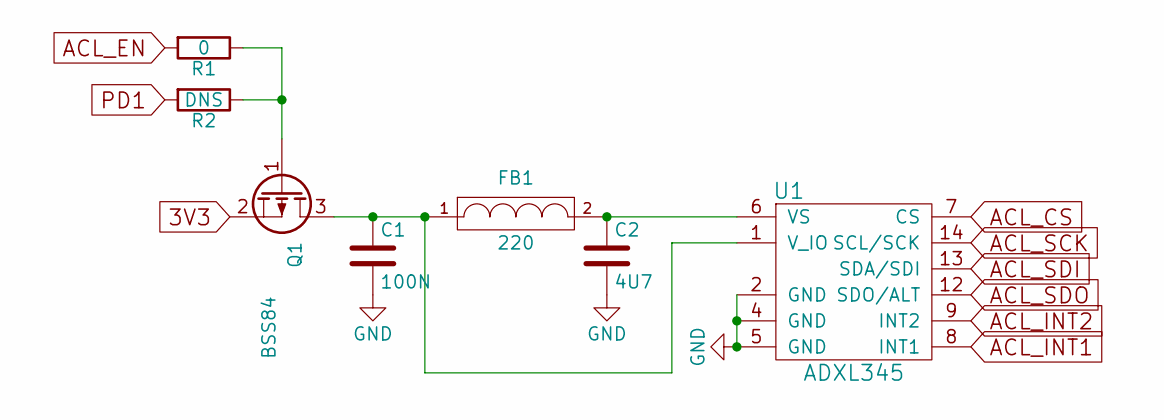
[picture p80: schematic OBD2_SMS_ACCEL.sch, OBD2-SMS - Open source RVI over SMS daughter card]

Parts:
C1: 100N; C_0603
C2: 4U7; C_0603
FB1: 220; C_0805
Q1: BSS84; SOT-23
R1: 0; R_0603
R2: DNS; R_0603
U1: ADXL345; LGA-14_5x3mm

Connections:
3V3: Q1.2 (S); also elsewhere on the board
ACL_CS: U1.7 (CS); also elsewhere on the board
ACL_EN: R1.2; also elsewhere on the board
ACL_INT1: U1.8 (INT1); also elsewhere on the board
ACL_INT2: U1.9 (INT2); also elsewhere on the board
ACL_SCK: U1.14 (SCL/SCK); also elsewhere on the board
ACL_SDI: U1.13 (SDA/SDI); also elsewhere on the board
ACL_SDO: U1.12 (SDO/ALT); also elsewhere on the board
GND: C1.2, C2.2, U1.2 (GND), U1.4 (GND), U1.5 (GND); also elsewhere on the board
unnamed: C1.1, FB1.1, Q1.3 (D), U1.1 (V_IO)
unnamed: C2.1, FB1.2, U1.6 (VS)
unnamed: Q1.1 (G), R1.1, R2.1
PD1: R2.2; also elsewhere on the board

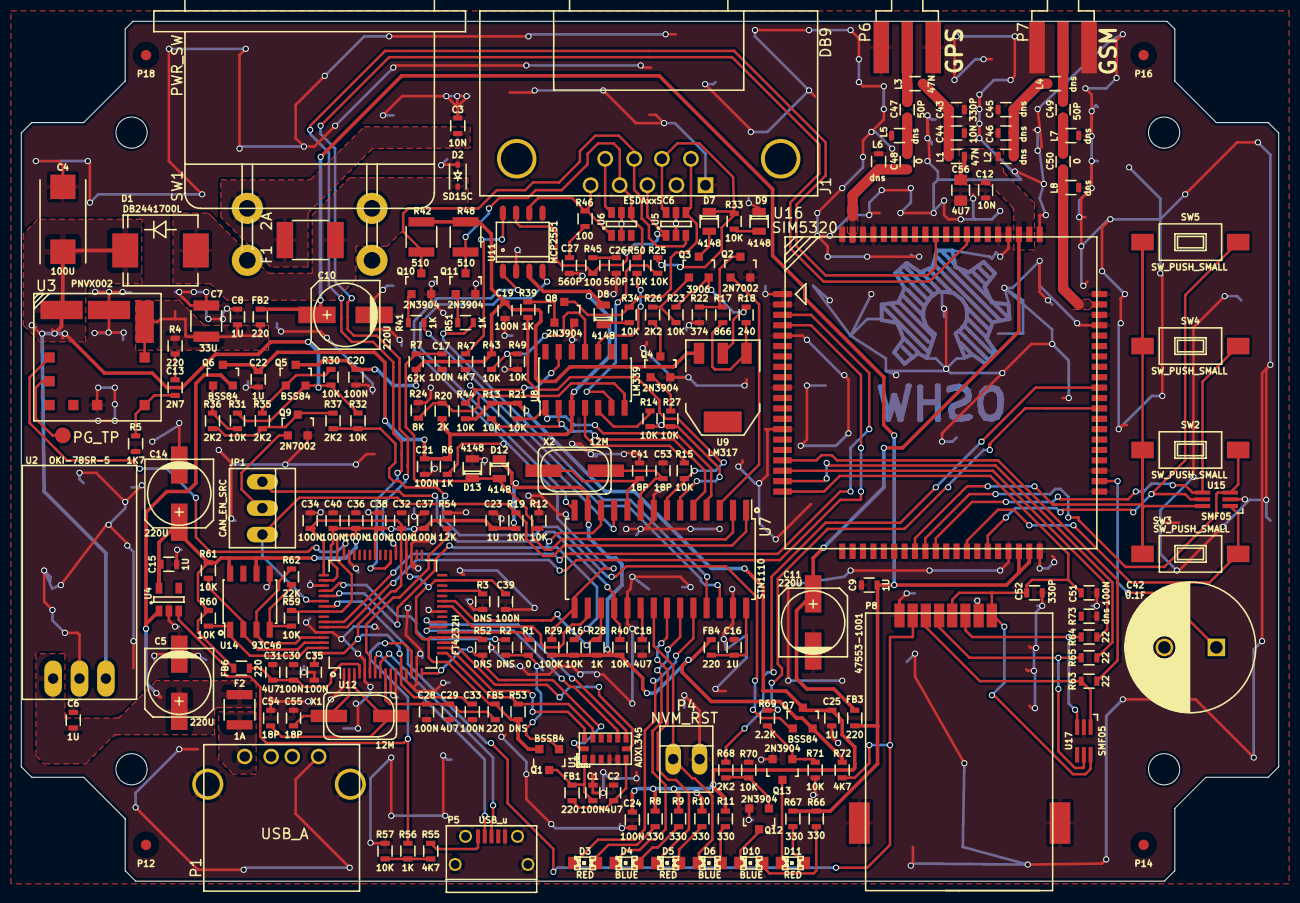
[picture p81: board OBD2_SMS.kicad_pcb from above]

Board: 2 copper layers, 121.0 x 82.8 mm, 209 parts (1 on the bottom side), 139 nets.
