jbanks2/rvi_v2x_board/Hardware/Make Files/Active/GSM/V2X_GSM - Copy.sch

## KiCad design Hardware/Make Files/Active/GSM/V2X_GSM - Copy.sch (2015-10-14)

Schematic: V2X_GSM - Copy.sch

Parts:
C14, C25: 100N; C_0603_SM
C15, C17, C19, C47: 330P; C_0603_SM
C16: 0.1F; C_Radial_D12.5_L25_P5; Mouser PN 504-KR-5R5C104-R
C18, C20, C27: 10N; C_0603_SM
C21, C22: 47p; C_0603_SM
C23, C26: 220U; c_elec_6.3x5.8
C24, C28, C46: 4U7; C_0805_SM
C48, C49: 10U; C_1206_SM
D13: SBR3U30P1-7; SOD-123
FB3: 220; R_0603_sm
L1, L2, L6, L7: 47N; C_0603_SM
L4: 5U6; 4.5x4.5mm_Ind
P1: 47553-1001
P2, P3: SMA; SMA-RA_142-0701-801
P18: CUR_SEN; PINHEAD1-2
P26: CONN_02X08; Pin_Header_Straight_2x10
Q12: IRF9335; SOIC-8_MOS
R8, R9, R84, R86: DNS; R_0603_sm
R12, R13, R14: 22; R_0603_sm
R63: 2K0; R_0603_sm
R64: 8K2; R_0603_sm
R85: 0; R_0603_sm
U3: MMQA5V6T3G; SOT-23-6
U4: SIM5320
U14: XRP6124; SOT-23-5
W2: GPS+GSM Antenna

Notes on the sheet:
SIM Card
GPS Antenna
GSM Antenna
Hopefully the PWRCTRL can momentarily use a pull up resistor to snense the card, otherwise resistors
SIM side
4.1V @ 1.5A DC-DC Power Supply
