jbanks2/rvi_v2x_board/Firmware/JLR_LED/src/v2x.h

/*
 * v2x.h
 *
 * Created: 10/15/2015 2:58:25 PM
 *  Author: Kevin
 */ 


#ifndef V2X_H_
#define V2X_H_

//power sequencing routines
#include "V2X/Power Sequence/sequence.h"
#include "V2X/Real Time Clock/vrtc.h"



#endif /* V2X_H_ */
