jbanks2/rvi_v2x_board/(commit log)

2015-09-03 Initial Commit
    Adding project dev files
    [BOM.xlsx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]
2015-09-14 Folder restructuring
    Aligned with CBFW folder structures
    [OBD2_SMS-B_Cu.gbl, OBD2_SMS-B_Mask.gbs, OBD2_SMS-B_SilkS.gbo, OBD2_SMS-Edge_Cuts.gm1, OBD2_SMS-F_Cu.gtl, OBD2_SMS-F_Mask.gts, OBD2_SMS-F_SilkS.gto, OBD2_SMS.drl]
2015-09-15 Some changes for V1.1
    Making a backup point, I am planning to rename all the files to
    V2X_xx.xx
    [OBD2_SMS.sch, OBD2_SMS_ACCEL.sch, OBD2_SMS_FTDI.sch, OBD2_SMS_GPRS.sch, OBD2_SMS_Hub.sch, OBD2_SMS_OBD2.sch, OBD2_SMS_PWR.sch, V2X_CTRL.sch]
2015-09-15 Names changed to V2X
    [OBD2_SMS.kicad_pcb, OBD2_SMS.sch, OBD2_SMS_ACCEL.sch, OBD2_SMS_FTDI.sch, OBD2_SMS_GPRS.sch, OBD2_SMS_Hub.sch, OBD2_SMS_OBD2.sch, OBD2_SMS_PWR.sch]
2015-09-23 Saving V1.1 as archive.
    We are trying a new architecture where the FTDI can be removed. making a
    backup spot
    [OBD2_SMS.kicad_pcb, OBD2_SMS.sch, OBD2_SMS_ACCEL.sch, OBD2_SMS_FTDI.sch, OBD2_SMS_GPRS.sch, OBD2_SMS_Hub.sch, OBD2_SMS_OBD2.sch, OBD2_SMS_PWR.sch]
2015-09-24 V1.2 mostly done
    BOM is integrated and creates mouser orders
    [V2X.sch, V2X_ACCEL.sch, V2X_CTRL.sch, V2X_FTDI.sch, V2X_GSM.sch, V2X_HUB.sch, V2X_OBD.sch, V2X_PWR.sch]
2015-09-28 V2X v1.2 sch and bom
    Made changes to the schematic to V1.2 (remove FTDI possibly) and
    integrade the BOM information into the sch
    [V2X_ACCEL.sch, V2X_CTRL.sch, V2X_FTDI.sch, V2X_GSM.sch, V2X_HUB.sch, V2X_OBD.sch, V2X_PWR.sch]
2015-10-02 Split V2X in 2 boards, layout of SIM pcb done
    [V2X.kicad_pcb, V2X.sch, V2X_ACCEL.sch, V2X_CTRL.sch, V2X_FTDI.sch, V2X_GSM.sch, V2X_HUB.sch, V2X_OBD.sch]
2015-10-07 Build pass of main V2X board
    ready to verify
    [V2X-B_Cu.gbl, V2X-B_Mask.gbs, V2X-B_SilkS.gbo, V2X-Edge_Cuts.gm1, V2X-F_Cu.gtl, V2X-F_Mask.gts, V2X-F_SilkS.gto, V2X-NPTH.drl]
2015-10-08 V1.2 pass complete and ready to order
    [V2X-B_Cu.gbl, V2X-B_Mask.gbs, V2X-B_SilkS.gbo, V2X-Edge_Cuts.gm1, V2X-F_Cu.gtl, V2X-F_Mask.gts, V2X-F_SilkS.gto, V2X-NPTH.drl]
2015-10-08 Folder cleanup
    [V2X_SEQ.kicad_pcb]
2015-10-14 Project rework
    Split the Main and GSM boards into separate projects, redesigned Main
    board after flaws were found.
    [V2X-B_Cu.gbl, V2X-B_Mask.gbs, V2X-B_SilkS.gbo, V2X-Edge_Cuts.gm1, V2X-F_Cu.gtl, V2X-F_Mask.gts, V2X-F_SilkS.gto, V2X.drl]
2015-10-16 Added USB-A to design
    discovered the Rpi cannot be back fed over USB, had to add a power Port
    [V2X.kicad_pcb, V2X.sch, V2X_ACCEL.sch, V2X_CTRL.sch, V2X_FTDI.sch, V2X_GSM.sch, V2X_HUB.sch, V2X_OBD.sch]
2015-10-20 No Rpi Backpower fix
    added a USB-A to the board to power the HOST. fixed LED labeling.
    [V2X-B_Cu.gbl, V2X-B_Mask.gbs, V2X-B_SilkS.gbo, V2X-Edge_Cuts.gm1, V2X-F_Cu.gtl, V2X-F_Mask.gts, V2X-F_SilkS.gto, V2X.drl]
2015-10-21 work from home day
    [V2X.sch, V2X_ACCEL.sch, V2X_CTRL.sch, V2X_GSM.sch, V2X_HUB.sch, V2X_PWR.sch, _saved_V2X_CTRL.sch, _saved_V2X_FTDI.sch]
2015-10-21 home to work push
    [V2X_ACCEL.sch, V2X_CTRL.sch, V2X_FTDI.sch, V2X_GSM.sch, V2X_HUB.sch, V2X_OBD.sch, V2X_PWR.sch, _saved_V2X_CTRL.sch]
2015-10-22 Verification findings and modifications
    [V2X-B_Cu.gbl, V2X-B_Mask.gbs, V2X-B_SilkS.gbo, V2X-Edge_Cuts.gm1, V2X-F_Cu.gtl, V2X-F_Mask.gts, V2X-F_SilkS.gto, V2X.drl]
2015-10-22 V2X V1.2 PCB build, with shares
    [V2X-B_Cu.gbl, V2X-B_Mask.gbs, V2X-B_SilkS.gbo, V2X-Edge_Cuts.gm1, V2X-F_Cu.gtl, V2X-F_Mask.gts, V2X-F_SilkS.gto, V2X.drl]
2015-10-23 BOM updates
    [V2X_ACCEL.sch, V2X_CTRL.sch, V2X_FTDI.sch, V2X_GSM.sch, V2X_HUB.sch, V2X_OBD.sch, V2X_PWR.sch]
2015-10-26 Packaged to order
    [V2X-B_Cu.gbl, V2X-B_Mask.gbs, V2X-B_SilkS.gbo, V2X-Edge_Cuts.gm1, V2X-F_Cu.gtl, V2X-F_Mask.gts, V2X-F_SilkS.gto, V2X.drl]
2015-11-03 V1.2 Ordered
    This is a capture of the project folder at the time f ordering the V1.2
    kit.
    [V2X-B_Cu.gbl, V2X-B_Mask.gbs, V2X-B_SilkS.gbo, V2X-Edge_Cuts.gm1, V2X-F_Cu.gtl, V2X-F_Mask.gts, V2X-F_SilkS.gto, V2X.drl]
2015-11-03 Folder cleanup for next rev
    [OBD2_SMS.kicad_pcb, OBD2_SMS.sch, OBD2_SMS_ACCEL.sch, OBD2_SMS_FTDI.sch, OBD2_SMS_GPRS.sch, OBD2_SMS_OBD2.sch, OBD2_SMS_PWR.sch, V1 BOM.xlsx]
2015-11-13 Added learnings from V1.2 build
    [V2X_CTRL.sch, V2X_GSM.sch, V2X_HUB.sch, V2X_PWR.sch]
2015-11-20 got bring-up firmware running
    chip inits and clears the shift register
    [V2X_PWR.sch]
2015-11-24 functioning build
    board inits and stays on
    USB connects to hub, SIM and FTDI.
    SIM network and power are forwarded to LEDs.
    SIMCARD state is shown on PWR LED
    Charge pump runs for LED's
    FTDI has Rx/Tx path to CAN
2015-11-24 Added Button detection
    created and tested
    bool buttonStatus()
2015-11-25 created buffer and LED macros
2015-12-17 V2X Build learnings
    [V2X_CTRL.sch, V2X_GSM.sch, V2X_OBD.sch, V2X_PWR.sch]
2015-12-23 GSM board update
    new FPC connector, sim5320 moved towards rf connectors
    [V2X_GSM.kicad_pcb, _saved_V2X_GSM.sch]
2015-12-23 part of GSM board update
    unsaved files
    [V2X_GSM.sch, _saved_V2X_GSM.sch]
2015-12-23 small changes to GSM layout
    [V2X_GSM.kicad_pcb]
2016-01-29 53534 New design verified
    [V2X-B_Cu.gbl, V2X-B_Mask.gbs, V2X-B_SilkS.gbo, V2X-Edge_Cuts.gm1, V2X-F_Cu.gtl, V2X-F_Mask.gts, V2X-F_SilkS.gto, V2X.drl]
2016-10-20 seems old...
    [V2X.kicad_pcb]
